traibertr/LTEWatch/1_Document/2_Report/9_annexes.tex

\documentclass[Report.tex]{subfiles}

\begin{document}

\chapter{Appendix}

%\includepdf[pages=-]{Include/Annexe/Technical data-T901A-T-2946a-26.10.2022.pdf}

\section{\textit{LTEWatch} Electrical Schematic}
\begin{landscape}
\includepdf[pages=-, angle=90]{Include/Annexe/LTEWatch.pdf}
\label{appendix:LTEWatch_elec_schem}
\end{landscape}

\section{Clock Single Hand Motor - T901}
\begin{landscape}
\includepdf[pages=-, angle=180]{Include/Annexe/Technical data-T901A-T-2946a-26.10.2022.pdf}
\label{appendix:motor_t901}
\end{landscape}

\section{Clock Double Hands Motor - T902}
\begin{landscape}
\includepdf[pages=-, angle=180]{Include/Annexe/Technical data-T902A-T-2947b-26.10.2022.pdf}
\label{appendix:motor_t902}
\end{landscape}

\section{\textsc{Ignion} - NN03-320 Chip GNSS Antenna Simulation} \label{appendix:LTEWatch_NNS1}
\includepdf[pages=-]{Include/Annexe/LTEWatch_NNS1.0.pdf}

\end{document}
