traibertr/LTEWatch/1_Document/2_Report/Abstract.tex

\documentclass[report.tex]{subfiles}

\begin{document}

\section{Project introduction}

\subsection{Context}

\subsection{Project goals}

\subsection{Current issues and problems to solve}

\end{document}
