traibertr/LTEWatch/2_Hardware/1_Altium/LTEWatch/LTEWatch.PcbDoc.htm

Reporting Options

# File in Previous Format

Date | : | 21.11.2022
Time | : | 10:33:42
Filename | : | I:\RaD\SI-ET\Projets\ECS\LTEWatch\Analog-LTE-M_NB-IoT-Watch\Hardware\Altium\LTEWatch\LTEWatch.PcbDoc

Version | Warning

This file was generated by an earlier version of the software
