traibertr/LTEWatch/1_Document/2_Report/Include/Figure/hardware/user_interface_blk.pdf

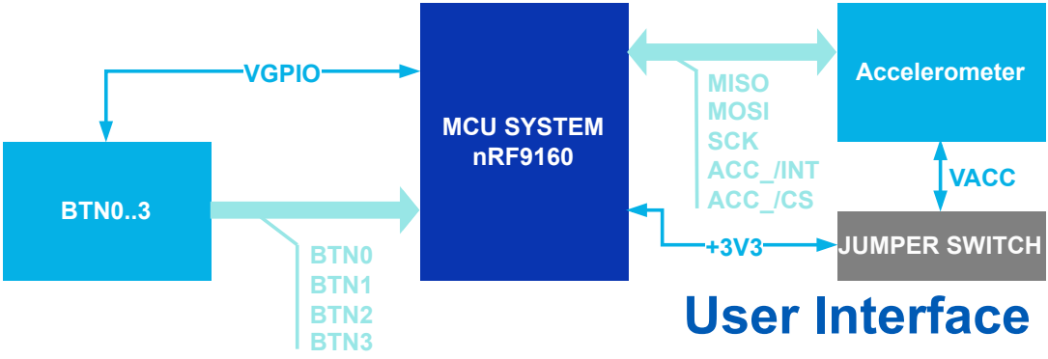
[picture p126: figure]
User Interface; VGPIO; BTN0..3; MCU SYSTEM nRF9160; BTN0 BTN1 BTN2 BTN3; Accelerometer MISO; MOSI SCK ACC_/INT ACC_/CS; VACC; JUMPER SWITCH
