traibertr/LTEWatch/1_Document/2_Report/Include/Figure/software/software_layers.pdf

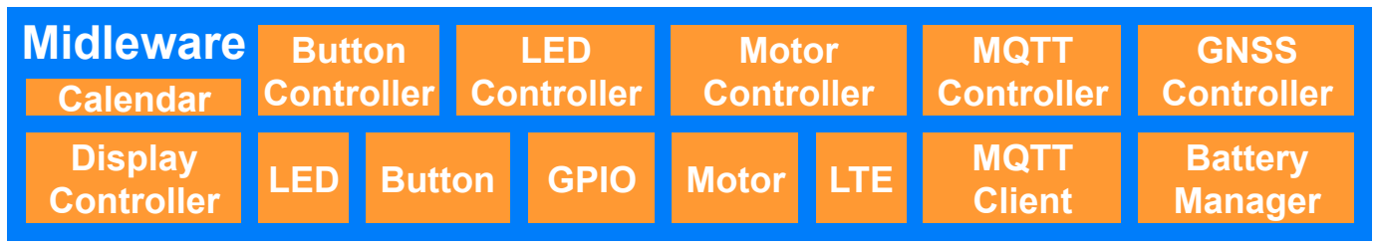
[picture p127: figure]
Midleware; Motor; Calendar; Controller; MQTT Client; Button Controller; Display Controller; GNSS Controller; LED Controller; MQTT Controller; LTE; Battery; Manager; LED; Button; GPIO
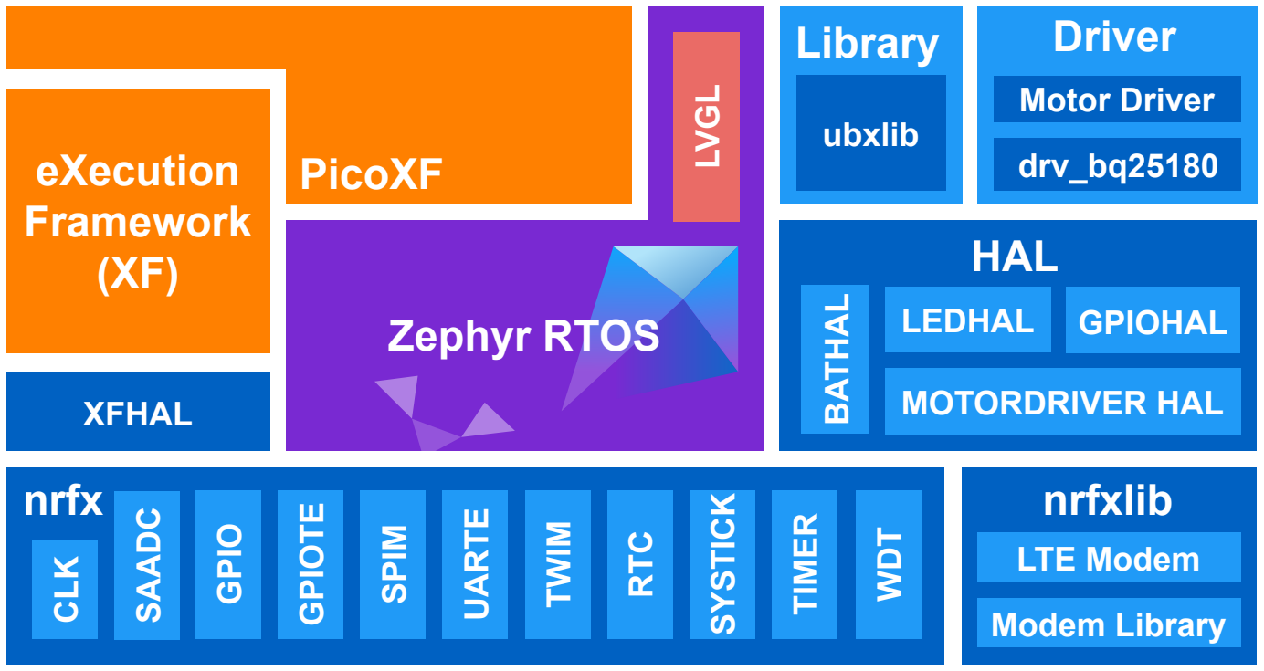
[picture p128: figure]
Zephyr RTOS; LVGL; nrfx; nrfxlib GPIO; GPIOTE; RTC; TIMER; WDT; SYSTICK; SPIM; UARTE; TWIM; Modem Library; LTE Modem; Library; Driver; drv_bq25180; ubxlib; HAL; BATHAL; LEDHAL; GPIOHAL; MOTORDRIVER HAL XFHAL; eXecution Framework (XF); Motor Driver; CLK; SAADC; PicoXF

## nRF9160

## Application

PicoWatch
Factrory

AppFactory
