traibertr/LTEWatch/1_Document/2_Report/Include/Figure/uml/caf_overview.pdf

Other NCS components

User modules and events

Events

CAF modules and events

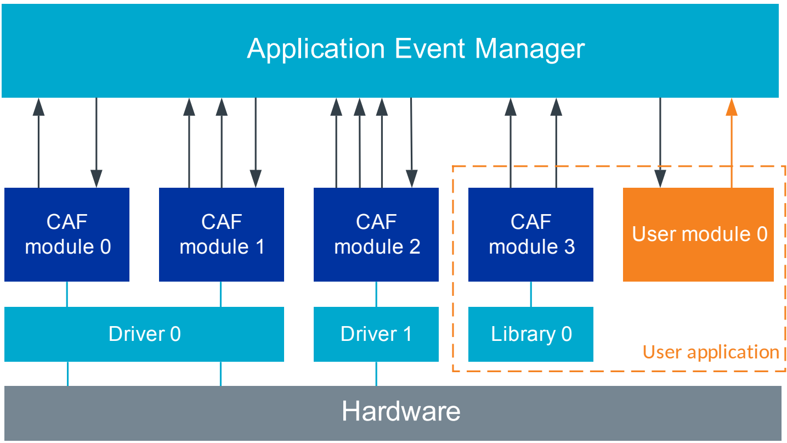
[picture p129: figure]
Application Event Manager; CAF module 0; CAF module 1; CAF; module 2; User module 0; Driver 0; Driver 1; Hardware; CAF module 3; User application Library 0
