traibertr/LTEWatch/1_Document/2_Report/Include/Figure/uml/class_Factory.pdf

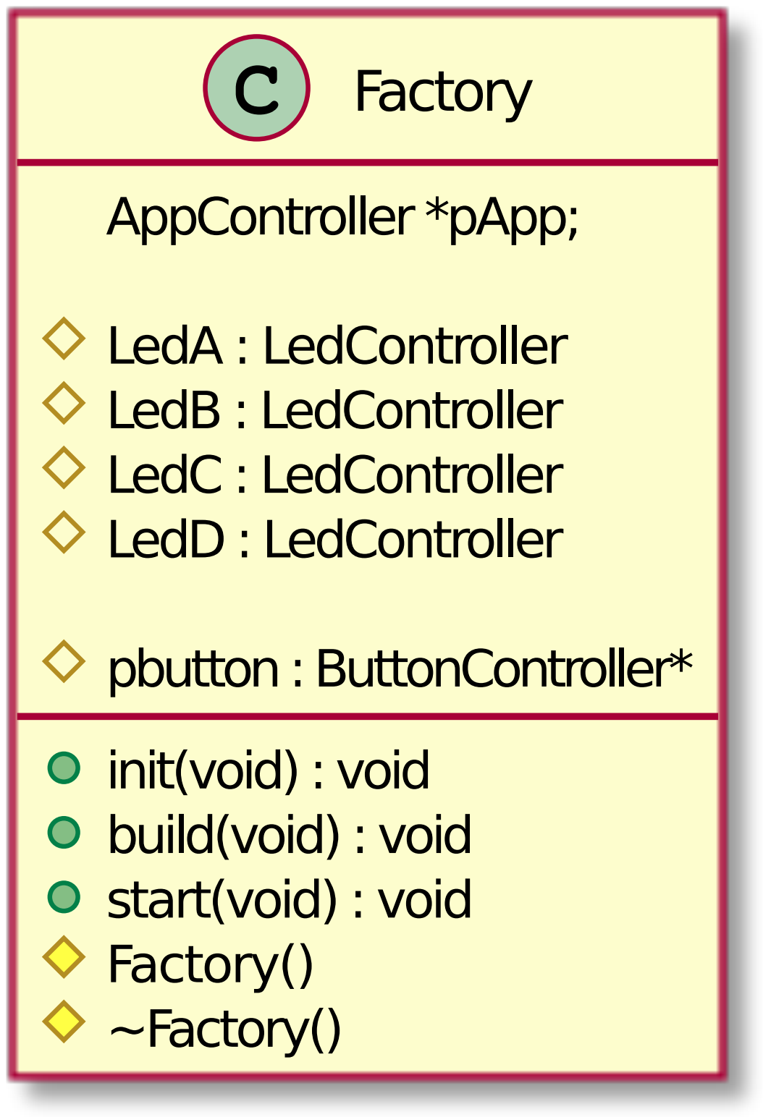
[picture p131: page 1]

Factory

AppController *pApp;

LedA : LedController
LedB : LedController
LedC : LedController
LedD : LedController

pbutton : ButtonController* init(void) : void
build(void) : void
start(void) : void
Factory()
~Factory()
