traibertr/LTEWatch/1_Document/2_Report/Include/Figure/uml/class_LedHal.pdf

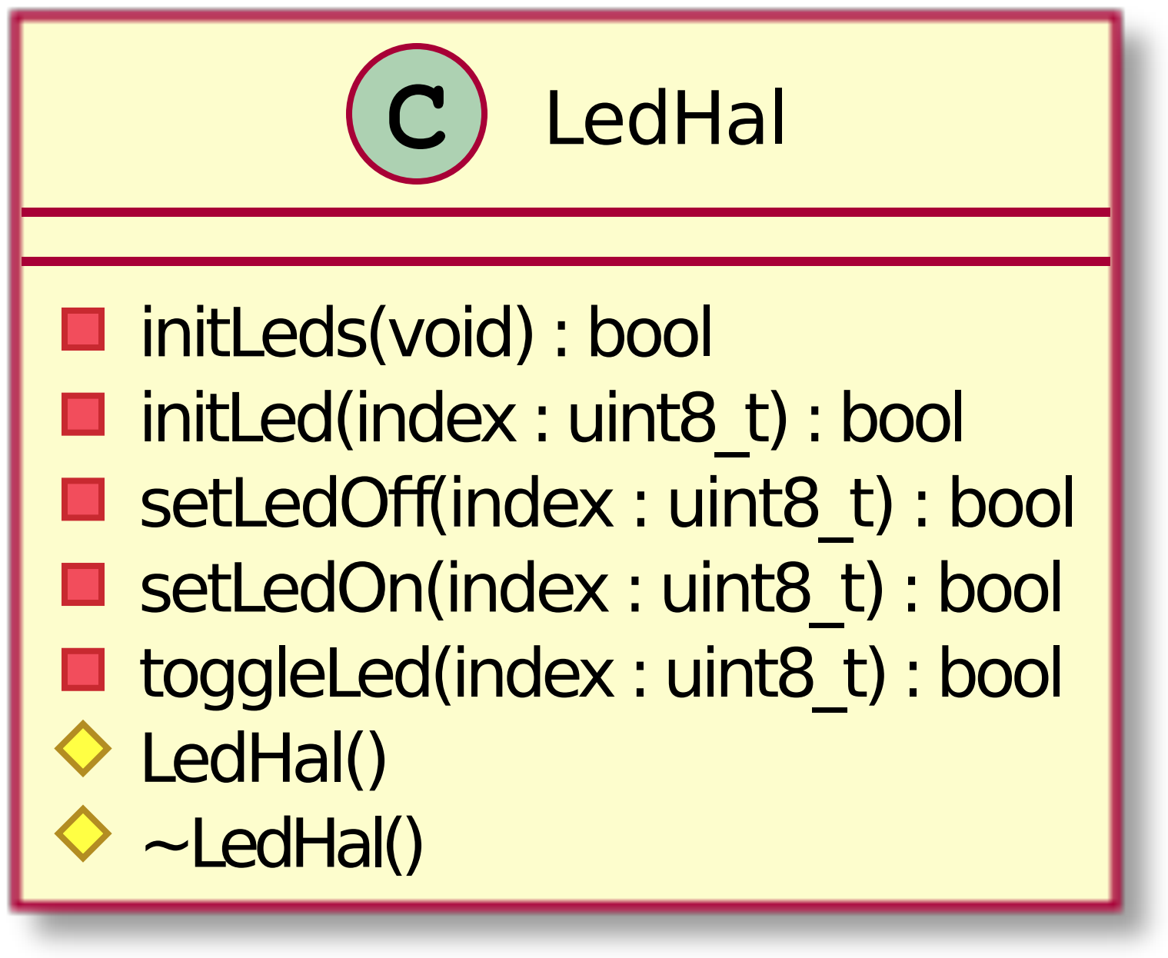
[picture p132: page 1]

LedHal

initLeds(void) : bool
initLed(index : uint8_t) : bool setLedOff(index : uint8_t) : bool setLedOn(index : uint8_t) : bool toggleLed(index : uint8_t) : bool LedHal()
~LedHal()
