traibertr/LTEWatch/1_Document/2_Report/Report.tex

%%%%%%%%%%%%%%%%%%%%%%%%%%%%%%%%%%%%%%%%%%%%%%%%%%%%%%%%%%
%% HEIG-VD
%%
%% Modèle Latex pour laboratoire
%% 
%% Fichiers à changer : 
%%            - constantes.tex
%%            - Tous les fichiers du corps du rapport 
%%
%% Auteur : TTR
%% Date   : 24.03.2020
%%%%%%%%%%%%%%%%%%%%%%%%%%%%%%%%%%%%%%%%%%%%%%%%%%%%%%%%%%

% Paramétrage du papier utilisé
\documentclass[a4paper,12pt,oneside]{report}

% Ne pas toucher, nécessaire à la mise en forme
\usepackage[utf8x]{inputenc} 
\usepackage[T1]{fontenc} 		% Nouvelle norme pour codage des caractères
\usepackage{titlesec, blindtext, color}
\newcommand{\hsp}{\hspace{20pt}}
\titleformat{\chapter}[hang]{\Huge\bfseries}{\thechapter \hsp}{0pt}{\Huge\bfseries}
\titlespacing*{\chapter}{0pt}{-10pt}{\baselineskip}% see titlesec manual
\usepackage{lmodern} 			% Nouvelle forme de la fonte ComputerModern
\usepackage[english,french]{babel} 		% Règles typographiques françaises, césures
\frenchbsetup{GlobalLayoutFrench=false}
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
	basicstyle=\footnotesize\ttfamily\color{black},
	commentstyle=\color{mygreen},
	keywordstyle=\color{blue},
    numberstyle=\tiny\color{gray},
    stringstyle=\color{purple},
    breakatwhitespace=false,         
    breaklines=true,                 
    captionpos=b,                    
    keepspaces=true,                 
    numbers=left,                    
    numbersep=5pt,                  
    showspaces=false,                
    showstringspaces=false,
    showtabs=false,                  
    tabsize=2,
    language=bash,
    xleftmargin=\parindent,
}
%\lstset{language=Bash,keywordstyle={\bfseries \color{black}}}
%\NewDocumentCommand{\codeword}{v}{\texttt{\colorbox{lightgray}{\textcolor{black}{#1}}}}

\NewDocumentCommand{\codeword}{v}{\textcolor{blue}{#1}}

%-------------------------------------------------------------------------------------

\newcommand{\codetxt}[1]{\textcolor{blue}{\texttt{\path{#1}}}}

%-------------------------------------------------------------------------------------

\newcommand{\eme}{\ieme{ }}
\newcommand{\er}{\ier{ }}
\newcommand{\ere}{\iere{ }}

\usepackage{float,graphicx}

\newcommand{\blue}[1]{\textcolor{blue}{#1}}

%Figure
\newcommand{\figc}[3]{%
  \begin{figure}[H]
    \centering
    
    \caption{#3}
    \label{fig:#2}
  \end{figure}}
  
  \newcommand{\figpdf}[3]{%
  \begin{figure}[H]
    \centering
    
    \caption{#3}
    \label{fig:#2}
  \end{figure}}

\newcommand{\figl}[4]{
\begin{table}[H]
\begin{tabularx}{\textwidth}{l X}
    \centered{} & \begin{tabular}{#3}#4\end{tabular}
\end{tabularx}
\end{table}}

\newcommand{\figr}[4]{
\begin{table}[H]
\begin{tabularx}{\textwidth}{X r}
	\begin{tabular}{#3} #4 \end{tabular} & \centered{}
\end{tabularx}
\end{table}}

\newcommand{\figcjpg}[3]{%
  \begin{figure}[H]
    \centering
    
    \caption{#3}
    \label{fig:#2}
  \end{figure}}
  
\newcommand{\figljpg}[4]{
\begin{table}[H]
\begin{tabularx}{\textwidth}{l X}
    \centered{} & \begin{tabular}{#3}#4\end{tabular}
\end{tabularx}
\end{table}}
  
\newcommand{\figrjpg}[4]{
\begin{table}[H]
\begin{tabularx}{\textwidth}{X r}
	\begin{tabular}{#3} #4 \end{tabular} & \centered{}
\end{tabularx}
\end{table}}

\newcommand{\centered}[1]{\begin{tabular}{l} #1 \end{tabular}}

\newcommand{\tbox}[1]{
\begin{tabular}{|c|}
\hline #1 \\[4pt]\hline
\end{tabular}}

\newcommand{\ii}[1]{%
\begin{itemize}[\;]%
\item #1%
\end{itemize}}

%TO DO
\newcommand{\todo}[1]{\begin{center}
\colorbox{orange!50}{\Large #1}
\end{center}}

\newcommand{\listequationsname}{\Large{Liste des équations}}
\newlistof{myequations}{equ}{\listequationsname}
\newcommand{\myequations}[1]{%
\addcontentsline{equ}{myequations}{\protect\numberline{\theequation}#1}\par}

\newcommand{\ddl}[1]{\underline{\underline{#1}}}

% fichier avec les constantes (à adapter pour les étudiants)
\input{0_constantes}

% Entête et pieds de page (A ADAPTER)
\pagestyle{empty}
\usepackage{fancyhdr}
\setlength{\headheight}{25pt}
\pagestyle{fancy}
\renewcommand{\chaptermark}[1]{\markboth{#1}{#1}}

% Entête :
\fancypagestyle{plain}{}
\renewcommand\headrulewidth{1pt}
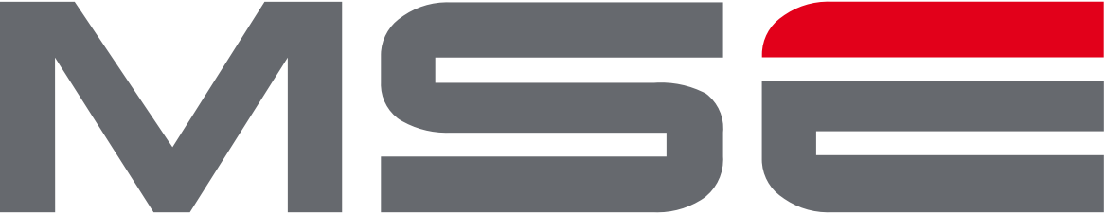
[picture p133: 1_Document/2_Report/Include/Figure/logo/mse-small-logo.png]
\fancyhead[L]{}
\fancyhead[R]{\textsc{\nomAuteur} \\ \begin{otherlanguage}{english} \today \end{otherlanguage}}
\fancyhead[C]{\nameLabo \\ \shortTitre}
% Pied de page
\fancyfoot{} % clear all footer fields
\renewcommand{\footrulewidth}{1pt}
\fancyfoot[R]{\thepage} 
\fancyfoot[L]{\textsc{\leftmark}}

\newcommand{\specialcell}[2][l]{%
  \begin{tabular}[#1]{@{}l@{}}#2\end{tabular}}

% Début du corps du rapport 
\begin{document}	

	\pagenumbering{Roman}
	
	% première page
	\input{1_premiere_page.tex}
	% enlève le numéro sur la première page
	\newpage
	
	\subfile{2_lexic.tex}

	\newpage

	\begin{otherlanguage}{english}
		\chapter*{Table of Contents}
		\addcontentsline{toc}{chapter}{Table of Contents}
		\renewcommand\contentsname{} % the empty name
		\begingroup
			\let\clearpage\relax
			\vspace{-3.5cm} % the removed space. Set as appropriate
			\tableofcontents
		\endgroup
	\end{otherlanguage}

	\newpage	

	\pagenumbering{arabic}
	\setcounter{page}{1}
	
	\subfile{3_introduction.tex}
		
	\newpage
	
	\subfile{4_research_part.tex}
	
	\newpage
	
	\subfile{4_b_solution_part.tex}
	
	\newpage	
	
	\subfile{4_1_hardware_part.tex}

	\newpage
	
	\subfile{4_2_antenna_part.tex}	
		
	\newpage
	
	\subfile{4_3_software_part.tex}	

	\newpage	
	
	\subfile{5_experimental_part.tex}
	
%	\newpage
	
%	\subfile{6_result.tex}
	
	\newpage
	
	\subfile{7_discussion.tex}
	
	\newpage
	
	\subfile{8_conclusion.tex}
	
	%\newpage 
	
	%\subfile{report_struct.tex}
	
	%Section pour la signature
	\section*{Signatures}
  	\;\\[-20pt]
    %\vspace{2cm}
    
    \tabto{8cm}Lausanne, \today\\
    \tabto{8cm}Tristan Traiber \\
    
    \begin{flushright}
    \begin{figure}[H]
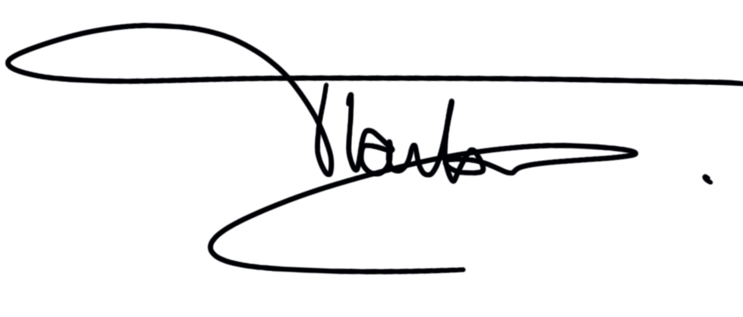
[picture p134: 1_Document/2_Report/Include/Figure/logo/SignatureTR.PNG]
       \tabto{8cm} 
    \end{figure}
    \end{flushright}

\begin{otherlanguage}{english}
	\bibliographystyle{unsrt}
	\bibliography{bibliographie.bib}
\end{otherlanguage}

\begin{otherlanguage}{english}
	\listoffigures
	\listoftables
\end{otherlanguage}    

	\newpage
	\subfile{9_annexes}
	
	\newpage
	%\input{__Exemple_include}
	
%Fin du document
\end{document}
