traibertr/LTEWatch/1_Document/2_Report/1_premiere_page.tex

%%%%%%%%%%%%%%%%%%%%%%%%%%%%%%%%%%%%%%%%%%%%%%%%%%%%%%%%
% Ce document ne doit pas être modifié
% Il faut modifier les informations depuis le fichier
% constantes.tex
%%%%%%%%%%%%%%%%%%%%%%%%%%%%%%%%%%%%%%%%%%%%%%%%%%%%%%%%

\begin{center}

\hfill

\end{center}

\vfill

\begin{flushleft}
	\small \addr
\end{flushleft}

\vfill

\begin{center}
	\huge \bigTitre \\
	\Large \subBigTitre \\
\end{center}

\vfill

\begin{center}
	\Large \nameLabo:\\
	\huge \titre \\
\end{center}

\vfill

\vfill

\begin{flushright}
	\Large Made by\\
	\huge \nomAuteur\\
	
	\vfill
	
	\Large Under the direction of \\
	\normalsize Prof. \professeur\\
	HES-SO Valais/Wallis \\
	Rue de l'Industrie 23 \\
	1950 Sion \\
\end{flushright}
\vfill

\begin{flushright}
	%External expert -\\
\end{flushright}

\vfill

\begin{otherlanguage}{english}
\begin{flushright}
	Lausanne, HES-SO, Master MSE, \today
\end{flushright}
\end{otherlanguage}

	\thispagestyle{empty}

%%%%%%%%%%%%%%%%%%%%%%%%%%%%%%%%%%%%%%%%%%%%%%%%%%%%%%%%%%%%%%%%%%%%%%%%%%%%%%%

	\afterpage{\null\newpage}

%%%%%%%%%%%%%%%%%%%%%%%%%%%%%%%%%%%%%%%%%%%%%%%%%%%%%%%%%%%%%%%%%%%%%%%%%%%%%%%

\newpage

\begin{flushleft}
	Accepted by the HES SO Master MSE (Suisse, Lausanne) on the proposal of \\[12pt]
	Prof. \professeur, TM Project Advisor\\
	Ing. \assistant, Senior academic associate\\[48pt]
\end{flushleft}

\begin{otherlanguage}{english}
\begin{flushleft}
	Lausanne, \today \\[48pt]
\end{flushleft}
\end{otherlanguage}

\begin{flushleft}
	Prof. \professeur \hfill Prof. Philippe Barrade \\
	Project Adviser  \hfill Filliar manager \\
\end{flushleft}

%%%%%%%%%%%%%%%%%%%%%%%%%%%%%%%%%%%%%%%%%%%%%%%%%%%%%%%%%%%%%%%%%%%%%%%%%%%%%%%
