traibertr/LTEWatch/1_Document/2_Report/Include/Figure/software/state/picoWatchInternal.pdf

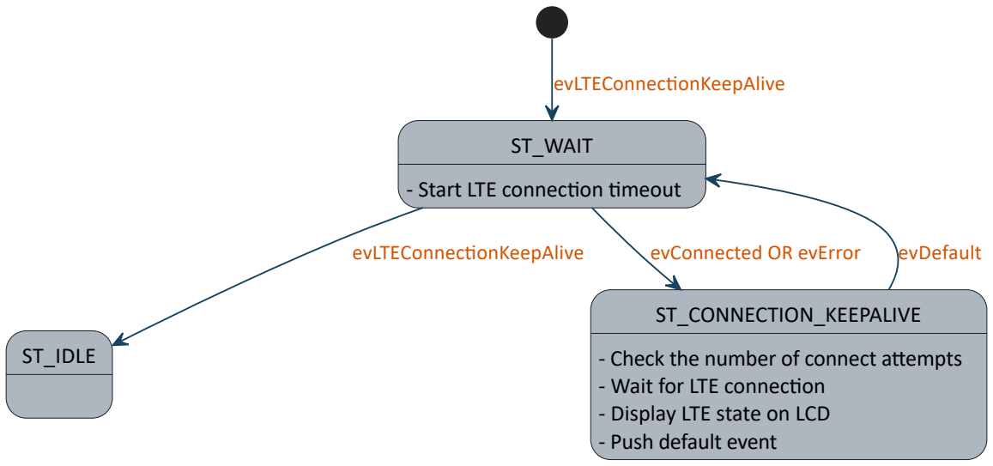
[picture p135: figure]
ST_IDLE; ST_WAIT; - Start LTE connecon meout; ST_CONNECTION_KEEPALIVE; - Check the number of connect aempts - Wait for LTE connecon - Display LTE state on LCD - Push default event; evLTEConneconKeepAlive; evConnected OR evError; evDefault
