traibertr/LTEWatch/1_Document/2_Report/Include/Figure/comp/bq25180_absolute_max_rating.png

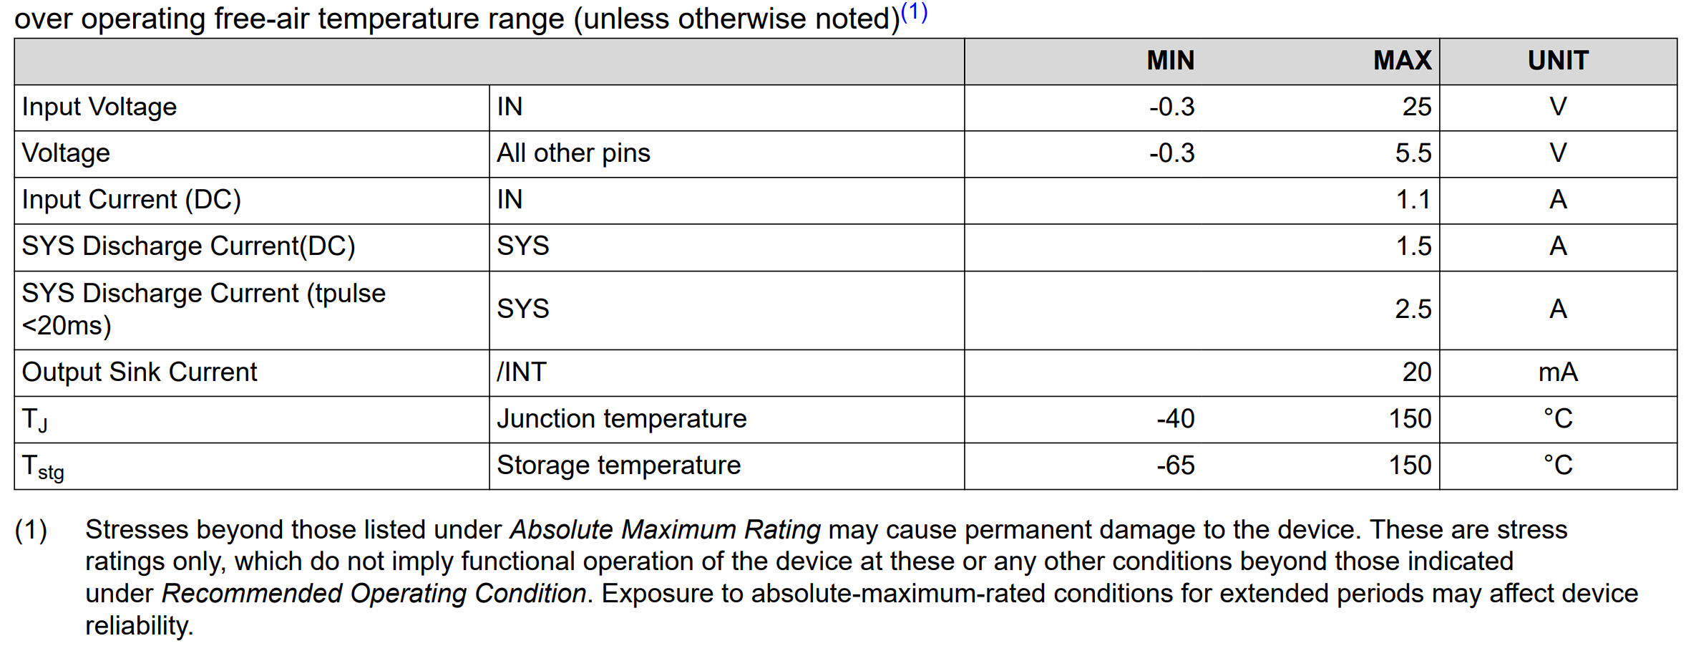
1_Document/2_Report/Include/Figure/comp/bq25180_absolute_max_rating.png
