traibertr/LTEWatch/1_Document/2_Report/Include/Figure/comp/bq25180_recom_oper_cond_1.png

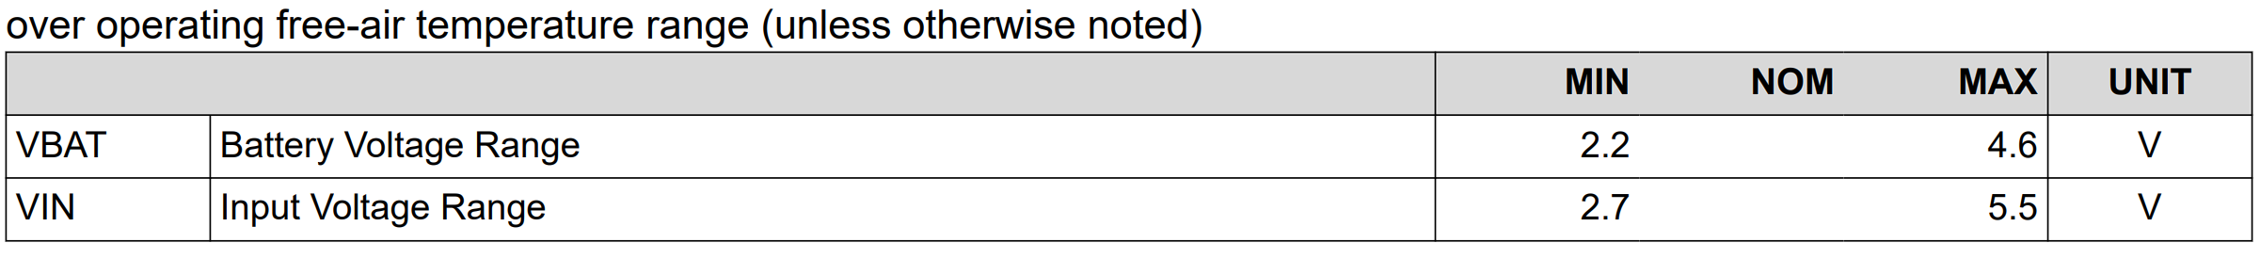
1_Document/2_Report/Include/Figure/comp/bq25180_recom_oper_cond_1.png
