traibertr/LTEWatch/1_Document/2_Report/Include/Figure/comp/LS011B7DH03_mech_schem.png

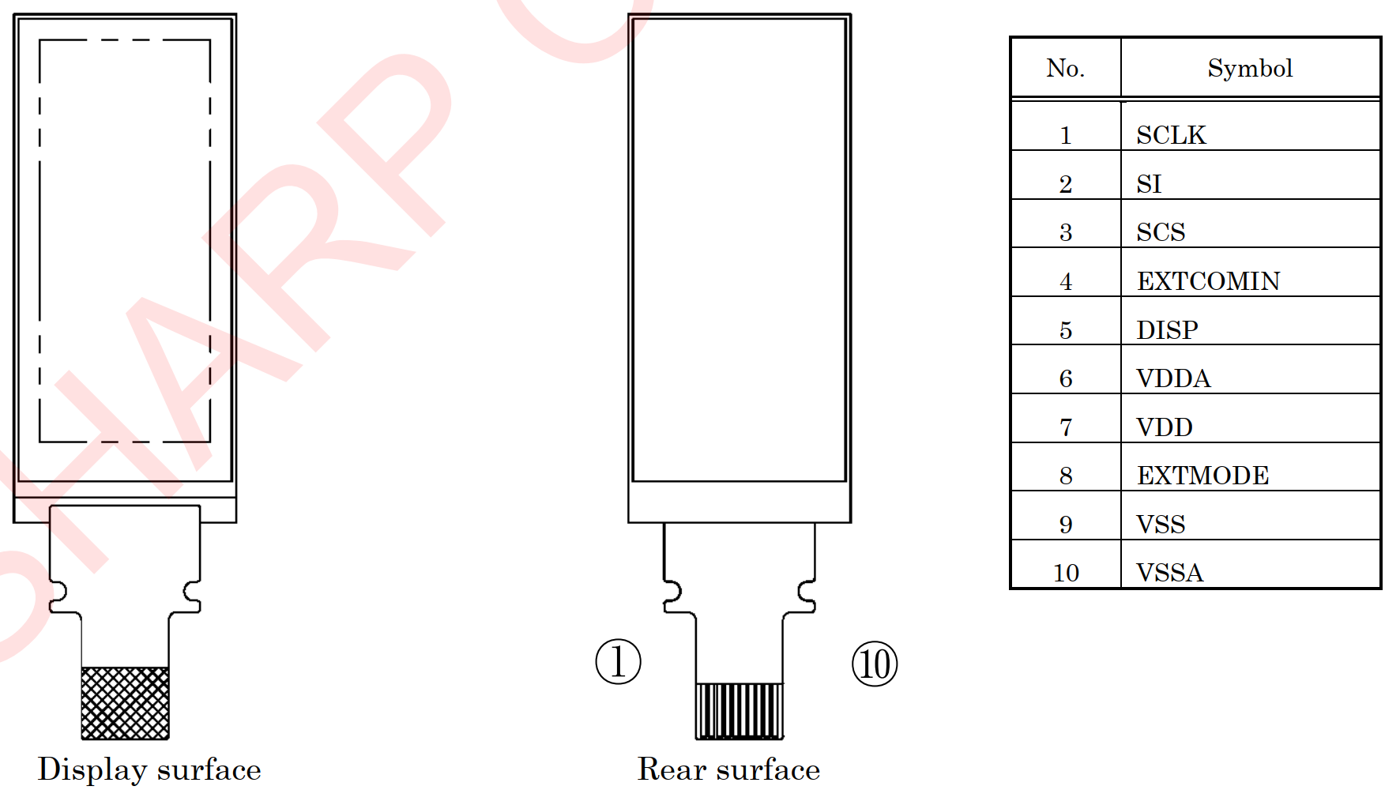
1_Document/2_Report/Include/Figure/comp/LS011B7DH03_mech_schem.png
