traibertr/LTEWatch/1_Document/2_Report/Include/Figure/comp/LS011B7DH03_mode_circ.png

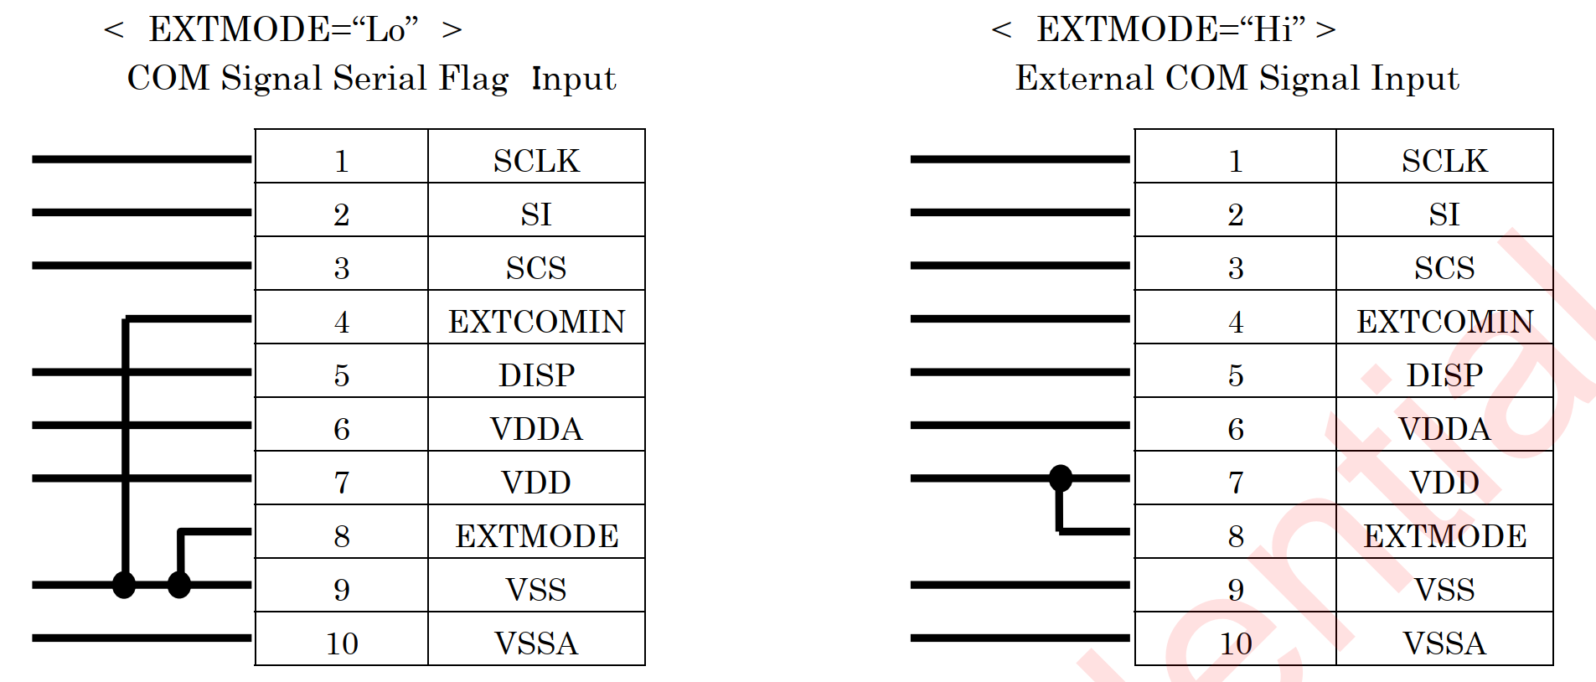
1_Document/2_Report/Include/Figure/comp/LS011B7DH03_mode_circ.png
