traibertr/LTEWatch/1_Document/2_Report/Include/Figure/comp/maxm10s_back_curr_uart_spec.png

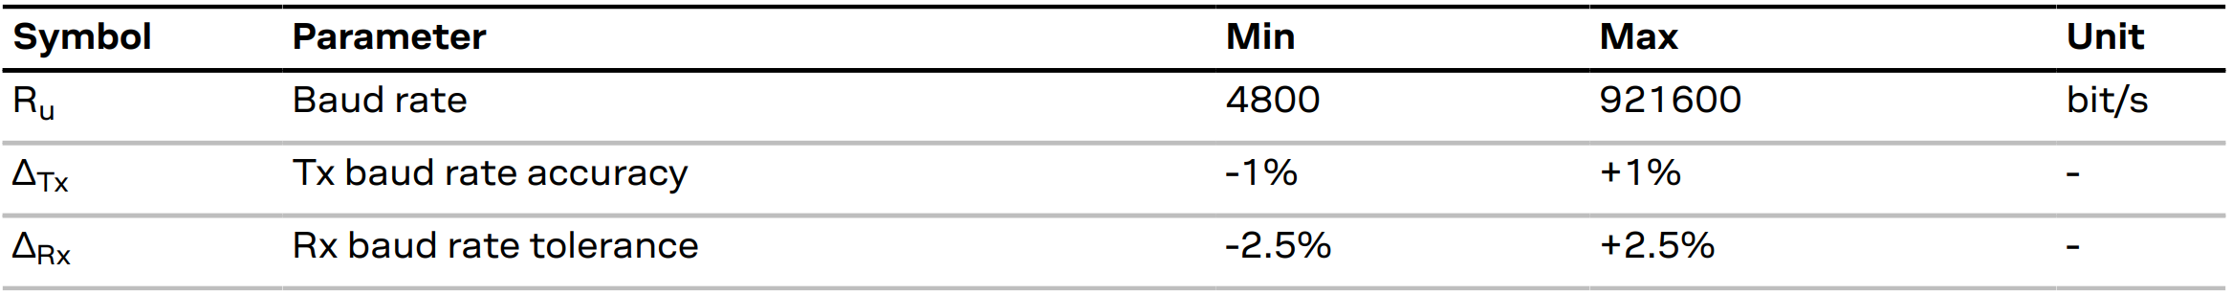
1_Document/2_Report/Include/Figure/comp/maxm10s_back_curr_uart_spec.png
