traibertr/LTEWatch/1_Document/2_Report/Include/Figure/comp/maxm10s_typ_perf_mulit_const.png

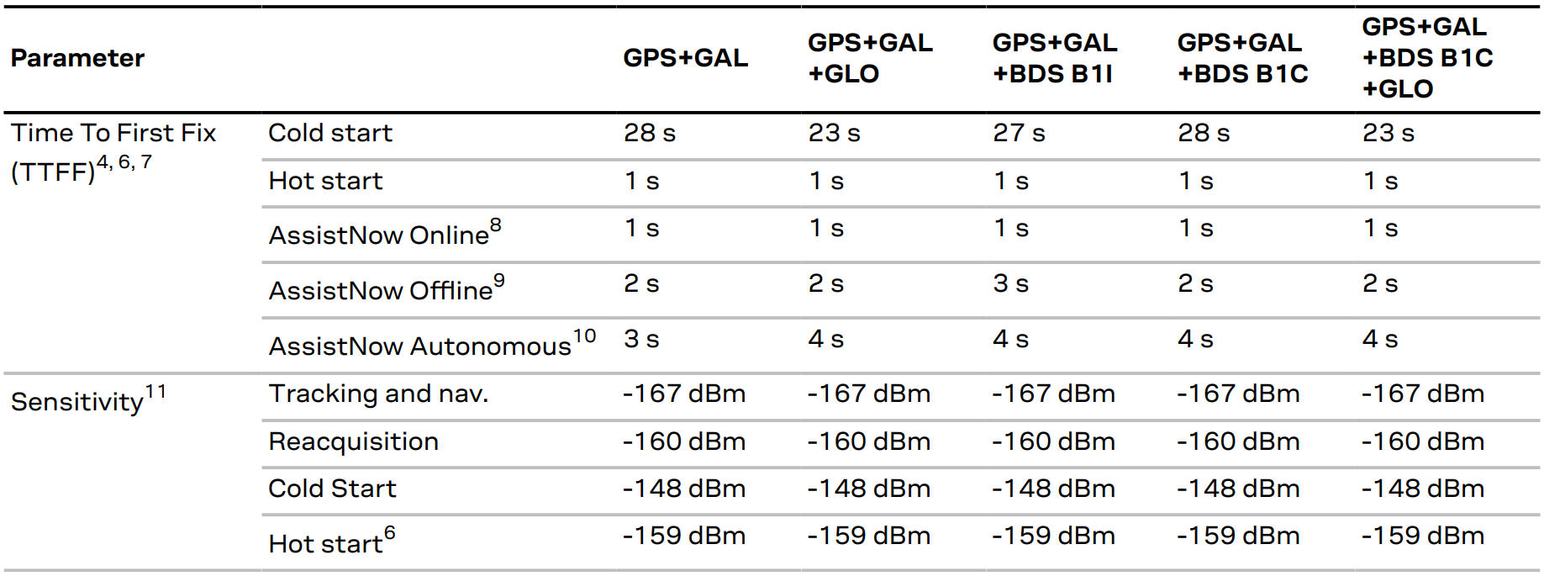
1_Document/2_Report/Include/Figure/comp/maxm10s_typ_perf_mulit_const.png
