traibertr/LTEWatch/1_Document/2_Report/Include/Figure/comp/motor_T901A_mech.png

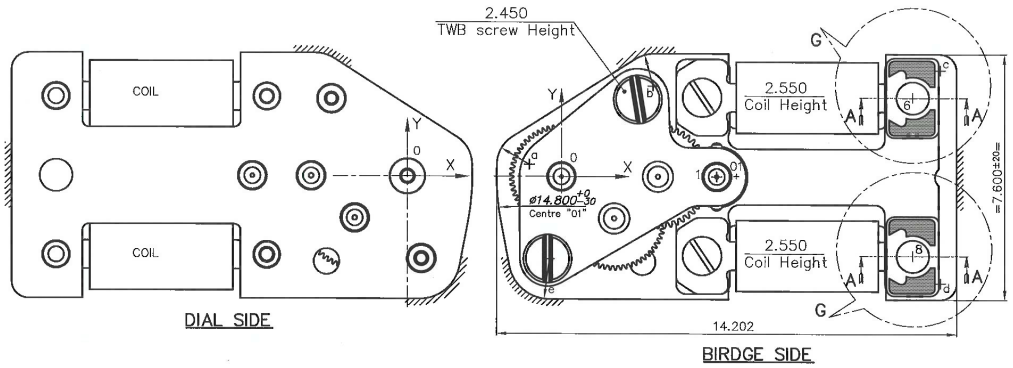
1_Document/2_Report/Include/Figure/comp/motor_T901A_mech.png
