traibertr/LTEWatch/1_Document/2_Report/Include/Figure/comp/niceview.jpg

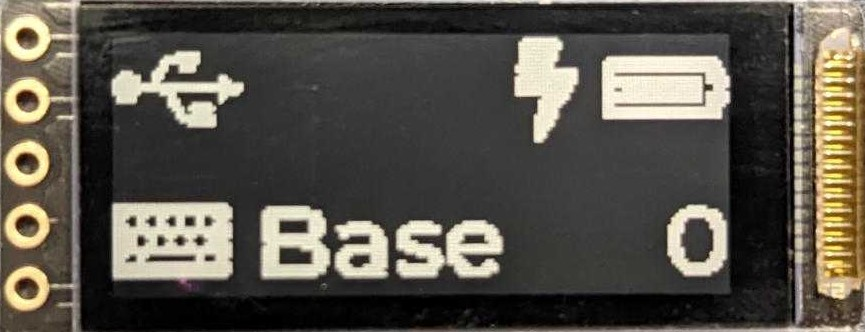
1_Document/2_Report/Include/Figure/comp/niceview.jpg
