traibertr/LTEWatch/1_Document/2_Report/Include/Figure/comp/niceview_schematic.png

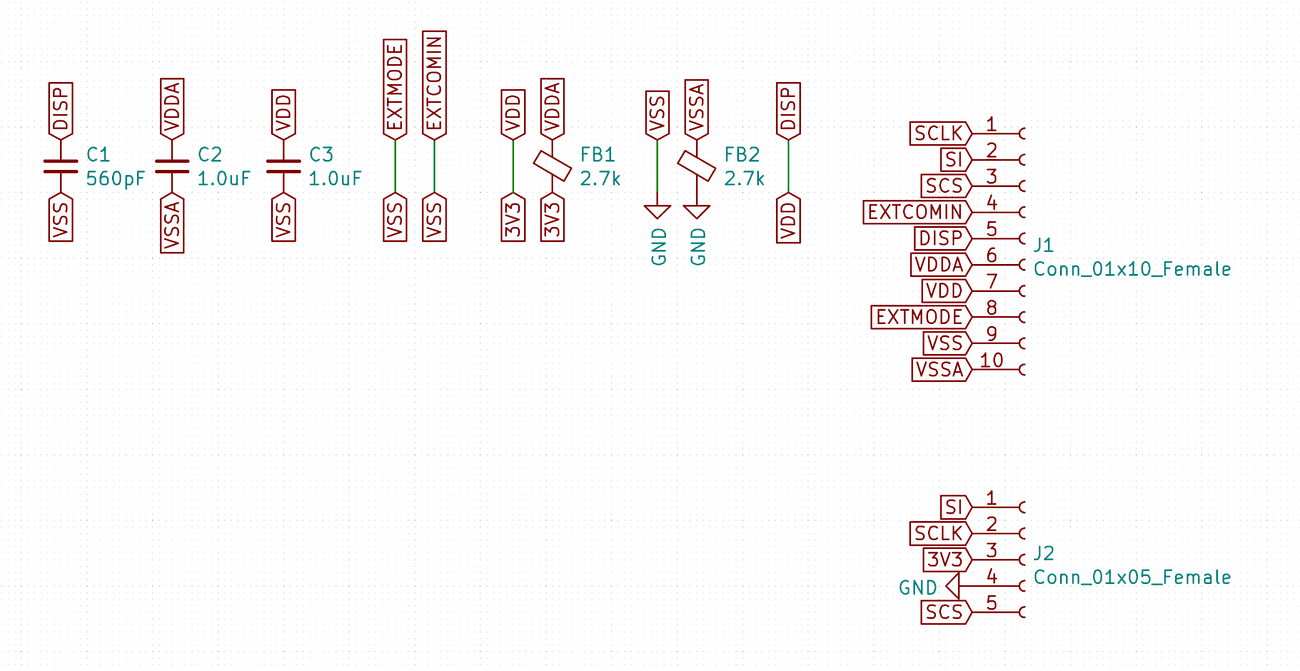
1_Document/2_Report/Include/Figure/comp/niceview_schematic.png
