traibertr/LTEWatch/1_Document/2_Report/Include/Figure/gnss/2023-02-07 19_53_50-ThingsBoard _ Dashboard.png

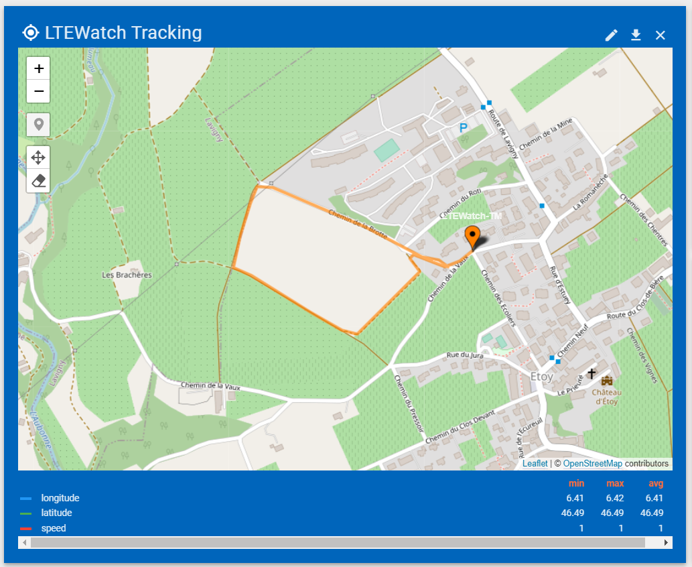
1_Document/2_Report/Include/Figure/gnss/2023-02-07 19_53_50-ThingsBoard _ Dashboard.png
