traibertr/LTEWatch/1_Document/2_Report/Include/Figure/gnss/2023-02-07 19_57_42-Document _ C__Users_Tristan_Traiber_Documents_GitHub_TM_1_Document_Report_9_anne.png

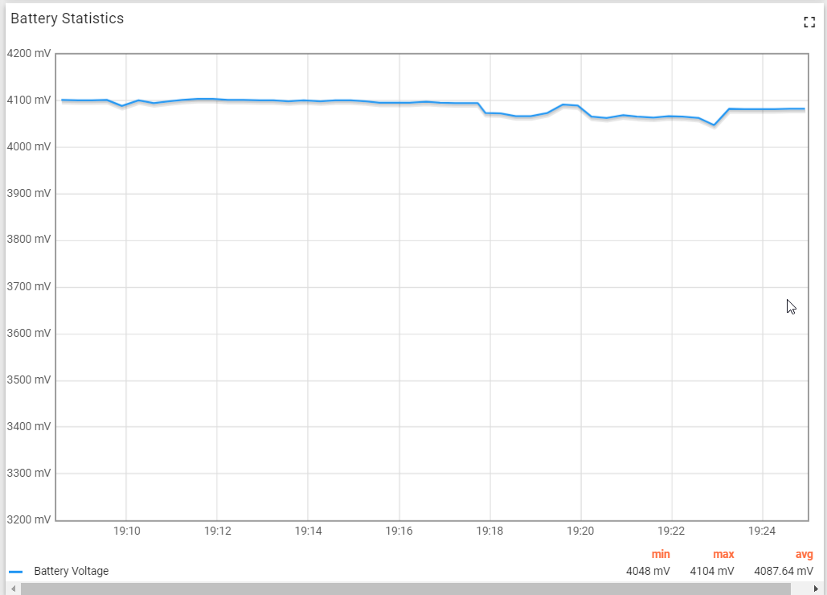
1_Document/2_Report/Include/Figure/gnss/2023-02-07 19_57_42-Document _ C__Users_Tristan_Traiber_Documents_GitHub_TM_1_Document_Report_9_anne.png
