traibertr/LTEWatch/1_Document/2_Report/Include/Figure/gnss/2023-02-07 19_58_43-ThingsBoard _ Dashboard.png

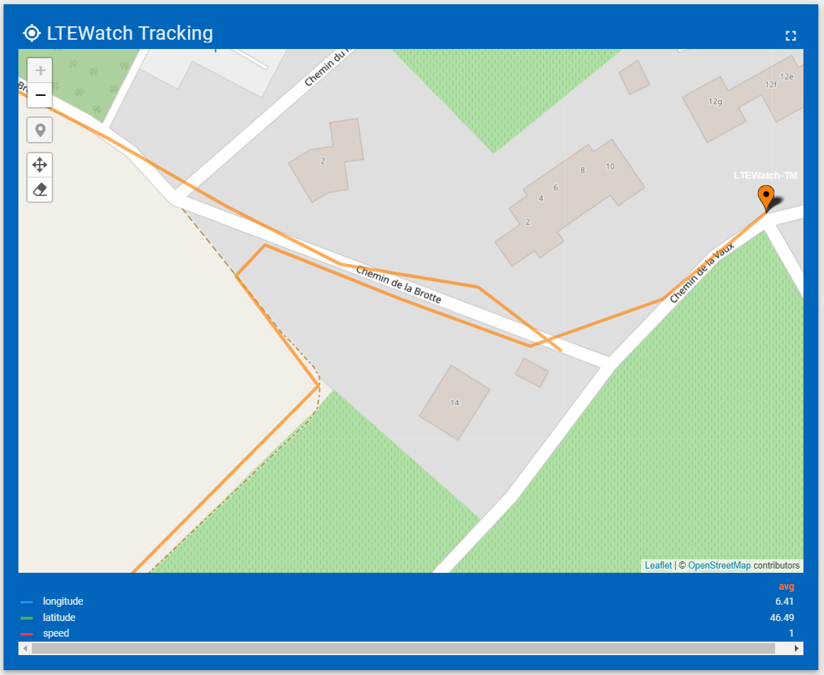
1_Document/2_Report/Include/Figure/gnss/2023-02-07 19_58_43-ThingsBoard _ Dashboard.png
