traibertr/LTEWatch/1_Document/2_Report/Include/Figure/gnss/tracking_exemple_2.png

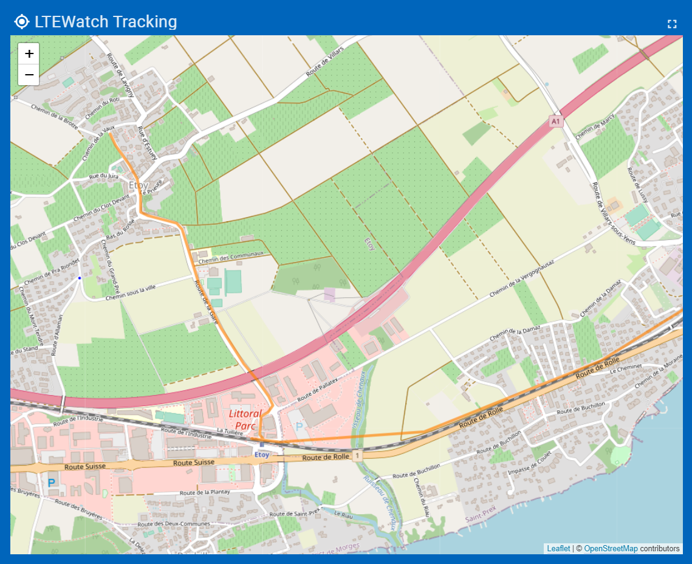
1_Document/2_Report/Include/Figure/gnss/tracking_exemple_2.png
