traibertr/LTEWatch/1_Document/2_Report/Include/Figure/gnss/tracking_exemple_3.png

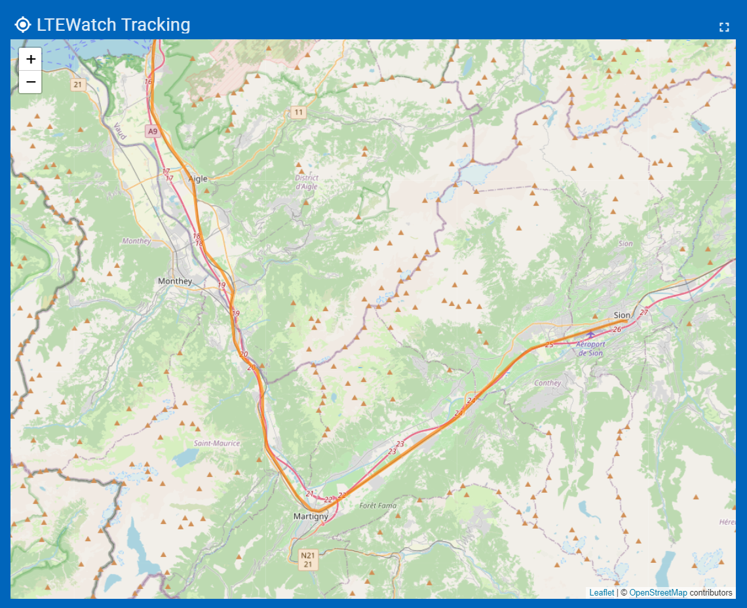
1_Document/2_Report/Include/Figure/gnss/tracking_exemple_3.png
