traibertr/LTEWatch/1_Document/2_Report/Include/Figure/gnss/tracking_exemple_4_panel.png

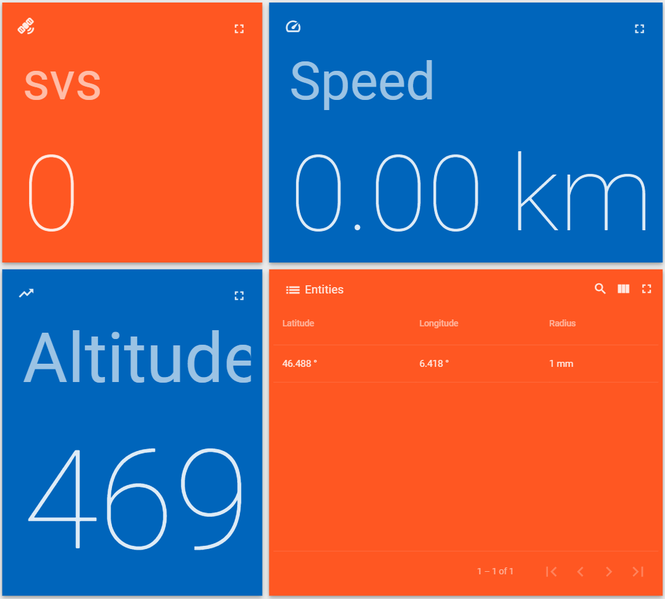
1_Document/2_Report/Include/Figure/gnss/tracking_exemple_4_panel.png
