traibertr/LTEWatch/1_Document/2_Report/Include/Figure/hardware/2023-02-09 02_05_41-LTEWatch.pdf - Foxit PDF Reader.png

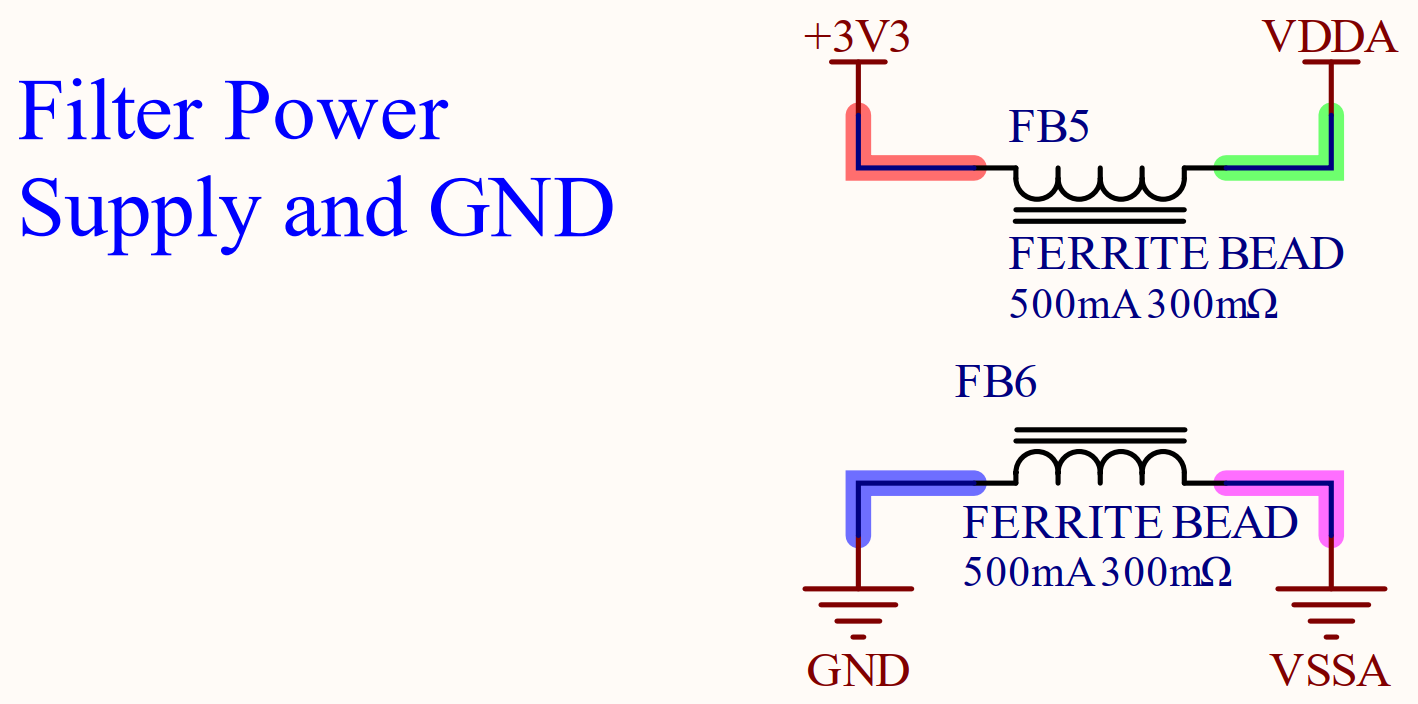
1_Document/2_Report/Include/Figure/hardware/2023-02-09 02_05_41-LTEWatch.pdf - Foxit PDF Reader.png
