traibertr/LTEWatch/1_Document/2_Report/Include/Figure/hardware/LTEWatch.png

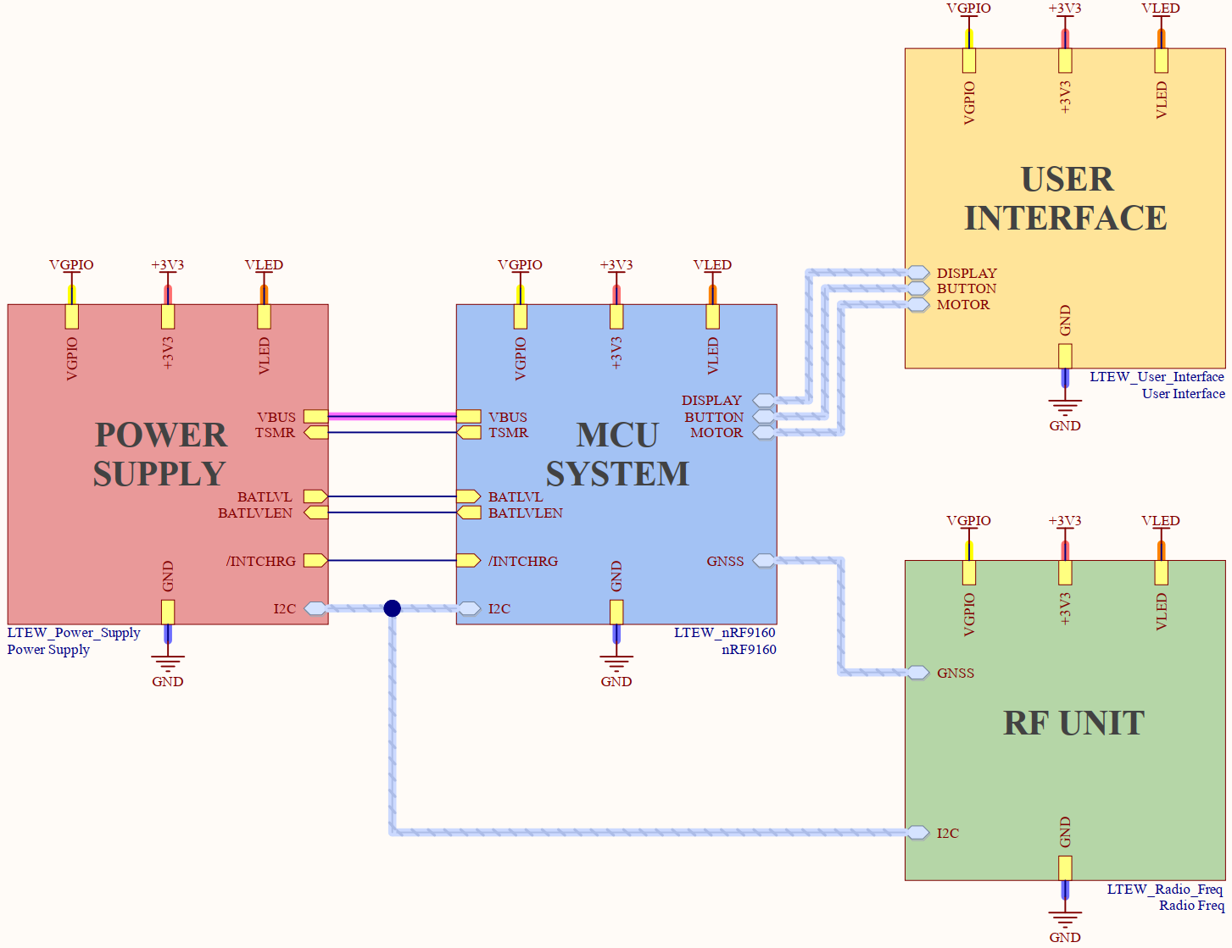
1_Document/2_Report/Include/Figure/hardware/LTEWatch.png
