traibertr/LTEWatch/1_Document/2_Report/Include/Figure/hardware/LTEWatch_LTEW_RF_Unit_ExtAntenna_LED.png

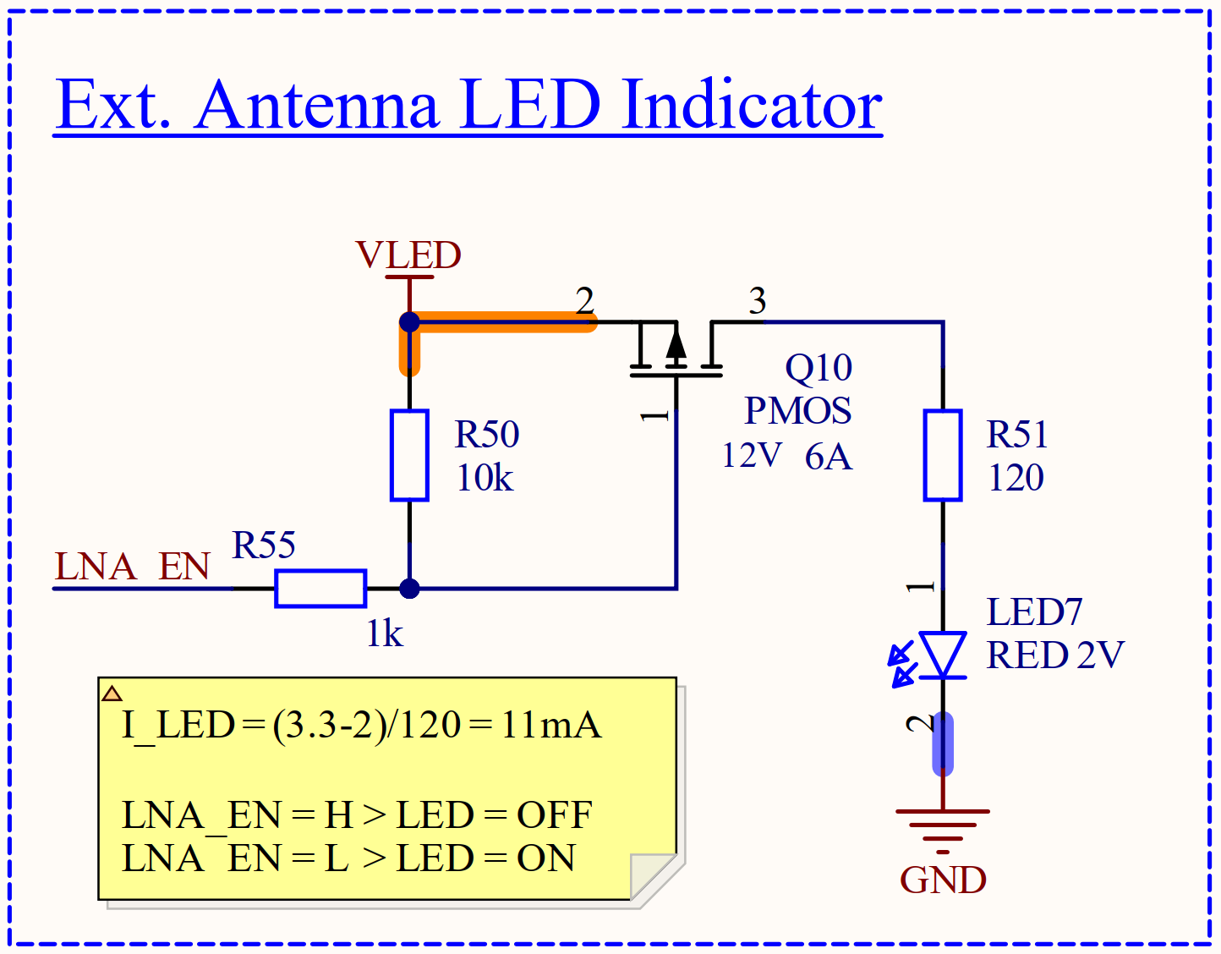
1_Document/2_Report/Include/Figure/hardware/LTEWatch_LTEW_RF_Unit_ExtAntenna_LED.png
