traibertr/LTEWatch/1_Document/2_Report/Include/Figure/hardware/LTEWatch_LTEW_RF_Unit_SAW_Filter.png

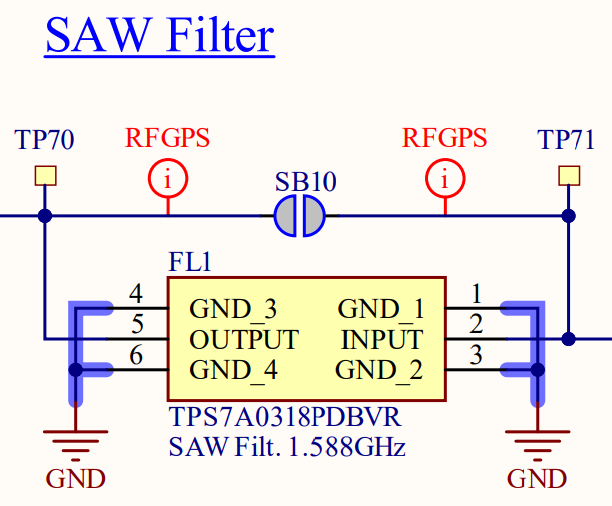
1_Document/2_Report/Include/Figure/hardware/LTEWatch_LTEW_RF_Unit_SAW_Filter.png
