traibertr/LTEWatch/1_Document/2_Report/Include/Figure/hardware/LTEWatch_LTEW_User_Interface_GPS_Enable.png

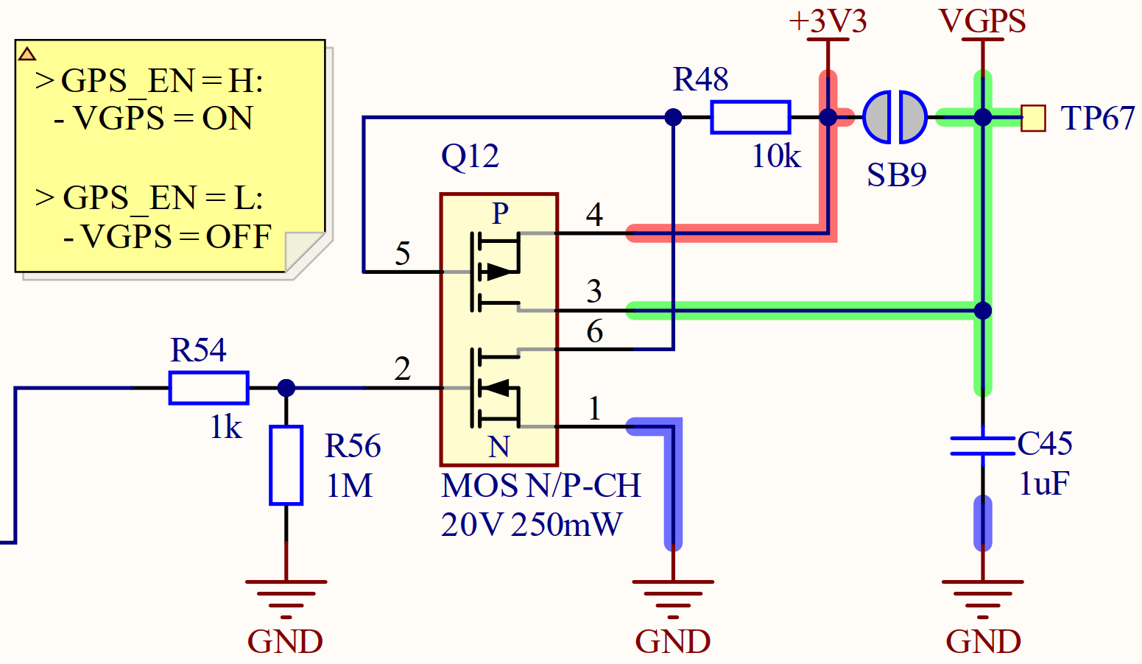
1_Document/2_Report/Include/Figure/hardware/LTEWatch_LTEW_User_Interface_GPS_Enable.png
