traibertr/LTEWatch/1_Document/2_Report/Include/Figure/hardware/power_management_block.png

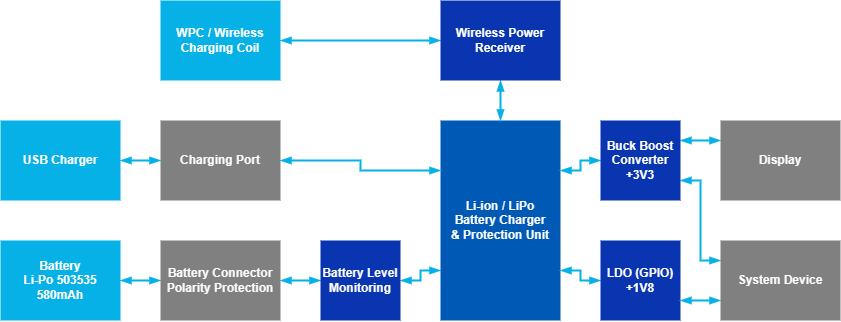
1_Document/2_Report/Include/Figure/hardware/power_management_block.png
