traibertr/LTEWatch/1_Document/2_Report/Include/Figure/modification/board_1.jpg

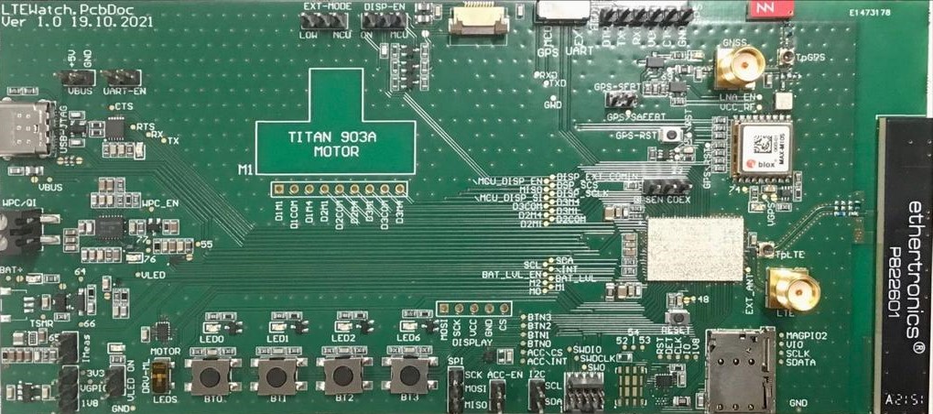
1_Document/2_Report/Include/Figure/modification/board_1.jpg
