traibertr/LTEWatch/1_Document/2_Report/Include/Figure/modification/board_mod_2.jpg

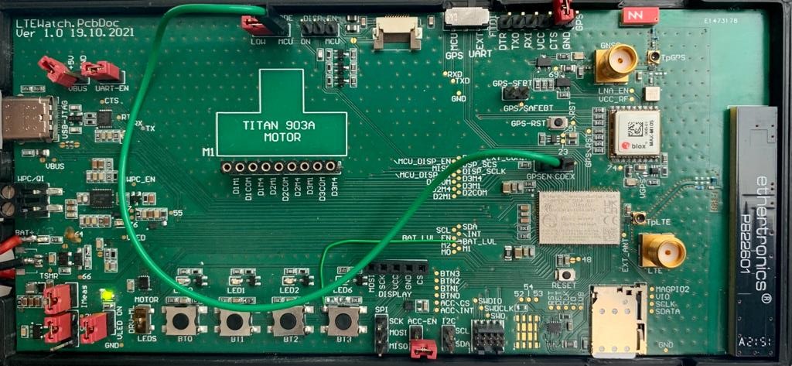
1_Document/2_Report/Include/Figure/modification/board_mod_2.jpg
