traibertr/LTEWatch/1_Document/2_Report/Include/Figure/modification/display_3.jpg

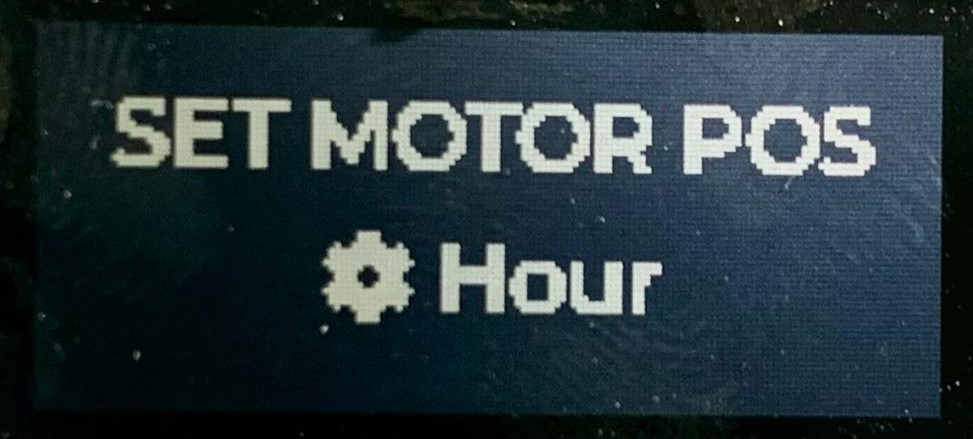
1_Document/2_Report/Include/Figure/modification/display_3.jpg
