traibertr/LTEWatch/1_Document/2_Report/Include/Figure/modification/mod_sim.jpg

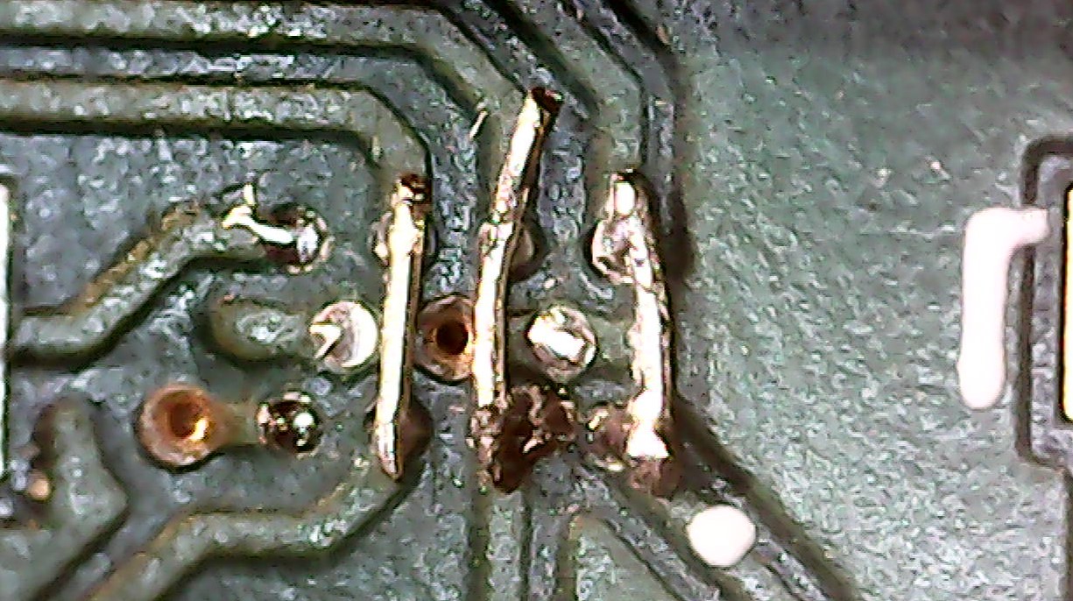
1_Document/2_Report/Include/Figure/modification/mod_sim.jpg
