traibertr/LTEWatch/1_Document/2_Report/Include/Figure/software/software_diag.png

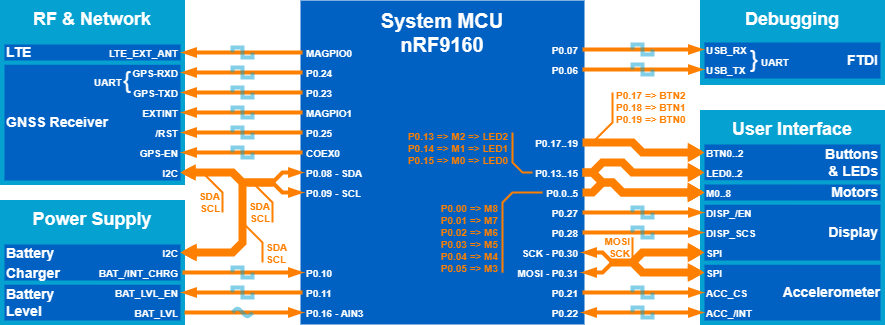
1_Document/2_Report/Include/Figure/software/software_diag.png
