traibertr/LTEWatch/1_Document/2_Report/Include/Figure/software/software_layers.png

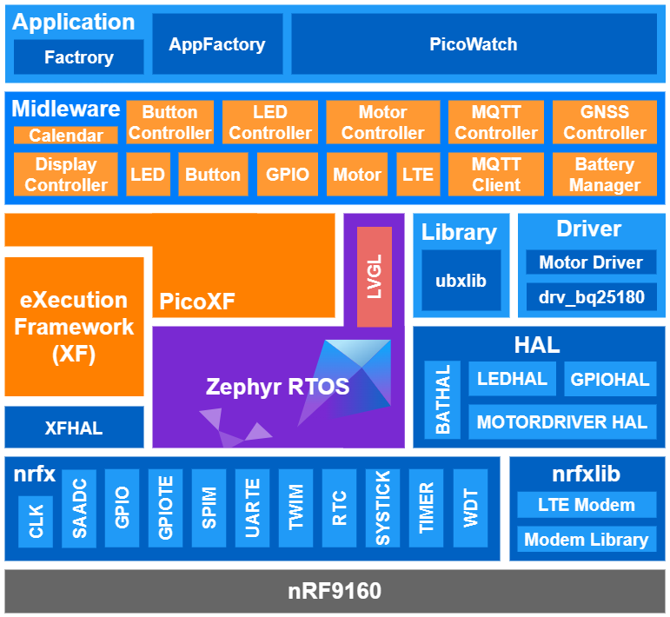
1_Document/2_Report/Include/Figure/software/software_layers.png
