traibertr/LTEWatch/1_Document/2_Report/Include/Figure/uml/0160.nRF5 SDK to nRF Connect SDK.jpg-800x400x2.jpg

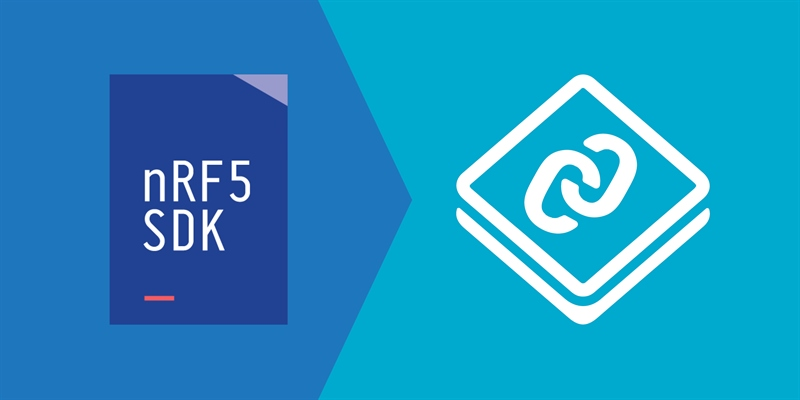
1_Document/2_Report/Include/Figure/uml/0160.nRF5 SDK to nRF Connect SDK.jpg-800x400x2.jpg
