traibertr/LTEWatch/1_Document/2_Report/Include/Figure/uml/class_new_xf_adapter.png

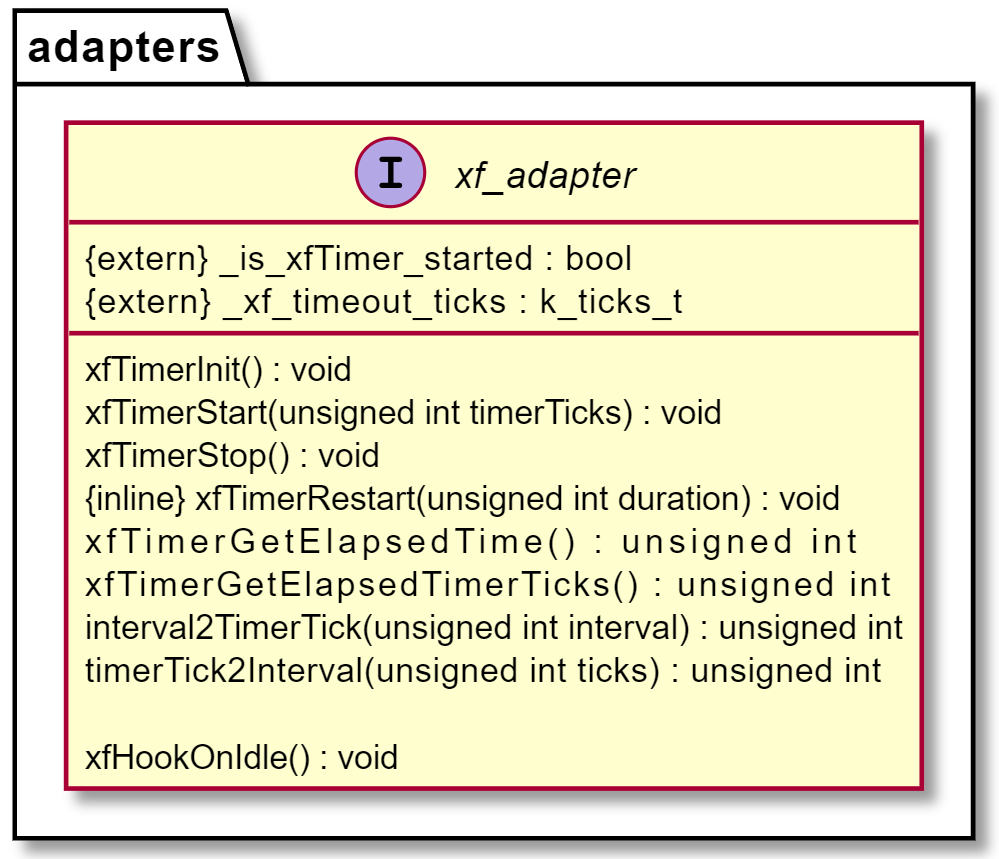
1_Document/2_Report/Include/Figure/uml/class_new_xf_adapter.png
