traibertr/LTEWatch/1_Document/2_Report/Include/Figure/uml/class_xf_adapter.png

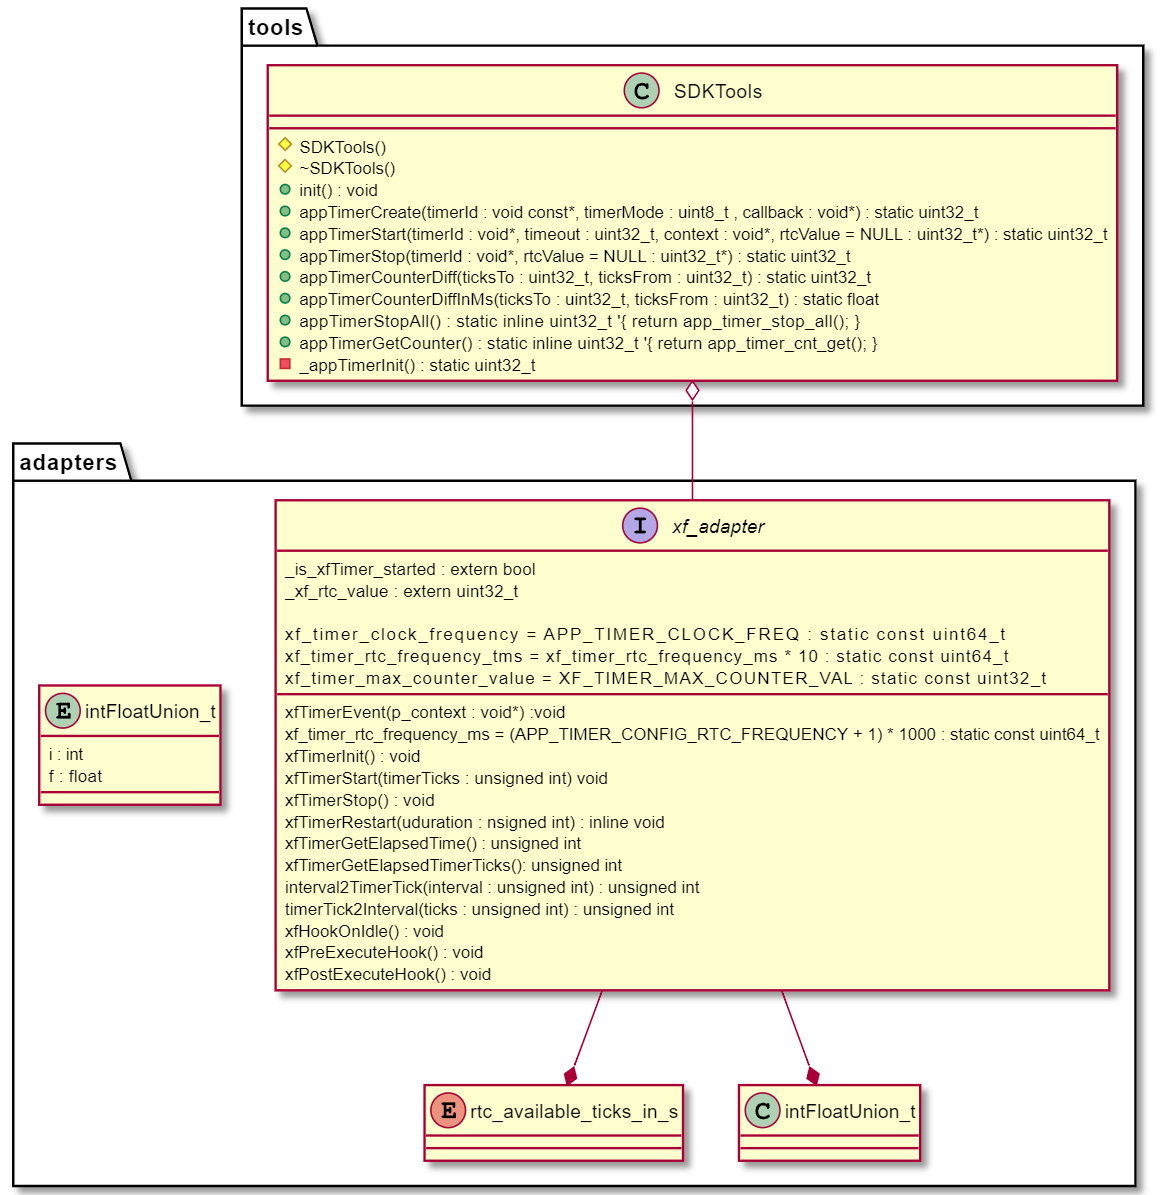
1_Document/2_Report/Include/Figure/uml/class_xf_adapter.png
