traibertr/LTEWatch/1_Document/2_Report/Include/Figure/uml/class_xf_timeout_manager.png

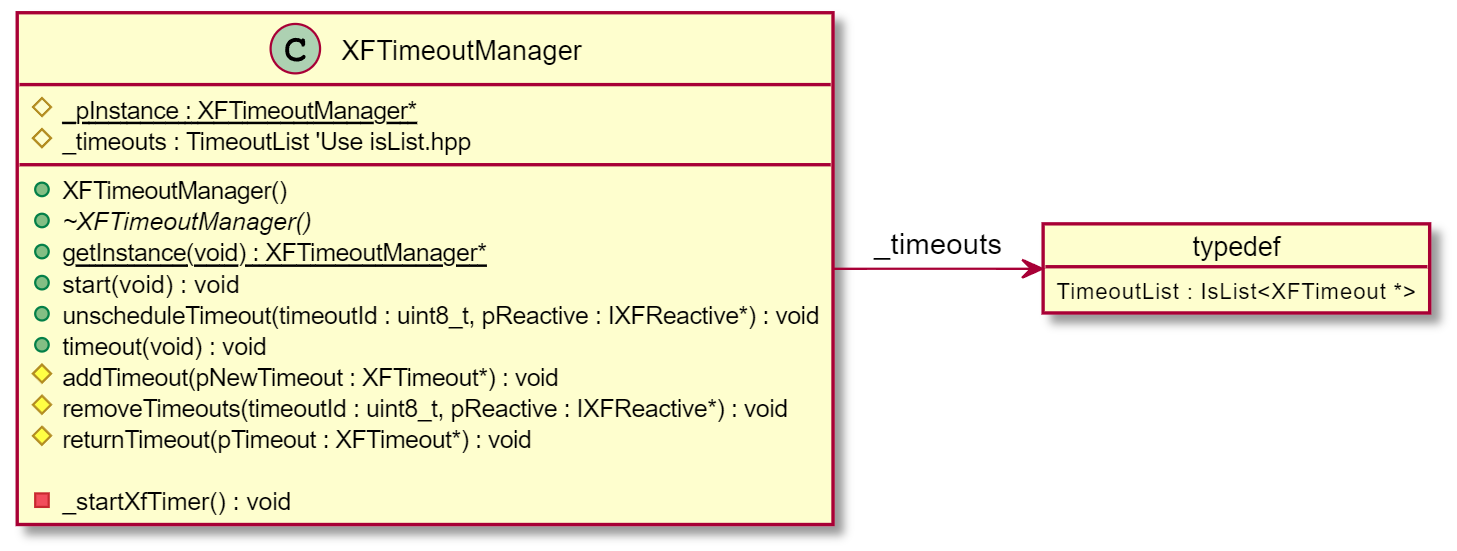
1_Document/2_Report/Include/Figure/uml/class_xf_timeout_manager.png
