traibertr/LTEWatch/1_Document/2_Report/Include/Figure/uml/xf_timeout_manager_seq.png

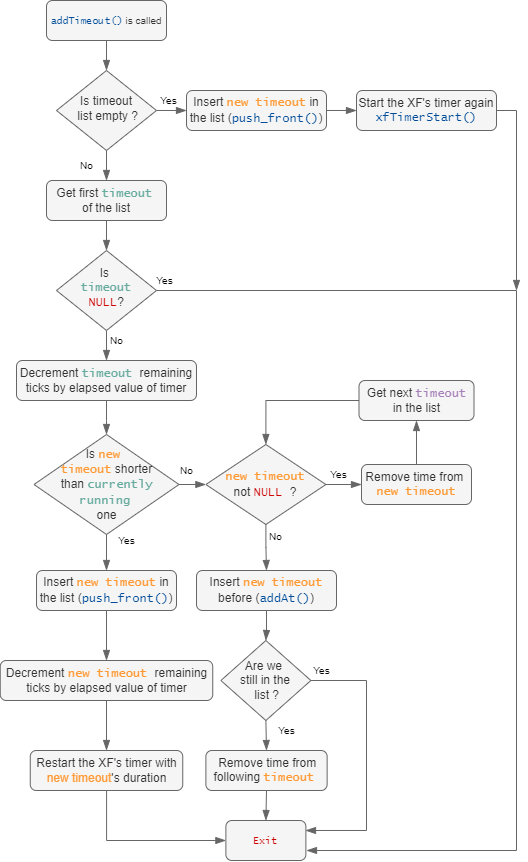
1_Document/2_Report/Include/Figure/uml/xf_timeout_manager_seq.png
