traibertr/LTEWatch/1_Document/2_Report/Include/Figure/uml/zephyr_project_struct.png

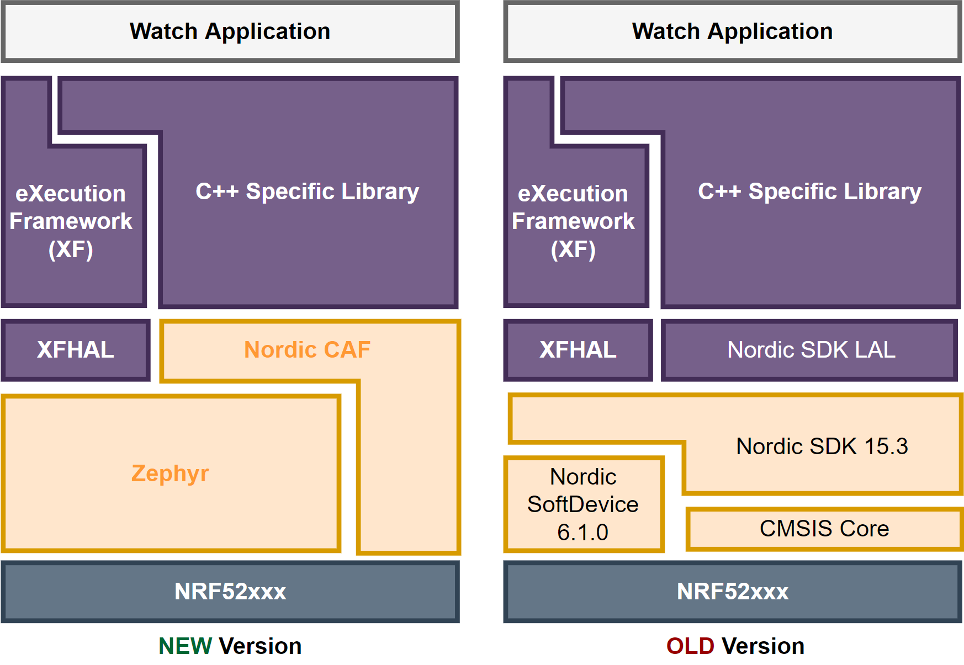
1_Document/2_Report/Include/Figure/uml/zephyr_project_struct.png
