traibertr/LTEWatch/1_Document/3_Presentation/figure/battery_discharge_curve.png

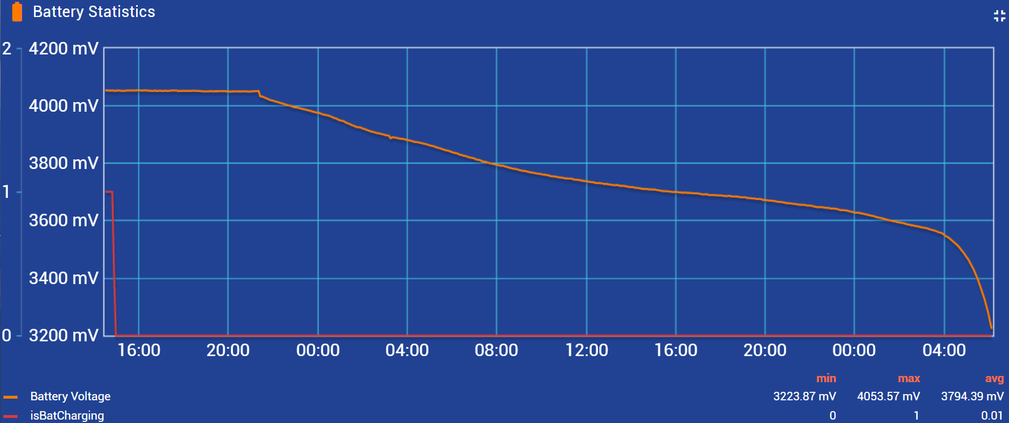
1_Document/3_Presentation/figure/battery_discharge_curve.png
