traibertr/LTEWatch/1_Document/3_Presentation/figure/bq25180_schem.png

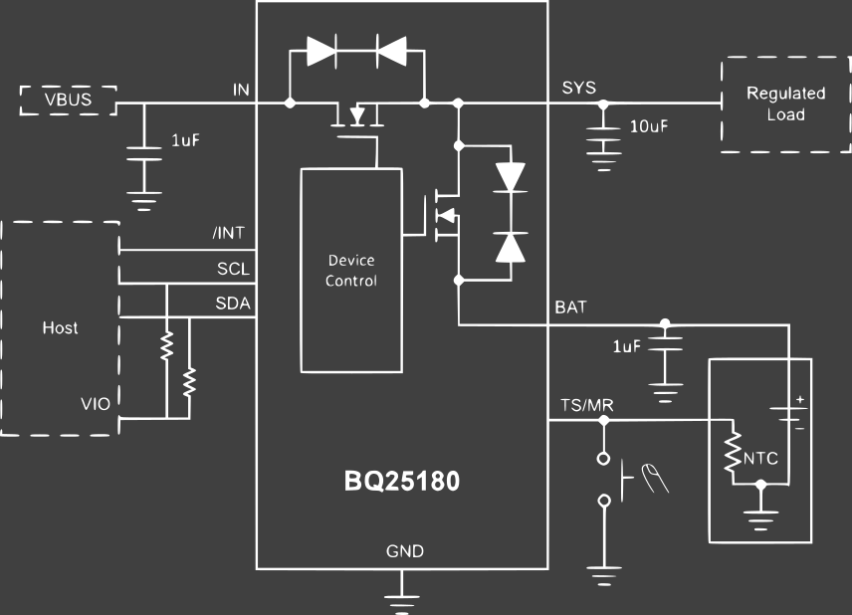
1_Document/3_Presentation/figure/bq25180_schem.png
