traibertr/LTEWatch/1_Document/3_Presentation/figure/LTEWatch_Strap_Antenna.jpeg

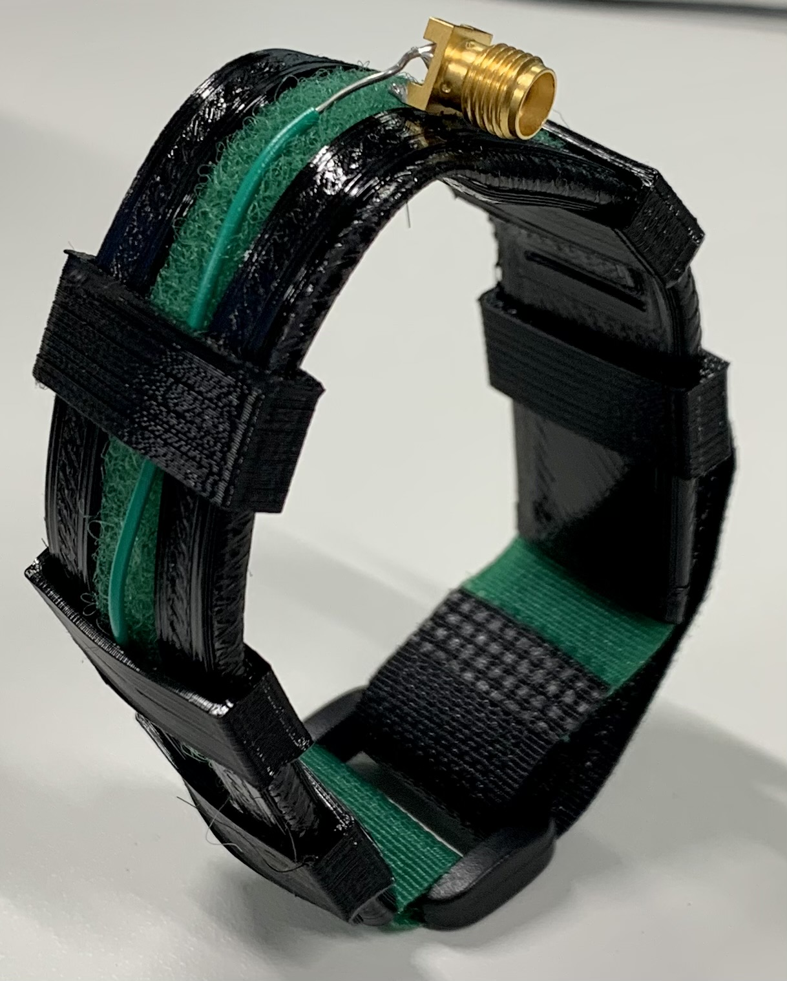
1_Document/3_Presentation/figure/LTEWatch_Strap_Antenna.jpeg
