traibertr/LTEWatch/2_Hardware/3_Prototye/Components/GNSS/2022-10-20 18_07_08-SAM-M8Q_WhitePaper_(UBX-16026689) (1).pdf - Foxit PDF Reader.png

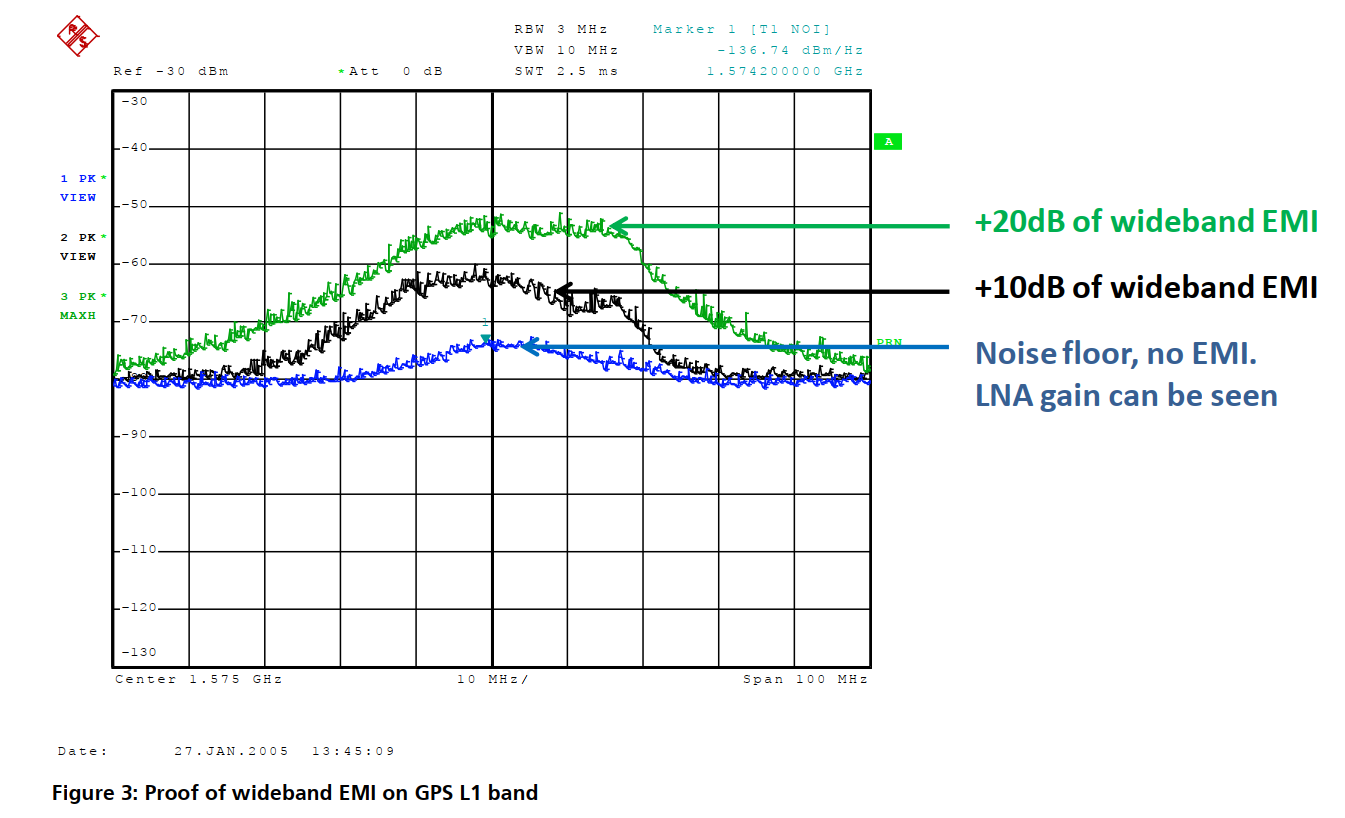
2_Hardware/3_Prototye/Components/GNSS/2022-10-20 18_07_08-SAM-M8Q_WhitePaper_(UBX-16026689) (1).pdf - Foxit PDF Reader.png
