traibertr/LTEWatch/2_Hardware/3_Prototye/Components/GNSS/bq51003_pinout1.png

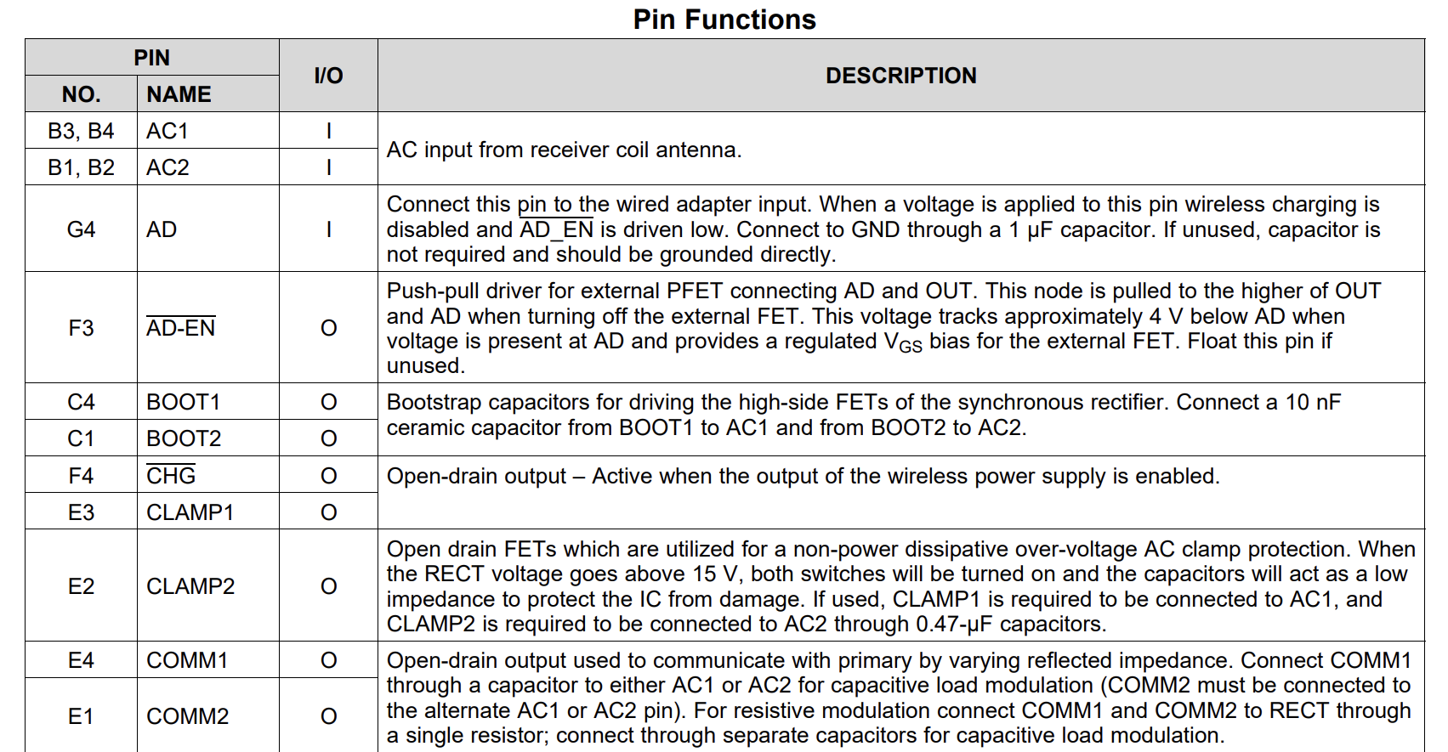
2_Hardware/3_Prototye/Components/GNSS/bq51003_pinout1.png
