traibertr/LTEWatch/2_Hardware/3_Prototye/Components/GNSS/bq51003_pinout2.png

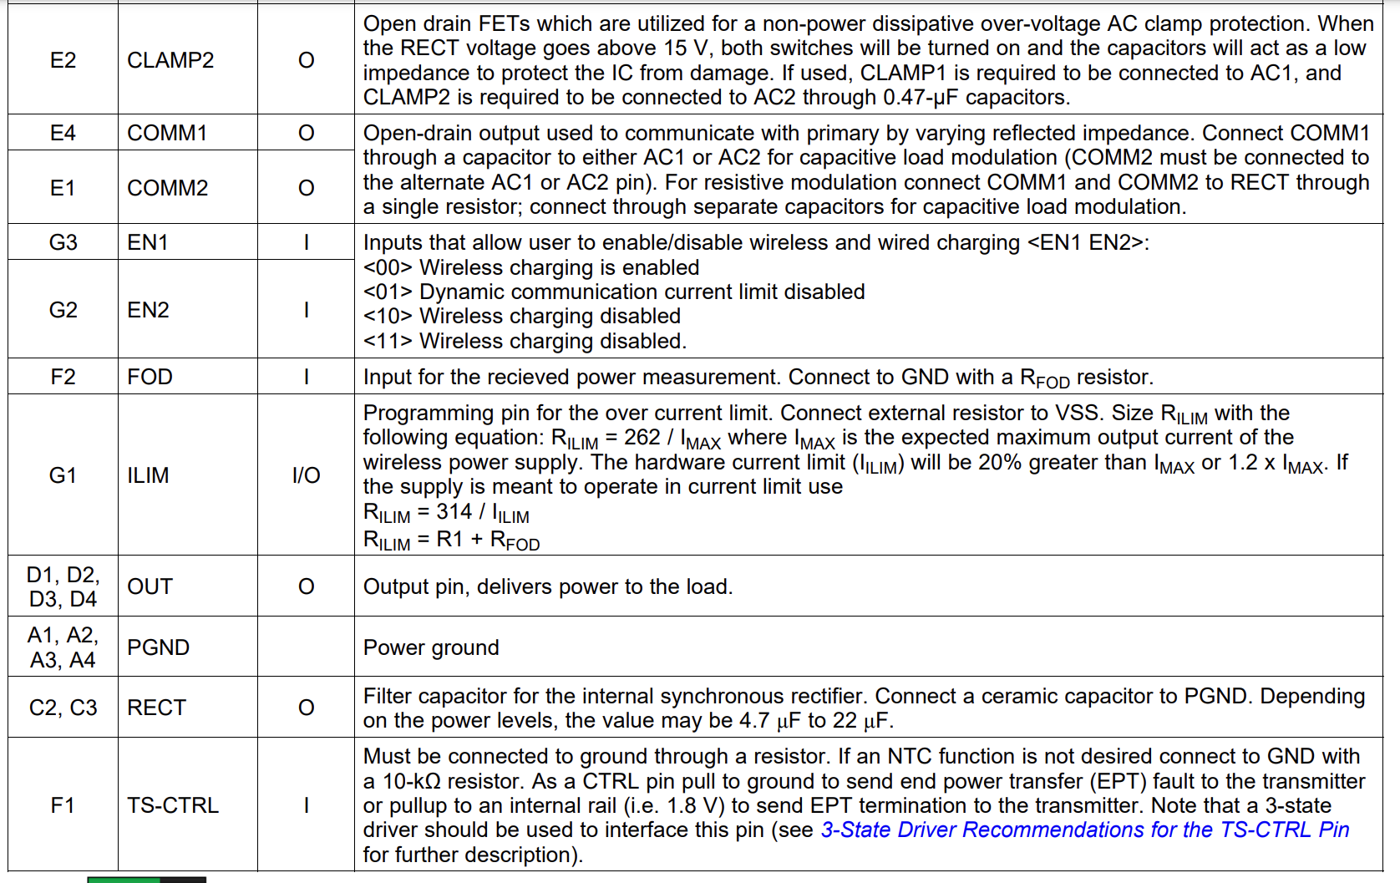
2_Hardware/3_Prototye/Components/GNSS/bq51003_pinout2.png
