traibertr/LTEWatch/2_Hardware/3_Prototye/Schematic/coex_interface.png

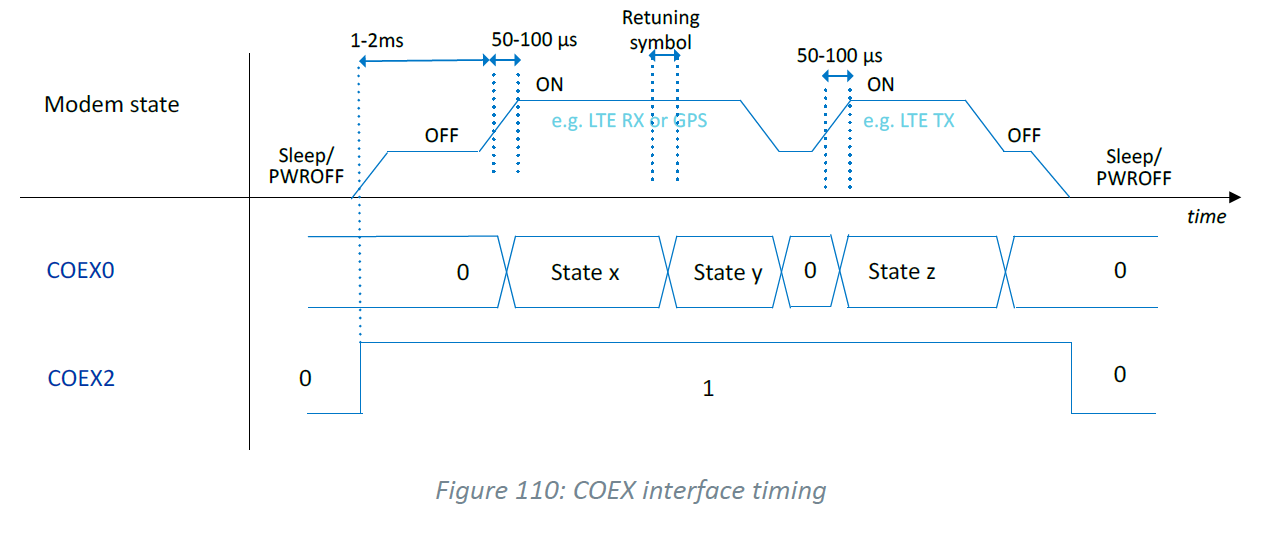
2_Hardware/3_Prototye/Schematic/coex_interface.png
