traibertr/LTEWatch/2_Hardware/3_Prototye/Schematic/Led_GPIO.png

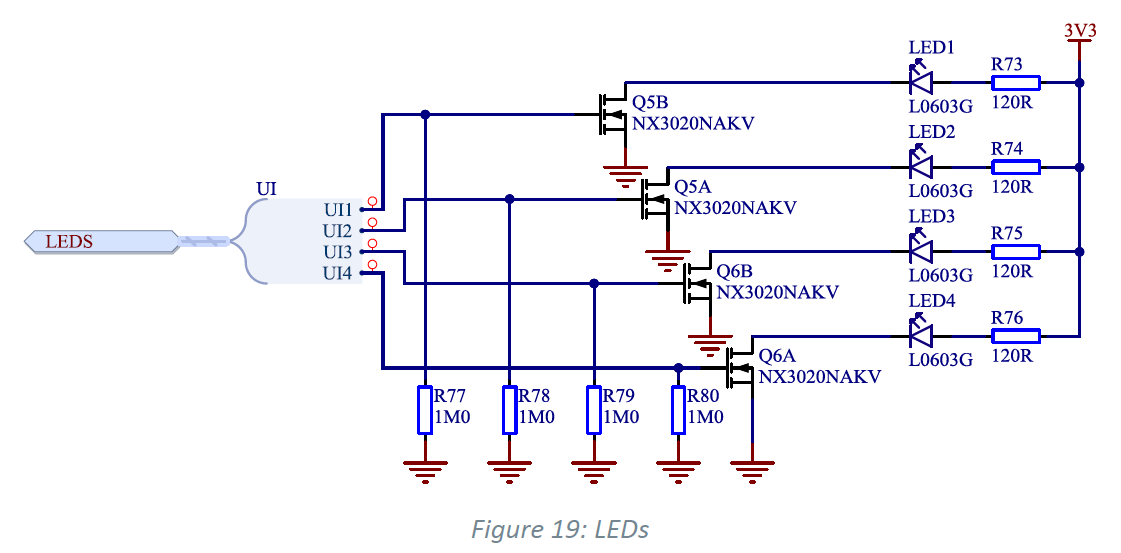
2_Hardware/3_Prototye/Schematic/Led_GPIO.png
