traibertr/LTEWatch/2_Hardware/3_Prototye/Schematic/prototype_schema.png

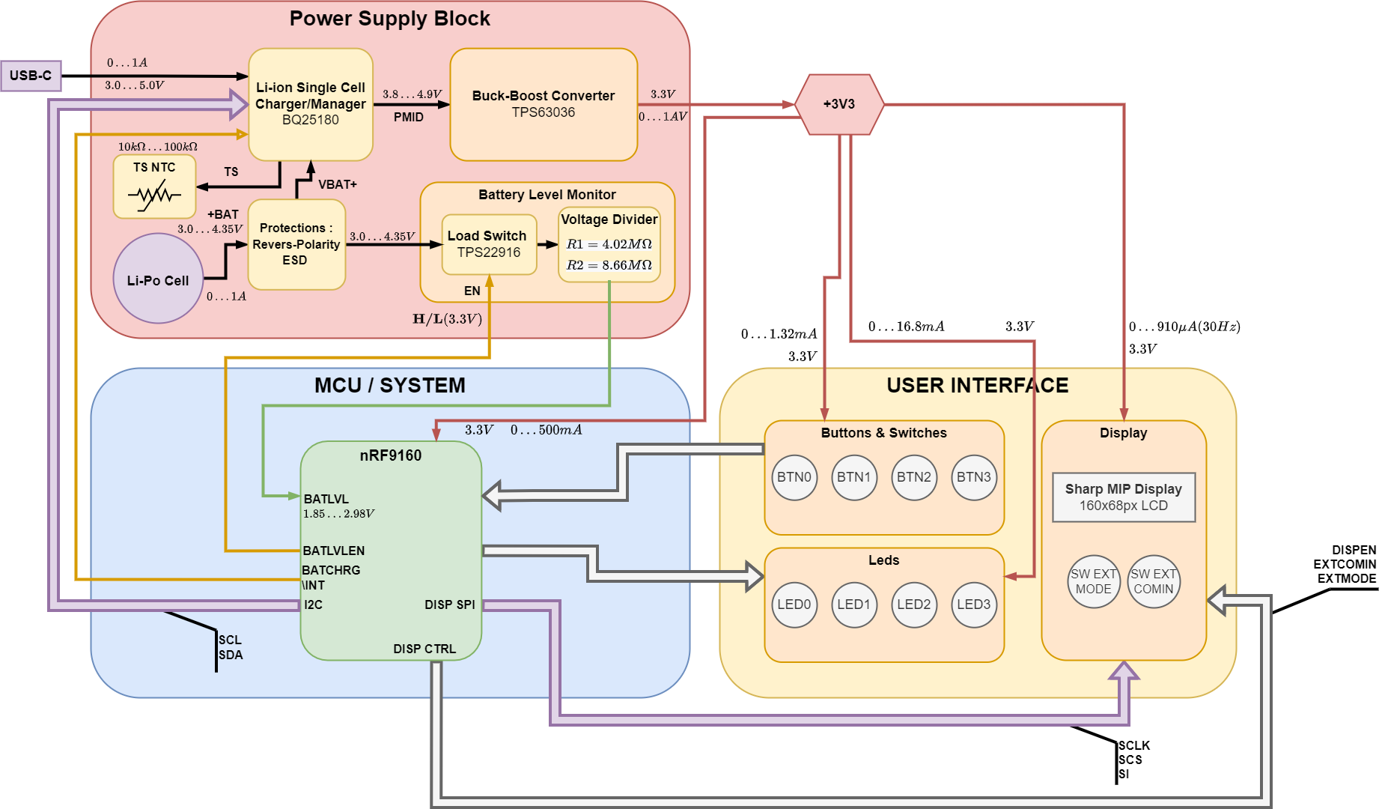
2_Hardware/3_Prototye/Schematic/prototype_schema.png
