traibertr/LTEWatch/2_Hardware/3_Prototye/Schematic/sharp_mem_lcd_breakout_board.png

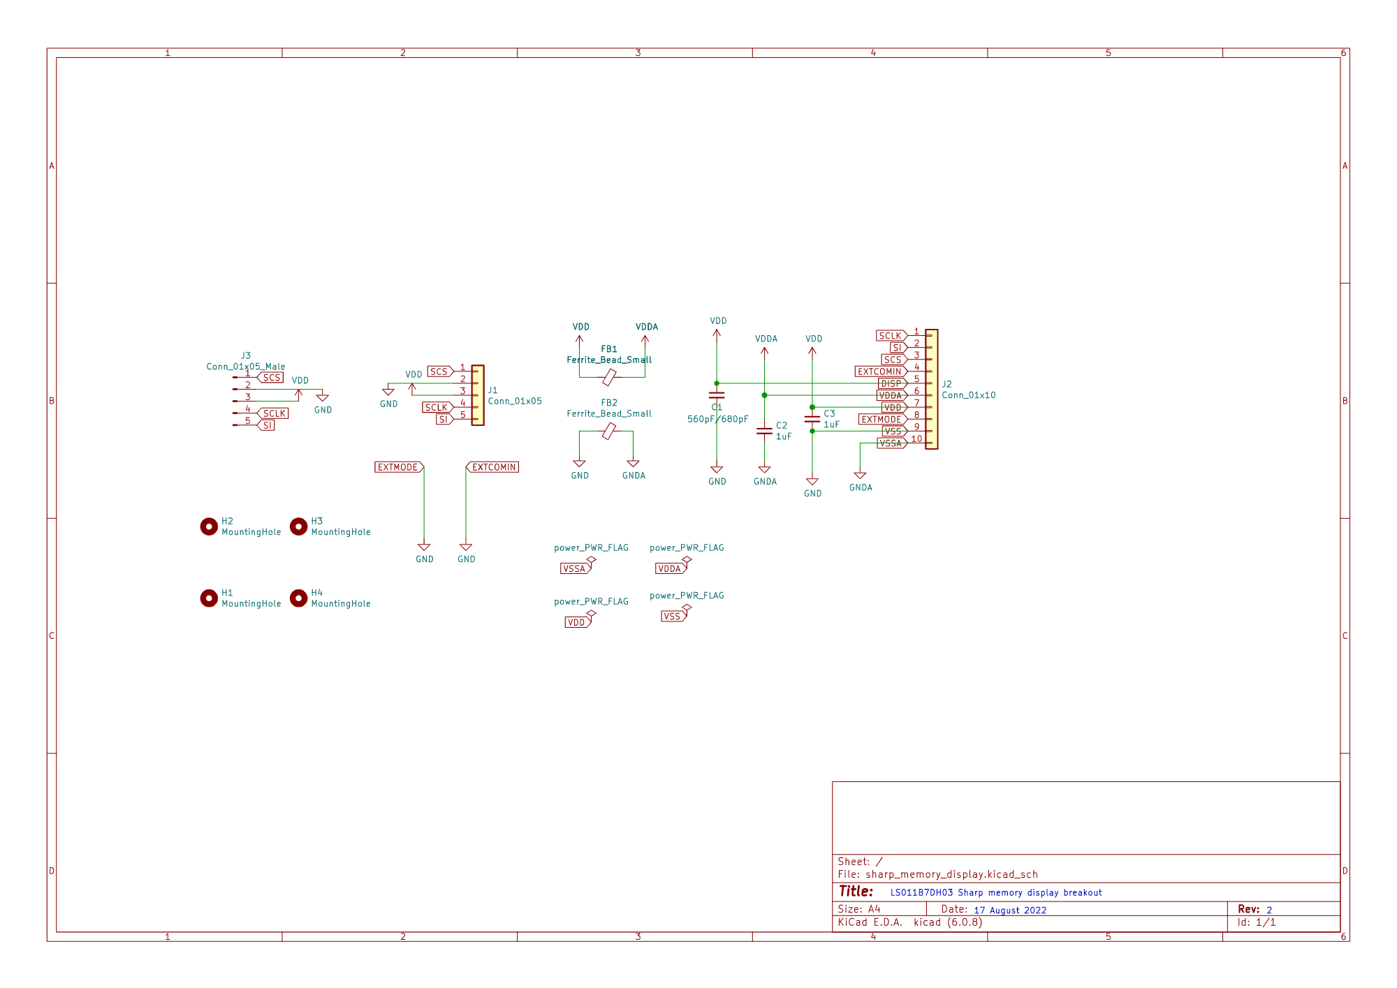
2_Hardware/3_Prototye/Schematic/sharp_mem_lcd_breakout_board.png
