traibertr/LTEWatch/2_Hardware/3_Prototye/Schematic/sim_interface.png

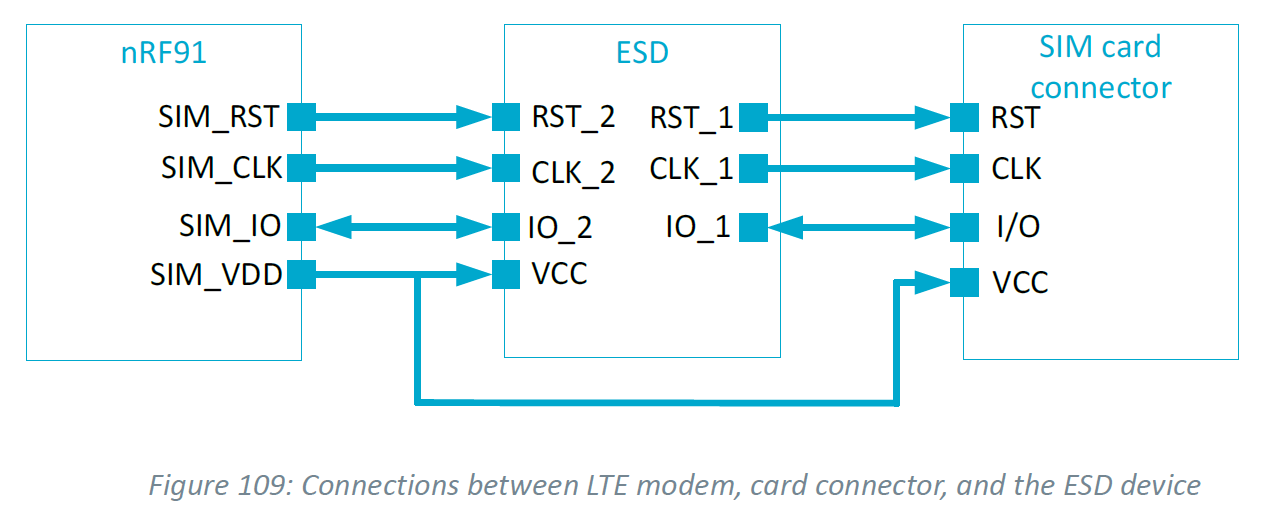
2_Hardware/3_Prototye/Schematic/sim_interface.png
