traibertr/LTEWatch/2_Hardware/3_Prototye/Schematic/SW_GPIO.png

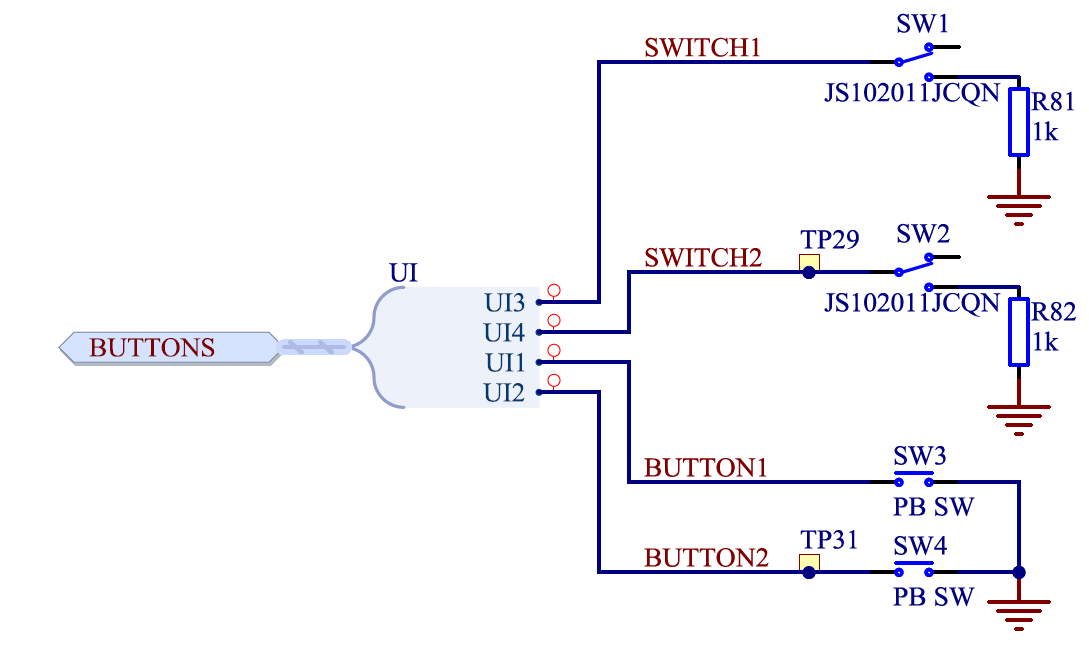
2_Hardware/3_Prototye/Schematic/SW_GPIO.png
