traibertr/LTEWatch/3_Software/LTEWatch_App/doc/doxygen/html/class_gpio_event.png

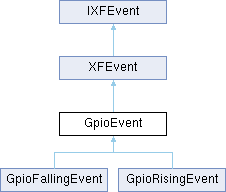
3_Software/LTEWatch_App/doc/doxygen/html/class_gpio_event.png
