traibertr/LTEWatch/3_Software/LTEWatch_App/doc/doxygen/html/class_i_x_f_event.png

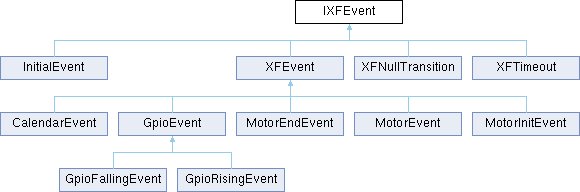
3_Software/LTEWatch_App/doc/doxygen/html/class_i_x_f_event.png
