traibertr/LTEWatch/2_Hardware/3_Prototye/Components/Power_Manager/part_selection.xlsx

Sheet: Sheet1
Power Supply Componant Choice
ID | Solution 1 |  |  |  |  | Solution 2 | Solution 3 | Solution 4
Part Number | BQ25120A (https://www.ti.com/product/BQ25120A) | BQ27421-G1 (https://www.ti.com/product/BQ27421-G1) | BQ2970 (https://www.ti.com/product/BQ2970) | TPS61046 (https://www.ti.com/product/TPS61046) | Part Number | MAX17330 (https://www.maximintegrated.com/en/products/power/battery-management/MAX17330.html) | BQ24232HA (https://www.ti.com/product/BQ24232HA) | BQ25155 (https://www.ti.com/product/BQ25155) | Add a 3V3 LDO | RT9525
Manufacturer | Texas Instrument | Texas Instrument | Texas Instrument | Texas Instrument | Manufacturer | Maxim Integrated | Texas Instrument | Texas Instrument |  | richtek | richtek | richtek | Maxim Integrated
Descritption | 300mA linear battery charger with Power Path, integrated LDO and buck converter 1.8V default output | System-side(tm) fuel gauge with integrated Sense Resistor (Bat Capacity min : 100mAh) | Li-Ion/Li Polymer Advanced Single-Cell Battery Protector IC Family | 28V Output Voltage Boost Converter in WCSP Package | Descritption | Gestion de batterie/pile 1 Cell Fuel Gauge with ModelGauge m5 EZ, Charger, Protector and SHA-256 Authentication |  | BQ25155 I2C Controlled 1-Cell 500-mA Linear Battery Charger With 10-nA Ship Mode, PowerPath With Regulated System (PMID) Voltage, ADC, and LDO
OVP | 3.4 V – 5.5 VIN (5.5-V OVP / 20-V Tolerant) |  | Config. 3.85V to 4.60V |  | OVP | (PCKP to GND +28V ) |  | 20-V Tolerant input with typical 3.4-V to 5.5-V input voltage operating range
ILIM | 400 |  |  |  | ILIM | 400mA to 2560mA, 10mA steps (with 10mΩ), config. Overdischarge Current |  | 1.25-mA to 500-mA fast charge current range
IDCHRG | Max 1.35A (Discharge Mode) |  |  |  | IDCHRG | Configurable overdischarge current |  | Over Current Threshold Programmable 1200-1600mA
THRM | External NTC Thermistor |  |  |  | THRM | Over/Under Temperature |  | Thermal profile. hot, warm, cool and cold thresholds
BATSWITCH | YES |  |  |  | BATSWITCH | YES
BATCHRG | Up to 300mA Charge Current |  |  |  | BATCHRG | 1mA to 500mA directly from universal 5V USB |  | 1.25-mA to 500-mA fast charge current range
SERIAL | I2C |  |  |  | SERIAL | I2C (Non-Volatile Programmable) |  | I2C
BUCK | Config. 300-mA Buck Regulator (1.1 - 3.3V) |  |  |  | BUCK
LDO | Config. Load Switch or 100mA (0.8 - 3.3V) |  |  |  | LDO |  |  | I2C Conf. load switch or 150-mA LDO output 0.6 V to 3.7 V in 100-mV steps + Always on 1.8-V VDD 10 mA
UVP |  |  | Config. 2.00V to 2.80 V |  | UVP | Configurable Undervoltage Shutdown Supply Current 0.1μA (max) Programmable undervoltage 20mV steps 2.2V to 3.4V. |  | Battery undervoltage Lockout Threshold, Prog. range, 150 mV Hysteresis 2.4-3V. Lockout with FET
BOOST |  |  |  | Optional | BOOST
BATGAUGE |  | Optional |  |  | BATGAUGE | Current Measurement Resolution (1.5625 μV) |  | Monitoring of charge current, battery thermistor and battery, input and system (PMID) voltages
IQ |  |  |  |  | IQ | 28μA |  | 27μA (worst case) / 3.5μA (LPM)
 |  |  |  |  |  | Pushbutton Wakeup/Factory Ship Mode (0.5μA) |  | Battery Discharge Current in Ship Mode (10-150nA)

Sheet: Sheet4
Column1 | Column2 | Column3 | Column4 | Column5 | Column6 | Column7 | Column8 | Column9 | Column10 | Column11 | Column12 | Column13 | Column14 | Column15 | Column16 | Column17 | Column18 | Column19
BQ21061 | 500-mA 1-cell linear charger with 10-nA ship mode, power-path, regulated system voltage and LDO</ | =HYPERLINK("https://www.ti.com/product/BQ21061/samplebuy","Ordering & quality") | 0 | 1 | 0.5 | 5.5 | --- | Li-Ion/Li-Polymer, Lithium Phosphate/LiFePO4 | 3.6 | 4.6 | 20 | Linear | I2C | BAT temp thermistor monitoring (hot/cold profile), IC thermal regulation, Input OVP, Integrated LDO, Power Path, VINDPM (Input voltage threshold to maximize adaptor power) | DSBGA|20 | $1.116 | 1ku | 3.15 | 4 mm2: 2.2 x 1.8 (DSBGA|20)
BQ21062 | 500-mA 1-cell linear charger with 10-nA ship mode, power-path, regulated system voltage and LDO | =HYPERLINK("https://www.ti.com/product/BQ21062/samplebuy","Ordering & quality") | 2,500 | 1 | 0.5 | 5.5 | --- | Li-Ion/Li-Polymer, Lithium Phosphate/LiFePO4 | 3.6 | 4.6 | 20 | Linear | I2C | BAT temp thermistor monitoring (JEITA profile), BAT temp thermistor monitoring (hot/cold profile), IC thermal regulation, IINDPM (Input current limit), Input OVP, Integrated LDO, Power Path, VINDPM (Input voltage threshold to maximize adaptor power) | DSBGA|20 | $1.110 | 1ku | 3.15 | 4 mm2: 2.2 x 1.8 (DSBGA|20)
BQ24030 | Dual input 1-cell 2-A Li-ion battery charger with Dynamic power-Path Management | =HYPERLINK("https://www.ti.com/product/BQ24030/samplebuy","Ordering & quality") | 426 | 1 | 1.5 | 16 | --- | Li-Ion/Li-Polymer | 4.2 | 4.2 | 18 | Linear | Standalone (RC-Settable) | BAT temp thermistor monitoring (hot/cold profile), Integrated LDO, Power Path | VQFN|20 | $1.663 | 1ku | 4.35 | 16 mm2: 3.5 x 4.5 (VQFN|20)
BQ24031 | Standalone 1-cell, 2-A battery charger with dynamic Power Path, output regulated to 6V battery | =HYPERLINK("https://www.ti.com/product/BQ24031/samplebuy","Ordering & quality") | 3,307 | 1 | 1.5 | 16 | --- | Li-Ion/Li-Polymer | 4.1 | 4.1 | 18 | Linear | Standalone (RC-Settable) | BAT temp thermistor monitoring (hot/cold profile), Integrated LDO, Power Path | VQFN|20 | $1.663 | 1ku | 4.35 | 16 mm2: 3.5 x 4.5 (VQFN|20)
BQ24031-Q1 | Automotive Standalone 1-cell 2-A linear battery charger with Dual input and 4.1-V charge Voltage | =HYPERLINK("https://www.ti.com/product/BQ24031-Q1/samplebuy","Ordering & quality") | 0 | 1 | 1.5 | 16 | --- | Li-Ion/Li-Polymer | 4.1 | 4.1 | 18 | Linear | Standalone (RC-Settable) | BAT temp thermistor monitoring (hot/cold profile), Integrated LDO, Power Path | VQFN|20 | $2.079 | 1ku | 4.35 | 16 mm2: 3.5 x 4.5 (VQFN|20)
BQ24032A | Standalone 1-cell, 2-A battery charger - dynamic Power Path, output regulated to 4.4V, Vbat 4.2V | =HYPERLINK("https://www.ti.com/product/BQ24032A/samplebuy","Ordering & quality") | 11,430 | 1 | 1.5 | 16 | --- | Li-Ion/Li-Polymer | 4.2 | 4.2 | 18 | Linear | Standalone (RC-Settable) | BAT temp thermistor monitoring (hot/cold profile), Integrated LDO, Power Path | VQFN|20 | $1.663 | 1ku | 4.35 | 16 mm2: 3.5 x 4.5 (VQFN|20)
BQ24035 | Standalone 1-cell, 2-A battery charger with dynamic Power Path, output cutoff at 6V, Vbat 4.2V | =HYPERLINK("https://www.ti.com/product/BQ24035/samplebuy","Ordering & quality") | 3,500 | 1 | 1.5 | 16 | --- | Li-Ion/Li-Polymer | 4.2 | 4.2 | 18 | Linear | Standalone (RC-Settable) | BAT temp thermistor monitoring (hot/cold profile), Integrated LDO, Power Path | VQFN|20 | $1.663 | 1ku | 4.35 | 16 mm2: 3.5 x 4.5 (VQFN|20)
BQ24038 | Standalone 1-cell, 2-A battery charger with dynamic Power Path, output reg. to 4.4V, Vbat 4.4V | =HYPERLINK("https://www.ti.com/product/BQ24038/samplebuy","Ordering & quality") | 24,906 | 1 | 1.5 | 6.4 | --- | Li-Ion/Li-Polymer | 4.2, 4.36 | 4.2, 4.36 | 18 | Linear | Standalone (RC-Settable) | BAT temp thermistor monitoring (hot/cold profile), Integrated LDO, Power Path | VQFN|20 | $1.663 | 1ku | 4.35 | 16 mm2: 3.5 x 4.5 (VQFN|20)
BQ24070 | 1-cell 2-A Li-ion linear battery charger, Power Path, Output regulated to 4.4V | =HYPERLINK("https://www.ti.com/product/BQ24070/samplebuy","Ordering & quality") | 1,473 | 1 | 1.5 | 16 | --- | Li-Ion/Li-Polymer | 4.2 | 4.2 | 18 | Linear | Standalone (RC-Settable) | BAT temp thermistor monitoring (hot/cold profile), IC thermal regulation, Power Path | VQFN|20 | $1.159 | 1ku | 4.35 | 16 mm2: 3.5 x 4.5 (VQFN|20)
BQ24071 | 1-cell 2-A Li-ion linear battery charger,Power Path, Output regulated to 6V | =HYPERLINK("https://www.ti.com/product/BQ24071/samplebuy","Ordering & quality") | 0 | 1 | 1.5 | 16 | --- | Li-Ion/Li-Polymer | 4.2 | 4.2 | 18 | Linear | Standalone (RC-Settable) | BAT temp thermistor monitoring (hot/cold profile), IC thermal regulation, Power Path | VQFN|20 | $1.159 | 1ku | 4.35 | 16 mm2: 3.5 x 4.5 (VQFN|20)
BQ24072 | Standalone 1-cell 1.5-A linear battery charger, Power Path, 4.2-V VBAT and VOUT=VBAT + 225mV | =HYPERLINK("https://www.ti.com/product/BQ24072/samplebuy","Ordering & quality") | 133,205 | 1 | 1.5 | 6.4 | --- | Li-Ion/Li-Polymer | 4.2 | 4.2 | 28 | Linear | Standalone (RC-Settable) | BAT temp thermistor monitoring (hot/cold profile), IC thermal regulation, Input OVP, Power Path, VINDPM (Input voltage threshold to maximize adaptor power) | VQFN|16 | $1.300 | 1ku | 4.35 | 9 mm2: 3 x 3 (VQFN|16)
BQ24072T | Standalone 1-cell 1.5-A linear battery charger, Power Path, 4.2-V VBAT, Voltage-based TS w/ TD | =HYPERLINK("https://www.ti.com/product/BQ24072T/samplebuy","Ordering & quality") | 0 | 1 | 1.5 | 6.4 | --- | Li-Ion/Li-Polymer | 4.2 | 4.2 | 28 | Linear | Standalone (RC-Settable) | BAT temp thermistor monitoring (hot/cold profile), IC thermal regulation, Input OVP, Power Path, VINDPM (Input voltage threshold to maximize adaptor power) | VQFN|16 | $1.300 | 1ku | 4.35 | 9 mm2: 3 x 3 (VQFN|16)
BQ24073 | Standalone 1-cell 1.5-A linear battery charger, Power Path, 4.2-V VBAT and 4.4-V VOUT | =HYPERLINK("https://www.ti.com/product/BQ24073/samplebuy","Ordering & quality") | 341,588 | 1 | 1.5 | 6.4 | --- | Li-Ion/Li-Polymer | 4.2 | 4.2 | 28 | Linear | Standalone (RC-Settable) | BAT temp thermistor monitoring (hot/cold profile), IC thermal regulation, Input OVP, Power Path, VINDPM (Input voltage threshold to maximize adaptor power) | VQFN|16 | $1.300 | 1ku | 4.35 | 9 mm2: 3 x 3 (VQFN|16)
BQ24074 | Standalone 1-cell 1.5-A linear battery charger, Power Path, 4.2-V VBAT, 10.5-V OVP and 4.4-V VOUT | =HYPERLINK("https://www.ti.com/product/BQ24074/samplebuy","Ordering & quality") | 55,955 | 1 | 1.5 | 10.2 | Functional Safety-Capable | Li-Ion/Li-Polymer | 4.2 | 4.2 | 28 | Linear | Standalone (RC-Settable) | BAT temp thermistor monitoring (hot/cold profile), IC thermal regulation, Input OVP, Power Path, VINDPM (Input voltage threshold to maximize adaptor power) | VQFN|16 | $1.300 | 1ku | 4.35 | 9 mm2: 3 x 3 (VQFN|16)
BQ24075 | Standalone 1-cell 1.5-A linear battery charger, Power Path, 4.2-V VBAT and 5.5-V VOUT | =HYPERLINK("https://www.ti.com/product/BQ24075/samplebuy","Ordering & quality") | 16,853 | 1 | 1.5 | 6.4 | --- | Li-Ion/Li-Polymer | 4.2 | 4.2 | 28 | Linear | Standalone (RC-Settable) | BAT temp thermistor monitoring (hot/cold profile), IC thermal regulation, Input OVP, Power Path, VINDPM (Input voltage threshold to maximize adaptor power) | VQFN|16 | $0.808 | 1ku | 4.35 | 9 mm2: 3 x 3 (VQFN|16)
BQ24075-Q1 | Automotive Qualified Standalone 1-cell 1.5-A linear battery charger, Power Path and 4.2-V VBAT | =HYPERLINK("https://www.ti.com/product/BQ24075-Q1/samplebuy","Ordering & quality") | 0 | 1 | 1.5 | 6.4 | --- | Li-Ion/Li-Polymer | 4.2 | 4.2 | 28 | Linear | Standalone (RC-Settable) | BAT temp thermistor monitoring (hot/cold profile), IC thermal regulation, Input OVP, Power Path, VINDPM (Input voltage threshold to maximize adaptor power) | VQFN|16 | $1.625 | 1ku | 4.35 | 9 mm2: 3 x 3 (VQFN|16)
BQ24075T | Standalone 1-cell 1.5-A linear battery charger, Power Path, 4.2-V VBAT, Voltage-based TS w/ SYSOFF | =HYPERLINK("https://www.ti.com/product/BQ24075T/samplebuy","Ordering & quality") | 211,630 | 1 | 1.5 | 6.4 | --- | Li-Ion/Li-Polymer | 4.2 | 4.2 | 28 | Linear | Standalone (RC-Settable) | BAT temp thermistor monitoring (hot/cold profile), IC thermal regulation, Input OVP, Power Path, VINDPM (Input voltage threshold to maximize adaptor power) | VQFN|16 | $0.808 | 1ku | 4.35 | 9 mm2: 3 x 3 (VQFN|16)
BQ24076 | Standalone 1-cell 1.5-A linear charger, Power Path and 4.4-V VBAT | =HYPERLINK("https://www.ti.com/product/BQ24076/samplebuy","Ordering & quality") | 201,928 | 1 | 1.5 | 6.4 | --- | Li-Ion/Li-Polymer | 4.4 | 4.4 | 28 | Linear | Standalone (RC-Settable) | BAT temp thermistor monitoring (hot/cold profile), IC thermal regulation, Input OVP, Power Path, VINDPM (Input voltage threshold to maximize adaptor power) | VQFN|16 | $1.300 | 1ku | 4.35 | 9 mm2: 3 x 3 (VQFN|16)
BQ24078 | Standalone 1-cell 1.5-A linear battery charger, Power Path and 4.35-V VBAT | =HYPERLINK("https://www.ti.com/product/BQ24078/samplebuy","Ordering & quality") | 53,330 | 1 | 1.5 | 6.4 | --- | Li-Ion/Li-Polymer | 4.35 | 4.35 | 28 | Linear | Standalone (RC-Settable) | BAT temp thermistor monitoring (hot/cold profile), IC thermal regulation, Input OVP, Power Path, VINDPM (Input voltage threshold to maximize adaptor power) | VQFN|16 | $1.300 | 1ku | 4.35 | 9 mm2: 3 x 3 (VQFN|16)
BQ24079 | Standalone 1-cell 1.5-A linear battery charger, Power Path and 4.1-V VBAT | =HYPERLINK("https://www.ti.com/product/BQ24079/samplebuy","Ordering & quality") | 114,530 | 1 | 1.5 | 6.4 | --- | Li-Ion/Li-Polymer | 4.1 | 4.1 | 28 | Linear | Standalone (RC-Settable) | BAT temp thermistor monitoring (hot/cold profile), IC thermal regulation, Input OVP, Power Path, VINDPM (Input voltage threshold to maximize adaptor power) | VQFN|16 | $1.300 | 1ku | 4.35 | 9 mm2: 3 x 3 (VQFN|16)
BQ24079QW-Q1 | Automotive Qualified Standalone 1-cell 1.5-A linear charger, Power Path and 4.1-V VBAT | =HYPERLINK("https://www.ti.com/product/BQ24079QW-Q1/samplebuy","Ordering & quality") | 0 | 1 | 1.5 | 6.4 | --- | Li-Ion/Li-Polymer | 4.1 | 4.1 | 28 | Linear | Standalone (RC-Settable) | BAT temp thermistor monitoring (hot/cold profile), IC thermal regulation, Input OVP, Power Path, VINDPM (Input voltage threshold to maximize adaptor power) | VQFN|16 | $1.625 | 1ku | 4.35 | 9 mm2: 3 x 3 (VQFN|16)
BQ24079T | Standalone 1-cell 1.5-A linear charger, Power Path, 4.1-V VBAT and Voltage-based TS | =HYPERLINK("https://www.ti.com/product/BQ24079T/samplebuy","Ordering & quality") | 69,165 | 1 | 1.5 | 6.4 | --- | Li-Ion/Li-Polymer | 4.1 | 4.1 | 28 | Linear | Standalone (RC-Settable) | BAT temp thermistor monitoring (hot/cold profile), IC thermal regulation, Input OVP, Power Path, VINDPM (Input voltage threshold to maximize adaptor power) | VQFN|16 | $1.300 | 1ku | 4.35 | 9 mm2: 3 x 3 (VQFN|16)
BQ24130 | Standalone 1-3 cell Buck battery charger for Li-ion and Super capacitor | =HYPERLINK("https://www.ti.com/product/BQ24130/samplebuy","Ordering & quality") | 65 | 1, 2, 3 | 2.5 | 17 | --- | Li-Ion/Li-Polymer, SuperCap | 4.2, 8.4, 12.6 | 4.2, 8.4, 12.6 | 20 | Switch-Mode Buck | Standalone (RC-Settable) | BAT temp thermistor monitoring (hot/cold profile), IC thermal regulation, Power Path | VQFN|20 | $1.980 | 1ku | 4.5 | 16 mm2: 3.5 x 4.5 (VQFN|20)
BQ24133 | Standalone 1-3 cell 2.5A synchronous Buck battery charger with external Power Path | =HYPERLINK("https://www.ti.com/product/BQ24133/samplebuy","Ordering & quality") | 0 | 1, 2, 3 | 2.5 | 17 | --- | Li-Ion/Li-Polymer | 4.2, 8.4, 12.6 | 4.2, 8.4, 12.6 | 20 | Switch-Mode Buck | Standalone (RC-Settable) | BAT temp thermistor monitoring (hot/cold profile), IC thermal regulation, IINDPM (Input current limit), Input OVP, Power Path | VQFN|24 | $1.390 | 1ku | 4.5 | 19 mm2: 3.5 x 5.5 (VQFN|24)
BQ24159 | Fully Integrated Switch Mode One Cell Li-Ion Charger with Full USB-Compliance. | =HYPERLINK("https://www.ti.com/product/BQ24159/samplebuy","Ordering & quality") | 2,500 | 1 | 1.55 | 9 | --- | Li-Ion/Li-Polymer | 3.5 | 4.44 | 20 | Switch-Mode Buck | I2C | BAT temp thermistor monitoring (JEITA profile), Power Path | DSBGA|20 | $2.128 | 1ku | 4 | See datasheet (DSBGA)
BQ24160 | I2C 1cell 2.5A Buck battery charger with dual-input, Power Path and USB detection | =HYPERLINK("https://www.ti.com/product/BQ24160/samplebuy","Ordering & quality") | 26,715 | 1 | 2.5 | 10 | --- | Li-Ion/Li-Polymer | 3.5 | 4.44 | 20 | Switch-Mode Buck | I2C | BAT temp thermistor monitoring (JEITA profile), BAT temp thermistor monitoring (hot/cold profile), IINDPM (Input current limit), Input OVP, Power Path, USB D+/D-/BC1.2 integrated | DSBGA|49, VQFN|24 | $1.980 | 1ku | 4.2 | See datasheet (DSBGA), 16 mm2: 4 x 4 (VQFN|24)
BQ24160A | I2C 1cell 2.5A Buck battery charger with dual-input, Power Path and no WD | =HYPERLINK("https://www.ti.com/product/BQ24160A/samplebuy","Ordering & quality") | 19 | 1 | 2.5 | 10 | --- | Li-Ion/Li-Polymer | 3.5 | 4.44 | 20 | Switch-Mode Buck | I2C | BAT temp thermistor monitoring (JEITA profile), BAT temp thermistor monitoring (hot/cold profile), IINDPM (Input current limit), Input OVP, Power Path, USB D+/D-/BC1.2 integrated | VQFN|24 | $1.980 | 1ku | 4.2 | 16 mm2: 4 x 4 (VQFN|24)
BQ24161 | I2C 1cell 2.5A Buck battery charger with dual-input, Power Path and PSEL | =HYPERLINK("https://www.ti.com/product/BQ24161/samplebuy","Ordering & quality") | 48,560 | 1 | 2.5 | 10 | --- | Li-Ion/Li-Polymer | 3.5 | 4.44 | 20 | Switch-Mode Buck | I2C | BAT temp thermistor monitoring (hot/cold profile), IINDPM (Input current limit), Input OVP, Power Path | DSBGA|49, VQFN|24 | $1.890 | 1ku | 4.2 | See datasheet (DSBGA), 16 mm2: 4 x 4 (VQFN|24)
BQ24161B | I2C 1cell 2.5A Buck battery charger with dual-input, Power Path, JEITA and PSEL | =HYPERLINK("https://www.ti.com/product/BQ24161B/samplebuy","Ordering & quality") | 0 | 1 | 2.5 | 10 | --- | Li-Ion/Li-Polymer | 3.5 | 4.44 | 20 | Switch-Mode Buck | I2C | BAT temp thermistor monitoring (JEITA profile), BAT temp thermistor monitoring (hot/cold profile), IINDPM (Input current limit), Input OVP, Power Path | VQFN|24 | $1.980 | 1ku | 4.2 | 16 mm2: 4 x 4 (VQFN|24)
BQ24163 | I2C 1cell 2.5A Buck battery charger with dual-input, Power Path and 3.2V Vsysmin | =HYPERLINK("https://www.ti.com/product/BQ24163/samplebuy","Ordering & quality") | 26,450 | 1 | 2.5 | 10 | --- | Li-Ion/Li-Polymer | 3.5 | 4.44 | 20 | Switch-Mode Buck | I2C | BAT temp thermistor monitoring (JEITA profile), BAT temp thermistor monitoring (hot/cold profile), IINDPM (Input current limit), Input OVP, Power Path, USB D+/D-/BC1.2 integrated | DSBGA|49, VQFN|24 | $1.980 | 1ku | 4.2 | See datasheet (DSBGA), 16 mm2: 4 x 4 (VQFN|24)
BQ24165 | I2C 1cell 2.5A Buck battery charger with dual-input, Power Path and no TS | =HYPERLINK("https://www.ti.com/product/BQ24165/samplebuy","Ordering & quality") | 61,686 | 1 | 2.5 | 10 | --- | Li-Ion/Li-Polymer | 4.2 | 4.2 | 20 | Switch-Mode Buck | I2C | BAT temp thermistor monitoring (JEITA profile), BAT temp thermistor monitoring (hot/cold profile), Input OVP, Power Path, VINDPM (Input voltage threshold to maximize adaptor power) | DSBGA|49, VQFN|24 | $1.980 | 1ku | 4.2 | See datasheet (DSBGA), 16 mm2: 4 x 4 (VQFN|24)
BQ24166 | I2C 1cell 2.5A Buck battery charger with dual-input, Power Path and no JEITA | =HYPERLINK("https://www.ti.com/product/BQ24166/samplebuy","Ordering & quality") | 5,650 | 1 | 2.5 | 10 | --- | Li-Ion/Li-Polymer | 4.2 | 4.2 | 20 | Switch-Mode Buck | Standalone (RC-Settable) | BAT temp thermistor monitoring (hot/cold profile), Input OVP, Power Path, VINDPM (Input voltage threshold to maximize adaptor power) | DSBGA|49, VQFN|24 | $1.980 | 1ku | 4.2 | See datasheet (DSBGA), 16 mm2: 4 x 4 (VQFN|24)
BQ24167 | I2C 1cell 2.5A Buck battery charger with dual-input, Power Path and JEITA | =HYPERLINK("https://www.ti.com/product/BQ24167/samplebuy","Ordering & quality") | 0 | 1 | 2.5 | 10 | --- | Li-Ion/Li-Polymer | 4.2 | 4.2 | 20 | Switch-Mode Buck | I2C | BAT temp thermistor monitoring (JEITA profile), Input OVP, Power Path | DSBGA|49, VQFN|24 | $4.752 | 1ku | 4.2 | See datasheet (DSBGA), 16 mm2: 4 x 4 (VQFN|24)
BQ24168 | I2C 1cell 2.5A Buck battery charger with dual-input, Power Path and 6.5V OVP | =HYPERLINK("https://www.ti.com/product/BQ24168/samplebuy","Ordering & quality") | 24,727 | 1 | 2.5 | 6 | --- | Li-Ion/Li-Polymer | 3.5 | 4.44 | 20 | Switch-Mode Buck | I2C | BAT temp thermistor monitoring (JEITA profile), BAT temp thermistor monitoring (hot/cold profile), IINDPM (Input current limit), Input OVP, Power Path | DSBGA|49, VQFN|24 | $1.980 | 1ku | 4.2 | See datasheet (DSBGA), 16 mm2: 4 x 4 (VQFN|24)
BQ24170 | Standalone 1-3 cell 4A synchronous Buck battery charger with Power Path selector | =HYPERLINK("https://www.ti.com/product/BQ24170/samplebuy","Ordering & quality") | 0 | 1, 2, 3 | 4 | 17 | --- | Li-Ion/Li-Polymer | 4.2, 8.4, 12.6 | 4.2, 8.4, 12.6 | 20 | Switch-Mode Buck | Standalone (RC-Settable) | BAT temp thermistor monitoring (hot/cold profile), IC thermal regulation, Input OVP, Power Path | VQFN|24 | $1.730 | 1ku | 4.5 | 19 mm2: 3.5 x 5.5 (VQFN|24)
BQ24171 | Standalone 1-3 cell 4A synchronous Buck battery charger with JEITA compliance and Power Path | =HYPERLINK("https://www.ti.com/product/BQ24171/samplebuy","Ordering & quality") | 0 | 1, 2, 3 | 4 | 17 | --- | Li-Ion/Li-Polymer | 2.1 | 15.5 | 20 | Switch-Mode Buck | Standalone (RC-Settable) | BAT temp thermistor monitoring (JEITA profile), BAT temp thermistor monitoring (hot/cold profile), IC thermal regulation, IINDPM (Input current limit), Input OVP, Power Path | VQFN|24 | $1.730 | 1ku | 4.5 | 19 mm2: 3.5 x 5.5 (VQFN|24)
BQ24172 | Standalone 1-3 cell 4A synchronous Buck battery charger | =HYPERLINK("https://www.ti.com/product/BQ24172/samplebuy","Ordering & quality") | 0 | 1, 2, 3 | 4 | 17 | --- | Li-Ion/Li-Polymer, Lithium Phosphate/LiFePO4, NiMH | 2.1 | 15.5 | 20 | Switch-Mode Buck | Standalone (RC-Settable) | BAT temp thermistor monitoring (hot/cold profile), IC thermal regulation, Input OVP, Power Path | VQFN|24 | $1.730 | 1ku | 4.5 | 19 mm2: 3.5 x 5.5 (VQFN|24)
BQ24179 | Integrated, NVDC, 5-A 1-cell to 4-cell switch-mode buck-boost battery charger | =HYPERLINK("https://www.ti.com/product/BQ24179/samplebuy","Ordering & quality") | 0 | 1, 2, 3, 4 | 5 | 24 | --- | Li-Ion/Li-Polymer, Lithium Phosphate/LiFePO4 | 3 | 18.8 | 30 | Switch-Mode Buck-boost | I2C | BAT temp thermistor monitoring (JEITA profile), IC thermal regulation, ICO (Input Current Optimization), IINDPM (Input current limit), Input OVP, Integrated ADC, Power Path, USB C/PD compatible, USB D+/D-/BC1.2 integrated, VINDPM (Input voltage threshold to maximize adaptor power) | DSBGA|56 | $2.770 | 1ku | 3.6 | 10 mm2: 2.89 x 3.31 (DSBGA|56)
BQ24190 | I2C controlled 4.5A single cell USB / Adaptor charger | =HYPERLINK("https://www.ti.com/product/BQ24190/samplebuy","Ordering & quality") | 36,000 | 1 | 4.5 | 17 | --- | Li-Ion/Li-Polymer | 3.5 | 4.4 | 22 | Switch-Mode Buck | I2C | BAT temp thermistor monitoring (hot/cold profile), IINDPM (Input current limit), Input OVP, Power Path, USB D+/D-/BC1.2 integrated, USB OTG integrated | VQFN|24 | $1.520 | 1ku | 3.9 | 16 mm2: 4 x 4 (VQFN|24)
BQ24192 | 1-cell, 4.5-A, I2C controlled buck battery charger with NVDC Power Path & default pre charge current | =HYPERLINK("https://www.ti.com/product/BQ24192/samplebuy","Ordering & quality") | 471,531 | 1 | 4.5 | 17 | --- | Li-Ion/Li-Polymer | 3.5 | 4.4 | 22 | Switch-Mode Buck | I2C | BAT temp thermistor monitoring (hot/cold profile), IINDPM (Input current limit), Input OVP, Power Path, USB OTG integrated | VQFN|24 | $1.420 | 1ku | 3.9 | 16 mm2: 4 x 4 (VQFN|24)
BQ24192I | 1-cell, 4.5-A, I2C controlled buck battery charger with NVDC Power Path | =HYPERLINK("https://www.ti.com/product/BQ24192I/samplebuy","Ordering & quality") | 0 | 1 | 4.5 | 17 | --- | Li-Ion/Li-Polymer | 3.5 | 4.4 | 22 | Switch-Mode Buck | I2C | BAT temp thermistor monitoring (hot/cold profile), IINDPM (Input current limit), Input OVP, Power Path, USB OTG integrated | VQFN|24 | $1.520 | 1ku | 3.9 | 16 mm2: 4 x 4 (VQFN|24)
BQ24193 | I2C controlled 4.5A single cell USB/Adaptor charger w/ Narrow VDC Power Path and JEITA | =HYPERLINK("https://www.ti.com/product/BQ24193/samplebuy","Ordering & quality") | 456 | 1 | 4.5 | 17 | --- | Li-Ion/Li-Polymer | 3.5 | 4.4 | 22 | Switch-Mode Buck | I2C | BAT temp thermistor monitoring (JEITA profile), BAT temp thermistor monitoring (hot/cold profile), IINDPM (Input current limit), Input OVP, Power Path, USB D+/D-/BC1.2 integrated, USB OTG integrated | VQFN|24 | $1.520 | 1ku | 3.9 | 16 mm2: 4 x 4 (VQFN|24)
BQ24195 | I2C controlled 4.5A single cell charger with 5.1V, 2.1-A Synchronous boost Operation | =HYPERLINK("https://www.ti.com/product/BQ24195/samplebuy","Ordering & quality") | 9,895 | 1 | 4.5 | 17 | --- | Li-Ion/Li-Polymer | 3.5 | 4.4 | 22 | Switch-Mode Buck | I2C | BAT temp thermistor monitoring (hot/cold profile), IC thermal regulation, IINDPM (Input current limit), Input OVP, Power Path, USB D+/D-/BC1.2 integrated, USB OTG integrated, VINDPM (Input voltage threshold to maximize adaptor power) | VQFN|24 | $1.269 | 1ku | 3.9 | 16 mm2: 4 x 4 (VQFN|24)
BQ24195L | I2C controlled 2.5A single cell charger with 5.1V, 1-A Synchronous boost Operation | =HYPERLINK("https://www.ti.com/product/BQ24195L/samplebuy","Ordering & quality") | 90,605 | 1 | 2.5 | 17 | --- | Li-Ion/Li-Polymer | 3.5 | 4.4 | 22 | Switch-Mode Buck | I2C | BAT temp thermistor monitoring (hot/cold profile), IC thermal regulation, IINDPM (Input current limit), Power Path, USB D+/D-/BC1.2 integrated, USB OTG integrated | VQFN|24 | $1.220 | 1ku | 3.9 | 16 mm2: 4 x 4 (VQFN|24)
BQ24196 | I2C controlled 2.5A single cell USB/Adaptor charger w/ Narrow VDC Power Path | =HYPERLINK("https://www.ti.com/product/BQ24196/samplebuy","Ordering & quality") | 165,780 | 1 | 2.5 | 17 | --- | Li-Ion/Li-Polymer | 3.5 | 4.4 | 22 | Switch-Mode Buck | I2C | BAT temp thermistor monitoring (hot/cold profile), IC thermal regulation, IINDPM (Input current limit), Input OVP, Power Path, USB OTG integrated | VQFN|24 | $1.440 | 1ku | 3.9 | 16 mm2: 4 x 4 (VQFN|24)
BQ24230 | USB Friendly 0.5A Li-ion charger w/ Dynamic power Management, 6.6V OVP | =HYPERLINK("https://www.ti.com/product/BQ24230/samplebuy","Ordering & quality") | 0 | 1 | 0.5 | 6.4 | --- | Li-Ion/Li-Polymer | 4.2 | 4.2 | 28 | Linear | Standalone (RC-Settable) | BAT temp thermistor monitoring (hot/cold profile), Input OVP, Power Path, VINDPM (Input voltage threshold to maximize adaptor power) | VQFN|16 | $0.735 | 1ku | 4.35 | 9 mm2: 3 x 3 (VQFN|16)
BQ24232 | USB Friendly 0.5A Li-ion charger w/ Dynamic power Management, 10.5V OVP | =HYPERLINK("https://www.ti.com/product/BQ24232/samplebuy","Ordering & quality") | 236,540 | 1 | 0.5 | 10.2 | --- | Li-Ion/Li-Polymer | 4.2 | 4.2 | 28 | Linear | Standalone (RC-Settable) | BAT temp thermistor monitoring (hot/cold profile), Input OVP, Power Path, VINDPM (Input voltage threshold to maximize adaptor power) | VQFN|16 | $0.735 | 1ku | 4.35 | 9 mm2: 3 x 3 (VQFN|16)
BQ24232H | USB-Friendly Lithium Based battery charger With power-Path For 4.35V Batteries | =HYPERLINK("https://www.ti.com/product/BQ24232H/samplebuy","Ordering & quality") | 118,808 | 1 | 0.5 | 10.2 | --- | Li-Ion/Li-Polymer | 4.35 | 4.35 | 28 | Linear | Standalone (RC-Settable) | BAT temp thermistor monitoring (hot/cold profile), Input OVP, Power Path | VQFN|16 | $0.735 | 1ku | 4.35 | 9 mm2: 3 x 3 (VQFN|16)
BQ24232HA | USB Friendly 0.5A Li-ion charger with power-Path, 10.5V OVP | =HYPERLINK("https://www.ti.com/product/BQ24232HA/samplebuy","Ordering & quality") | 752,736 | 1 | 0.5 | 10.2 | --- | Li-Ion/Li-Polymer | 4.35 | 4.35 | 28 | Linear | Standalone (RC-Settable) | BAT temp thermistor monitoring (hot/cold profile), Input OVP, Power Path | VQFN|16 | $0.882 | 1ku | 4.35 | 9 mm2: 3 x 3 (VQFN|16)
BQ24250 | 1-cell, 2-A, I2C controlled buck battery charger with 1uA in SYSOFF mode and TS disable function | =HYPERLINK("https://www.ti.com/product/BQ24250/samplebuy","Ordering & quality") | 61,201 | 1 | 2 | 10.5 | --- | Li-Ion/Li-Polymer | 3.5 | 4.44 | 22 | Switch-Mode Buck | I2C | BAT temp thermistor monitoring (JEITA profile), BAT temp thermistor monitoring (hot/cold profile), IC thermal regulation, Integrated LDO, Power Path | DSBGA|30, VQFN|24 | $1.270 | 1ku | 4.35 | 6 mm2: 2.59 x 2.2 (DSBGA|30), 16 mm2: 4 x 4 (VQFN|24)
BQ24250C | 1-cell, 2-A, I2C controlled buck battery charger with 1uA in SYSOFF mode | =HYPERLINK("https://www.ti.com/product/BQ24250C/samplebuy","Ordering & quality") | 0 | 1 | 2 | 10.5 | --- | Li-Ion/Li-Polymer | 3.5 | 4.44 | 20 | Switch-Mode Buck | I2C, Standalone (RC-Settable) | BAT temp thermistor monitoring (JEITA profile), BAT temp thermistor monitoring (hot/cold profile), IC thermal regulation, Input OVP, Integrated LDO, Power Path | DSBGA|30 | $1.880 | 1ku | 4.35 | 6 mm2: 2.59 x 2.2 (DSBGA|30)
BQ24253 | 1-cell, 2-A, standalone buck Li-ion battery charger | =HYPERLINK("https://www.ti.com/product/BQ24253/samplebuy","Ordering & quality") | 69,330 | 1 | 2 | 10.5 | --- | Li-Ion/Li-Polymer | 3.5 | 4.44 | 22 | Switch-Mode Buck | Standalone (RC-Settable) | BAT temp thermistor monitoring (JEITA profile), BAT temp thermistor monitoring (hot/cold profile), IC thermal regulation, Input OVP, Integrated LDO, Power Path, USB D+/D-/BC1.2 integrated | DSBGA|30, VQFN|24 | $1.267 | 1ku | 4.35 | 6 mm2: 2.59 x 2.2 (DSBGA|30), 16 mm2: 4 x 4 (VQFN|24)
BQ24259 | I2C controlled 2A single cell USB NVDC-1 charger with adjustable voltageUSB OTG | =HYPERLINK("https://www.ti.com/product/BQ24259/samplebuy","Ordering & quality") | 84,706 | 1 | 2 | 6.2 | --- | Li-Ion/Li-Polymer | 3.5 | 4.44 | 15 | Switch-Mode Buck | I2C | BAT temp thermistor monitoring (hot/cold profile), IC thermal regulation, IINDPM (Input current limit), Input OVP, Power Path, USB OTG integrated | VQFN|24 | $0.810 | 1ku | 3.9 | 16 mm2: 4 x 4 (VQFN|24)
BQ24270 | 1-cell, 1.5-A, I2C controlled buck battery charger with Power Path management and D+/D- detection | =HYPERLINK("https://www.ti.com/product/BQ24270/samplebuy","Ordering & quality") | 15,480 | 1 | 1.5 | 6 | --- | Li-Ion/Li-Polymer | 3.5 | 4.44 | 20 | Switch-Mode Buck | I2C | BAT temp thermistor monitoring (JEITA profile), BAT temp thermistor monitoring (hot/cold profile), Input OVP, Power Path, USB D+/D-/BC1.2 integrated | DSBGA|49, VQFN|24 | $2.983 | 1ku | 4.2 | See datasheet (DSBGA), 16 mm2: 4 x 4 (VQFN|24)
BQ24271 | 1-cell, 1.5-A, I2C controlled buck battery charger with Power Path management | =HYPERLINK("https://www.ti.com/product/BQ24271/samplebuy","Ordering & quality") | 5,230 | 1 | 1.5 | 6 | --- | Li-Ion/Li-Polymer | 3.5 | 4.44 | 20 | Switch-Mode Buck | I2C | BAT temp thermistor monitoring (JEITA profile), BAT temp thermistor monitoring (hot/cold profile), Input OVP, Power Path | DSBGA|49, VQFN|24 | $2.983 | 1ku | 4.2 | See datasheet (DSBGA), 16 mm2: 4 x 4 (VQFN|24)
BQ24272 | 2.5A, Singe Input, Single Cell Switchmode Li-Ion BATTERY CHARGER with Power Path Management | =HYPERLINK("https://www.ti.com/product/BQ24272/samplebuy","Ordering & quality") | 0 | 1 | 2.5 | 10 | --- | Li-Ion/Li-Polymer | 3.5 | 4.44 | 20 | Switch-Mode Buck | I2C | BAT temp thermistor monitoring (JEITA profile), Input OVP, Power Path | DSBGA|49, VQFN|24 | $4.200 | 1ku | 4.2 | See datasheet (DSBGA), 16 mm2: 4 x 4 (VQFN|24)
BQ24278 | 2.5A, Single-Input, Single Cell Switchmode Li-Ion BATTERY CHARGER with Power Path Management | =HYPERLINK("https://www.ti.com/product/BQ24278/samplebuy","Ordering & quality") | 0 | 1 | 2.5 | 10 | --- | Li-Ion/Li-Polymer | 4.2 | 4.2 | 20 | Switch-Mode Buck | I2C | BAT temp thermistor monitoring (hot/cold profile), Power Path, USB OTG integrated | DSBGA|49, VQFN|24 | $4.200 | 1ku | 4.2 | See datasheet (DSBGA), 16 mm2: 4 x 4 (VQFN|24)
BQ24292I | I2C controlled 4.5A single-cell USB/Adapter charger With Narrow VDC Power Path Management | =HYPERLINK("https://www.ti.com/product/BQ24292I/samplebuy","Ordering & quality") | 33,021 | 1 | 4.5 | 17 | --- | Li-Ion/Li-Polymer | 3.5 | 4.44 | 20 | Switch-Mode Buck | I2C | BAT temp thermistor monitoring (hot/cold profile), IC thermal regulation, IINDPM (Input current limit), Input OVP, Power Path, USB OTG integrated | VQFN|24 | $2.264 | 1ku | 3.9 | 16 mm2: 4 x 4 (VQFN|24)
BQ24295 | I2C controlled 1-cell, 3-A battery charger with USB, adjustable voltage, and 1.5A OTG | =HYPERLINK("https://www.ti.com/product/BQ24295/samplebuy","Ordering & quality") | 0 | 1 | 3 | 6.2 | --- | Li-Ion/Li-Polymer | 3.5 | 4.44 | 15 | Switch-Mode Buck | I2C | BAT temp thermistor monitoring (hot/cold profile), IC thermal regulation, IINDPM (Input current limit), Input OVP, Power Path, USB D+/D-/BC1.2 integrated, USB OTG integrated | VQFN|24 | $0.880 | 1ku | 3.9 | 16 mm2: 4 x 4 (VQFN|24)
BQ24296 | 1-cell, 3-A, I2C controlled buck charger with adjustable voltage & USB OTG and min system regulation | =HYPERLINK("https://www.ti.com/product/BQ24296/samplebuy","Ordering & quality") | 0 | 1 | 3 | 6.2 | --- | Li-Ion/Li-Polymer | 3.5 | 4.44 | 15 | Switch-Mode Buck | I2C | BAT temp thermistor monitoring (hot/cold profile), IC thermal regulation, IINDPM (Input current limit), Input OVP, Power Path, USB OTG integrated | VQFN|24 | $1.440 | 1ku | 3.9 | 16 mm2: 4 x 4 (VQFN|24)
BQ24296M | 1-cell, 3-A, I2C controlled buck charger with USB OTG and min system regulation | =HYPERLINK("https://www.ti.com/product/BQ24296M/samplebuy","Ordering & quality") | 6,000 | 1 | 3 | 6.2 | --- | Li-Ion/Li-Polymer | 3.5 | 4.44 | 15 | Switch-Mode Buck | I2C | BAT temp thermistor monitoring (hot/cold profile), IC thermal regulation, Input OVP, Power Path, USB OTG integrated | VQFN|24 | $1.440 | 1ku | 3.9 | 16 mm2: 4 x 4 (VQFN|24)
BQ24297 | I2C controlled 1-cell, 3-A battery charger with USB NVDC-1, adj. voltage, and USB OTG with D+/D- | =HYPERLINK("https://www.ti.com/product/BQ24297/samplebuy","Ordering & quality") | 99 | 1 | 3 | 6.2 | --- | Li-Ion/Li-Polymer | 3.5 | 4.44 | 15 | Switch-Mode Buck | I2C | BAT temp thermistor monitoring (hot/cold profile), IC thermal regulation, IINDPM (Input current limit), Input OVP, Power Path, USB D+/D-/BC1.2 integrated, USB OTG integrated | VQFN|24 | $1.440 | 1ku | 3.9 | 16 mm2: 4 x 4 (VQFN|24)
BQ24298 | I2C controlled single cell 3A USB charger with NVDC Power Path and adjustable voltageUSB OTG | =HYPERLINK("https://www.ti.com/product/BQ24298/samplebuy","Ordering & quality") | 0 | 1 | 3 | 6.2 | --- | Li-Ion/Li-Polymer | 3.5 | 4.44 | 15 | Switch-Mode Buck | I2C | BAT temp thermistor monitoring (hot/cold profile), IC thermal regulation, IINDPM (Input current limit), Input OVP, Power Path, USB OTG integrated | WQFN|24 | $1.440 | 1ku | 3.9 | 16 mm2: 4 x 4 (WQFN|24)
BQ24600 | Standalone 1-6 cell Buck battery charge controller | =HYPERLINK("https://www.ti.com/product/BQ24600/samplebuy","Ordering & quality") | 99,848 | 1, 2, 3, 4, 5, 6 | 10 | 28 | --- | Li-Ion/Li-Polymer | 2.1 | 26 | 33 | Switch-Mode Buck | Standalone (RC-Settable) | BAT temp thermistor monitoring (hot/cold profile), Power Path | VQFN|16 | $1.890 | 1ku | 5 | 12 mm2: 3.5 x 3.5 (VQFN|16)
BQ24610 | Standalone 1-6 cell Buck battery charge controller with 5V-28V input | =HYPERLINK("https://www.ti.com/product/BQ24610/samplebuy","Ordering & quality") | 530 | 1, 2, 3, 4, 5, 6 | 10 | 28 | Functional Safety-Capable | Li-Ion/Li-Polymer | 2.1 | 26 | 33 | Switch-Mode Buck | Standalone (RC-Settable) | BAT temp thermistor monitoring (hot/cold profile), IINDPM (Input current limit), Input OVP, Power Path | VQFN|24 | $1.890 | 1ku | 5 | 16 mm2: 4 x 4 (VQFN|24)
BQ24616 | Standalone 1-6 cell Buck battery charge controller with JEITA compliance | =HYPERLINK("https://www.ti.com/product/BQ24616/samplebuy","Ordering & quality") | 0 | 1, 2, 3, 4, 5, 6 | 10 | 28 | --- | Li-Ion/Li-Polymer | 2.1 | 26 | 33 | Switch-Mode Buck | Standalone (RC-Settable) | BAT temp thermistor monitoring (JEITA profile), IINDPM (Input current limit), Power Path | VQFN|24 | $1.890 | 1ku | 5 | 16 mm2: 4 x 4 (VQFN|24)
BQ24617 | Standalone 1-5 cell Buck battery charge controller with 5V-24V input | =HYPERLINK("https://www.ti.com/product/BQ24617/samplebuy","Ordering & quality") | 0 | 1, 2, 3, 4, 5 | 10 | 24 | --- | Li-Ion/Li-Polymer | 2.1 | 22 | 33 | Switch-Mode Buck | Standalone (RC-Settable) | BAT temp thermistor monitoring (hot/cold profile), IINDPM (Input current limit), Power Path | VQFN|24 | $2.218 | 1ku | 5 | 16 mm2: 4 x 4 (VQFN|24)
BQ24618 | Standalone 1-6 cell Buck battery charge controller USB friendly with 5V-28V input | =HYPERLINK("https://www.ti.com/product/BQ24618/samplebuy","Ordering & quality") | 14,748 | 1, 2, 3, 4, 5, 6 | 10 | 28 | --- | Li-Ion/Li-Polymer | 2.1 | 26 | 33 | Switch-Mode Buck | Standalone (RC-Settable) | BAT temp thermistor monitoring (hot/cold profile), IINDPM (Input current limit), Power Path | VQFN|24 | $2.218 | 1ku | 4.7 | 16 mm2: 4 x 4 (VQFN|24)
BQ24707 | SMBus 1-4 cell Buck battery charge controller with independent comparator and circuit protection | =HYPERLINK("https://www.ti.com/product/BQ24707/samplebuy","Ordering & quality") | 67,546 | 1, 2, 3, 4 | 8 | 24 | --- | Li-Ion/Li-Polymer | 1.024 | 19.2 | 30 | Switch-Mode Buck | SMBus | Input OVP, Power Path | VQFN|20 | $2.948 | 1ku | 4.5 | 12 mm2: 3.5 x 3.5 (VQFN|20)
BQ24707A | 1-4 cell Li-ion battery charge controller with independent comparator and advanced circuit prot. | =HYPERLINK("https://www.ti.com/product/BQ24707A/samplebuy","Ordering & quality") | 40,670 | 1, 2, 3, 4 | 10 | 24 | --- | Li-Ion/Li-Polymer | 1.024 | 19.2 | 30 | Switch-Mode Buck | SMBus | Input OVP, Power Path | VQFN|20 | $2.807 | 1ku | 4.5 | 12 mm2: 3.5 x 3.5 (VQFN|20)
BQ24725A | SMBus 1-4 cell Buck battery charge controller with N-Channel power MOSFET selector | =HYPERLINK("https://www.ti.com/product/BQ24725A/samplebuy","Ordering & quality") | 27,720 | 1, 2, 3, 4 | 8 | 24 | --- | Li-Ion/Li-Polymer | 1.024 | 19.2 | 30 | Switch-Mode Buck | SMBus | Input OVP, Power Path | VQFN|20 | $1.575 | 1ku | 4.5 | 12 mm2: 3.5 x 3.5 (VQFN|20)
BQ24770 | SMBus 1-4 cell NVDC Buck battery charge controller with system monitor & processor hot indicator | =HYPERLINK("https://www.ti.com/product/BQ24770/samplebuy","Ordering & quality") | 72,000 | 1, 2, 3, 4 | 8 | 24 | --- | Li-Ion/Li-Polymer, Lithium Phosphate/LiFePO4 | 1.024 | 19.2 | 30 | Switch-Mode Buck | SMBus | IINDPM (Input current limit), Input OVP, Power Path | WQFN|28 | $1.638 | 1ku | 4.5 | 16 mm2: 4 x 4 (WQFN|28)
BQ24773 | I2C 1-4 cell NVDC Buck battery charge controller with system monitor & processor hot indicator | =HYPERLINK("https://www.ti.com/product/BQ24773/samplebuy","Ordering & quality") | 159,868 | 1, 2, 3, 4 | 8 | 24 | --- | Li-Ion/Li-Polymer, Lithium Phosphate/LiFePO4 | 1.024 | 19.2 | 30 | Switch-Mode Buck | I2C | IINDPM (Input current limit), Input OVP, Power Path | WQFN|28 | $1.733 | 1ku | 4.5 | 16 mm2: 4 x 4 (WQFN|28)
BQ24780S | SMBus 1-4 cell Buck battery charge controller to support hybrid power boost mode | =HYPERLINK("https://www.ti.com/product/BQ24780S/samplebuy","Ordering & quality") | 36,934 | 1, 2, 3, 4 | 8.128 | 24 | --- | Lead Acid, Li-Ion/Li-Polymer, Lithium Phosphate/LiFePO4, NiCd, NiMH | 1.024 | 19.2 | 30 | Switch-Mode Buck | SMBus | IC thermal regulation, Input OVP, Power Path, VINDPM (Input voltage threshold to maximize adaptor power) | WQFN|28 | $1.155 | 1ku | 4.5 | 16 mm2: 4 x 4 (WQFN|28)
BQ24800 | SMBus 1-4 cell Buck battery charge controller to support hybrid power boost and battery boost mode | =HYPERLINK("https://www.ti.com/product/BQ24800/samplebuy","Ordering & quality") | 536,039 | 1, 2, 3, 4 | 8.128 | 24 | --- | Lead Acid, Li-Ion/Li-Polymer, Lithium Phosphate/LiFePO4, NiCd, NiMH | 1.024 | 19.2 | 30 | Switch-Mode Buck | SMBus | IC thermal regulation, Input OVP, Power Path, VINDPM (Input voltage threshold to maximize adaptor power) | WQFN|28 | $2.100 | 1ku | 4.5 | 16 mm2: 4 x 4 (WQFN|28)
BQ25050 | 1-cell, 1-A, single input, Li-ion battery charger with 50-mA LDO | =HYPERLINK("https://www.ti.com/product/BQ25050/samplebuy","Ordering & quality") | 407,497 | 1 | 1 | 10.2 | --- | Li-Ion/Li-Polymer | 4.2 | 4.2 | 30 | Linear | Standalone (RC-Settable) | IC thermal regulation, Input OVP, Integrated LDO, Power Path, VINDPM (Input voltage threshold to maximize adaptor power) | WSON|10 | $0.554 | 1ku | 4.4 | 6 mm2: 3 x 2 (WSON|10)
BQ25060 | 1-cell, 1-A, Li-ion battery charger with 50-mA LDO | =HYPERLINK("https://www.ti.com/product/BQ25060/samplebuy","Ordering & quality") | 92,118 | 1 | 1 | 10.2 | --- | Li-Ion/Li-Polymer | 4.2 | 4.2 | 30 | Linear | Standalone (RC-Settable) | IC thermal regulation, Input OVP, Integrated LDO, Power Path, VINDPM (Input voltage threshold to maximize adaptor power) | WSON|10 | $0.562 | 1ku | 4.4 | 6 mm2: 3 x 2 (WSON|10)
BQ25120A | 300-mA linear battery charger with Power Path, integrated LDO and buck converter 1.8V default output | =HYPERLINK("https://www.ti.com/product/BQ25120A/samplebuy","Ordering & quality") | 36,125 | 1 | 0.3 | 5.5 | --- | Li-Ion/Li-Polymer, Lithium Phosphate/LiFePO4 | 3.6 | 4.65 | 20 | Linear | I2C | BAT temp thermistor monitoring (JEITA profile), IC thermal regulation, Input OVP, Integrated LDO, Integrated buck converter, Power Path, VINDPM (Input voltage threshold to maximize adaptor power) | DSBGA|25 | $1.470 | 1ku | 3.4 | See datasheet (DSBGA)
BQ25120F3A | 700-nA low IQ highly integrated battery charge management solution | =HYPERLINK("https://www.ti.com/product/BQ25120F3A/samplebuy","Ordering & quality") | 41,010 | 1 | 0.3 | 5.5 | --- | Li-Ion/Li-Polymer, Lithium Phosphate/LiFePO4 | 3.6 | 4.65 | 20 | Linear | I2C | BAT temp thermistor monitoring (JEITA profile), IC thermal regulation, Input OVP, Integrated LDO, Integrated buck converter, Power Path, VINDPM (Input voltage threshold to maximize adaptor power) | DSBGA|25 | $1.470 | 1ku | 3.4 | See datasheet (DSBGA)
BQ25121A | 300-mA linear battery charger with Power Path, integrated LDO and buck converter 2.5V default output | =HYPERLINK("https://www.ti.com/product/BQ25121A/samplebuy","Ordering & quality") | 7,250 | 1 | 0.3 | 5.5 | --- | Li-Ion/Li-Polymer | 3.6 | 4.65 | 20 | Linear | I2C | BAT temp thermistor monitoring (JEITA profile), IC thermal regulation, Input OVP, Integrated LDO, Integrated buck converter, Power Path | DSBGA|25 | $1.470 | 1ku | 3.4 | See datasheet (DSBGA)
BQ25122 | 300-mA linear battery charger with Power Path, integrated LDO and buck converter 1.2V default output | =HYPERLINK("https://www.ti.com/product/BQ25122/samplebuy","Ordering & quality") | 26,332 | 1 | 0.3 | 5.5 | --- | Li-Ion/Li-Polymer | 3.6 | 4.65 | 20 | Linear | I2C | BAT temp thermistor monitoring (JEITA profile), IC thermal regulation, Input OVP, Integrated LDO, Integrated buck converter, Power Path | DSBGA|25 | $1.470 | 1ku | 3.4 | See datasheet (DSBGA)
BQ25123 | 700-nA, low-IQ, highly integrated battery charge management solution | =HYPERLINK("https://www.ti.com/product/BQ25123/samplebuy","Ordering & quality") | 2,485 | 1 | 0.3 | 5.5 | --- | Li-Ion/Li-Polymer, Lithium Phosphate/LiFePO4 | 3.6 | 4.65 | 20 | Linear | I2C | BAT temp thermistor monitoring (JEITA profile), IC thermal regulation, Input OVP, Integrated LDO, Integrated buck converter, Power Path | DSBGA|25 | $1.400 | 1ku | 3.4 | See datasheet (DSBGA)
BQ25125 | Low IQ highly integrated battery charge management solution for wearables and IoT | =HYPERLINK("https://www.ti.com/product/BQ25125/samplebuy","Ordering & quality") | 500 | 1 | 0.3 | 5.5 | --- | Li-Ion/Li-Polymer | 3.6 | 4.65 | 20 | Linear | I2C | BAT temp thermistor monitoring (JEITA profile), IC thermal regulation, Input OVP, Integrated LDO, Integrated buck converter, Power Path | DSBGA|25 | $1.470 | 1ku | 3.4 | See datasheet (DSBGA)
BQ25150 | I2C controlled 500-mA linear battery charger with Power Path, Low Iq, integrated LDO and 16-bit ADC | =HYPERLINK("https://www.ti.com/product/BQ25150/samplebuy","Ordering & quality") | 0 | 1 | 0.5 | 5.5 | --- | Li-Ion/Li-Polymer | 3.6 | 4.6 | 20 | Linear | I2C | BAT temp thermistor monitoring (JEITA profile), BAT temp thermistor monitoring (hot/cold profile), IC thermal regulation, Input OVP, Integrated ADC, Integrated LDO, Power Path, VINDPM (Input voltage threshold to maximize adaptor power) | DSBGA|20 | $1.331 | 1ku | 3.4 | 4 mm2: 2.2 x 1.8 (DSBGA|20)
BQ25155 | 500-mA 1-cell linear charger with 10-nA IQ, power path, regulated system voltage, 16-bit ADC and LDO | =HYPERLINK("https://www.ti.com/product/BQ25155/samplebuy","Ordering & quality") | 0 | 1 | 0.5 | 5.5 | --- | Li-Ion/Li-Polymer, Lithium Phosphate/LiFePO4 | 3.6 | 4.6 | 20 | Linear | I2C | BAT temp thermistor monitoring (JEITA profile), BAT temp thermistor monitoring (hot/cold profile), IC thermal regulation, Input OVP, Integrated ADC, Integrated LDO, Power Path | DSBGA|20 | $1.109 | 1ku | 3.4 | 4 mm2: 2.2 x 1.8 (DSBGA|20)
BQ25157 | 500-mA 1-cell linear charger with 10-nA IQ, power path, regulated system voltage, 16-bit ADC and LDO | =HYPERLINK("https://www.ti.com/product/BQ25157/samplebuy","Ordering & quality") | 0 | 1 | 0.5 | 6.1 | --- | Li-Ion/Li-Polymer, Lithium Phosphate/LiFePO4 | 3.6 | 4.6 | 20 | Linear | I2C | BAT temp thermistor monitoring (JEITA profile), BAT temp thermistor monitoring (hot/cold profile), IC thermal regulation, Input OVP, Integrated ADC, Integrated LDO, Power Path | DSBGA|20 | $1.110 | 1ku | 3.4 | 4 mm2: 2.2 x 1.8 (DSBGA|20)
BQ25180 | 1-A Li-ion I²C programmable charger with regulated power path in WCSP package | =HYPERLINK("https://www.ti.com/product/BQ25180/samplebuy","Ordering & quality") | 1,757,358 | 1 | 1 | 5.5 | --- | Li-Ion/Li-Polymer, Lithium Phosphate/LiFePO4 | 3.6 | 4.65 | 25 | Linear | I2C | BAT temp thermistor monitoring (JEITA profile), IC thermal regulation, IINDPM (Input current limit), Input OVP, Power Path, VINDPM (Input voltage threshold to maximize adaptor power) | DSBGA|8 | $0.890 | 1ku | 3 | 1 mm2: .8 x 1.2 (DSBGA|8)
BQ25181 | I²C programmable, 1-A, 1-cell, Li-ion linear battery charger with power path in a QFN package | =HYPERLINK("https://www.ti.com/product/BQ25181/samplebuy","Ordering & quality") | 0 | 1 | 1 | 5.5 | --- | Li-Ion/Li-Polymer, Lithium Phosphate/LiFePO4 | 3.6 | 4.65 | 25 | Linear | I2C | BAT temp thermistor monitoring (JEITA profile), IC thermal regulation, IINDPM (Input current limit), Input OVP, Power Path, VINDPM (Input voltage threshold to maximize adaptor power) | WSON|10 | $1.176 | 1ku | 3 | 4 mm2: 2 x 2.2 (WSON|10)
BQ25600 | I2C 1cell 3A Buck battery charger with power path and OTG in WCSP | =HYPERLINK("https://www.ti.com/product/BQ25600/samplebuy","Ordering & quality") | 31,219 | 1 | 3 | 13.5 | --- | Li-Ion/Li-Polymer | 3.85 | 4.62 | 22 | Switch-Mode Buck | I2C | BAT temp thermistor monitoring (JEITA profile), IINDPM (Input current limit), Input OVP, Power Path, USB OTG integrated, VINDPM (Input voltage threshold to maximize adaptor power) | DSBGA|30 | $1.256 | 1ku | 3.9 | 6 mm2: 2.59 x 2.2 (DSBGA|30)
BQ25600C | I2C 1cell 3A Buck battery charger for Parallel Charging Applications | =HYPERLINK("https://www.ti.com/product/BQ25600C/samplebuy","Ordering & quality") | 50,255 | 1 | 3 | 13.5 | --- | Li-Ion/Li-Polymer | 3.856 | 4.624 | 22 | Switch-Mode Buck | I2C | IC thermal regulation, IINDPM (Input current limit), Input OVP, Power Path, VINDPM (Input voltage threshold to maximize adaptor power) | DSBGA|30 | $1.256 | 1ku | 3.9 | 6 mm2: 2.59 x 2.2 (DSBGA|30)
BQ25600D | I2C 1cell 3A Buck battery charger with power path, USB detection and OTG in WCSP | =HYPERLINK("https://www.ti.com/product/BQ25600D/samplebuy","Ordering & quality") | 0 | 1 | 3 | 13.5 | --- | Li-Ion/Li-Polymer | 3.85 | 4.62 | 22 | Switch-Mode Buck | I2C | BAT temp thermistor monitoring (JEITA profile), IC thermal regulation, IINDPM (Input current limit), Input OVP, Power Path, USB D+/D-/BC1.2 integrated, USB OTG integrated, VINDPM (Input voltage threshold to maximize adaptor power) | DSBGA|30 | $1.256 | 1ku | 3.9 | 6 mm2: 2.59 x 2.2 (DSBGA|30)
BQ25601 | I2C 1cell 3A Buck battery charger with power path and OTG | =HYPERLINK("https://www.ti.com/product/BQ25601/samplebuy","Ordering & quality") | 9,649 | 1 | 3 | 13.5 | --- | Li-Ion/Li-Polymer | 3.85 | 4.62 | 20 | Switch-Mode Buck | I2C | BAT temp thermistor monitoring (JEITA profile), IC thermal regulation, IINDPM (Input current limit), Input OVP, Power Path, USB OTG integrated, VINDPM (Input voltage threshold to maximize adaptor power) | WQFN|24 | $1.256 | 1ku | 3.9 | 16 mm2: 4 x 4 (WQFN|24)
BQ25601D | I2C 1cell 3A Buck battery charger with power path, USB detection and OTG | =HYPERLINK("https://www.ti.com/product/BQ25601D/samplebuy","Ordering & quality") | 456,505 | 1 | 3 | 13.5 | --- | Li-Ion/Li-Polymer | 3.85 | 4.62 | 20 | Switch-Mode Buck | I2C | BAT temp thermistor monitoring (JEITA profile), IC thermal regulation, Input OVP, Power Path, USB D+/D-/BC1.2 integrated, USB OTG integrated, VINDPM (Input voltage threshold to maximize adaptor power) | WQFN|24 | $1.310 | 1ku | 3.9 | 16 mm2: 4 x 4 (WQFN|24)
BQ25606 | Stand Alone 1cell 3A Fast charger with High input voltage and Power Path | =HYPERLINK("https://www.ti.com/product/BQ25606/samplebuy","Ordering & quality") | 39,590 | 1 | 3 | 13.5 | --- | Li-Ion/Li-Polymer | 4.2 | 4.4 | 20 | Switch-Mode Buck | Standalone (RC-Settable) | BAT temp thermistor monitoring (JEITA profile), IC thermal regulation, IINDPM (Input current limit), Input OVP, Power Path, USB D+/D-/BC1.2 integrated, USB OTG integrated, VINDPM (Input voltage threshold to maximize adaptor power) | VQFN|24 | $1.210 | 1ku | 3.9 | 16 mm2: 4 x 4 (VQFN|24)
BQ25611D | I2C controlled 1-cell 3-A buck battery charger with USB detection and 1.2-A boost operation | =HYPERLINK("https://www.ti.com/product/BQ25611D/samplebuy","Ordering & quality") | 4,266 | 1 | 3 | 13.5 | --- | Li-Ion/Li-Polymer, Lithium Phosphate/LiFePO4 | 3.5 | 4.52 | 22 | Switch-Mode Buck | I2C | BAT temp thermistor monitoring (hot/cold profile), Input OVP, Power Path, USB OTG integrated, VINDPM (Input voltage threshold to maximize adaptor power) | WQFN|24 | $1.390 | 1ku | 3.9 | 16 mm2: 4 x 4 (WQFN|24)
BQ25616 | Standalone 1-cell 3.0-A buck battery charger with power path and 1.2-A boost operation | =HYPERLINK("https://www.ti.com/product/BQ25616/samplebuy","Ordering & quality") | 24,535 | 1 | 3 | 13.5 | --- | Li-Ion/Li-Polymer | 4.1 | 4.35 | 22 | Switch-Mode Buck | Standalone (RC-Settable) | BAT temp thermistor monitoring (hot/cold profile), IC thermal regulation, IINDPM (Input current limit), Input OVP, Power Path, USB OTG integrated, VINDPM (Input voltage threshold to maximize adaptor power) | WQFN|24 | $1.090 | 1ku | 3.9 | 16 mm2: 4 x 4 (WQFN|24)
BQ25618 | I2C controlled 1.5-A single cell buck battery charger with 20-mA termination and 1-A boost in WCSP | =HYPERLINK("https://www.ti.com/product/BQ25618/samplebuy","Ordering & quality") | 29,360 | 1 | 1.5 | 13.5 | --- | Li-Ion/Li-Polymer, Lithium Phosphate/LiFePO4 | 3.5 | 4.52 | 22 | Switch-Mode Buck | I2C | BAT temp thermistor monitoring (JEITA profile), IC thermal regulation, IINDPM (Input current limit), Input OVP, Power Path, USB OTG integrated, VINDPM (Input voltage threshold to maximize adaptor power) | DSBGA|30 | $1.470 | 1ku | 3.9 | 6 mm2: 2.59 x 2.2 (DSBGA|30)
BQ25618E | I2C controlled 1.5-A single cell buck battery charger with 20-mA termination | =HYPERLINK("https://www.ti.com/product/BQ25618E/samplebuy","Ordering & quality") | 110,460 | 1 | 1.5 | 13.5 | --- | Li-Ion/Li-Polymer, Lithium Phosphate/LiFePO4 | 3.5 | 4.52 | 22 | Switch-Mode Buck | I2C | BAT temp thermistor monitoring (JEITA profile), IC thermal regulation, IINDPM (Input current limit), Input OVP, Power Path, VINDPM (Input voltage threshold to maximize adaptor power) | DSBGA|30 | $1.090 | 1ku | 3.9 | 6 mm2: 2.59 x 2.2 (DSBGA|30)
BQ25619 | I2C controlled 1.5-A single cell buck battery charger with 20-mA termination and 1-A boost | =HYPERLINK("https://www.ti.com/product/BQ25619/samplebuy","Ordering & quality") | 579,831 | 1 | 1.5 | 13.5 | --- | Li-Ion/Li-Polymer, Lithium Phosphate/LiFePO4 | 3.5 | 4.52 | 22 | Switch-Mode Buck | I2C | BAT temp thermistor monitoring (JEITA profile), IC thermal regulation, IINDPM (Input current limit), Input OVP, Power Path, USB OTG integrated, VINDPM (Input voltage threshold to maximize adaptor power) | WQFN|24 | $1.470 | 1ku | 3.9 | 16 mm2: 4 x 4 (WQFN|24)
BQ25619E | I2C controlled 1-cell, 1.5-A, battery charger with 20-mA termination | =HYPERLINK("https://www.ti.com/product/BQ25619E/samplebuy","Ordering & quality") | 400 | 1 | 1.5 | 13.5 | --- | Li-Ion/Li-Polymer, Lithium Phosphate/LiFePO4 | 3.5 | 4.52 | 22 | Switch-Mode Buck | I2C | BAT temp thermistor monitoring (JEITA profile), IC thermal regulation, IINDPM (Input current limit), Input OVP, Power Path, VINDPM (Input voltage threshold to maximize adaptor power) | WQFN|24 | $1.090 | 1ku | 3.9 | 16 mm2: 4 x 4 (WQFN|24)
BQ25620 | I²C controlled 1-cell 3.5-A buck battery charger with 18-V max input, integrated ADC and OTG output | =HYPERLINK("https://www.ti.com/product/BQ25620/samplebuy","Ordering & quality") | 0 | 1 | 3.5 | 18 | --- | Li-Ion/Li-Polymer, Lithium Phosphate/LiFePO4 | 3.5 | 4.8 | 26 | Switch-Mode Buck | I2C | BAT temp thermistor monitoring (JEITA profile), IINDPM (Input current limit), Input OVP, Integrated ADC, Integrated LDO, Power Path, USB C/PD compatible, USB OTG integrated, VINDPM (Input voltage threshold to maximize adaptor power) | WQFN-HR|18 | $1.460 | 1ku | 3.9 | 8 mm2: 3 x 2.5 (WQFN-HR|18)
BQ25672 | I²C controlled, 1- to 4-cell, 3-A buck battery charger with dual-input selector and integrated ADC | =HYPERLINK("https://www.ti.com/product/BQ25672/samplebuy","Ordering & quality") | 0 | 1, 2, 3, 4 | 3 | 24 | --- | Li-Ion/Li-Polymer, Lithium Phosphate/LiFePO4 | 3 | 18.8 | 30 | Switch-Mode Buck | I2C | BAT temp thermistor monitoring (JEITA profile), BAT temp thermistor monitoring (hot/cold profile), IC thermal regulation, ICO (Input Current Optimization), IINDPM (Input current limit), Input OVP, Integrated ADC, Power Path, USB OTG integrated, VINDPM (Input voltage threshold to maximize adaptor power) | VQFN-HR|29 | $1.600 | 1ku | 6 | 16 mm2: 4 x 4 (VQFN-HR|29)
BQ25700A | SMBus 1-4 cell NVDC Buck-Boost battery charge controller with system power monitor & processor | =HYPERLINK("https://www.ti.com/product/BQ25700A/samplebuy","Ordering & quality") | 0 | 1, 2, 3, 4 | 8.128 | 24 | --- | Lead Acid, Li-Ion/Li-Polymer, Lithium Phosphate/LiFePO4, NiCd, NiMH, SuperCap | 1.024 | 19.2 | 30 | Switch-Mode Buck-boost | SMBus | IC thermal regulation, ICO (Input Current Optimization), IINDPM (Input current limit), Input OVP, Integrated ADC, Power Path, Solar input/MPPT, USB C/PD compatible, USB OTG integrated, VINDPM (Input voltage threshold to maximize adaptor power) | QFN|32 | $2.033 | 1ku | 3.5 | 16 mm2: 4 x 4 (QFN|32)
BQ25703A | I2C 1-4 cell NVDC Buck-Boost battery charge controller with system power monitor & processor | =HYPERLINK("https://www.ti.com/product/BQ25703A/samplebuy","Ordering & quality") | 0 | 1, 2, 3, 4 | 8.128 | 24 | --- | Lead Acid, Li-Ion/Li-Polymer, Lithium Phosphate/LiFePO4, NiCd, NiMH, SuperCap | 1.024 | 19.2 | 30 | Switch-Mode Buck-boost | I2C | IC thermal regulation, ICO (Input Current Optimization), IINDPM (Input current limit), Input OVP, Integrated ADC, Power Path, Solar input/MPPT, USB C/PD compatible, USB OTG integrated, VINDPM (Input voltage threshold to maximize adaptor power) | QFN|32 | $1.730 | 1ku | 3.5 | 16 mm2: 4 x 4 (QFN|32)
BQ25708 | SMBus Multi-Chemistry battery Buck-Boost charge controller | =HYPERLINK("https://www.ti.com/product/BQ25708/samplebuy","Ordering & quality") | 0 | 1, 2, 3, 4 | 8.128 | 24 | --- | Lead Acid, Li-Ion/Li-Polymer, Lithium Phosphate/LiFePO4, NiCd, NiMH | 1.024 | 19.2 | 30 | Switch-Mode Buck-boost | SMBus | BAT temp thermistor monitoring (hot/cold profile), IC thermal regulation, ICO (Input Current Optimization), IINDPM (Input current limit), Input OVP, Integrated ADC, Power Path, VINDPM (Input voltage threshold to maximize adaptor power) | QFN|32 | $1.940 | 1ku | 3.5 | 16 mm2: 4 x 4 (QFN|32)
BQ25710 | SMBus 1-4 cell Buck-Boost battery charge controller w/ system power monitor & processor hot monitor | =HYPERLINK("https://www.ti.com/product/BQ25710/samplebuy","Ordering & quality") | 3,945 | 1, 2, 3, 4 | 8.128 | 24 | --- | Lead Acid, Li-Ion/Li-Polymer, Lithium Phosphate/LiFePO4, NiCd, NiMH, SuperCap | 1.024 | 19.2 | 30 | Switch-Mode Buck-boost | SMBus | IC thermal regulation, ICO (Input Current Optimization), IINDPM (Input current limit), Input OVP, Integrated ADC, Power Path, Solar input/MPPT, USB C/PD compatible, USB OTG integrated, VINDPM (Input voltage threshold to maximize adaptor power) | QFN|32 | $2.171 | 1ku | 3.5 | 16 mm2: 4 x 4 (QFN|32)
BQ25713 | I2C 1-4 cell NVDC Buck-Boost battery charge controller with USB type C PD support | =HYPERLINK("https://www.ti.com/product/BQ25713/samplebuy","Ordering & quality") | 85,977 | 1, 2, 3, 4 | 8.128 | 24 | --- | Lead Acid, Li-Ion/Li-Polymer, Lithium Phosphate/LiFePO4, NiCd, NiMH, SuperCap | 1.024 | 19.2 | 30 | Switch-Mode Buck-boost | I2C | IC thermal regulation, ICO (Input Current Optimization), IINDPM (Input current limit), Input OVP, Integrated ADC, Power Path, Solar input/MPPT, USB C/PD compatible, USB OTG integrated, VINDPM (Input voltage threshold to maximize adaptor power) | QFN|32 | $1.700 | 1ku | 3.5 | 16 mm2: 4 x 4 (QFN|32)
BQ25713B | Address 2 I2C 1-4 cell NVDC Buck-Boost battery charge controller with USB type C PD support | =HYPERLINK("https://www.ti.com/product/BQ25713B/samplebuy","Ordering & quality") | 0 | 1, 2, 3, 4 | 8.128 | 24 | --- | Lead Acid, Li-Ion/Li-Polymer, Lithium Phosphate/LiFePO4, NiCd, NiMH, SuperCap | 1.024 | 19.2 | 30 | Switch-Mode Buck-boost | I2C | IC thermal regulation, ICO (Input Current Optimization), IINDPM (Input current limit), Input OVP, Integrated ADC, Power Path, Solar input/MPPT, USB C/PD compatible, USB OTG integrated, VINDPM (Input voltage threshold to maximize adaptor power) | QFN|32 | $1.700 | 1ku | 3.5 | 16 mm2: 4 x 4 (QFN|32)
BQ25720 | SMBus 1- to 4-cell NVDC buck-boost battery charge controller with power path and USB-C® PD OTG | =HYPERLINK("https://www.ti.com/product/BQ25720/samplebuy","Ordering & quality") | 0 | 1, 2, 3, 4 | 16.2 | 26 | --- | Lead Acid, Li-Ion/Li-Polymer, Lithium Phosphate/LiFePO4, NiCd, NiMH, SuperCap | 1.024 | 19.2 | 32 | Switch-Mode Buck-boost | SMBus | BAT temp thermistor monitoring (JEITA profile), BAT temp thermistor monitoring (hot/cold profile), IC thermal regulation, ICO (Input Current Optimization), IINDPM (Input current limit), Input OVP, Integrated ADC, Power Path, USB C/PD compatible, USB OTG integrated | QFN|32 | $1.510 | 1ku | 3.5 | 16 mm2: 4 x 4 (QFN|32)
BQ25723 | I²C 1-4 cell NVDC buck-boost battery charge controller with power path and USB-C® PD OTG | =HYPERLINK("https://www.ti.com/product/BQ25723/samplebuy","Ordering & quality") | 0 | 1, 2, 3, 4 | 16.2 | 26 | --- | Lead Acid, Li-Ion/Li-Polymer, Lithium Phosphate/LiFePO4, NiCd, NiMH, SuperCap | 1.024 | 19.2 | 32 | Switch-Mode Buck-boost | I2C | BAT temp thermistor monitoring (JEITA profile), BAT temp thermistor monitoring (hot/cold profile), IC thermal regulation, ICO (Input Current Optimization), IINDPM (Input current limit), Input OVP, Integrated ADC, Power Path, USB C/PD compatible, USB OTG integrated, VINDPM (Input voltage threshold to maximize adaptor power) | QFN|32 | $1.510 | 1ku | 3.5 | 16 mm2: 4 x 4 (QFN|32)
BQ25730 | I²C 1-5 cell NVDC buck-boost battery charge controller with power path and USB-C® PD OTG | =HYPERLINK("https://www.ti.com/product/BQ25730/samplebuy","Ordering & quality") | 0 | 1, 2, 3, 4, 5 | 16.2 | 26 | --- | Lead Acid, Li-Ion/Li-Polymer, Lithium Phosphate/LiFePO4, NiCd, NiMH, SuperCap | 1.024 | 23 | 32 | Switch-Mode Buck-boost | I2C | IC thermal regulation, ICO (Input Current Optimization), IINDPM (Input current limit), Input OVP, Integrated ADC, Power Path, USB C/PD compatible, USB OTG integrated, VINDPM (Input voltage threshold to maximize adaptor power) | QFN|32 | $1.470 | 1ku | 3.5 | 16 mm2: 4 x 4 (QFN|32)
BQ25790 | Integrated, NVDC, 5-A 1-cell to 4-cell switch-mode buck-boost battery charger | =HYPERLINK("https://www.ti.com/product/BQ25790/samplebuy","Ordering & quality") | 0 | 1, 2, 3, 4 | 5 | 24 | --- | Li-Ion/Li-Polymer, Lithium Phosphate/LiFePO4 | 3 | 18.8 | 30 | Switch-Mode Buck-boost | I2C | BAT temp thermistor monitoring (JEITA profile), IC thermal regulation, ICO (Input Current Optimization), IINDPM (Input current limit), Input OVP, Integrated ADC, Power Path, USB C/PD compatible, USB D+/D-/BC1.2 integrated, USB OTG integrated, VINDPM (Input voltage threshold to maximize adaptor power) | DSBGA|56 | $2.290 | 1ku | 3.6 | 10 mm2: 2.89 x 3.31 (DSBGA|56)
BQ25792 | I2C controlled, 5-A, 1-4 cell buck-boost charger with dual-input selector and USB PD 3.0 OTG output | =HYPERLINK("https://www.ti.com/product/BQ25792/samplebuy","Ordering & quality") | 0 | 1, 2, 3, 4 | 5 | 24 | --- | Li-Ion/Li-Polymer, Lithium Phosphate/LiFePO4 | 3 | 18.8 | 30 | Switch-Mode Buck-boost | I2C | BAT temp thermistor monitoring (JEITA profile), IC thermal regulation, ICO (Input Current Optimization), IINDPM (Input current limit), Input OVP, Integrated ADC, Power Path, USB C/PD compatible, USB D+/D-/BC1.2 integrated, USB OTG integrated, VINDPM (Input voltage threshold to maximize adaptor power) | VQFN-HR|29 | $2.520 | 1ku | 3.6 | 16 mm2: 4 x 4 (VQFN-HR|29)
BQ25798 | I²C controlled, 1-4-cell, 5-A buck-boost solar battery charger with dual-input selector and MPPT | =HYPERLINK("https://www.ti.com/product/BQ25798/samplebuy","Ordering & quality") | 0 | 1, 2, 3, 4 | 5 | 24 | --- | Li-Ion/Li-Polymer, Lithium Phosphate/LiFePO4 | 3 | 18.8 | 30 | Switch-Mode Buck-boost | I2C | BAT temp thermistor monitoring (JEITA profile), BAT temp thermistor monitoring (hot/cold profile), IC thermal regulation, ICO (Input Current Optimization), IINDPM (Input current limit), Input OVP, Integrated ADC, Integrated LDO, Power Path, Solar input/MPPT, USB C/PD compatible, USB D+/D-/BC1.2 integrated, USB OTG integrated, VINDPM (Input voltage threshold to maximize adaptor power) | VQFN-HR|29 | $2.290 | 1ku | 3.6 | 16 mm2: 4 x 4 (VQFN-HR|29)
BQ25890 | I2C 1cell 5A buck battery charger Maxcharge™ tech for high input with D+/D- | =HYPERLINK("https://www.ti.com/product/BQ25890/samplebuy","Ordering & quality") | 10,880 | 1 | 5 | 14 | --- | Li-Ion/Li-Polymer | 3.84 | 4.6 | 22 | Switch-Mode Buck | I2C | BAT temp thermistor monitoring (JEITA profile), BAT temp thermistor monitoring (hot/cold profile), IC thermal regulation, ICO (Input Current Optimization), IINDPM (Input current limit), Input OVP, Integrated ADC, Power Path, USB C/PD compatible, USB D+/D-/BC1.2 integrated, USB OTG integrated | WQFN|24 | $1.450 | 1ku | 3.9 | 16 mm2: 4 x 4 (WQFN|24)
BQ25890H | I2C 1cell 5A buck battery charger with NVDC Power Path and HVDCP | =HYPERLINK("https://www.ti.com/product/BQ25890H/samplebuy","Ordering & quality") | 15,429 | 1 | 5 | 14 | --- | Li-Ion/Li-Polymer | 3.84 | 4.6 | 22 | Switch-Mode Buck | I2C | BAT temp thermistor monitoring (JEITA profile), BAT temp thermistor monitoring (hot/cold profile), IC thermal regulation, ICO (Input Current Optimization), IINDPM (Input current limit), Input OVP, Power Path, USB D+/D-/BC1.2 integrated, USB OTG integrated | WQFN|24 | $1.450 | 1ku | 3.9 | 16 mm2: 4 x 4 (WQFN|24)
BQ25892 | I2C 1cell 5A buck battery charger with NVDC Power Path and PSEL | =HYPERLINK("https://www.ti.com/product/BQ25892/samplebuy","Ordering & quality") | 52,507 | 1 | 5 | 14 | --- | Li-Ion/Li-Polymer | 3.84 | 4.6 | 22 | Switch-Mode Buck | I2C | BAT temp thermistor monitoring (JEITA profile), BAT temp thermistor monitoring (hot/cold profile), IC thermal regulation, ICO (Input Current Optimization), IINDPM (Input current limit), Input OVP, Integrated ADC, Power Path, USB OTG integrated | WQFN|24 | $1.450 | 1ku | 3.9 | 16 mm2: 4 x 4 (WQFN|24)
BQ25895 | I2C 1cell 5A buck battery charger with high input voltage and 3.1-A boost with HVDCP enabled | =HYPERLINK("https://www.ti.com/product/BQ25895/samplebuy","Ordering & quality") | 15,225 | 1 | 5 | 14 | --- | Li-Ion/Li-Polymer | 3.84 | 4.6 | 22 | Switch-Mode Buck | I2C | BAT temp thermistor monitoring (hot/cold profile), IC thermal regulation, ICO (Input Current Optimization), IINDPM (Input current limit), Input OVP, Integrated ADC, Power Path, Solar input/MPPT, USB D+/D-/BC1.2 integrated, USB OTG integrated | WQFN|24 | $1.420 | 1ku | 3.9 | 16 mm2: 4 x 4 (WQFN|24)
BQ25895M | I2C 1cell 5A buck battery charger with 3.1-A boost and HVDCP | =HYPERLINK("https://www.ti.com/product/BQ25895M/samplebuy","Ordering & quality") | 13,331 | 1 | 5 | 14 | --- | Li-Ion/Li-Polymer | 3.84 | 4.6 | 22 | Switch-Mode Buck | I2C | BAT temp thermistor monitoring (hot/cold profile), IC thermal regulation, ICO (Input Current Optimization), IINDPM (Input current limit), Input OVP, Integrated ADC, Power Path, USB D+/D-/BC1.2 integrated, USB OTG integrated | WQFN|24 | $1.420 | 1ku | 3.9 | 16 mm2: 4 x 4 (WQFN|24)
BQ25896 | I2C 1cell 3A buck battery charger with power path and PSEL | =HYPERLINK("https://www.ti.com/product/BQ25896/samplebuy","Ordering & quality") | 8,070 | 1 | 3 | 14 | --- | Li-Ion/Li-Polymer | 3.84 | 4.6 | 22 | Switch-Mode Buck | I2C | BAT temp thermistor monitoring (JEITA profile), BAT temp thermistor monitoring (hot/cold profile), IC thermal regulation, ICO (Input Current Optimization), IINDPM (Input current limit), Input OVP, Integrated ADC, Power Path, USB OTG integrated | WQFN|24 | $1.620 | 1ku | 3.9 | 16 mm2: 4 x 4 (WQFN|24)
BQ25898 | I2C 1cell 4A buck battery charger with power path and MaxchargeTM for High input | =HYPERLINK("https://www.ti.com/product/BQ25898/samplebuy","Ordering & quality") | 0 | 1 | 4 | 14 | --- | Li-Ion/Li-Polymer | 3.84 | 4.6 | 22 | Switch-Mode Buck | I2C | BAT temp thermistor monitoring (JEITA profile), BAT temp thermistor monitoring (hot/cold profile), IC thermal regulation, ICO (Input Current Optimization), IINDPM (Input current limit), Input OVP, Integrated ADC, Power Path, USB D+/D-/BC1.2 integrated, USB OTG integrated | DSBGA|42 | $1.360 | 1ku | 3.9 | 7 mm2: 2.4 x 2.8 (DSBGA|42)
BQ25898C | I2C 1cell 3A buck battery charger for Parallel Charging Applications | =HYPERLINK("https://www.ti.com/product/BQ25898C/samplebuy","Ordering & quality") | 0 | 1 | 3 | 14 | --- | Li-Ion/Li-Polymer | 3.84 | 4.6 | 22 | Switch-Mode Buck | I2C | BAT temp thermistor monitoring (hot/cold profile), IC thermal regulation, IINDPM (Input current limit), Input OVP, Integrated ADC, Power Path | DSBGA|42 | $1.420 | 1ku | 3.9 | 7 mm2: 2.4 x 2.8 (DSBGA|42)
BQ25898D | I2C 1cell 4A buck battery charger with power path and HVDCP | =HYPERLINK("https://www.ti.com/product/BQ25898D/samplebuy","Ordering & quality") | 19,350 | 1 | 4 | 14 | --- | Li-Ion/Li-Polymer | 3.84 | 4.6 | 22 | Switch-Mode Buck | I2C | BAT temp thermistor monitoring (JEITA profile), BAT temp thermistor monitoring (hot/cold profile), IC thermal regulation, ICO (Input Current Optimization), IINDPM (Input current limit), Input OVP, Integrated ADC, Integrated buck converter, Power Path, USB D+/D-/BC1.2 integrated, USB OTG integrated | DSBGA|42 | $1.420 | 1ku | 3.9 | 7 mm2: 2.4 x 2.8 (DSBGA|42)
Part number | Description | Ordering & quality | TI.com inventory | Number of series cells | Charge current (Max) (A) | Operating Vin (Max) (V) | TI functional safety category | Cell chemistry | Battery charge voltage (Min) (V) | Battery charge voltage (Max) (V) | Absolute Vin (safety rating) (Max) ((V)) | Control topology | Control interface | Features | Package Group | Approx. price (USD) | Operating Vin (Min) (V) | Package size: mm2:W x L (PKG)

Sheet: Sheet3
Sharp Memory-in-Pixel LCDs |  |  |  |  |  | https://sharpdevices.com/memory-lcd/
ID | Size (mm) | Size (inch) | Res. H (px) | Res. V (px) | Reflectance (%) | Panel Type | Tmax (°C) | Tmin (°C) | CR (typ)
LS014B7DD01 (https://www.sharpsde.com/products/displays/model/ls012b7dd06a-1-1/) | 35.31 | 1.39 | 280 | 280 | 8.7 | VA | -20 | 70 | 25
LS013B7DD02 (https://www.sharpsde.com/products/displays/model/ls012b7dd06a-1/) | 32.77 | 1.29 | 260 | 260 | 8.7 | VA | -20 | 70 | 25
LS012B7DD06 (https://www.sharpsde.com/products/displays/model/ls012b7dd06/) | 30.23 | 1.19 | 240 | 240 | 7 | VA | -20 | 70 | 25
LS012B7DD06A (https://www.sharpsde.com/products/displays/model/ls012b7dd06a/) | 30.23 | 1.19 | 240 | 240 | 7 | VA | -20 | 70 | 25
LS010B7DH04 (https://www.sharpsde.com/products/displays/model/ls010b7dh04/) | 26.16 | 1.03 | 128 | 128 | 16 | TN | -20 | 70 | 20
LS013B7DH03 (https://www.sharpsde.com/products/displays/model/ls013b7dh03/) | 32.51 | 1.28 | 128 | 128 | 18 | TN | -20 | 70 | 18

Sheet: Sheet5
Texas Instrument
ID | BQ24232 (https://www.ti.com/product/BQ24232) | BQ24232HA (https://www.ti.com/product/BQ24232HA) | BQ25180 (https://www.ti.com/product/BQ25180) | BQ25618E (https://www.ti.com/product/BQ25618E) | BQ25619 (https://www.ti.com/product/BQ25619) | BQ25618 (https://www.ti.com/product/BQ25618)
TI.com inventory | 236540 | 752736 | 1757358 | 110460 | 579831 | 29360
Number of series cells | 1 | 1 | 1 | 1 | 1 | 1
Charge current (Max) (A) | 0.5 | 0.5 | 1 | 1.5 | 1.5 | 1.5
Operating Vin (Max) (V) | 10.2 | 10.2 | 5.5 | 13.5 | 13.5 | 13.5
Cell chemistry | Li-Ion/Li-Polymer | Li-Ion/Li-Polymer | Li-Ion/Li-Polymer | Li-Ion/Li-Polymer | Li-Ion/Li-Polymer | Li-Ion/Li-Polymer
 |  |  | Lithium Phosphate/LiFePO4 | Lithium Phosphate/LiFePO4 | Lithium Phosphate/LiFePO4 | Lithium Phosphate/LiFePO4
Battery charge voltage (Min) (V) | 4.2 | 4.35 | 3.6 | 3.5 | 3.5 | 3.5
Battery charge voltage (Max) (V) | 4.2 | 4.35 | 4.65 | 4.52 | 4.52 | 4.52
Absolute Vin (safety rating) (Max) ((V)) | 28 | 28 | 25 | 22 | 22 | 22
Control topology | Linear | Linear | Linear | Switch-Mode Buck | Switch-Mode Buck | Switch-Mode Buck
Control interface | Standalone (RC-Settable) | Standalone (RC-Settable) | I2C | I2C | I2C | I2C
Features | BAT temp thermistor monitoring (hot/cold profile) | BAT temp thermistor monitoring (hot/cold profile) | BAT temp thermistor monitoring (JEITA profile) | BAT temp thermistor monitoring (JEITA profile) | BAT temp thermistor monitoring (JEITA profile) | BAT temp thermistor monitoring (JEITA profile)
 | Input OVP | Input OVP | IC thermal regulation | IC thermal regulation | IC thermal regulation | IC thermal regulation
 | Power Path | Power Path | IINDPM (Input current limit) | IINDPM (Input current limit) | IINDPM (Input current limit) | IINDPM (Input current limit)
 | VINDPM (Input voltage threshold to maximize adaptor power) |  | Input OVP | Input OVP | Input OVP | Input OVP
 |  |  | Power Path | Power Path | Power Path | Power Path
 |  |  | VINDPM (Input voltage threshold to maximize adaptor power) | VINDPM (Input voltage threshold to maximize adaptor power) | USB OTG integrated | USB OTG integrated
 |  |  |  |  | VINDPM (Input voltage threshold to maximize adaptor power) | VINDPM (Input voltage threshold to maximize adaptor power)
Package Group | VQFN | 16 | VQFN | 16 | DSBGA | 8 | DSBGA | 30 | WQFN | 24 | DSBGA | 30
Approx. price (USD) | $0.735 | 1ku | $0.882 | 1ku | $0.890 | 1ku | $1.090 | 1ku | $1.470 | 1ku | $1.470 | 1ku
Operating Vin (Min) (V) | 4.35 | 4.35 | 3 | 3.9 | 3.9 | 3.9
Package size: mm2:W x L (PKG) | 16VQFN: 9 mm2: 3 x 3 (VQFN | 16) | 16VQFN: 9 mm2: 3 x 3 (VQFN | 16) | 8DSBGA: 1 mm2: .8 x 1.2 (DSBGA | 8) | 30DSBGA: 6 mm2: 2.59 x 2.2 (DSBGA | 30) | 24WQFN: 16 mm2: 4 x 4 (WQFN | 24) | 30DSBGA: 6 mm2: 2.59 x 2.2 (DSBGA | 30)
