traibertr/LTEWatch/2_Hardware/1_Altium/LTEWatch/Project Outputs for Free Documents/BOM/Bill of Materials-LTEWatch.xlsx

Comment | Description | Designator | Footprint | LibRef | Quantity
P822601 | ANTENNA PRESTTA OCTABAND LTE | A1 | P822601 | Ant_nRF_9160DK | 1
MC3635 | Accéléromètres X, Y, Z Axis ±2g, 4g, 8g, 12g, 16g 10-LGA (1,6x1,6) | AC1 | MC3635 | IC_ACCEL | 1
SKHUALE010 | Tactile Switch, SPNO, SMD, 160gf, 6.2x6.3x2.5mm | BT0, BT1, BT2, BT3, SW1 | Switch-PB-SMD-MCU-RST | SW_SMD_PB | 5
100nF | 0.1 µF ±10% 25V Condensateurs céramique X7R 0603 (1608 métrique) | C1, C5, C7, C8, C12, C14, C16, C19, C25, C28, C37, C38, C39, C40, C44, C47, C51, C57 | C0603 | C_100n | 18
47pF | 47 pF ±5% 25V Ceramic Capacitor C0G, NP0 0603 (1608 Metric) | C2, C3, C48 | C0603 | C_47p | 3
15pF | 15 pF ±5% 25V Ceramic Capacitor C0G, NP0 0603 (1608 Metric) | C4, C13 | C0603 | C_15p | 2
47uF | 47 µF ±20% 10V Ceramic Capacitor X5R 0805 (2012 Metric) | C6, C15 | CAPC2012X11L | C_47u | 2
10nF | 10000 pF ±5% 25V Condensateurs céramique C0G, NP0 0603 (1608 métrique) | C9, C17, C29, C36, C46, C59, C60, C67 | C0603 | C_10n | 8
4.7uF | 4.7 µF ±10% 25V Condensateurs céramique X6S 0603 (1608 métrique) | C10, C11, C24, C66 | C0603 | C_4.7u | 4
1uF | 1 µF ±10% 25V Ceramic Capacitor X7R 0603 (1608 Metric) | C18, C21, C22, C26, C27, C35, C41, C42, C45 | C0603 | C_1u | 9
N.C. | NC | C20, C49 | C0603 | C_NC, Cap_NC | 2
10uF | 10 µF ±10% 25V Ceramic Capacitor X5R 0805 (2012 Metric) | C23, C31, C32, C33, C34, C56, C65 | C0603 | C_10u | 7
10pF | 10 pF ±5% 50V Ceramic Capacitor C0G, NP0 0603 (1608 Metric) | C30 | C0603 | C_10p | 1
560pF | 560 pF ±5% 25V Ceramic Capacitor C0G, NP0 0603 (1608 Metric) | C43 | C0603 | C_560p | 1
3.5pF | 3.5 pF ±0,1pF 50V Condensateurs céramique C0G, NP0 0402 (1005 métrique) | C50 | CAPC1005X55N | C_0402_3.5p | 1
N.C. | NC | C52, C53, C54 | CAPC1005X55N | C_NC_0402 | 3
470nF | 0.47 µF ±10% 25V Ceramic Capacitor X7R 0603 (1608 Metric) | C55, C69 | C0603 | C_470n | 2
22nF | 0.022 µF ±10% 25V Ceramic Capacitor X7R 0603 (1608 Metric) | C58, C68 | C0603 | C_22n | 2
12nF | 0.012 µF ±10% 25V Ceramic Capacitor X7R 0603 (1608 Metric) | C61 | C0603 | C_12n | 1
680pF | 680 pF ±10% 25V Ceramic Capacitor X7R 0603 (1608 Metric) | C62 | C0603 | C_680p | 1
270pF | 270 pF ±1% 25V Ceramic Capacitor C0G, NP0 0603 (1608 Metric) | C63 | C0603 | C_270p | 1
56nF | 0.056 µF ±10% 25V Ceramic Capacitor X7R 0603 (1608 Metric) | C64 | C0603 | C_56n | 1
TVS 5.5VWM | Clamp Ipp Tvs Diode Surface Mount SOT-143B | D1 | PRTR5V0U2X | D_TVS_USB | 1
CM1402 | EMI Network Filter Arrays SIM CARD EMI FILTER WITH ESD PROTECTION | D2 | CM1402 | CM1402 | 1
TVS DIODE | 9.2V Clamp 5A (8/20µs) Ipp Tvs Diode Surface Mount SOD-882 | D3 | SP100701ETG | D_TVS | 1
NN03-320 | Dual port antenna booster for GNSS, Bluetooth, 5G and UWB (1561 - 1606MHz, 2400 - 2500MHz, 3400 - 3800MHz, 3100 - 4800MHz and 6000 - 10600 MHz). | E1 | XCVR_NN03-320 | ANT_GNSS | 1
120R/0.7A | Ferrite Bead, 120 Ohm @ 100MHz, 700mA, 130 mOhm Max | FB1, FB3, FB4 | INDC1005X04L | L_FerritBead_MCU | 3
FERRITE BEAD | 600 Ohms @ 100 MHz 1 Power, Signal Line Ferrite Bead 0805 (2012 Metric) 500mA 300mOhm | FB2, FB5, FB6 | BEADC2012X110N | L_FerritBead | 3
TPS7A0318PDBVR | 1.588GHz Frequency GPS RF SAW Filter (Surface Acoustic Wave) 2dB 56MHz Bandwidth 6-SMD, No Lead | FL1 | B39162B3913U410 | IC_SAW_FILTER | 1
LiPo 503535 580mAh | 503535 3.8v 580mAh round lipo battery cells (Order : shorturl.at/tEFMZ) | G1 | Battery_Lipo_503535 | Battery | 1
Sharp MIP LCD | 503535 3.8v 580mAh round lipo battery cells (Order : shorturl.at/tEFMZ) | G2 | SHARP_MIP_LCD | Display | 1
CONN_USB-C_24p | USB-C (USB TYPE-C) USB 3.2 Gen 2 (USB 3.1 Gen 2, Superspeed + (USB 3.1)) Receptacle Connector 24 Position Surface Mount, Right Angle; Through Hole | J1 | 12401598E42A - JTAG | CONN_USB-C_24p | 1
FTSH-105-01-F-DV-K | Connector Header Surface Mount 10 position 0.050" (1.27mm) | J2 | HDR_2x5-SMD-1.27mm-K | JTAG | 1
SF72S006VBAR2500 | n 8 (6 + 2) Position Card Connector NANO SIM Surface Mount, Right Angle Gold | J3 | SF72S006VBAR2500 | SF72S006VBAR2500 | 1
M40-4010346R | Connector Header Surface Mount, Right Angle 3 position 0.039" (1.00mm) | J4 | M404010346R | CON_BAT_3POS | 1
CONN LCD SMD | 10 Position FFC, FPC Connector Contacts, Top 0.020" (0.50mm) Surface Mount, Right Angle | J5 | FH12A10S05SH55 | CONN_LCD_FFC12 | 1
SMA | SMA Connector Jack, Female Socket 50Ohm Surface Mount Solder | J6, J9 | 73251-1350 | CONN_SMA | 2
MM8130-2600 | Coaxial Connector with Switch | J7, J8 | COAXIAL-SWF | MM8130-2600 | 2
WPC/QI COIL | 2 Position Wire to Board Terminal Block Horizontal with Board 0.138" (3.50mm) Surface Mount | J10 | 23839422 | CONN_WPC_IND | 1
2.9A 48mΩ | 1 µH Shielded Drum Core, Wirewound Inductor 2.9 A 48mOhm Max 0806 (2016 Metric) | L1 | 1286ASH1R0MP2 | L_1u | 1
350mA 460mΩ | 27 nH Unshielded Multilayer Inductor 350 mA 460mOhm Max 0402 (1005 Metric) | L2 | LQG15WH0N7B02D | L_27n | 1
N.C. | N.C. | L3, R4 | RES0603 | L_NC, R_NC | 2
9.7nH | 9.7 nH Non blindé Bobiné Inducteur 1.4 A 81mOhms maxi 0402 (1005 métrique) | L4 | LQW15AN10NG80D | L_9.7n | 1
11nH | 11 nH Non blindé Bobiné Inducteur 1.6 A 52mOhms maxi 0603 (1608 métrique) | L5 | LQW18AN10NG80D | L_11n | 1
13nH | 13 nH Non blindé Noyau de bobine, bobiné Inducteur 1.5 A 64mOhms maxi 0603 (1608 métrique) | L6 | LQW18AN10NG80D | L_13n | 1
1.5nH | 1.5 nH Non blindé Couche mince Inducteur 700 mA 250mOhms maxi 0402 (1005 métrique) | L7 | INDC1005X37N | L_0402_1.5n | 1
22nH | 22 nH Non blindé Bobiné Inducteur 780 mA 202mOhms maxi 0402 (1005 métrique) | L8 | LQW15AN10NG80D | L_0402_22n | 1
BLUE 3.2V | Blue 470nm LED Indication - Discrete 3.2V 0603 (1608 Metric) | LED0, LED1, LED2 | LEDC1608X80N | LED_B | 3
GREEN 2V | Green 570nm LED Indication - Discrete 2V 0603 (1608 Metric) | LED3, LED5, LED6, LED8, LED9 | LEDC1608X80N | LED_G | 5
RED 2V | Red 625nm LED Indication - Discrete 2V 0603 (1608 Metric) | LED4, LED7 | LEDC1608X80N | LED_R | 2
Motor 903A | Titan 903A : 3 Hands Bidirectional, independent motor | M1 | MOTOR | MOTOR_903A | 1
VUART | Header, 2-Pin | P1 | HDR1X2 - ACCEL | H_2POS | 1
VACC | Header, 2-Pin | P2 | HDR1X2 - ACCEL | H_2POS | 1
COEX | Header, 3-Pin | P3 | HDR1X3 - COEX | H_1x3 | 1
Header 3 | Header, 3-Pin | P4 | HDR1X3 - COEX | H_1x3 | 1
IMEAS | Header, 2-Pin | P5 | HDR1X2 - IMEAS | H_2POS | 1
VLED | Header, 2-Pin | P6 | HDR1X2 - VLED | H_2POS | 1
VGPIO | Header, 3-Pin | P7 | HDR1X3 - VGPIO | H_3POS | 1
DISPEN | Header, 3-Pin | P8 | HDR1X3 - DISP_EN | H_3POS | 1
EXTMODE | Header, 3-Pin | P9 | HDR1X3 - EXT_MODE | H_3POS | 1
GPSUSB | Header, 8-Pin | P10 | HDR1X6 - GPS | H_1x6 | 1
GPS-SFBT | Header, 2-Pin | P11 | HDR1X2 - GPSSAFEBOOT | H_2POS | 1
VBUS | Header, 2-Pin | P? | HDR1X2 - VIN | H_2POS | 1
MOS N/P-CH | Mosfet Array N and P-Channel 20V 485mA, 370mA 250mW Surface Mount SC-89 (SOT-563F) | Q1, Q12 | SOT50P160X60-6N | MOS_NP_3 | 2
PMOS | P-Channel 12 V 6A (Ta) 1W (Ta) Surface Mount SOT-23F | Q2, Q10, Q11 | SSM3J332RLFT | MOS-P | 3
NMOS | N-Channel 30 V 180mA (Ta) 260mW (Ta), 1.1W (Tc) Surface Mount SOT-323 | Q3, Q4, Q5, Q6, Q7, Q8, Q9, Q14 | SOT65P210X110-3N | MOS-N | 8
20V 1.6A 0.7W | Mosfet Array 2 P-Channel (Dual) Common Source 20V 1.6A 750mW Surface Mount 6-DSBGA (1x1.5) | Q13 | BGA6C50P2X3_95X145X62 | MOS_2PCH | 1
10k | 10 kOhms ±1% 0.1W, 1/10W Chip Resistor 0603 (1608 Metric) Moisture Resistant Thick Film | R1, R2, R7, R9, R24, R26, R27, R28, R29, R30, R31, R32, R33, R48, R49, R50, R66 | RES0603 | R_10k | 17
330 | 330 Ohms ±1% 0.1W, 1/10W Chip Resistor 0603 (1608 Metric) Automotive AEC-Q200 Thick Film | R3 | RES0603 | R_330 | 1
27R | 27 Ohms ±1% 0.1W, 1/10W Chip Resistor 0603 (1608 Metric) Automotive AEC-Q200 Thick Film | R5, R6 | RES0603 | R_27 | 2
100k | RES SMD 100K OHM 1% 1/8W 0603 | R8, R15, R22, R35, R44, R45, R68 | RES0603 | R_100k | 7
0R | 0 Ohms Jumper 0.1W, 1/10W Chip Resistor 0603 (1608 Metric) Moisture Resistant Thick Film | R10, R14 | RESC2012X60N | R_0 | 2
5k1 | 5.1 kOhms ±1% 0.1W, 1/10W Chip Resistor 0603 (1608 Metric) Moisture Resistant Thick Film | R11, R12 | RES0603 | R_5k1 | 2
1k | 1 kOhms ±1% 0.1W, 1/10W Chip Resistor 0603 (1608 Metric) Moisture Resistant Thick Film | R13, R53, R54, R55, R65 | RES0603 | R_1k | 5
1M | 1 MOhms ±1% 0.1W, 1/10W Chip Resistor 0603 (1608 Metric) Automotive AEC-Q200 Thick Film | R16, R17, R37, R39, R40, R42, R43, R46, R47, R56, R69 | RES0603 | R_1M | 11
4.02M | 4.02 MOhms ±1% 0,1W, 1/10W Pavé résistif 0603 (1608 métrique) Résistant à l’humidité Couche épaisse | R18 | RES0603 | R_4M | 1
8.66M | 8.66 MOhms ±1% 0,1W, 1/10W Pavé résistif 0603 (1608 métrique) AutomobileAEC-Q200 Couche épaisse | R19 | RES0603 | R_8.66M | 1
NTC10k | NTC Thermistor 10k 0603 (1608 Metric) | R20 | C0603 | R_NTC_10k | 1
560k | 560 kOhms ±1% 0.1W, 1/10W Chip Resistor 0603 (1608 Metric) Automotive AEC-Q200, Moisture Resistant Thick Film | R21 | RES0603 | R_560k | 1
120 | 1 MOhms ±1% 0.1W, 1/10W Chip Resistor 0603 (1608 Metric) Automotive AEC-Q200 Thick Film | R23, R25, R41, R51, R64, R72 | RES0603 | R_120 | 6
10R | 10 Ohms ±5% 0.25W, 1/4W Chip Resistor 0805 (2012 Metric) Automotive AEC-Q200 Thick Film | R34, R36, R38, R52 | RESC2012X60N | R_10 | 4
33R | 33 Ohms ±1% 0.1W, 1/10W Chip Resistor 0603 (1608 Metric) Thin Film | R57, R58, R59, R60, R61, R62, R63 | RES0603 | R_33 | 7
20k | 20 kOhms ±1% 0.1W, 1/10W Chip Resistor 0603 (1608 Metric) Moisture Resistant Thick Film | R67 | RES0603 | R_20k | 1
845 | 845 Ohms ±1% 0.1W, 1/10W Chip Resistor 0603 (1608 Metric) Moisture Resistant Thick Film | R70 | RES0603 | R_845 | 1
196 | 196 Ohms ±1% 0.1W, 1/10W Chip Resistor 0603 (1608 Metric) Moisture Resistant Thick Film | R71 | RES0603 | R_196 | 1
BGS12PL6E6327XTSA1 | RF Switch IC WLAN SPDT 50Ohm PG-TSNP-6-10 | S1, S2 | BGS12WN6E6327XTSA1 | SW_RF_SWITCH | 2
SMD slide (ON-ON) | SMD slide Switch (ON-ON) | SW2 | CJS-120xA | SW_2POS | 1
UART/FTDI | SMD slide Switch (ON-ON) | SW3 | JS102011JAQN - GPS | Switch-Slide-RA-J-Lead-DPDT-8.5x3.5mm_C&K | 1
SKHUALE010 | Tactile Switch, SPNO, SMD, 160gf, 6.2x6.3x2.5mm | SW4 | Switch-PB-SMD-GPS-RST | SW_SMD_PB | 1
IC_USB_UART | USB Bridge, USB to UART USB 2.0 UART Interface 12-DFN (3x3) | U1 | SON45P300X300X75-13N-D | IC_USB_UART | 1
nRF9160-SICAB1A | Low power System-in-Package with integrated LTE-M/NB-IoT modem and GPS | U2 | LGA50P1600X1050X104-161N | MCU_nRF9160-SICAB1A | 1
NX3DV2567 | Low-ohmic four-pole double-throw analog switch | U3, U9 | XQFN40P180X260X50-16N | NX3DV2567GU | 2
MFFx_M2M_UICC | M2M UICC SIM Card | U4 | SON127P600X90_HS-8N | M2M_UICC | 1
TPS7A0318PDBVR | Linear Voltage Regulator IC Positive Fixed 1 Output 200mA SOT-23-5 | U5 | SOT95P280X145-5N | IC_TPS7A0318PDBVR | 1
BQ25180 | Charger IC Lithium Ion/Polymer, Lithium Iron Phosphate 8-DSBGA | U6 | BGA8C40P2X4_100X155X50 | IC_BQ25180YBGT | 1
TPS22916CNYFPT | Power Switch/Driver 1:1 P-Channel 2A 4-DSBGA | U7 | BGA4C40P2X2_78X78X50 | SW_LOAD_SW | 1
TPS63036YFGT | Buck-Boost Switching Regulator IC Positive Adjustable 1.2V 1 Output 1A (Switch) 8-UFBGA, DSBGA | U8 | BGA8C40P2X4_108X181X62 | IC_TPS63036YFGT | 1
MAX-M10S-00B | MAX-M10 RF Receiver BeiDou, Galileo, GLONASS, GPS, GNSS 1.561GHz, 1.575GHz, 1.602GHz -167dBm 921.6kbps | U10 | MAXM10S00B | IC_MAX-M10S | 1
WIRELESS PWR RCVR | Wireless Power Receiver PMIC 28-DSBGA | U11 | BGA28C40P4X7_188X301X50 | IC_WPC_RCVR | 1
Shunt 2.54mm | Shunt Jumper 2.54mm Black | Y1, Y2, Y3, Y4, Y5, Y6, Y7, Y8, Y9, Y10, Y11, Y12 | Shunt_2.54mm_Horizontal | SHUNT JUMPER 2.54mm BLACK GOLD Horizontal | 12
ZENER | Zener Diode 9.1 V 500 mW ±6% Surface Mount SOD-123 | Z1 | SOD3716X145N | D_ZENER_9V1 | 1
