traibertr/LTEWatch/2_Hardware/3_Prototye/Components/GNSS/2022-10-19 15_17_31-GNSS-Antennas_AppNote_(UBX-15030289).pdf - Foxit PDF Reader.png

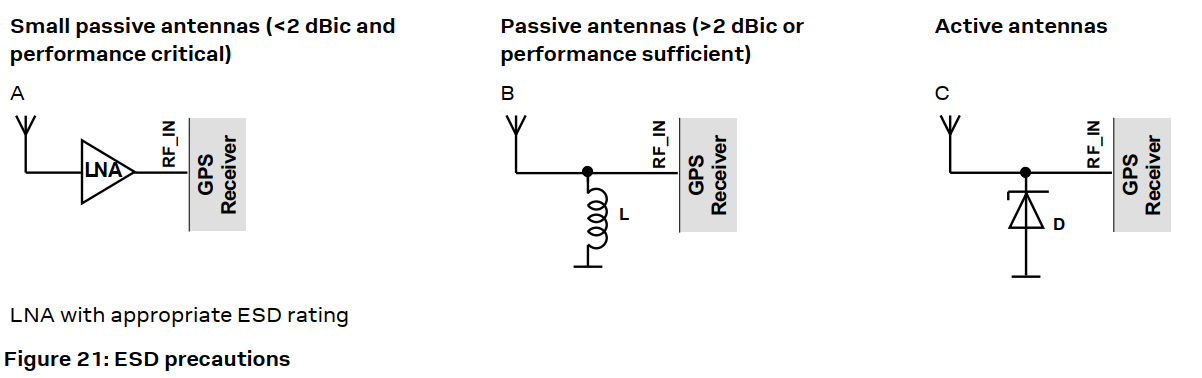
2_Hardware/3_Prototye/Components/GNSS/2022-10-19 15_17_31-GNSS-Antennas_AppNote_(UBX-15030289).pdf - Foxit PDF Reader.png
