traibertr/LTEWatch/2_Hardware/3_Prototye/Components/GNSS/2022-10-21 11_02_41-Window.png

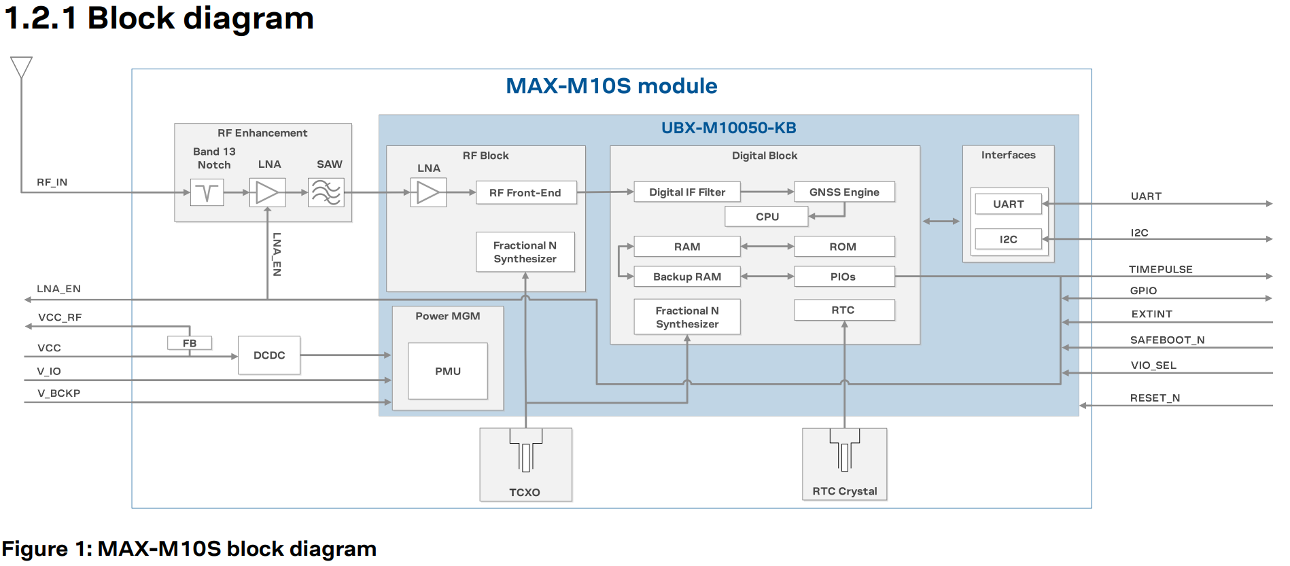
2_Hardware/3_Prototye/Components/GNSS/2022-10-21 11_02_41-Window.png
