traibertr/LTEWatch/2_Hardware/3_Prototye/Components/GNSS/2022-10-21 11_12_23-Window.png

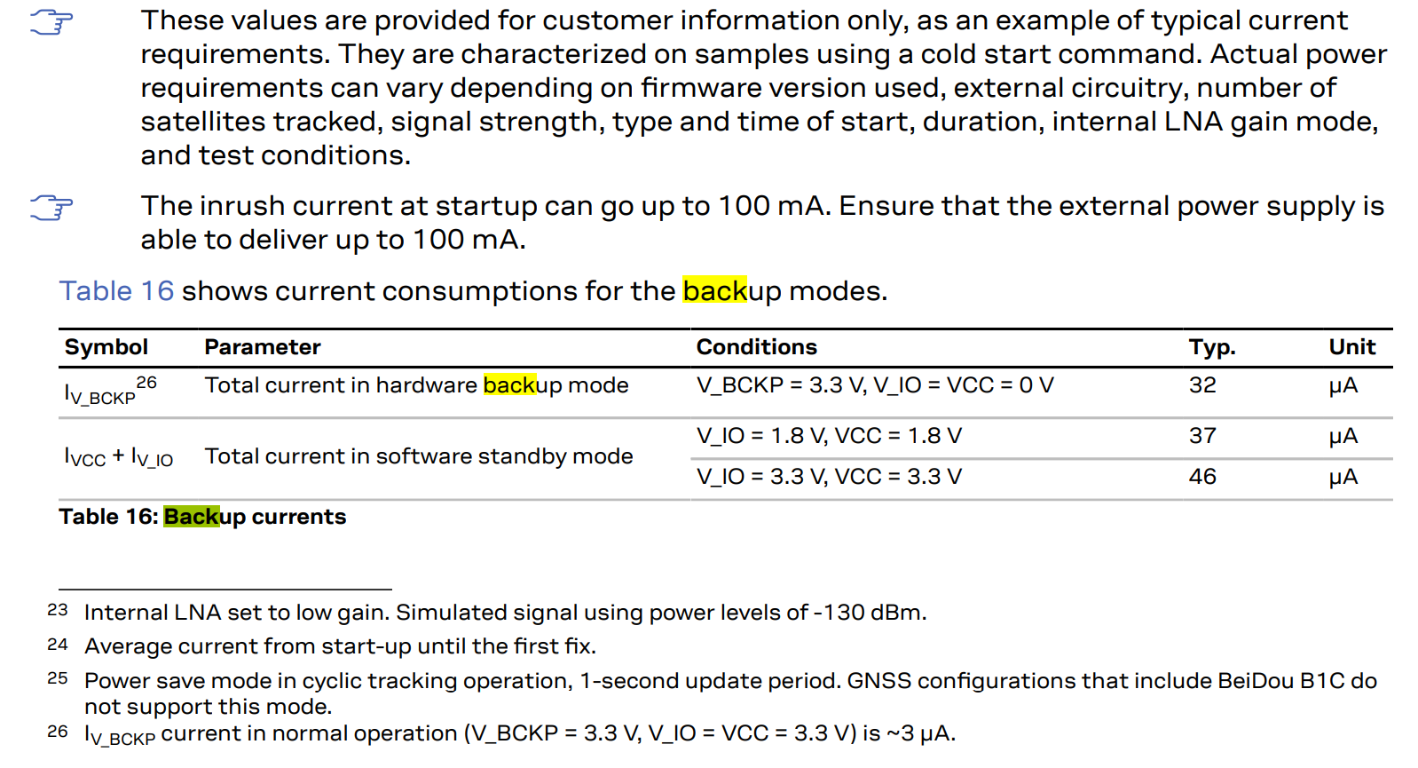
2_Hardware/3_Prototye/Components/GNSS/2022-10-21 11_12_23-Window.png
