traibertr/LTEWatch/2_Hardware/3_Prototye/Components/GNSS/2022-10-21 12_03_25-Window.png

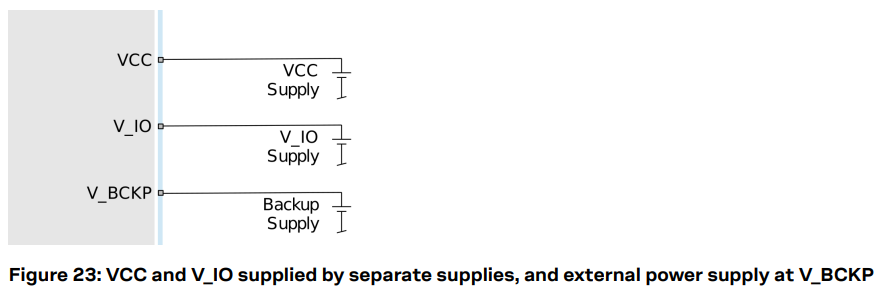
2_Hardware/3_Prototye/Components/GNSS/2022-10-21 12_03_25-Window.png
