traibertr/LTEWatch/2_Hardware/3_Prototye/Components/GNSS/2022-10-21 14_18_40-Window.png

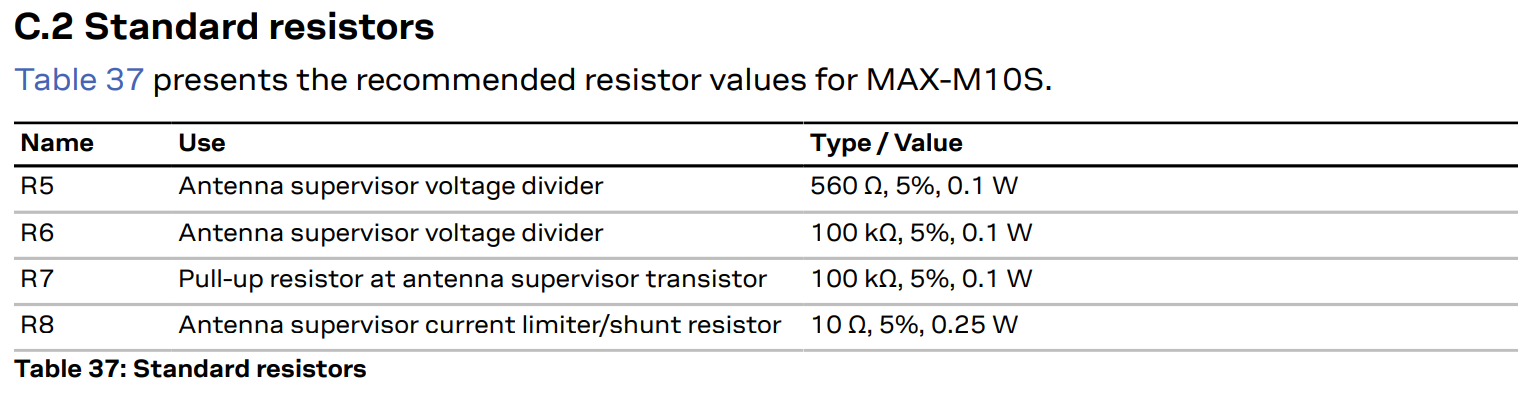
2_Hardware/3_Prototye/Components/GNSS/2022-10-21 14_18_40-Window.png
