traibertr/LTEWatch/2_Hardware/3_Prototye/Components/GNSS/2022-10-21 14_39_07-Window.png

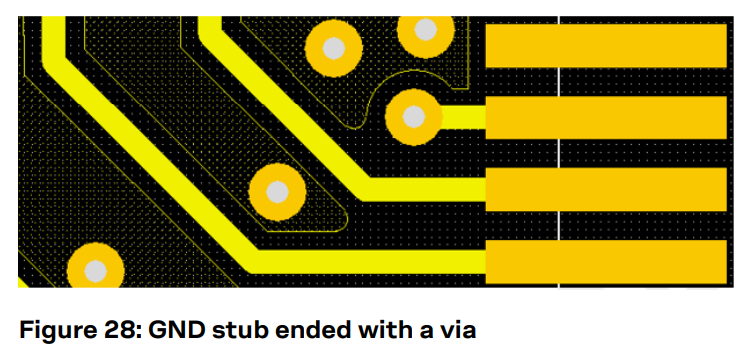
2_Hardware/3_Prototye/Components/GNSS/2022-10-21 14_39_07-Window.png
