traibertr/LTEWatch/2_Hardware/3_Prototye/Components/GNSS/2022-10-21 15_18_17-Window.png

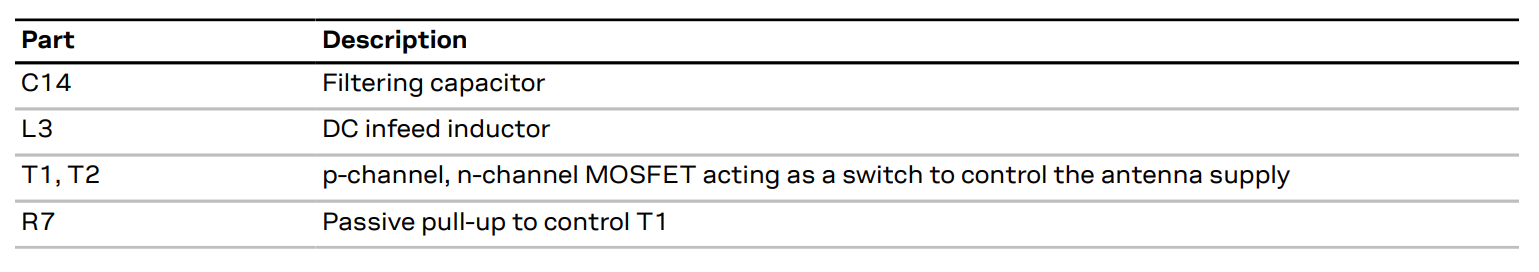
2_Hardware/3_Prototye/Components/GNSS/2022-10-21 15_18_17-Window.png
