traibertr/LTEWatch/2_Hardware/3_Prototye/Components/GNSS/2022-10-21 16_05_03-Window.png

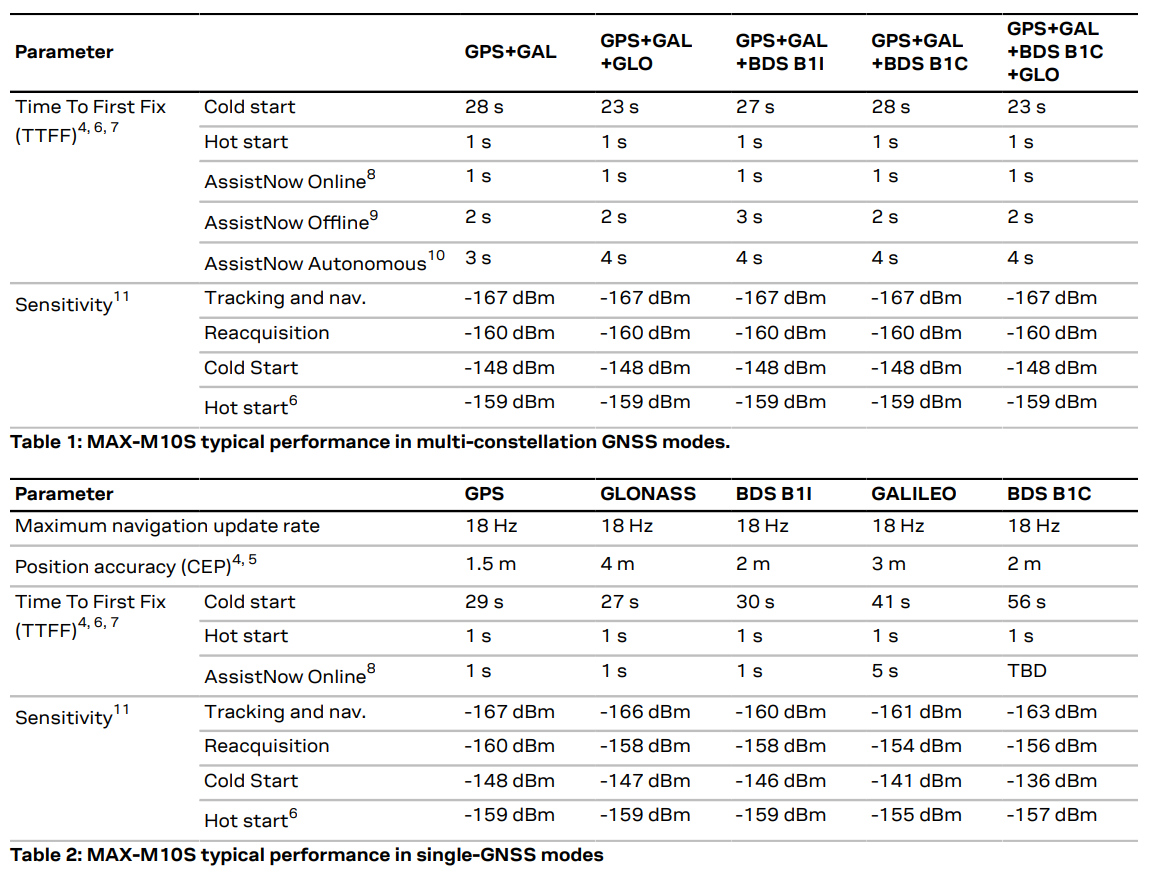
2_Hardware/3_Prototye/Components/GNSS/2022-10-21 16_05_03-Window.png
