traibertr/LTEWatch/2_Hardware/3_Prototye/Components/GNSS/2022-10-21 16_07_46-Window.png

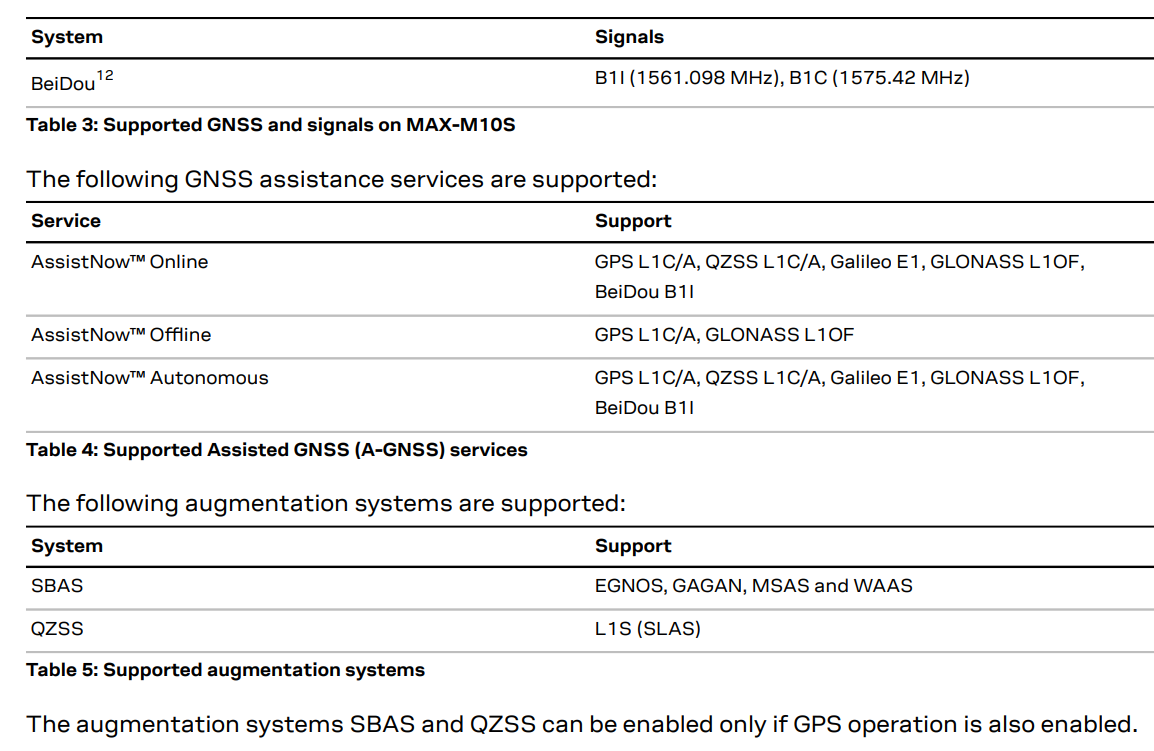
2_Hardware/3_Prototye/Components/GNSS/2022-10-21 16_07_46-Window.png
