traibertr/LTEWatch/2_Hardware/3_Prototye/Components/GNSS/2022-10-21 17_30_07-weeks_meetings - TM (Workspace) - Visual Studio Code.png

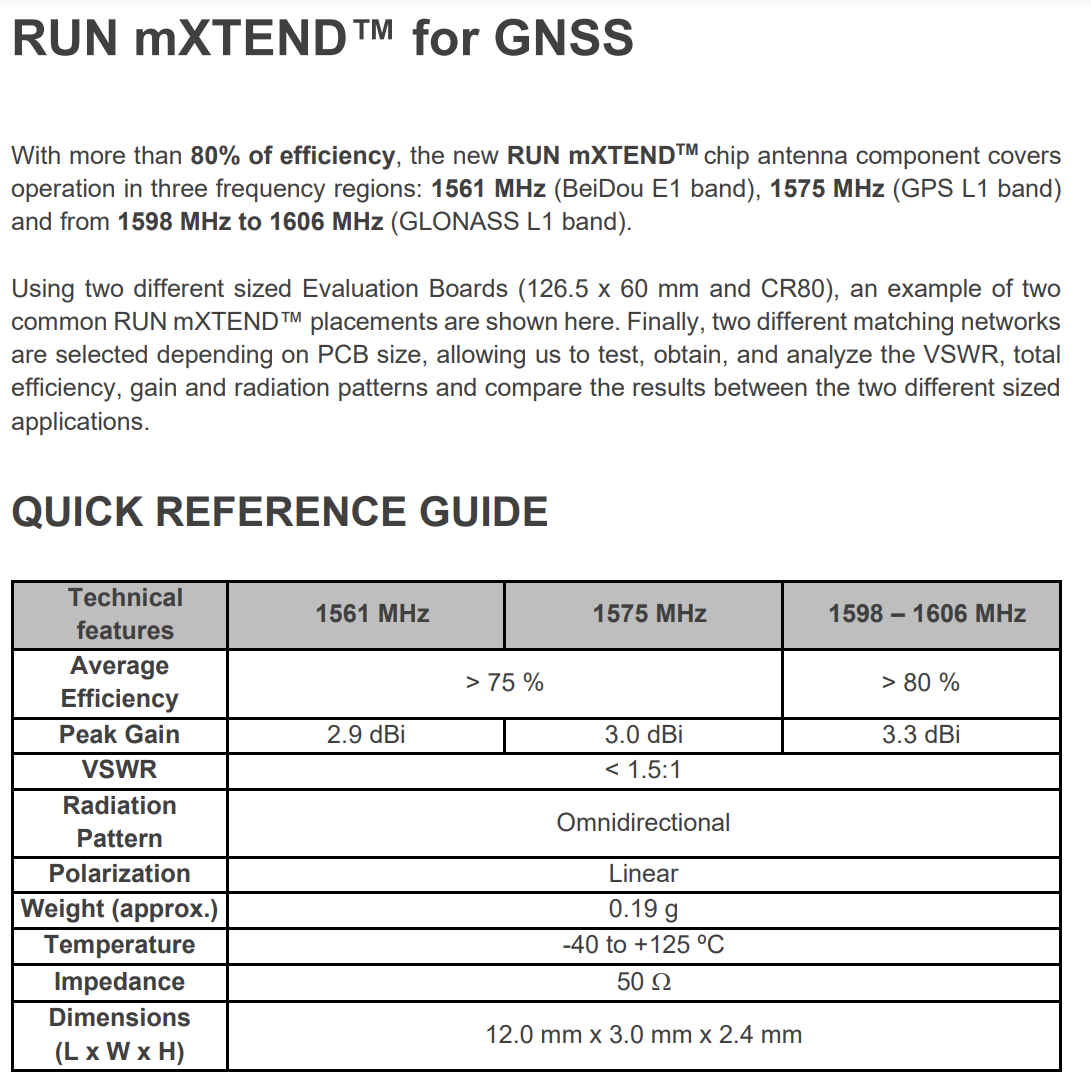
2_Hardware/3_Prototye/Components/GNSS/2022-10-21 17_30_07-weeks_meetings - TM (Workspace) - Visual Studio Code.png
