traibertr/LTEWatch/2_Hardware/3_Prototye/Components/GNSS/bq51003_elect_charact.png

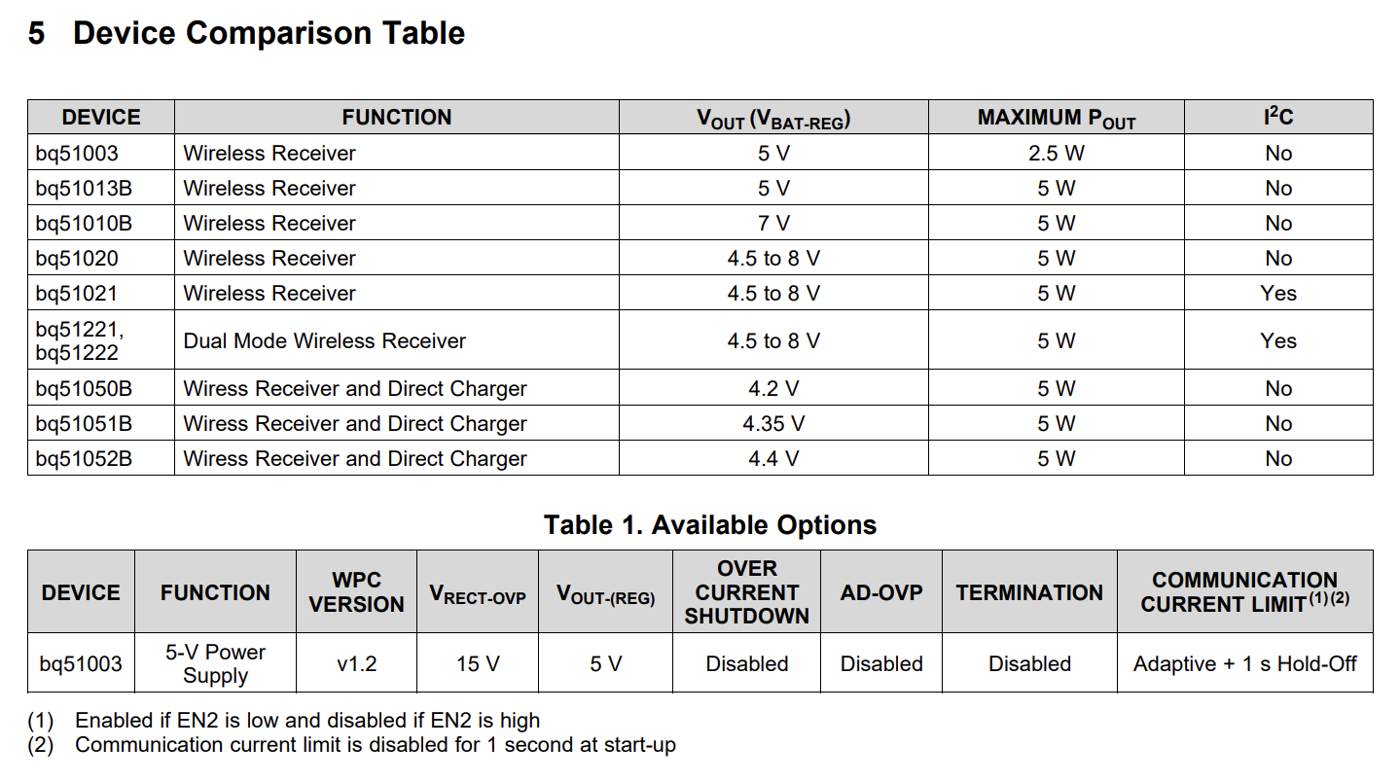
2_Hardware/3_Prototye/Components/GNSS/bq51003_elect_charact.png
