traibertr/LTEWatch/2_Hardware/3_Prototye/Components/GNSS/lte-nrf9169.png

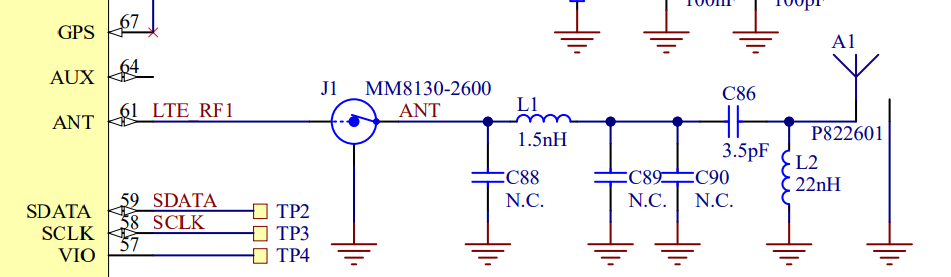
2_Hardware/3_Prototye/Components/GNSS/lte-nrf9169.png
