traibertr/LTEWatch/2_Hardware/3_Prototye/Components/Power_Manager/nordic_semi_nPm6001.png

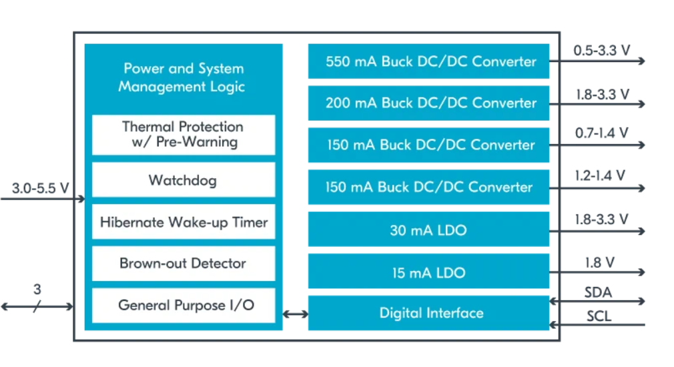
2_Hardware/3_Prototye/Components/Power_Manager/nordic_semi_nPm6001.png
