traibertr/LTEWatch/2_Hardware/3_Prototye/Components/Power_Manager/nPM6001_bloc_diagrm.png

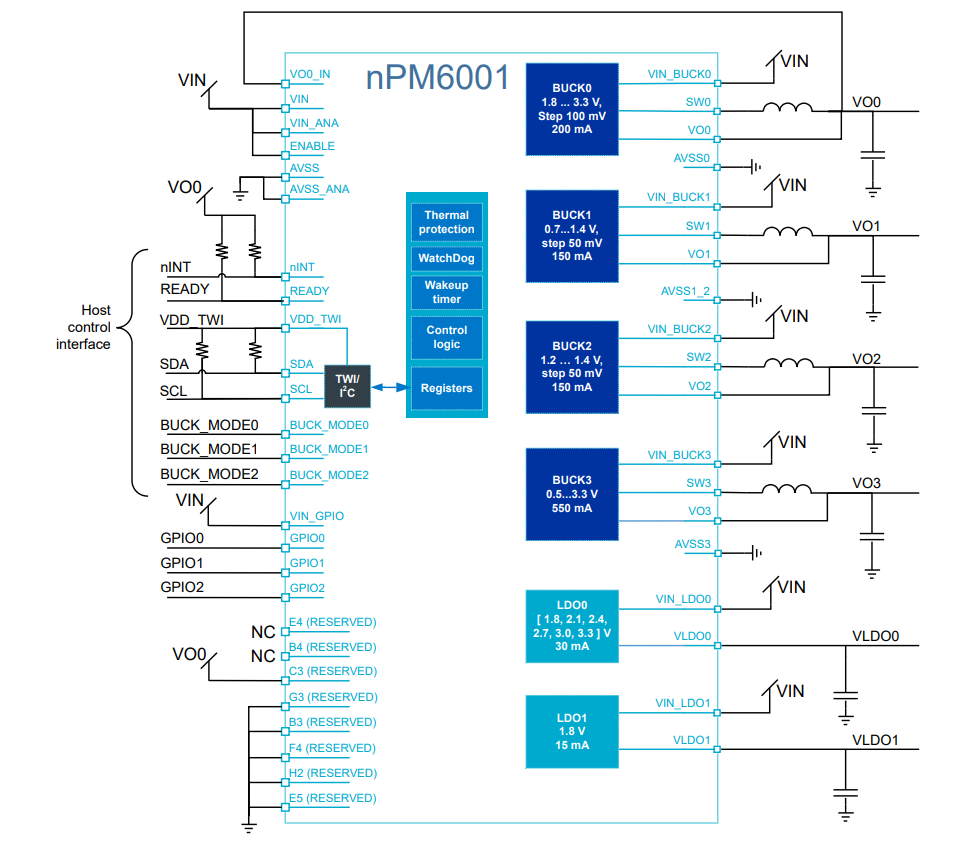
2_Hardware/3_Prototye/Components/Power_Manager/nPM6001_bloc_diagrm.png
