traibertr/LTEWatch/2_Hardware/3_Prototye/Components/Power_Manager/ti_BQ25120A.png

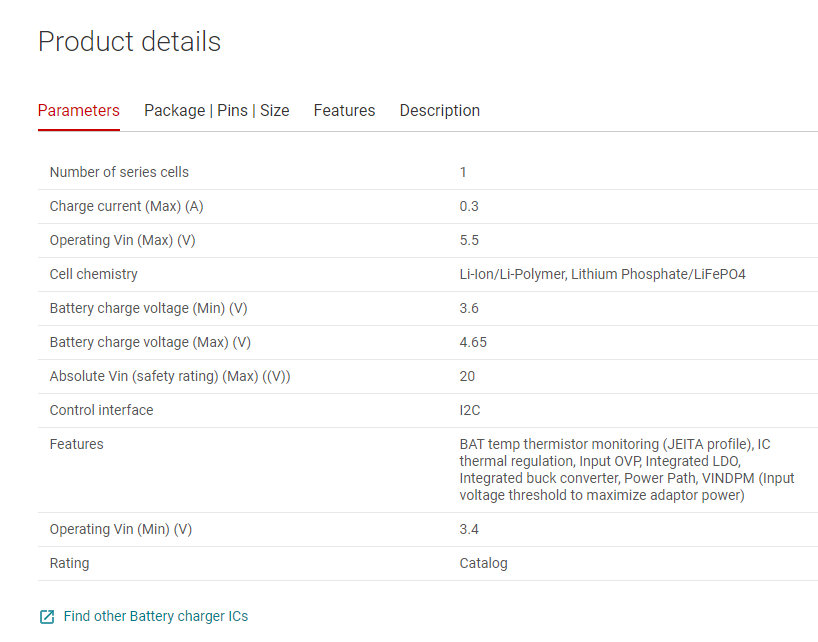
2_Hardware/3_Prototye/Components/Power_Manager/ti_BQ25120A.png
