traibertr/LTEWatch/2_Hardware/3_Prototye/Components/Power_Manager/ti_SwitchLoad/adcin_nrf.png

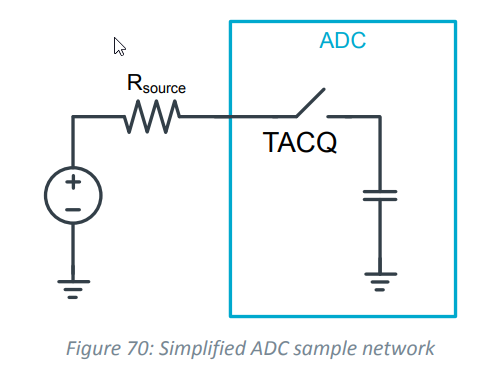
2_Hardware/3_Prototye/Components/Power_Manager/ti_SwitchLoad/adcin_nrf.png
