traibertr/LTEWatch/3_Software/ubxlib/port/platform/common/automation/3d_print/ubxlib_wiring_box_base.stl

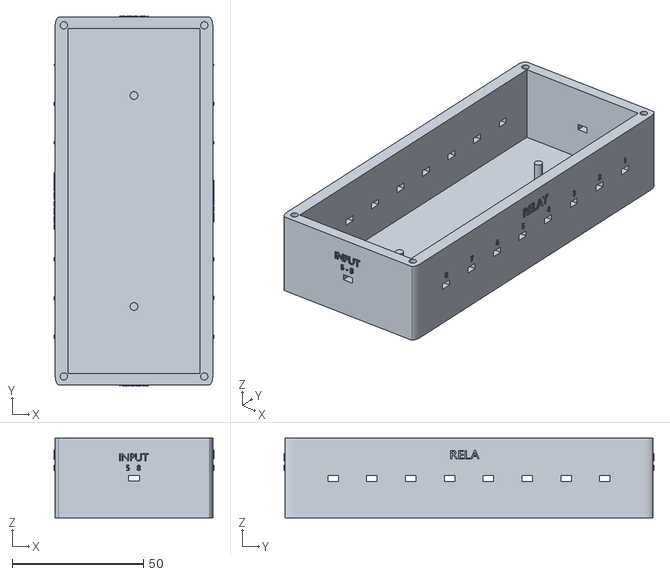
[picture p255: CAD file, 2023-02-21]
3_Software/ubxlib/port/platform/common/automation/3d_print/ubxlib_wiring_box_base.stl
60.8 x 140.8 x 30.3
