traibertr/LTEWatch/4_Mechanical/LTEWatch_Prototype_Case_Bottom.stl

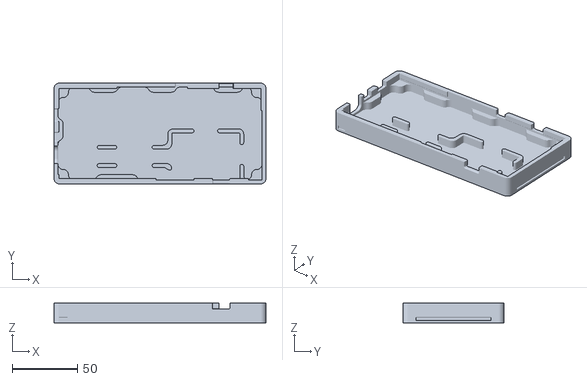
[picture p256: CAD file, 2023-02-22]
4_Mechanical/LTEWatch_Prototype_Case_Bottom.stl
162.0 x 77.0 x 15.2
