traibertr/LTEWatch/3_Software/ubxlib/port/platform/common/automation/3d_print/ubxlib_stand_wide_extpart.stl

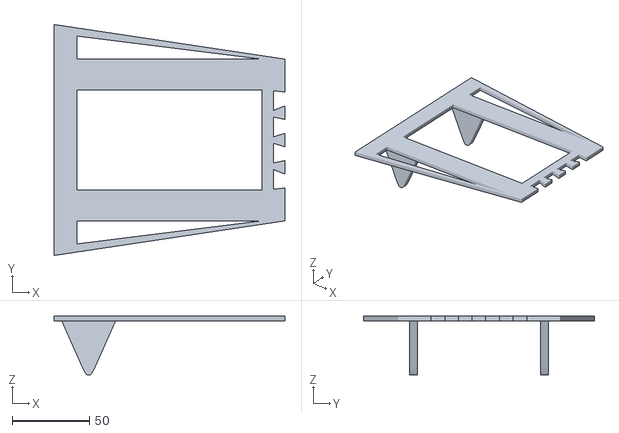
[picture p257: CAD file, 2023-02-21]
3_Software/ubxlib/port/platform/common/automation/3d_print/ubxlib_stand_wide_extpart.stl
150.0 x 150.0 x 38.0
