traibertr/LTEWatch/4_Mechanical/LTEWatch_Prototype_Straps.stl

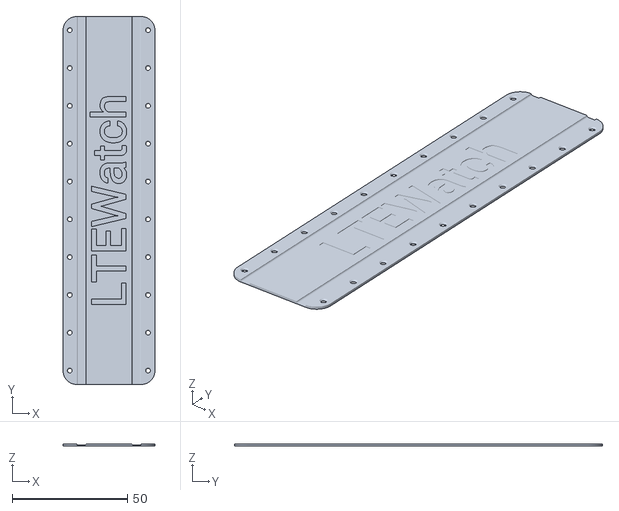
[picture p258: CAD file, 2023-02-22]
4_Mechanical/LTEWatch_Prototype_Straps.stl
40.0 x 160.0 x 1.00
