traibertr/LTEWatch/3_Software/ubxlib/port/platform/common/automation/3d_print/ubxlib_stand_narrow_extpart.stl

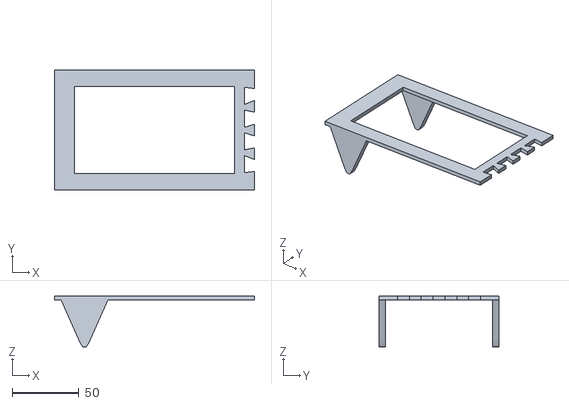
[picture p259: CAD file, 2023-02-21]
3_Software/ubxlib/port/platform/common/automation/3d_print/ubxlib_stand_narrow_extpart.stl
150.0 x 90.0 x 38.0
