traibertr/LTEWatch/4_Mechanical/LTEWatch_Prototype_Case_Top.stl

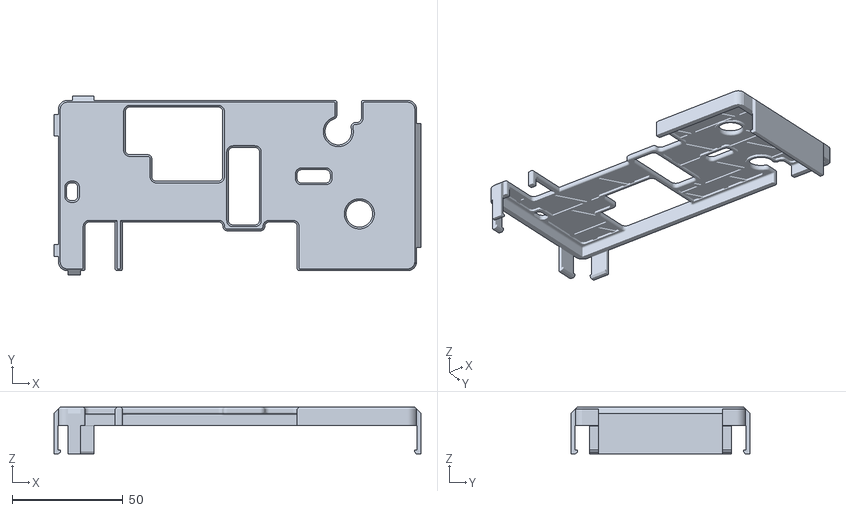
[picture p260: CAD file, 2023-02-22]
4_Mechanical/LTEWatch_Prototype_Case_Top.stl
166.0 x 80.9 x 21.1
