traibertr/LTEWatch/3_Software/ubxlib/port/platform/common/automation/3d_print/ubxlib_stand_wide_pipart.stl

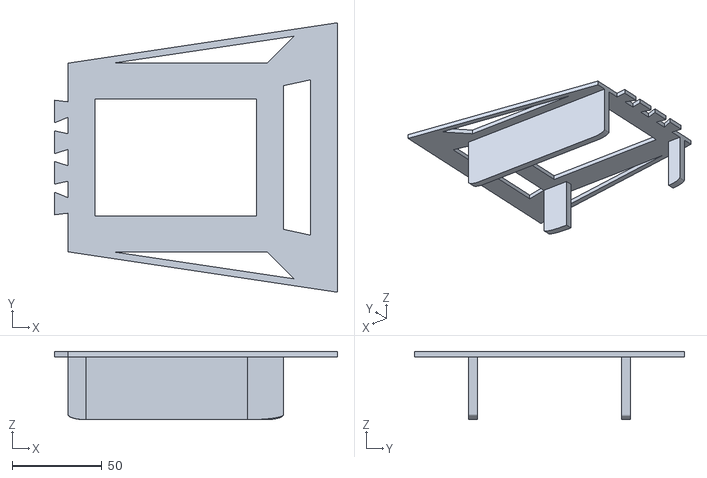
[picture p261: CAD file, 2023-02-21]
3_Software/ubxlib/port/platform/common/automation/3d_print/ubxlib_stand_wide_pipart.stl
157.5 x 150.0 x 38.0
