traibertr/LTEWatch/3_Software/ubxlib/port/platform/common/automation/3d_print/ubxlib_wiring_box_top.stl

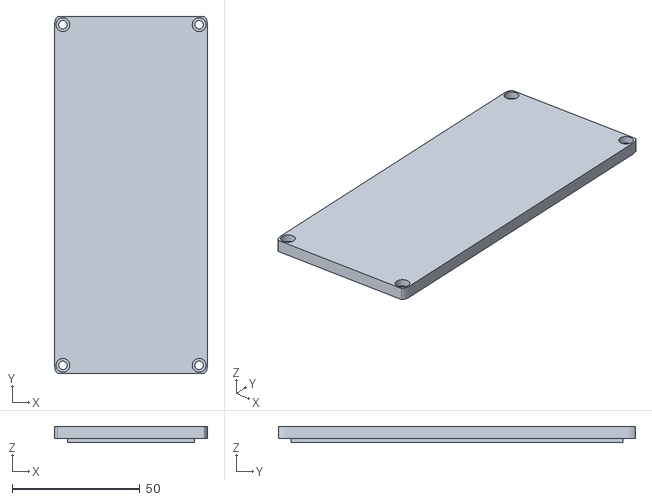
[picture p262: CAD file, 2023-02-21]
3_Software/ubxlib/port/platform/common/automation/3d_print/ubxlib_wiring_box_top.stl
60.0 x 140.0 x 6.36
