traibertr/LTEWatch/(list of files, cad)

Other CAD files:
3_Software/ubxlib/port/platform/common/automation/3d_print/ubxlib_stand_narrow.blend
3_Software/ubxlib/port/platform/common/automation/3d_print/ubxlib_stand_wide.blend
3_Software/ubxlib/port/platform/common/automation/3d_print/ubxlib_wiring_box.blend
