traibertr/LTEWatch/1_Document/2_Report/6_result.tex

\documentclass[Report.tex]{subfiles}

\begin{document}

\chapter{Results and Solutions Proposal}

\end{document}
