traibertr/LTEWatch/1_Document/2_Report/Include/Figure/result/IMG_1239[5434].jpg

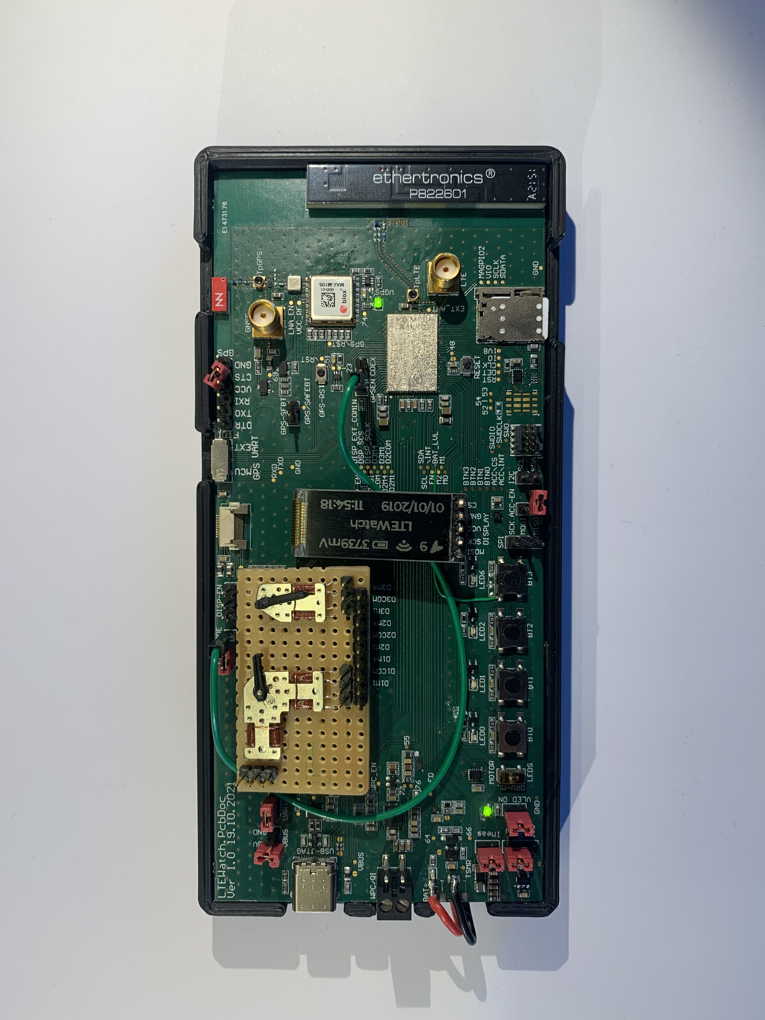
1_Document/2_Report/Include/Figure/result/IMG_1239[5434].jpg
