traibertr/LTEWatch/1_Document/2_Report/Include/Figure/result/IMG_1240[5436].jpg

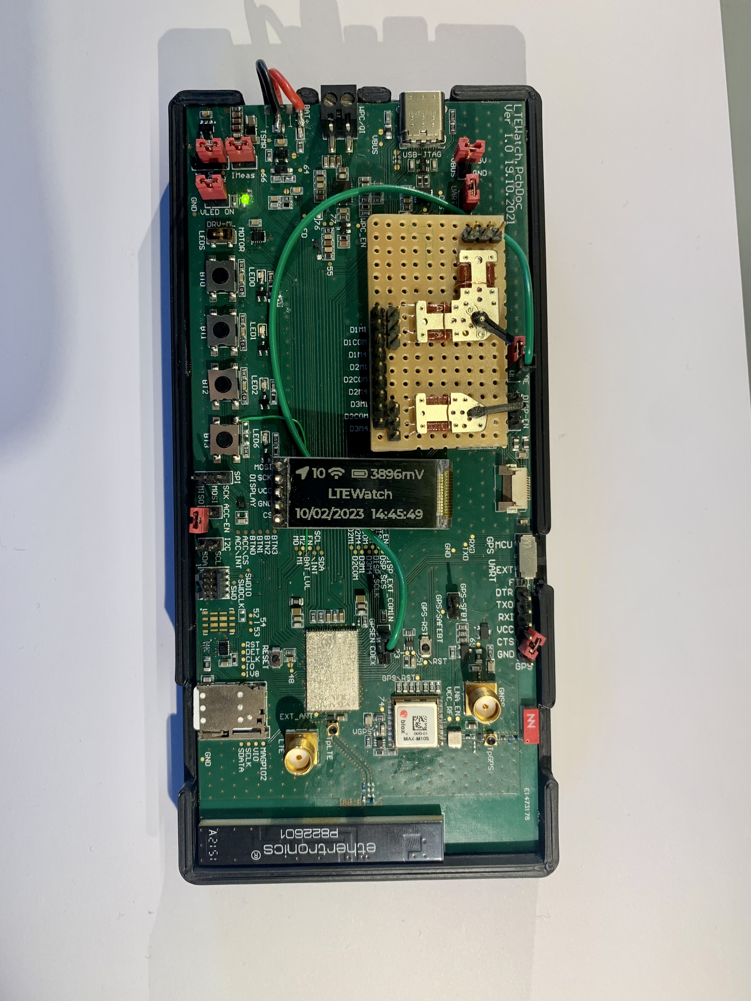
1_Document/2_Report/Include/Figure/result/IMG_1240[5436].jpg
