traibertr/LTEWatch/1_Document/2_Report/Include/Figure/result/IMG_9936.jpg

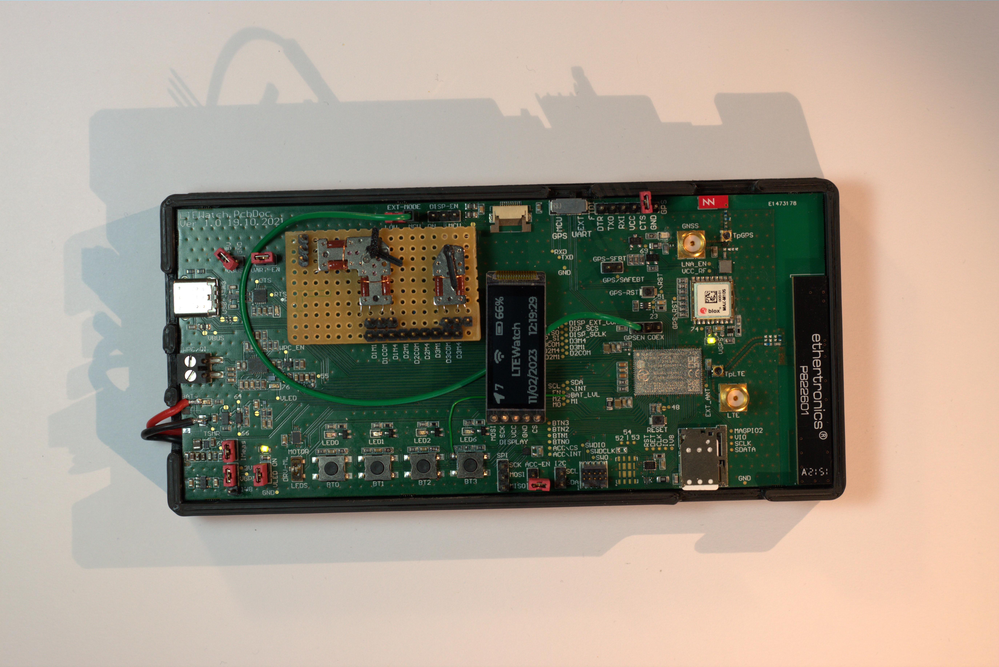
1_Document/2_Report/Include/Figure/result/IMG_9936.jpg
