traibertr/LTEWatch/1_Document/2_Report/Include/Figure/result/ltewatche1.jpg

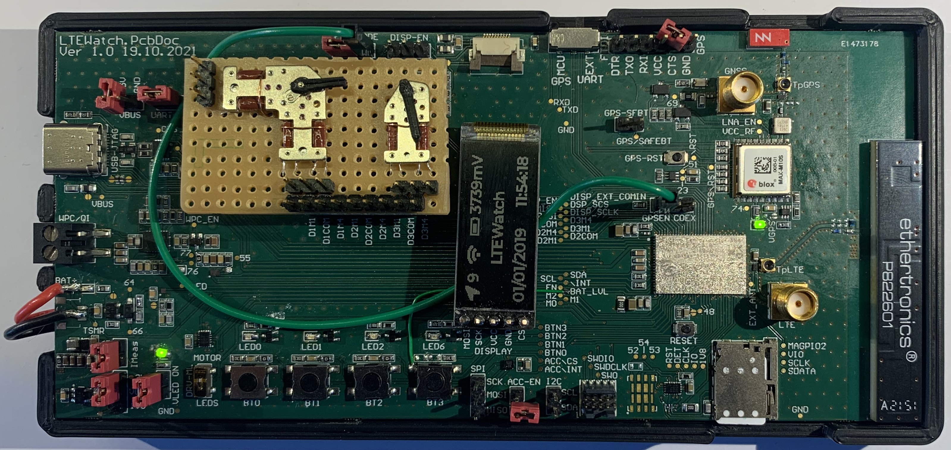
1_Document/2_Report/Include/Figure/result/ltewatche1.jpg
