traibertr/LTEWatch/1_Document/2_Report/Include/Figure/result/ltewatche2.jpg

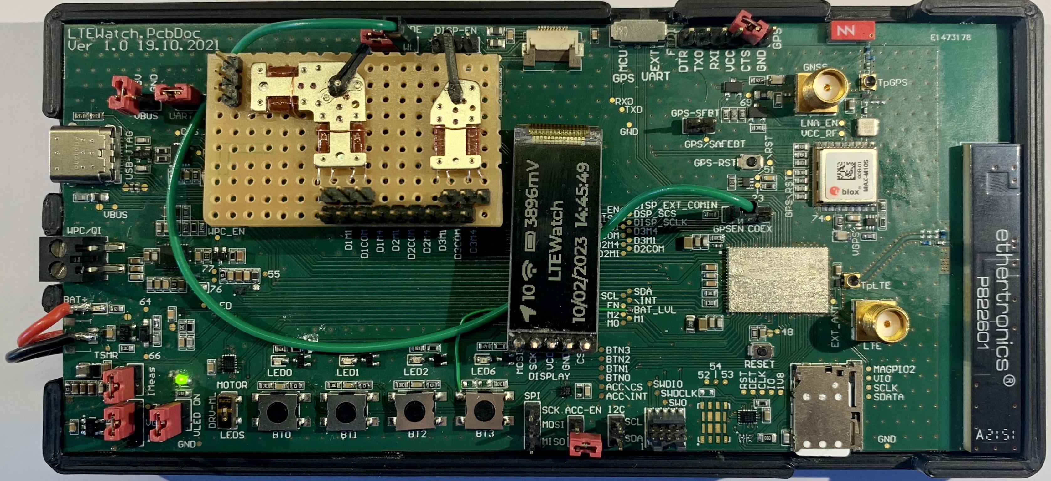
1_Document/2_Report/Include/Figure/result/ltewatche2.jpg
