traibertr/LTEWatch/1_Document/2_Report/Include/Annexe/LTEWatch.pdf

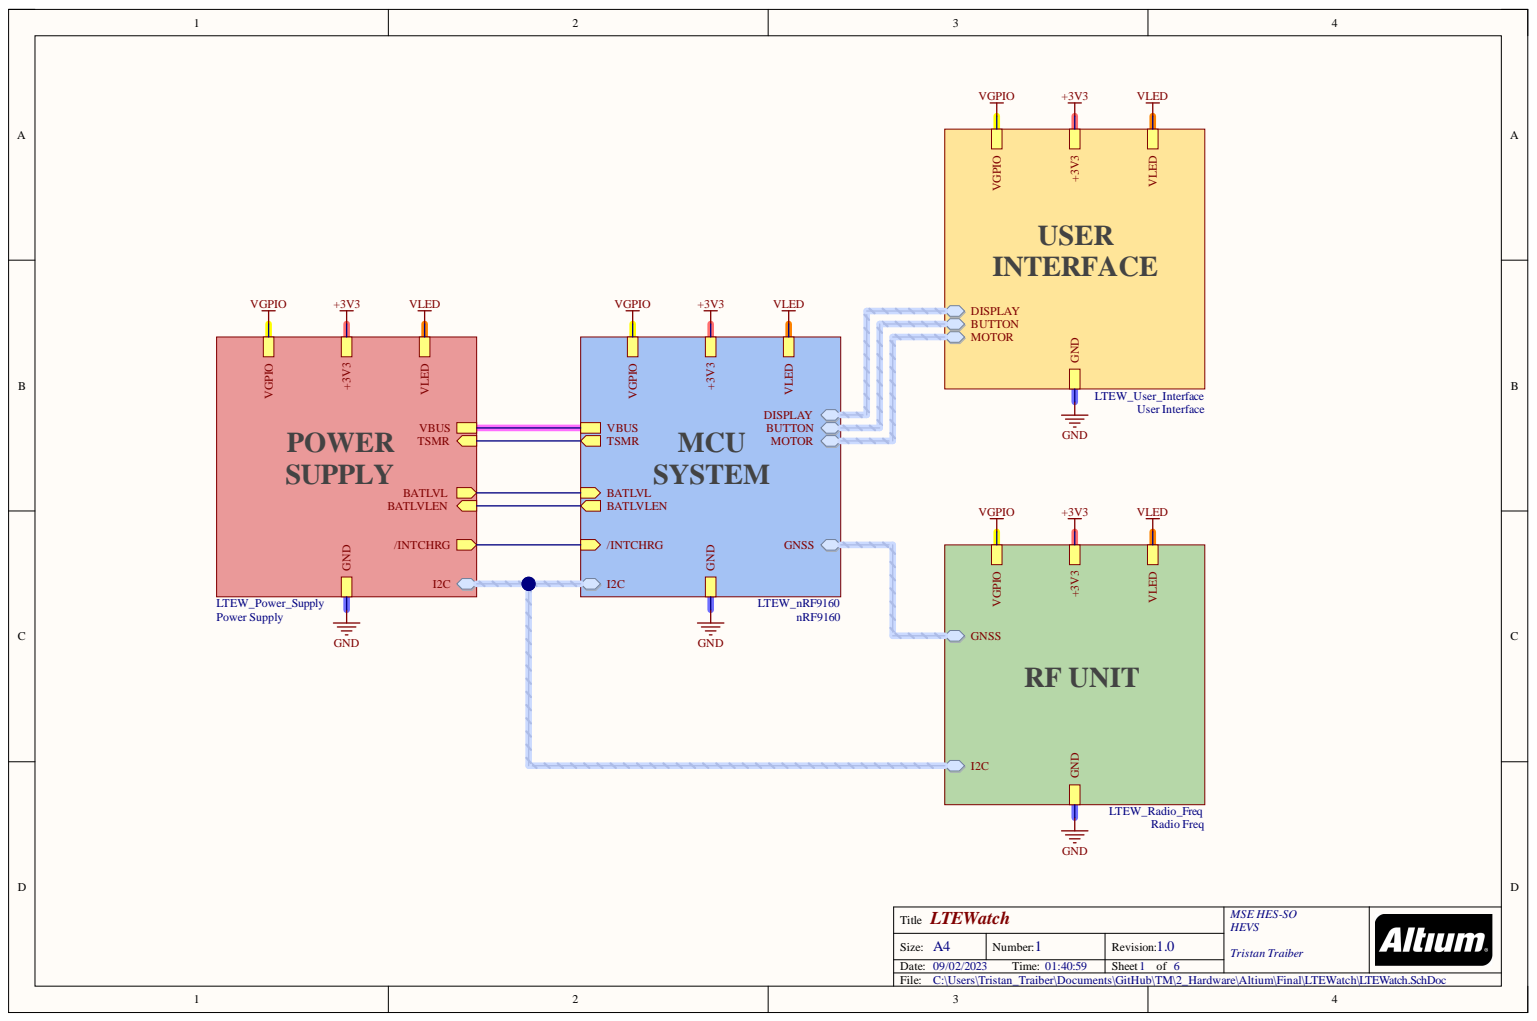
[picture p290: page 1]

C:\Users\Tristan_Traiber\Documents\GitHub\TM\2_Hardware\Altium\Final\LTEWatch\LTEWatch.SchDoc

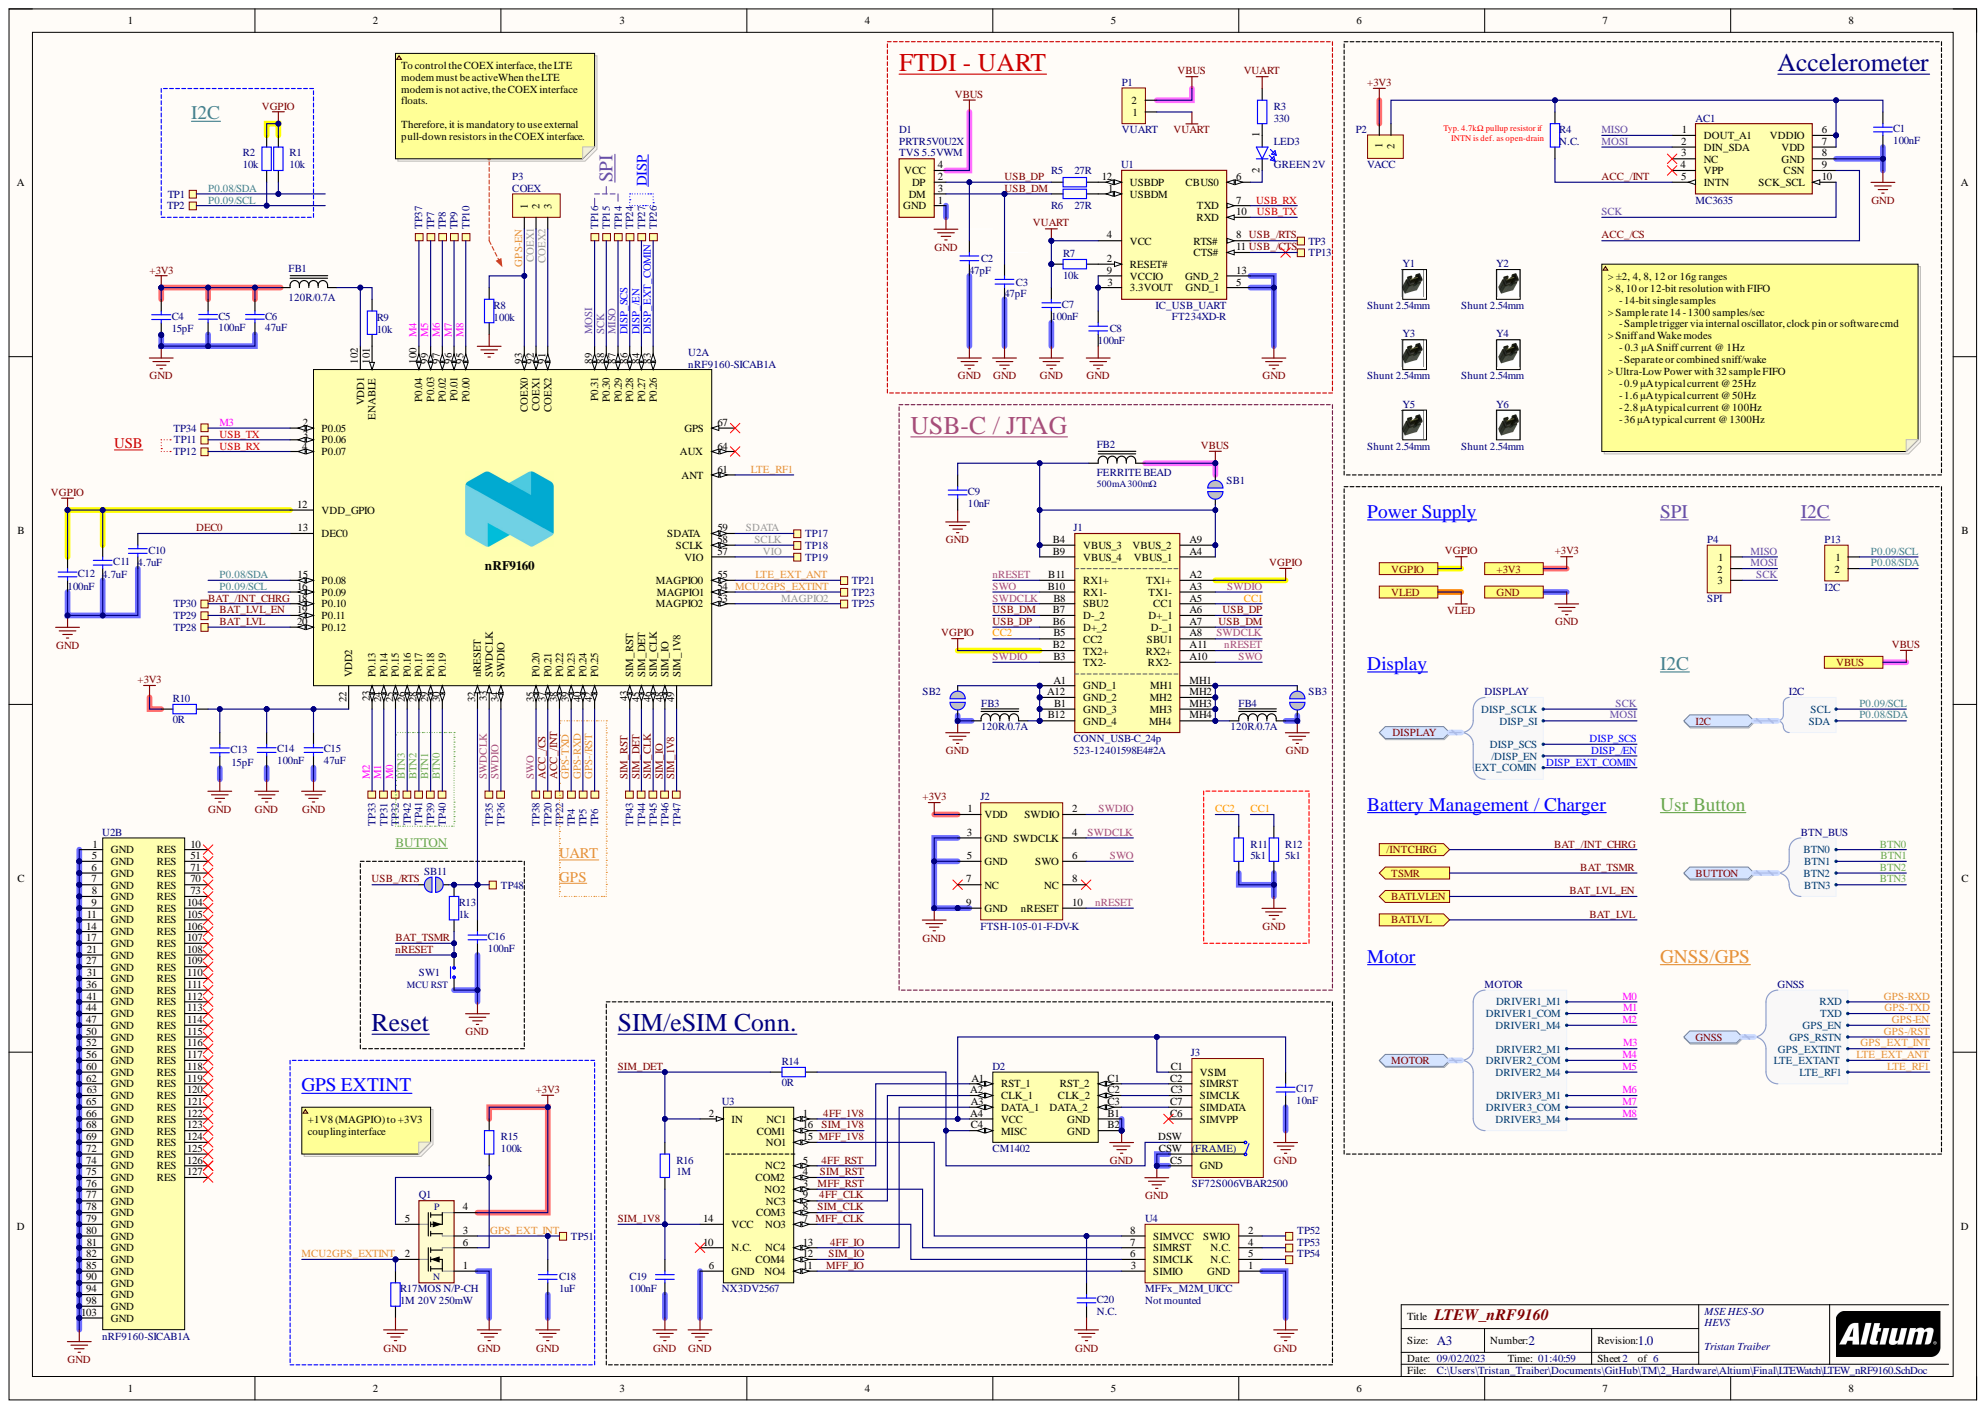
[picture p291: page 2]

To control theCOEX interface, theLTE
modem must be activeWhen theLTE
modem is not active, theCOEX interface
floats.

Therefore, it is mandatory to use external
pull-down resistorsin theCOEX interface.

Typ. 4.7kΩ pullup resistor if
INTN is def. as open-drain

R7 | RESET# 2

10k C3 | VCCIO 9

> ±2, 4, 8, 12 or 16g ranges
> 8, 10 or 12-bit resolution with FIFO
- 14-bit single samples
> Sample rate 14 - 1300 samples/sec
- Sample trigger via internal oscillator, clock pin orsoftware cmd
> Sniff and Wakemodes
- 0.3 μA Sniff current @ 1Hz
- Separate or combined sniff/wake
> Ultra-Low Power with 32 sampleFIFO

C:\Users\Tristan_Traiber\Documents\GitHub\TM\2_Hardware\Altium\Final\LTEWatch\LTEW_nRF9160.SchDoc

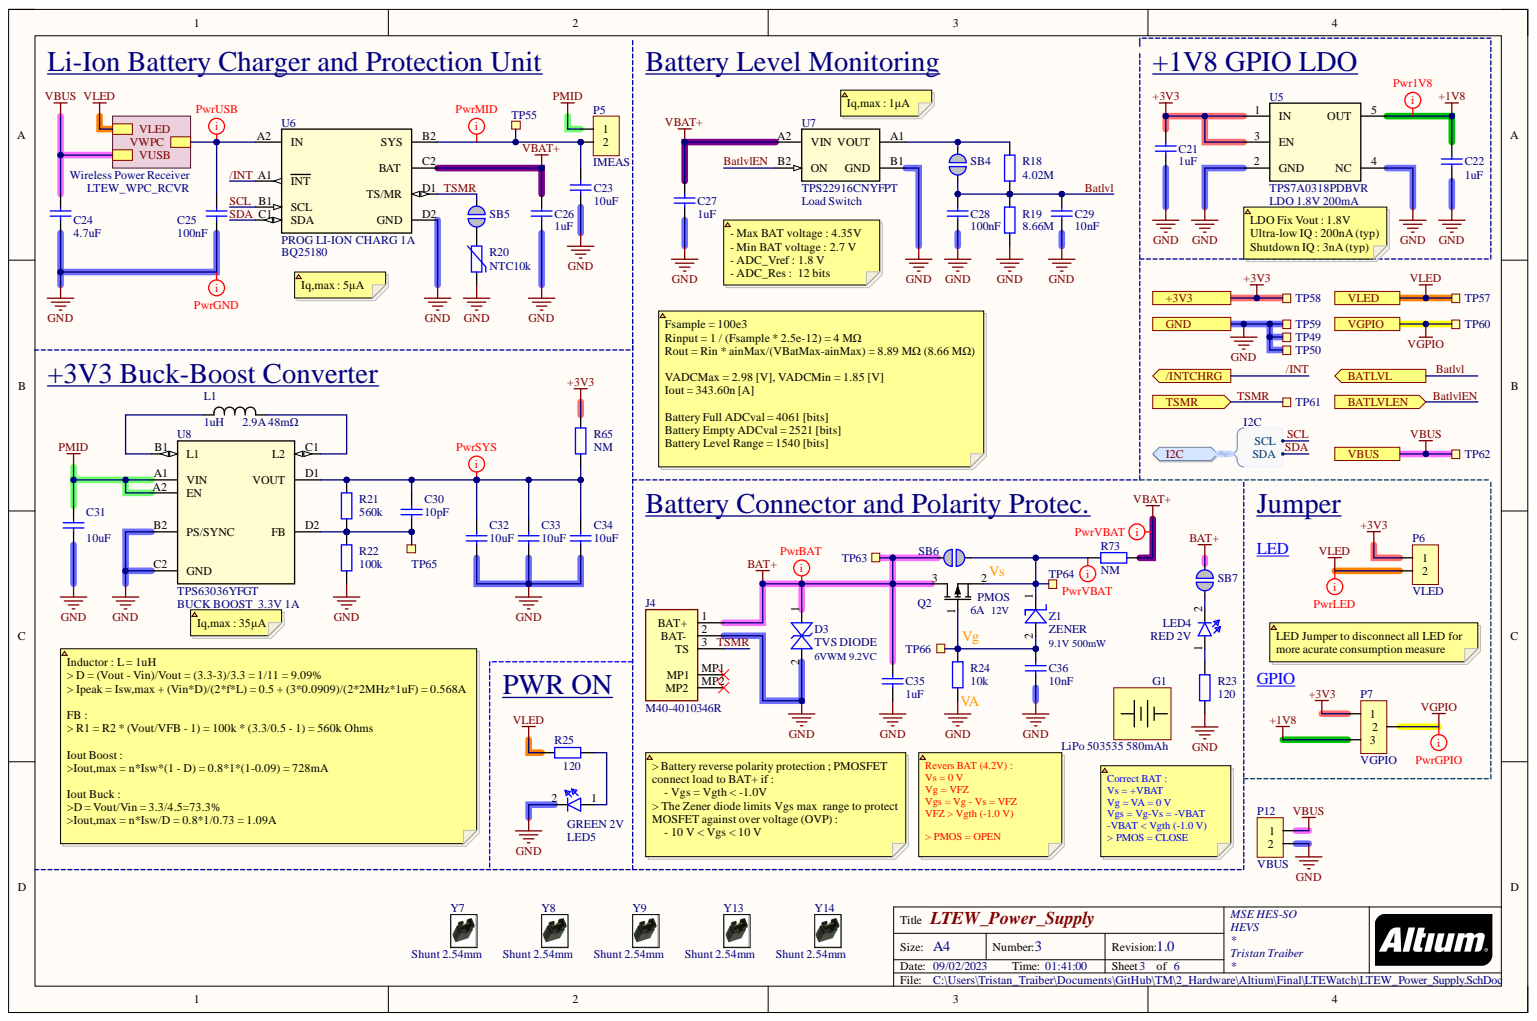
[picture p292: page 3]

TPS7A0318PDBVR
LDO 1.8V 200mA
LDO Fix Vout : 1.8V
Ultra-low IQ : 200nA (typ)
Shutdown IQ : 3nA (typ)

PROG LI-ION CHARG 1A

Fsample = 100e3
Rinput = 1 / (Fsample * 2.5e-12) = 4 MΩ
Rout = Rin * ainMax/(VBatMax-ainMax) = 8.89 MΩ (8.66 MΩ)

Battery Full ADCval = 4061 [bits]
Battery Empty ADCval = 2521 [bits]
Battery Level Range = 1540 [bits]

Battery Connector and Polarity Protec.

GND C2

LED Jumper to disconnect all LED for
more acurate consumption measure
GPIO

Inductor : L = 1uH
> D = (Vout - Vin)/Vout = (3.3-3)/3.3 = 1/11 = 9.09%
> Ipeak = Isw,max + (Vin*D)/(2*f*L) = 0.5 + (3*0.0909)/(2*2MHz*1uF) = 0.568A

> Battery reverse polarity protection ; PMOSFET
connect load to BAT+ if :
- Vgs = Vgth < -1.0V
> The Zener diode limits Vgs max range to protect
MOSFET against over voltage (OVP) :
- 10 V < Vgs < 10 V

Revers BAT (4.2V) :
Vg = VFZ
Vgs = Vg - Vs = VFZ
VFZ > Vgth (-1.0 V)

Correct BAT :
Vs = +VBAT
Vgs = Vg-Vs = -VBAT
-VBAT < Vgth (-1.0 V)
> PMOS = CLOSE

C:\Users\Tristan_Traiber\Documents\GitHub\TM\2_Hardware\Altium\Final\LTEWatch\LTEW_Power_Supply.SchDoc

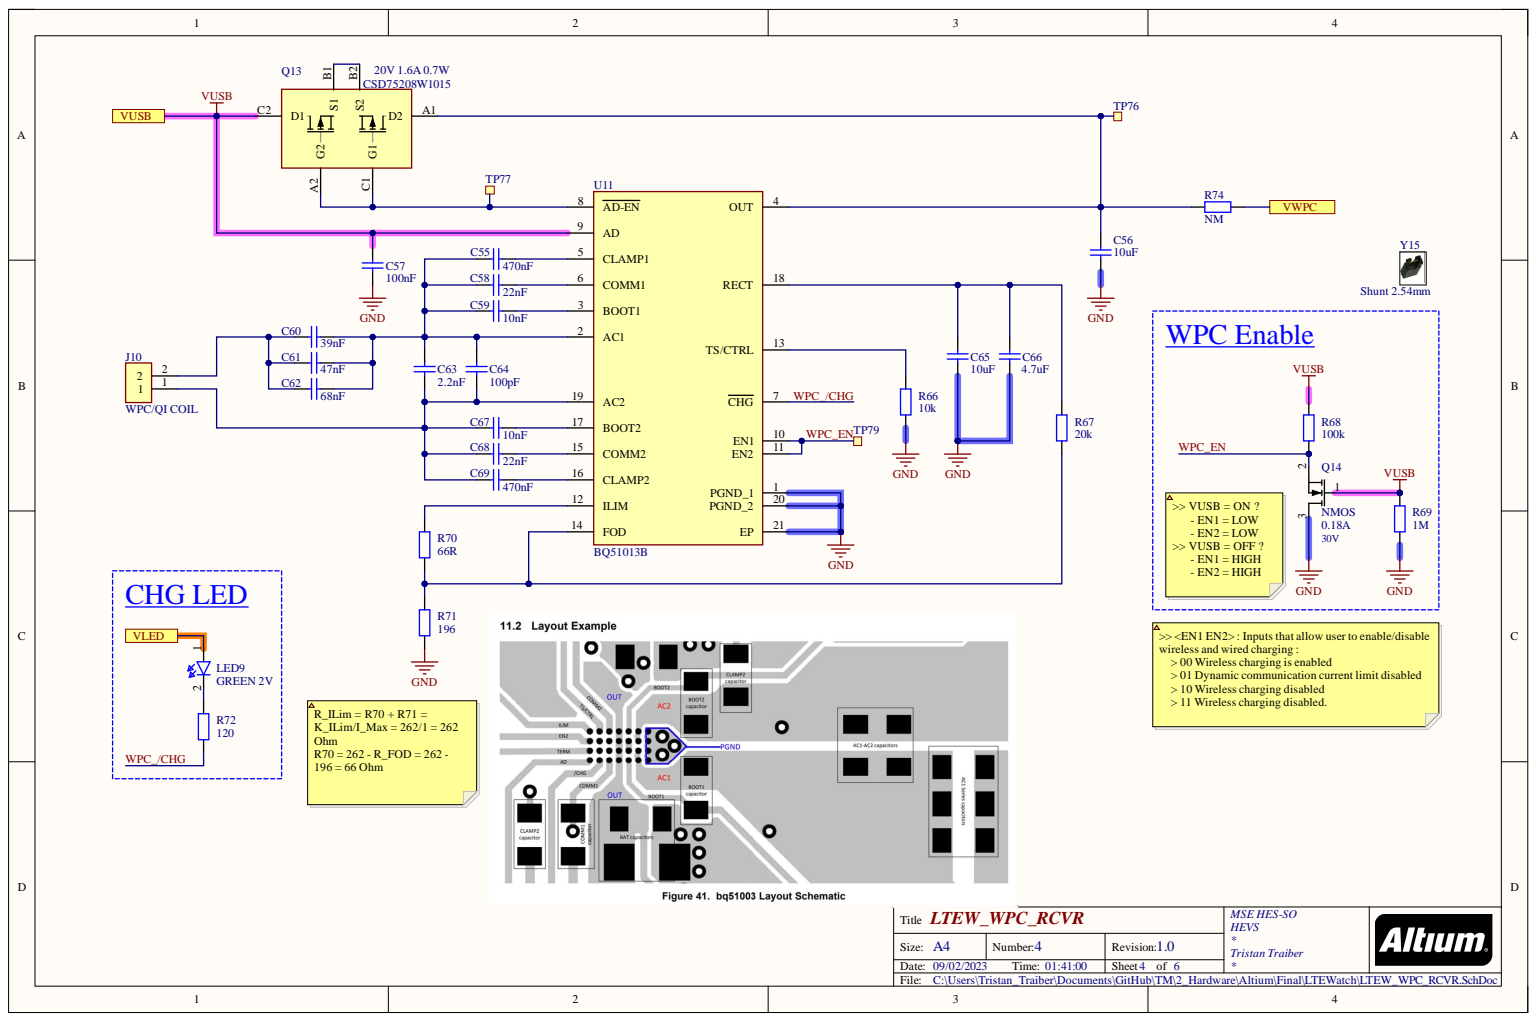
[picture p293: page 4]

1 6 | CL AMP2 PG N D _ 1 ILIM PG N D _ 2 FO D E P | 1

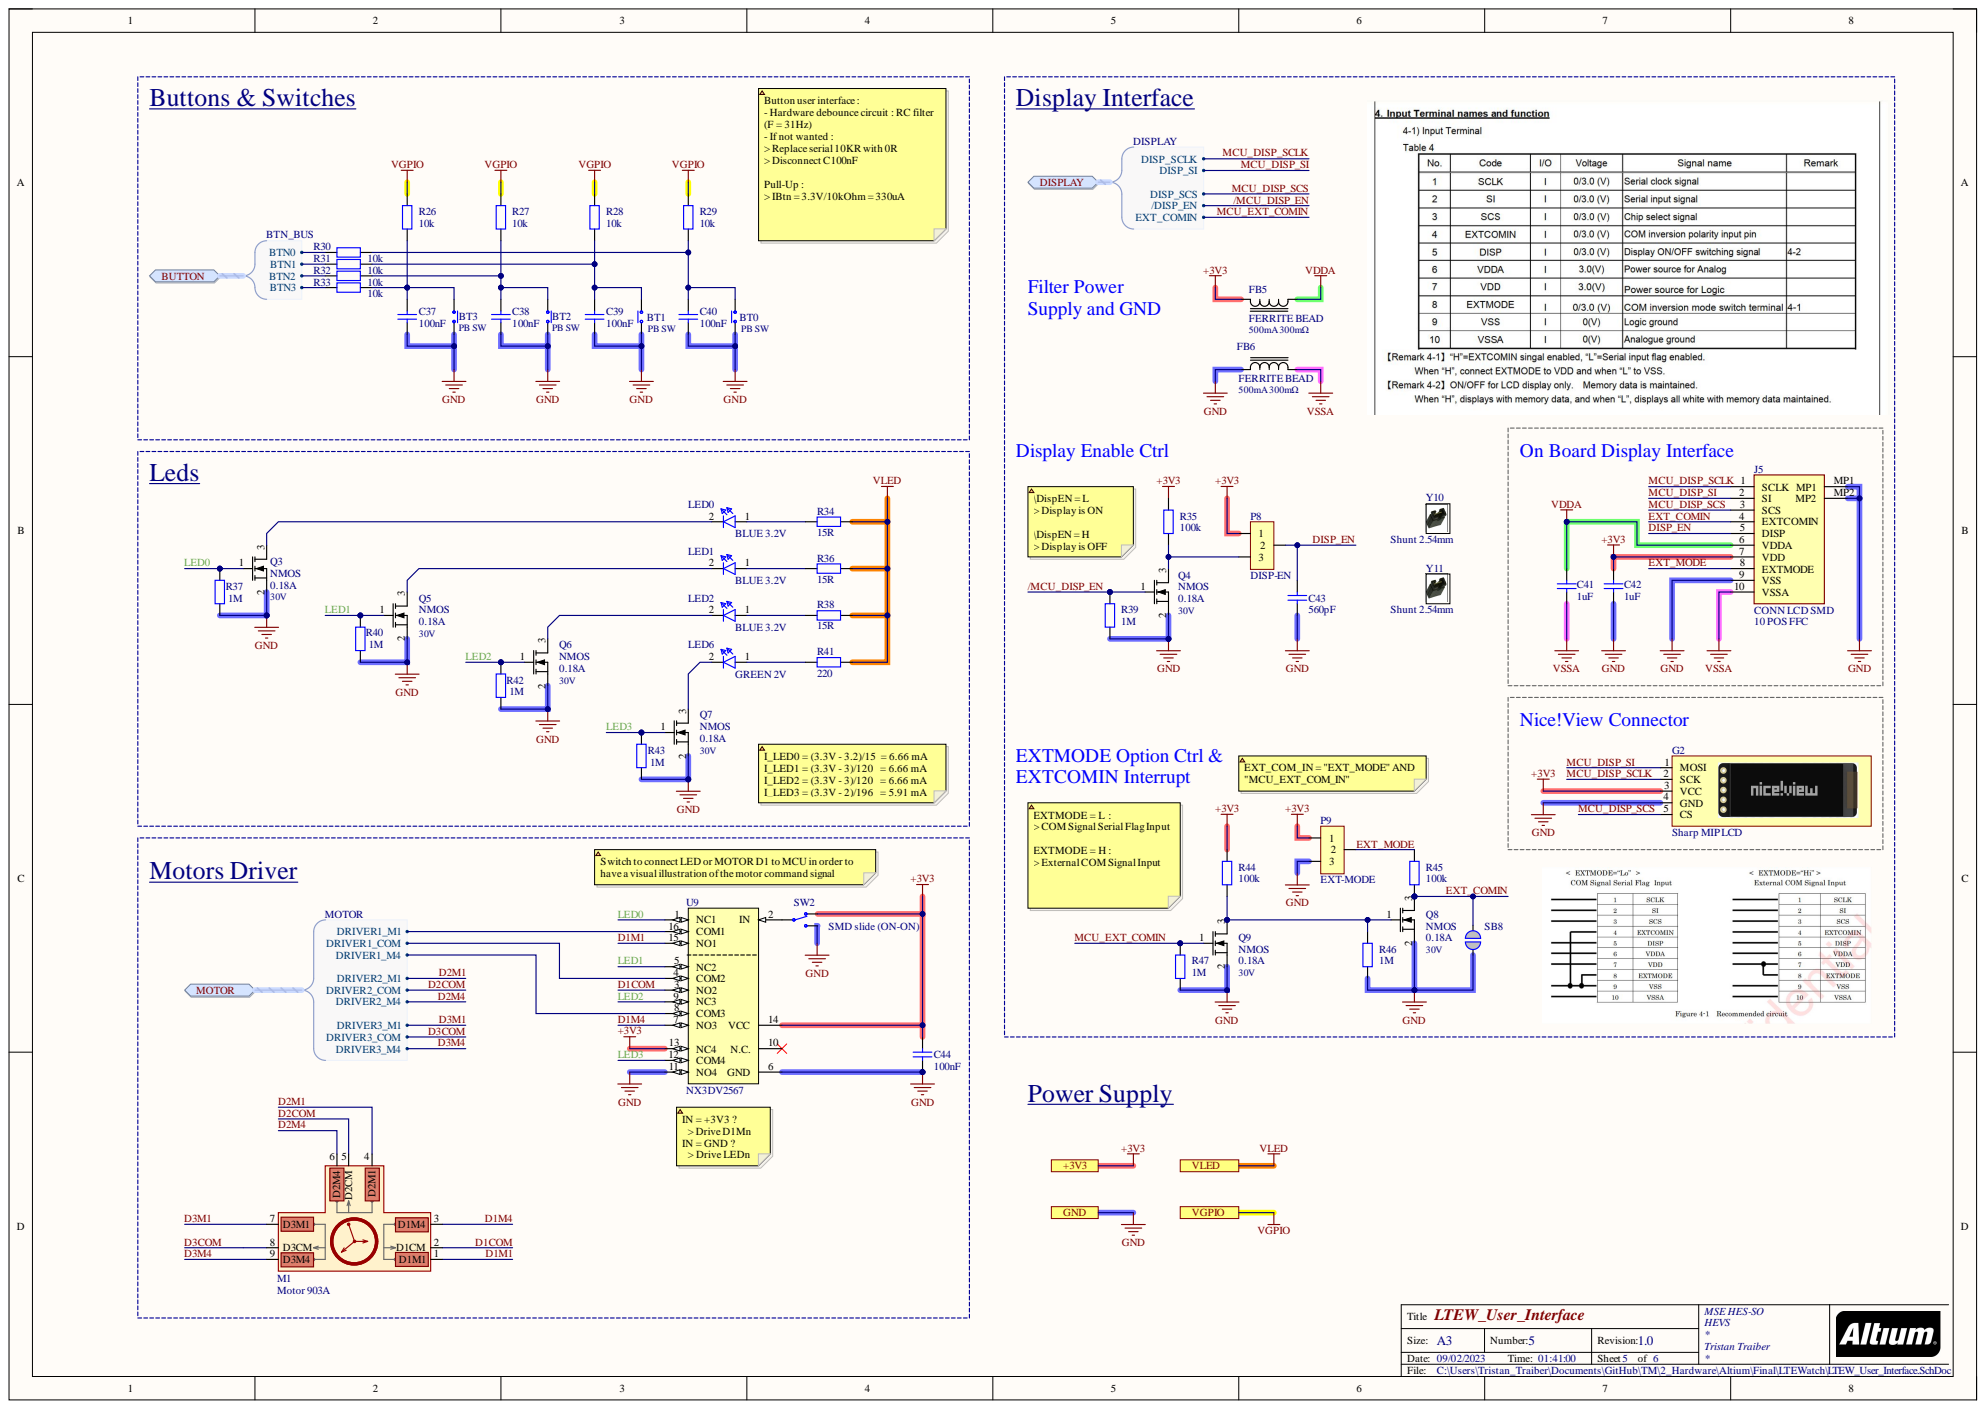
[picture p294: page 5]

Button user interface :
- Hardware debounce circuit : RC filter
- If not wanted :
> Replace serial 10KR with 0R
> Disconnect C100nF

10k

On Board Display Interface

EXT_MODE | EXTMODE 8

VDD 7

EXTMODE = L :
> COM Signal Serial Flag Input

Switch to connect LED or MOTOR D1 to MCU in order to
have a visual illustration ofthemotor command signal

SMD slide (ON-ON)

+3V3 | VLED

C:\Users\Tristan_Traiber\Documents\GitHub\TM\2_Hardware\Altium\Final\LTEWatch\LTEW_User_Interface.SchDoc

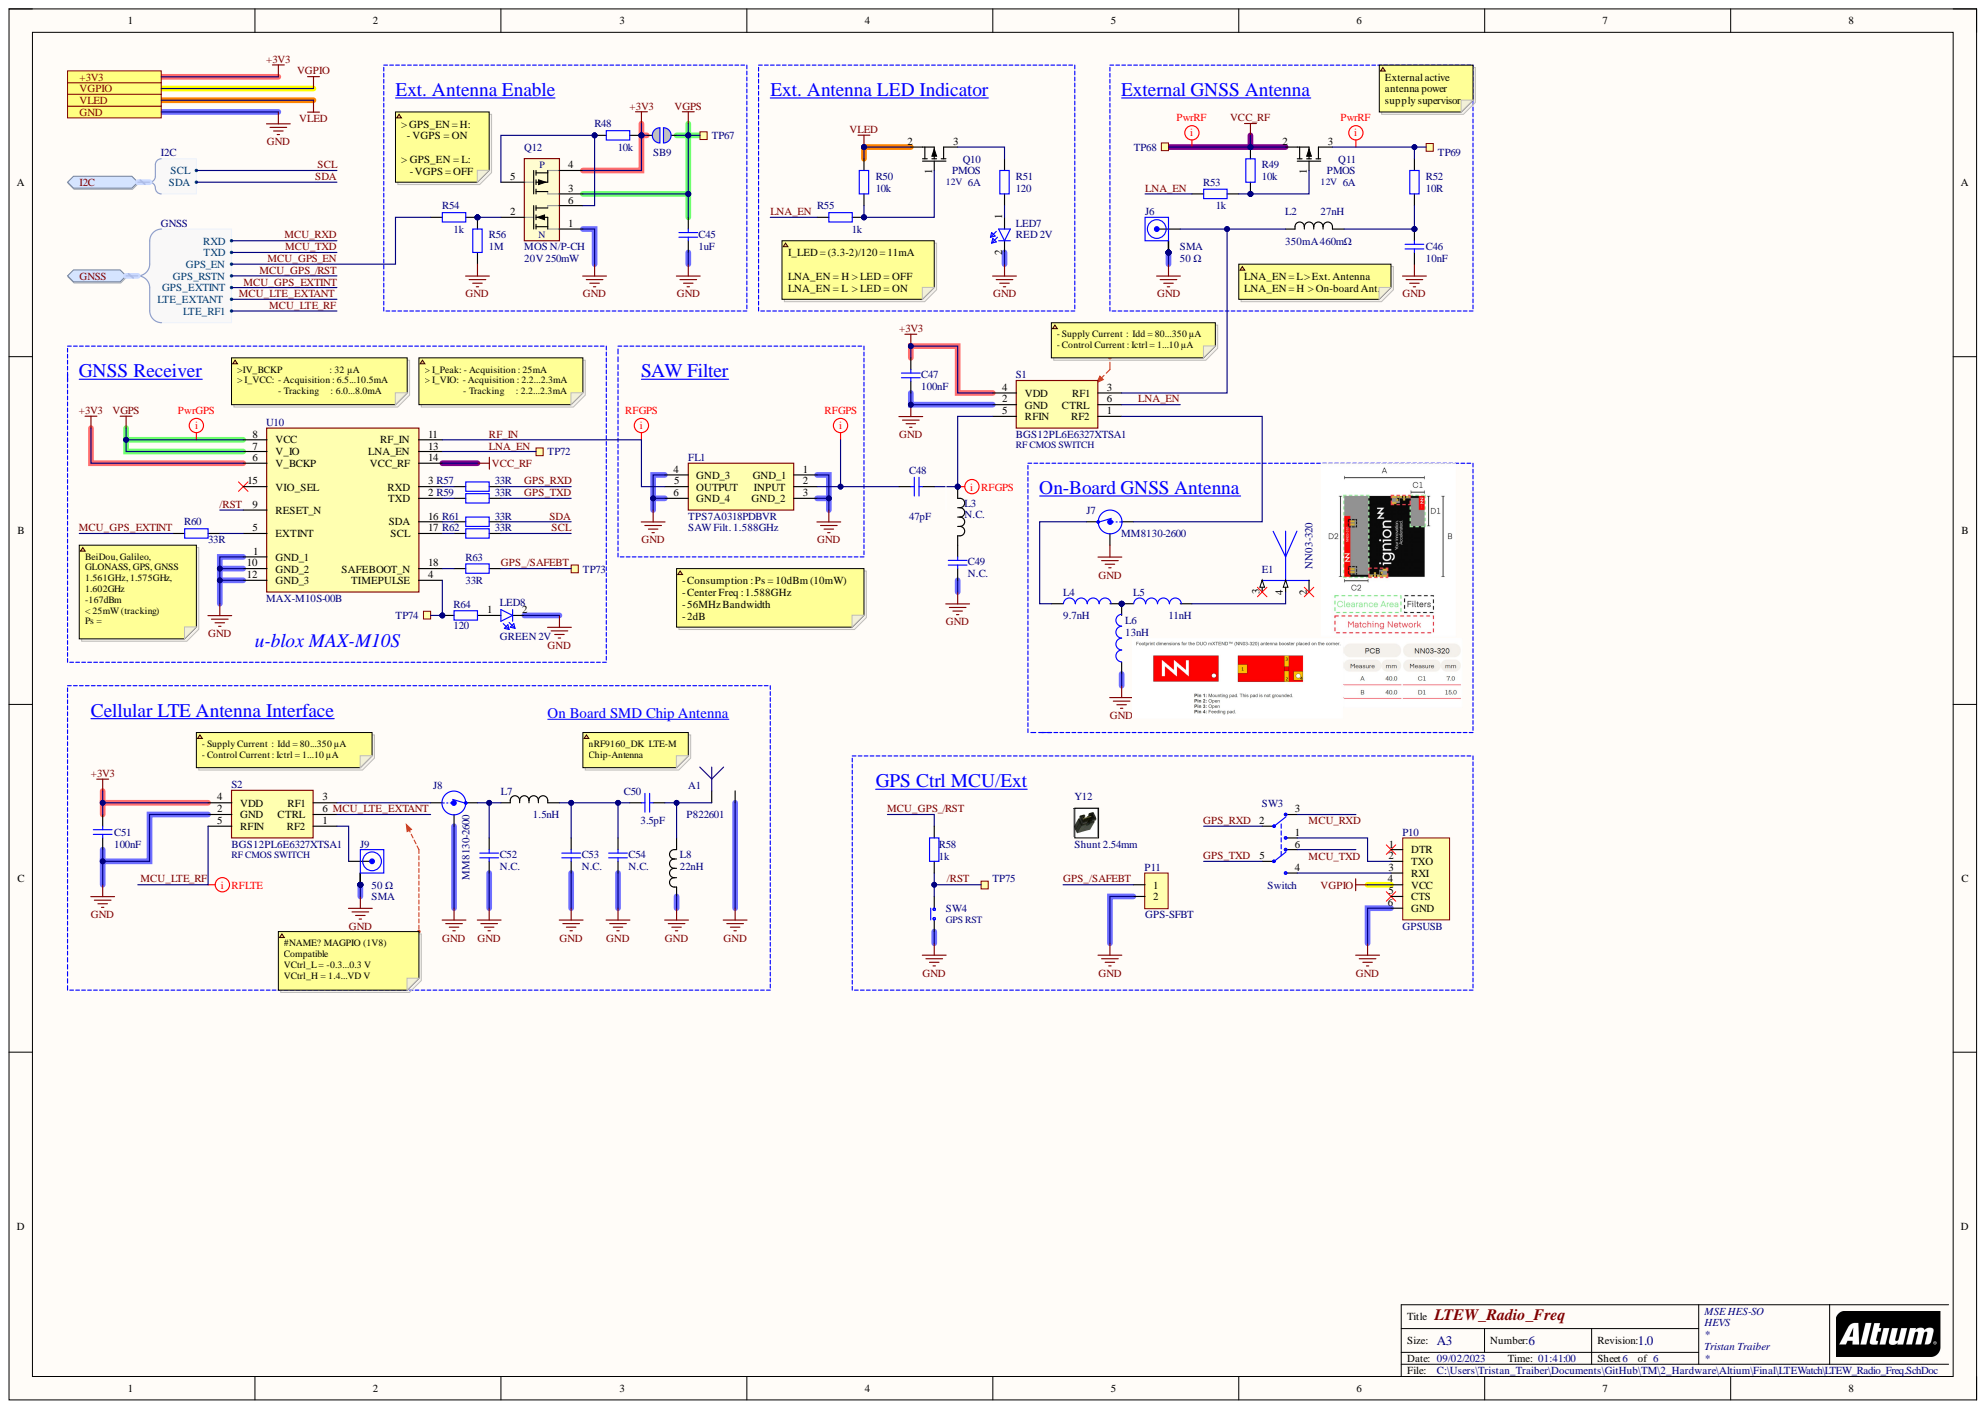
[picture p295: page 6]

Ext. Antenna LED Indicator

- Control Current : Ictrl = 1...10 µA

On-Board GNSS Antenna

- Supply Current : Idd = 80...350 µA

GPS Ctrl MCU/Ext

C:\Users\Tristan_Traiber\Documents\GitHub\TM\2_Hardware\Altium\Final\LTEWatch\LTEW_Radio_Freq.SchDoc

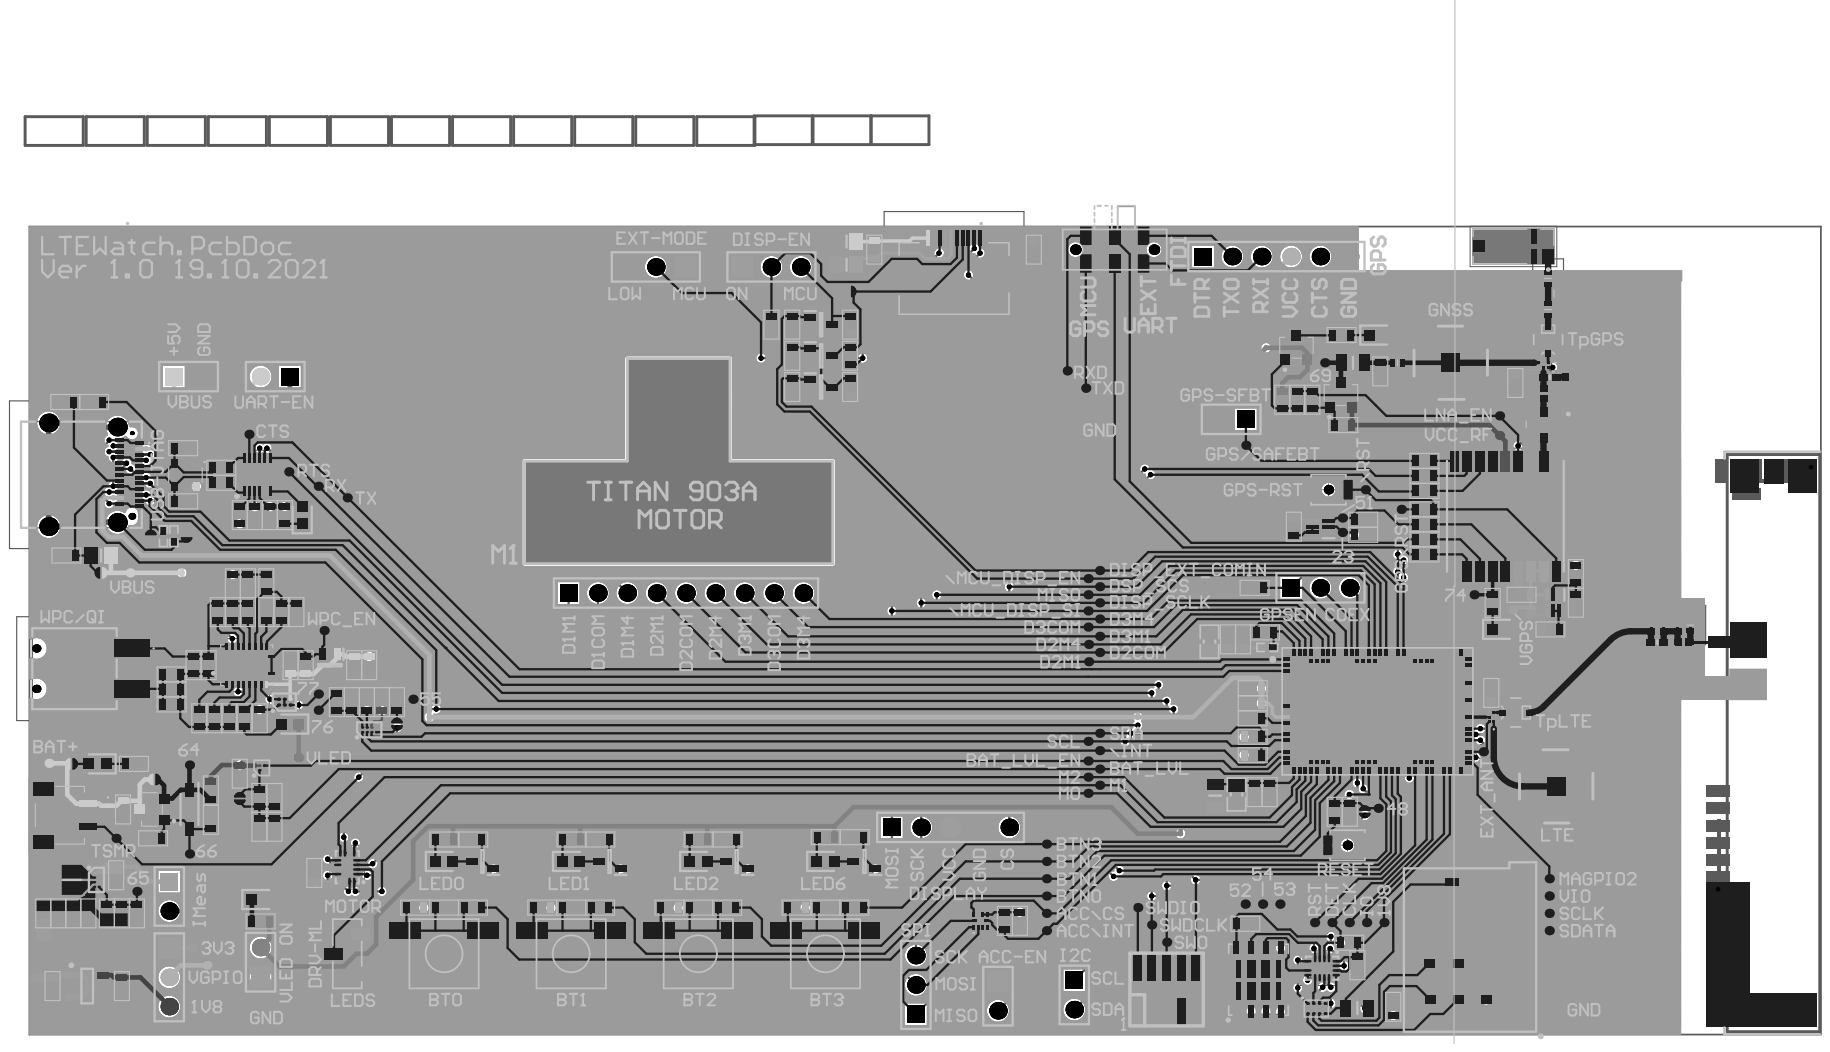
[picture p296: page 7]

Line # | ECassembly | Name | Tolerance | Voltage | TempCoef | Description | Designator | Footprint | Quantity | Manufacturer 1 | Manufacturer Part Number 1 | Manufacturer Lifecycle 1 | Supplier 1 | Supplier Part Number 1 | Supplier Unit Price 1 | Supplier Subtotal 1
P822601 | ANTENNA PRESTTA OCTABAND LTE | A1 | P822601 | 1 | Digi-Key | 939-1057-1-ND
MC3635 | Accéléromètres X, Y, Z Axis ±2g, 4g, 8g, 12g, 16g 10-LGA (1,6x1,6) | AC1 | MC3635 | 1 | Mouser | 498-MC3635
SKHUALE010 | Tactile Switch, SPNO, SMD, 160gf, 6.2x6.3x2.5mm | BT0, BT1, BT2, BT3 | Switch-PB-SMD-BT0, Switch-PB-SMD-BT1, Switch-PB-SMD-BT2, Switch-PB-SMD-BT3 | 4 | Mouser | 688-SKHUALE010
100nF | 0.1 µF ±10% 25V Condensateurs céramique X7R 0603 (1608métrique) | C1, C5, C7, C8, C12, C14, C16, C19, C25, C28, C37, C38, C39, C40, C44, C51, C57 | C0603 | 17 | Digi-Key | 1276-1006-1-ND
47pF | 47 pF ±5% 25V Ceramic Capacitor C0G, NP0 0603 (1608 Metric) | C2, C3 | C0603 | 2 | Digi-Key | 399-C0603C470J3GAC7867CT-ND
15pF | 15 pF ±5% 25V Ceramic Capacitor C0G, NP0 0603 (1608 Metric) | C4, C13 | C0603 | 2 | Digi-Key | 478-10804-1-ND
47uF | 47 µF ±20% 10V Ceramic Capacitor X5R 0805 (2012 Metric) | C6, C15 | CAPC2012X11L | 2 | Digi-Key | 490-9961-1-ND
10nF | 10000 pF ±5% 25V Condensateurs céramique C0G, NP0 0603 (1608métrique) | C9, C17, C29, C36, C46, C59, C67 | C0603 | 7 | Digi-Key | 445-2664-1-ND
4.7uF | 4.7 µF ±10% 25V Condensateurs céramique X6S 0603 (1608métrique) | C10, C11, C24, C66 | C0603 | 4 | Digi-Key | 490-7199-1-ND
1uF | 1 µF ±10% 25V Ceramic Capacitor X7R 0603 (1608 Metric) | C18, C21, C22, C26, C27, C35, C41, C42, C45 | C0603 | 9 | Mouser | 187-CL10B105KA8NNNC
10uF N.C. | 10 µF ±10% 25V Ceramic Capacitor X5R 0805 NC (2012 Metric) | C23, C31, C32, C33, C20 C34, C56, C65 | C0603 C0603 | 1 7 | Mouser | 81-GRM188R61E106KA3J
10pF | 10 pF ±5% 50V Ceramic Capacitor C0G, NP0 0603 (1608 Metric) | C30 | C0603 | 1 | Digi-Key | 478-1163-1-ND
560pF | 560 pF ±5% 25V Ceramic Capacitor C0G, NP0 0603 (1608 Metric) | C43 | C0603 | 1 | Digi-Key | 311-3957-1-ND
100nF | 0.1 µF ±10% 25V Ceramic Capacitor X7R 0402 (1005 Metric) | C47 | C0603 | 1 | Digi-Key | 1276-6720-1-ND
47pF | 47 pF ±5% 25V Ceramic Capacitor C0G, NP0 0402 (1005 Metric) | C48 | CAPC1005X55N | 1 | Digi-Key | 1292-1324-1-ND
N.C. | NC | C49, C52, C53, C54 | CAPC1005X55N | 4
3.5pF | 3.5 pF ±0,1pF 50V Condensateurs céramique C0G, NP0 0402 (1005métrique) | C50 | CAPC1005X55N | 1 | Mouser | 81-GJM1555C1H3R5BB1D
470nF | 0.47 µF ±10% 25V Ceramic Capacitor X7R 0603 (1608 Metric) | C55, C69 | C0603 | 2 | Digi-Key | 490-3291-1-ND
22nF | 0.022 µF ±10% 25V Ceramic Capacitor X7R 0603 (1608 Metric) | C58, C68 | C0603 | 2 | Digi-Key | 399-C0603C223K3RAC7867CT-ND
39nF | 0.039 µF ±10% 50V Ceramic Capacitor X7R 0603 (1608 Metric) | C60 | C0603 | 1 | Digi-Key | 1292-1436-1-ND
47nF | 0.047 µF ±10% 25V Ceramic Capacitor X7R 0603 (1608 Metric) | C61 | C0603 | 1 | Digi-Key | 478-1235-6-ND
68nF | 0.068 µF ±10% 25V Ceramic Capacitor X7R 0603 (1608 Metric) | C62 | C0603 | 1 | Digi-Key | 1292-1462-1-ND
2.2nF | 2200 pF ±5% 25V Ceramic Capacitor X7R 0603 (1608 Metric) | C63 | C0603 | 1 | Digi-Key | 478-12683-1-ND
100pF | 100 pF ±5% 25V Ceramic Capacitor C0G, NP0 0603 (1608 Metric) | C64 | C0603 | 1 | Digi-Key | 478-06033A101JAT2ACT-ND
TVS 5.5VWM | Clamp Ipp Tvs Diode Surface Mount SOT-143B | D1 | PRTR5V0U2X | 1 | Digi-Key | 1727-3884-1-ND
CM1402 | EMI Network Filter Arrays SIM CARD EMI FILTER WITH ESD PROTECTION | D2 | CM1402 | 1 | Digi-Key | CM1402-03CPOSTR-ND
TVS DIODE | 9.2V Clamp 5A (8/20µs) Ipp Tvs Diode Surface Mount SOD-882 | D3 | SP100701ETG | 1 | Digi-Key | F6187CT-ND
NN03-320 | Dual port antenna booster for GNSS, Bluetooth, 5G and UWB (1561 - 1606MHz, 2400 - 2500MHz, 3400 - 3800MHz, 3100 -4800MHz and 6000 - 10600 MHz). | E1 | XCVR_NN03-320 | 1 | Digi-Key | 2115-NN03-320CT-ND
120R/0.7A | Ferrite Bead, 120Ohm @ 100MHz, 700mA, 130mOhm Max | FB1, FB3, FB4 | INDC1005X04L | 3 | Digi-Key | 490-5439-1-ND
FERRITE BEAD | 600Ohms @ 100 MHz 1 Power, Signal Line Ferrite Bead 0805 (2012 Metric) 500mA 300mOhm | FB2, FB5, FB6 | BEADC2012X110N | 3 | Digi-Key | 240-2399-1-ND
TPS7A0318PDBVR | 1.588GHz Frequency GPS RF SAW Filter (Surface Acoustic Wave) 2dB 56MHz Bandwidth 6-SMD, No Lead | FL1 | B39162B3913U410 | 1 | Digi-Key | B39162B3913U410CT-ND
LiPo 503535 580mAh | 503535 3.8v 580mAh round lipo battery cells (Order : shorturl.at/tEFMZ) | G1 | Battery_Lipo_503535 | 1 | | https://batteryzone.de/products/503535-580mah-hochspannung-3-8v-runde-polymer-smart-watch-moxibustion-instrument-auto-smart-box-batterie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
Sharp MIP LCD | 503535 3.8v 580mAh round lipo battery cells (Order : shorturl.at/tEFMZ) | G2 | SHARP_MIP_LCD | 1 | | https://keycapsss.com/keyboard-parts/parts/219/nice-view-1.08-e-paper-display
CONN_USB-C_24p | USB-C (USB TYPE-C) USB 3.2 Gen 2 (USB 3.1 Gen 2, Superspeed + (USB 3.1)) Receptacle Connector 24 Position Surface Mount, Right Angle; Through Hole | J1 | 12401598E42A - JTAG | 1 | Mouser | 523-12401598E4#2A
FTSH-105-01-F-DV-K | Connector Header Surface Mount 10 position 0.050" (1.27mm) | J2 | HDR_2x5-SMD-1.27mm-K | 1 | Digi-Key | SAM8796-ND
SF72S006VBAR2500 | n 8 (6 + 2) Position Card Connector NANO SIM Surface Mount, Right Angle Gold | J3 | SF72S006VBAR2500 | 1 | Digi-Key | 670-2967-6-ND
M40-4010346R | Connector Header Surface Mount, Right Angle 3 position 0.039" (1.00mm) | J4 | M404010346R | 1 | Digi-Key | M40-4010346R-ND
CONN LCD SMD | 10 Position FFC, FPC Connector Contacts, Top 0.020" (0.50mm) Surface Mount, Right Angle | J5 | FH12A10S05SH55 | 1 | Digi-Key | HFK110CT-ND
SMA | SMA Connector Jack, Female Socket 50Ohm Surface Mount Solder | J6, J9 | 73251-1350 - GNSS, 73251-1350 - LTE | 2 | Digi-Key | WM9357-ND
MM8130-2600 | Coaxial Connector with Switch | J7, J8 | COAXIAL-SWF - GNSS, COAXIAL-SWF - LTE | 2 | Digi-Key | 490-4981-1-ND
WPC/QI COIL | 2 Position Wire to Board Terminal Block Horizontal with Board 0.138" (3.50mm) Surface Mount | J10 | 23839422 | 1 | Digi-Key | 17-2383942-2CT-ND
2.9A 48mΩ | 1 µH Shielded Drum Core, Wirewound Inductor 2.9 A 48mOhm Max 0806 (2016 Metric) | L1 | 1286ASH1R0MP2 | 1 | Digi-Key | 490-16593-1-ND
350mA 460mΩ | 27 nH Unshielded Multilayer Inductor 350mA 460mOhm Max 0402 (1005 Metric) | L2 | LQG15WH0N7B02D | 1 | Digi-Key | 490-2628-1-ND
N.C. 9.7nH | N.C. 9.7 nH Non blindé Bobiné Inducteur 1.4 A 81mOhms maxi 0402 (1005métrique) | L3 L4 | INDC1005X37N LQW15AN10NG80D | 1 1 | Mouser | 81-LQW15AN9N7G80D
11nH | 11 nH Unshielded Drum Core, Wirewound Inductor 1.4 A 65mOhm 0402 (1005 Metric) | L5 | LQW15AN10NG80D | 1 | Digi-Key | 2035-1078-1-ND
13nH | 13 nH Unshielded Drum Core, Wirewound Inductor 870mA 140mOhm 0402 (1005 Metric) | L6 | LQW15AN10NG80D | 1 | Digi-Key | 2035-1525-1-ND
1.5nH | 1.5 nH Non blindé Couche mince Inducteur 700mA 250mOhms maxi 0402 (1005 métrique) | L7 | INDC1005X37N | 1 | Digi-Key | 535-10356-1-ND
22nH | 22 nH Non blindé Bobiné Inducteur 780mA 202mOhms maxi 0402 (1005métrique) | L8 | LQW15AN10NG80D | 1 | Digi-Key | 490-7628-1-ND
BLUE 3.2V | Blue 470nm LED Indication - Discrete 3.2V 0603 (1608 Metric) | LED0, LED1, LED2 | LEDC1608X80N | 3 | Digi-Key | 732-4966-1-ND
GREEN 2V | Green 570nm LED Indication - Discrete 2V 0603 (1608 Metric) | LED3, LED5, LED6, LED8, LED9 | LEDC1608X80N | 5 | Digi-Key | 732-4980-1-ND
RED 2V | Red 625nm LED Indication - Discrete 2V 0603 (1608 Metric) | LED4, LED7 | LEDC1608X80N | 2 | Digi-Key | 732-4978-1-ND
Motor 903A | Titan 903A : 3 Hands Bidirectional, independent motor | M1 | MOTOR | 1
VUART VACC | Header, 2-Pin Header, 2-Pin | P1 P2 | HDR1X2 - UART HDR1X2 - ACCEL | 1 1 | Mouser Mouser | 649-1012937890201BLF 649-1012937890201BLF
COEX | Header, 3-Pin | P3 | HDR1X3 - COEX | 1 | Digi-key | 952-2263-ND
SPI | Header, 3-Pin | P4 | HDR1X3 - SPI | 1 | Digi-key | 952-2263-ND
IMEAS | Header, 2-Pin | P5 | HDR1X2 - IMEAS | 1 | Mouser | 649-1012937890201BLF
VLED | Header, 2-Pin | P6 | HDR1X2 - VLED | 1 | Mouser | 649-1012937890201BLF
DISP-EN VGPIO EXT-MODE | Header, 3-Pin Header, 3-Pin Header, 3-Pin | P8 P7 P9 | HDR1X3 - DISP_EN HDR1X3 - VGPIO HDR1X3 - EXT_MODE | 1 1 1 | Digi-key Digi-key Digi-key | 952-2263-ND 952-2263-ND 952-2263-ND
GPSUSB VBUS GPS-SFBT I2C | Header, 6-Pin Header, 2-Pin Header, 2-Pin Header, 2-Pin | P10 P12 P11 P13 | HDR1X6 - GPS HDR1X2 - VIN HDR1X2 - GPSSAFEBOOT HDR1X2 - I2C | 1 1 1 1 | Digi-Key Mouser Mouser Mouser | 732-5319-ND 649-1012937890201BLF 649-1012937890201BLF 649-1012937890201BLF
MOS N/P-CH | Mosfet Array N and P-Channel 20V 485mA, 370mA 250mW Surface Mount SC-89 (SOT-563F) | Q1, Q12 | SOT50P160X60-6N | 2 | Digi-Key | SI1016X-T1-GE3CT-ND
PMOS | P-Channel 12 V 6A (Ta) 1W (Ta) Surface Mount SOT-23F | Q2, Q10, Q11 | SSM3J332RLFT | 3 | Digi-Key | SSM3J338RLFCT-ND
NMOS | N-Channel 30 V 180mA (Ta) 260mW (Ta), 1.1W (Tc) Surface Mount SOT-323 | Q3, Q4, Q5, Q6, Q7, Q8, Q9, Q14 | SOT65P210X110-3N | 8 | Digi-Key | 1727-1288-1-ND
20V 1.6A 0.7W | Mosfet Array 2 P-Channel (Dual) Common Source 20V 1.6A 750mW Surface Mount 6-DSBGA (1x1.5) | Q13 | BGA6C50P2X3_95X145X62 | 1 | Digi-Key | 296-38339-1-ND
10k | 10 kOhms ±1% 0.1W, 1/10W Chip Resistor 0603 (1608 Metric) Moisture Resistant Thick Film | R1, R2, R7, R9, R24, R26, R27, R28, R29, R30, R31, R32, R33, R48, R49, R50, R66 | RES0603 | 17 | Digi-Key | 311-10.0KHRCT-ND
330 | 330Ohms ±1% 0.1W, 1/10W Chip Resistor 0603 (1608 Metric) Automotive AEC-Q200 Thick Film | R3 | RES0603 | 1 | Digi-Key | CR0603-FX-3300ELFCT-ND
N.C. 27R | N.C. 27Ohms ±1% 0.1W, 1/10W Chip Resistor 0603 (1608 Metric) Automotive AEC-Q200 Thick Film | R4 R5, R6 | RES0603 RES0603 | 1 2 | Digi-Key | P27.0HCT-ND
100k | RES SMD 100K OHM 1% 1/8W 0603 | R8, R15, R22, R35, R44, R45, R68 | RES0603 | 7 | Digi-Key | 311-100KCRCT-ND
0R | 0Ohms Jumper 0.1W, 1/10W Chip Resistor 0603 (1608 Metric) Moisture Resistant Thick Film | R10, R14 | RESC2012X60N | 2 | Digi-Key | 311-0.0GRCT-ND
5k1 | 5.1 kOhms ±1% 0.1W, 1/10W Chip Resistor 0603 (1608 Metric) Moisture Resistant Thick Film | R11, R12 | RES0603 | 2 | Digi-Key | 311-5.10KHRDKR-ND
1k | 1 kOhms ±1% 0.1W, 1/10W Chip Resistor 0603 (1608 Metric) Moisture Resistant Thick Film | R13, R53, R54, R55, R58 | RES0603 | 5 | Digi-Key | 311-1.00KHRCT-ND
1M | 1 MOhms ±1% 0.1W, 1/10W Chip Resistor 0603 (1608 Metric) Automotive AEC-Q200 Thick Film | R16, R17, R37, R39, R40, R42, R43, R46, R47, R56, R69 | RES0603 | 11 | Digi-Key | P1.00MHCT-ND
4.02M | 4.02 MOhms ±1% 0,1W, 1/10W Pavé résistif 0603 (1608métrique) Résistant à l’humidité Couche épaisse | R18 | RES0603 | 1 | Digi-Key | YAG5698CT-ND
8.66M | 8.66 MOhms ±1% 0,1W, 1/10W Pavé résistif 0603 (1608métrique) AutomobileAEC-Q200 Couche épaisse | R19 | RES0603 | 1 | Digi-Key | 541-8.66MHCT-ND
NTC10k 560k | NTC Thermistor 10k 0603 (1608 Metric) 560 kOhms ±1% 0.1W, 1/10W Chip Resistor 0603 (1608 Metric) Automotive AEC-Q200, Moisture Resistant Thick Film | R20 R21 | C0603 RES0603 | 1 1 | Digi-Key Digi-Key | P10547CT-ND 311-560KLDCT-ND
120 | 1 MOhms ±1% 0.1W, 1/10W Chip Resistor 0603 (1608 Metric) Automotive AEC-Q200 Thick Film | R23, R25, R51, R64, R72 | RES0603 | 5 | Digi-Key | A129677CT-ND
15R | 15Ohms ±1% 0.1W, 1/10W Chip Resistor 0603 (1608 Metric) Moisture Resistant Thick Film | R34, R36, R38 | RES0603 | 3 | Digi-Key | 311-15.0HRTR-ND
220 | 220Ohms ±1% 0.1W, 1/10W Chip Resistor 0603 (1608 Metric) Moisture Resistant Thick Film | R41 | RES0603 | 1 | Digi-Key | 311-220HRTR-ND
10R | 10Ohms ±5% 0.25W, 1/4W Chip Resistor 0805 (2012 Metric) Automotive AEC-Q200 Thick Film | R52 | RESC2012X60N | 1 | Digi-Key | 2019-RK73B2ATTD100JCT-ND
33R | 33Ohms ±1% 0.1W, 1/10W Chip Resistor 0603 (1608 Metric) Thin Film | R57, R59, R60, R61, R62, R63 | RES0603 | 6 | Digi-Key | 13-RT0603FRE0733RLCT-ND
NM | 8.66 MOhms ±1% 0,1W, 1/10W Pavé résistif 0603 (1608métrique) AutomobileAEC-Q200 Couche épaisse | R65, R73, R74 | RES0603 | 3 | Digi-Key | 541-8.66MHCT-ND
20k | 20 kOhms ±1% 0.1W, 1/10W Chip Resistor 0603 (1608 Metric) Moisture Resistant Thick Film | R67 | RES0603 | 1 | Digi-Key | 311-20.0KHRCT-ND
66R | 66.5Ohms ±1% 0.1W, 1/10W Chip Resistor 0603 (1608 Metric) Moisture Resistant Thick Film | R70 | RES0603 | 1 | Digi-Key | 311-66.5HRCT-ND
196 | 196Ohms ±1% 0.1W, 1/10W Chip Resistor 0603 (1608 Metric) Moisture Resistant Thick Film | R71 | RES0603 | 1 | Digi-Key | 311-196HRDKR-ND
BGS12PL6E6327XTSA1 | RF Switch IC WLAN SPDT 50Ohm PG-TSNP-6-10 | S1, S2 | BGS12WN6E6327XTSA1 | 2 | Digi-Key | BGS12PL6E6327XTSA1CT-ND
SKHUALE010 | Tactile Switch, SPNO, SMD, 160gf, 6.2x6.3x2.5mm | SW1 | Push Button C2.5X3.0OMRON B3U-1000P(M)-B - MCU RST | 1 | Mouser | 688-SKHUALE010
SMD slide (ON-ON) Switch SKHUALE010 | SMD slide Switch (ON-ON) SMD slide Switch (ON-ON) Tactile Switch, SPNO, SMD, 160gf, 6.2x6.3x2.5mm | SW2 SW3 SW4 | CJS-120xA - M/L JS102011JAQN - GPS Push Button C2.5X3.0OMRON B3U-1000P(M)-B - GPS RST | 1 1 1 | Mouser Digi-Key Mouser | 229-CJS-1200TA CKN10722CT-ND 688-SKHUALE010
IC_USB_UART | USB Bridge, USB to UART USB 2.0UART Interface 12-DFN (3x3) | U1 | SON45P300X300X75-13N-D | 1 | Digi-Key | 768-1178-1-ND
nRF9160-SICAB1A | Low power System-in-Package with integrated LTE-M/NB-IoT modem and GPS | U2 | LGA50P1600X1050X104-161N | 1 | Digi-Key | 1490-NRF9160-SICA-B1A-R7CT-ND
NX3DV2567 | Low-ohmic four-pole double-throw analog switch | U3, U9 | XQFN40P180X260X50-16N | 2 | Mouser | 771-NX3DV2567GU115
MFFx_M2M_UICC TPS7A0318PDBVR | M2M UICC SIM Card Linear Voltage Regulator IC Positive Fixed 1 Output 200mA SOT-23-5 | U4 U5 | SON127P600X90_HS-8N SOT95P280X145-5N | 1 1 | N.A. Digi-Key | N.A. 296-TPS7A0318PDBVRCT-ND
BQ25180 | Charger IC Lithium Ion/Polymer, Lithium Iron Phosphate 8-DSBGA | U6 | BGA8C40P2X4_100X155X50 | 1 | Mouser | 595-BQ25180YBGR
TPS22916CNYFPT | Power Switch/Driver 1:1 P-Channel 2A 4-DSBGA | U7 | BGA4C40P2X2_78X78X50 | 1 | Mouser | 595-TPS22916CNYFPT
TPS63036YFGT | Buck-Boost Switching Regulator IC Positive Adjustable 1.2V 1Output 1A (Switch) 8-UFBGA, DSBGA | U8 | BGA8C40P2X4_108X181X62 | 1 | Mouser | 595-TPS63036YFGT
MAX-M10S-00B | MAX-M10 RF Receiver BeiDou, Galileo, GLONASS, GPS, GNSS 1.561GHz, 1.575GHz, 1.602GHz -167dBm 921.6kbps | U10 | MAXM10S00B | 1 | Mouser | 377-MAX-M10S-00B
BQ51013B | Wireless Power Receiver PMIC 20-VQFN (3.5x4.5) | U11 | BQ51050BRHLR | 1 | Mouser | 595-BQ51013BRHLR
Shunt 2.54mm | Shunt Jumper 2.54mm Black | Y1, Y2, Y3, Y4, Y5, Y6, Y7, Y8, Y9, Y10, Y11, Y12, Y13, Y14, Y15 | Shunt_2.54mm_Horizontal | 15 | Digi-Key | S9001-ND
ZENER | Zener Diode 9.1 V 500mW ±6% Surface Mount SOD-123 | Z1 | SOD3716X145N | 1 | Digi-Key | BZT52C9V1-FDICT-ND
