traibertr/LTEWatch/1_Document/2_Report/Include/Figure/hardware/board_struct.pdf

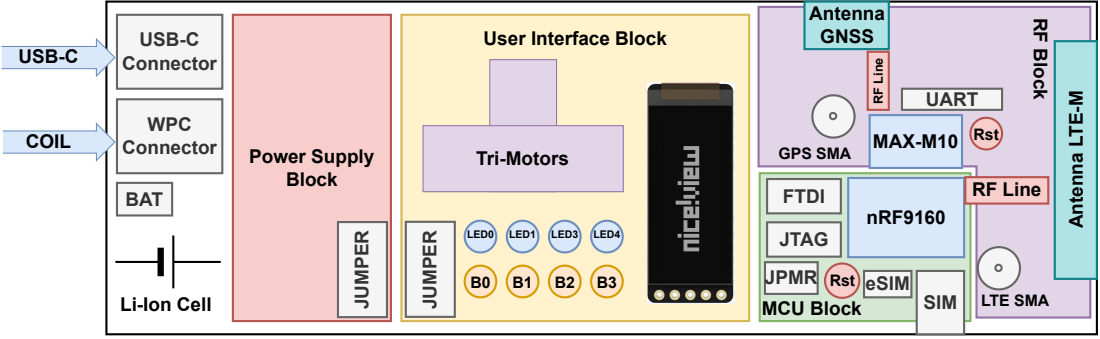
[picture p297: page 1]
RF Block; MCU Block; Power Supply Block; USB-C Connector; nRF9160; Tri-Motors; Antenna LTE-M; USB-C; WPC; COIL; Connector; LED0; LED1; LED3; LED4; Antenna GNSS; RF Line; JTAG; FTDI; Li-Ion Cell; SIM; Rst eSIM; MAX-M10 Rst; GPS SMA; UART; JUMPER; JPMR; BAT

User Interface Block

RF Line LTE SMA
