traibertr/LTEWatch/1_Document/2_Report/Include/Figure/hardware/data_display_blk.pdf

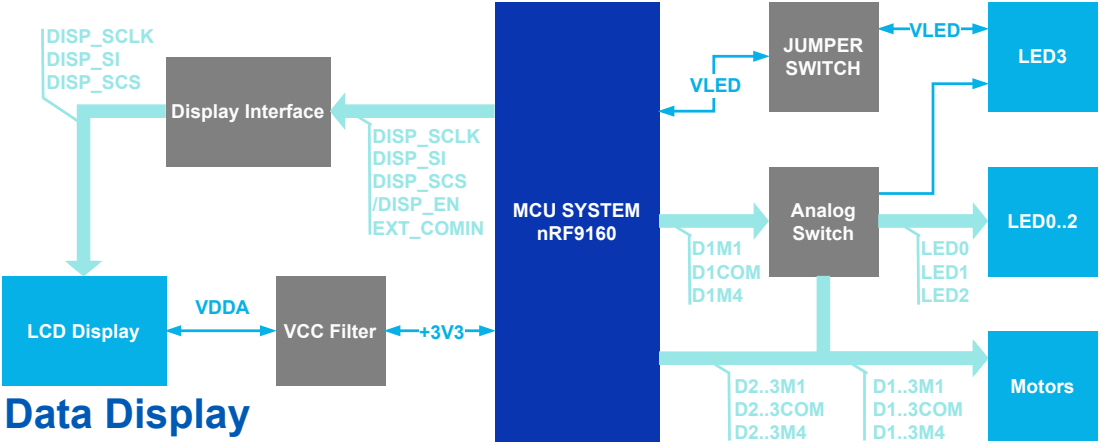
[picture p298: page 1]
Data Display; MCU SYSTEM nRF9160; VLED; JUMPER SWITCH; LED0..2; Motors; Analog Switch; LED3; D2..3M1 D2..3COM D2..3M4; D1M1 D1COM D1M4; LED0 LED1 LED2; D1..3M1 D1..3COM D1..3M4; LCD Display; Display Interface; DISP_SCLK DISP_SI DISP_SCS /DISP_EN EXT_COMIN; VCC Filter; VDDA; DISP_SCLK DISP_SI DISP_SCS
