traibertr/LTEWatch/1_Document/2_Report/Include/Figure/hardware/fnct_blck_dgrm.pdf

## Power Supply Block

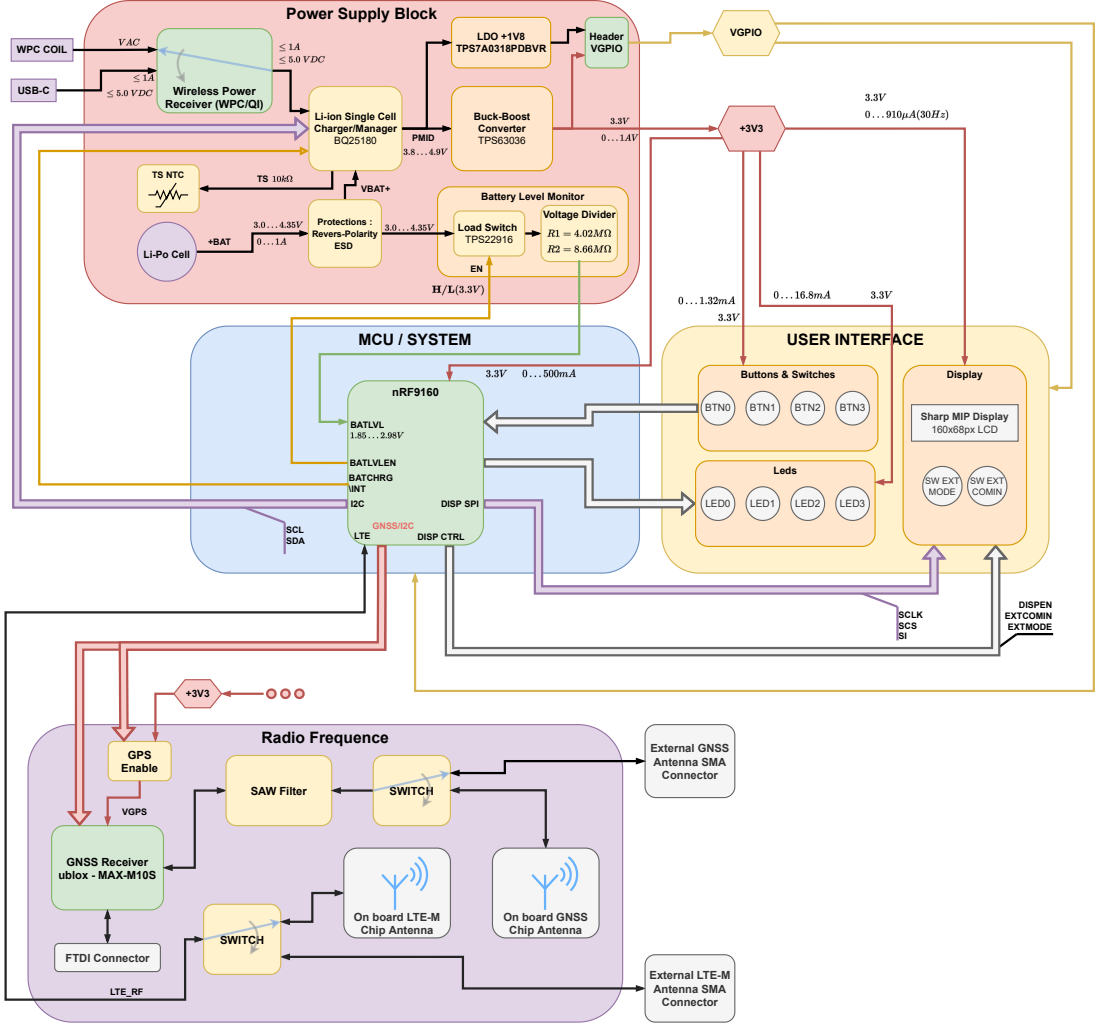
[picture p299: page 1]
Load Switch TPS22916; Voltage Divider; USB-C; Protections : Revers-Polarity ESD; TS NTC; Buck-Boost Converter TPS63036; MCU / SYSTEM; USER INTERFACE; nRF9160; Buttons & Switches; Display; Leds; BTN0; BTN1; BTN2; BTN3; LED0; LED1; LED2; LED3; SW EXT MODE; SW EXT COMIN; BATLVL; BATLVLEN; DISPEN EXTCOMIN EXTMODE; SCLK SCS SI; DISP CTRL; DISP SPI; SCL SDA; BATCHRG \INT; PMID; VBAT+; +BAT; WPC COIL; LDO +1V8 TPS7A0318PDBVR; Header; VGPIO; Radio Frequence; GNSS Receiver ublox - MAX-M10S; GNSS/I2C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

Wireless Power
Receiver (WPC/QI)

Li-ion Single Cell
Charger/Manager

Battery Level Monitor

Li-Po Cell

Sharp MIP Display
160x68px LCD

On board LTE-M
Chip Antenna

On board GNSS
