traibertr/LTEWatch/1_Document/2_Report/Include/Figure/hardware/mcu_programming_blk.pdf

# MCU Programming

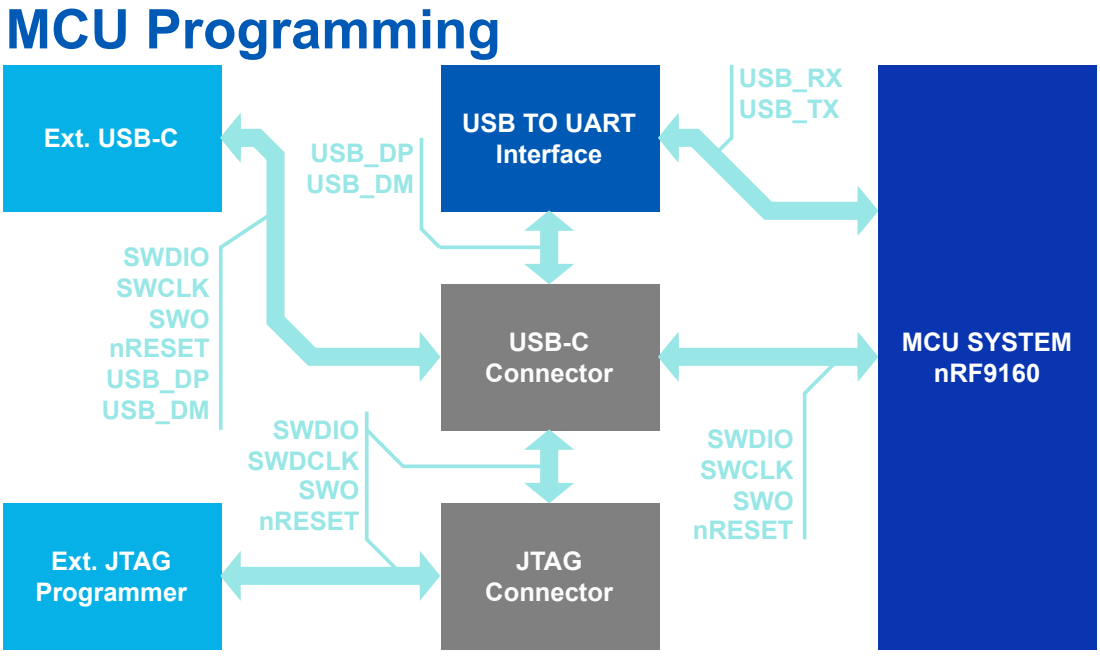
[picture p300: page 1]
MCU SYSTEM nRF9160; Ext. USB-C; USB-C Connector; JTAG Connector; Ext. JTAG Programmer; SWDIO SWDCLK SWO nRESET; SWDIO SWCLK SWO nRESET USB_DP USB_DM; USB_DP USB_DM; SWDIO SWCLK SWO nRESET; USB_RX USB_TX

USB TO UART
Interface
