traibertr/LTEWatch/1_Document/2_Report/Include/Figure/hardware/power_management_block.pdf

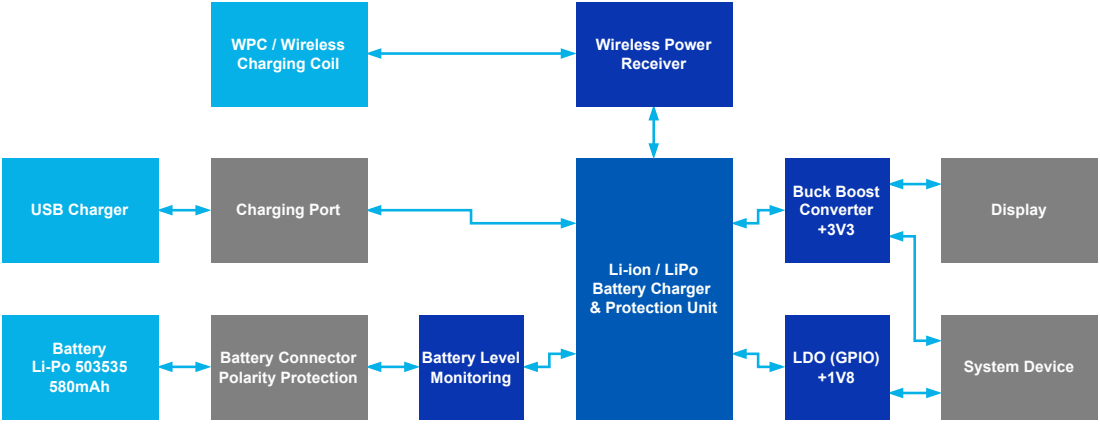
[picture p301: page 1]
USB Charger; Battery Li-Po 503535 580mAh; Battery Level Monitoring; Charging Port; Buck Boost Converter +3V3; LDO (GPIO) +1V8; Display; WPC / Wireless Charging Coil; Wireless Power Receiver

Li-ion / LiPo
Battery Charger
& Protection Unit

System Device Battery Connector
Polarity Protection
