traibertr/LTEWatch/1_Document/2_Report/Include/Figure/hardware/power_supply_blk.pdf

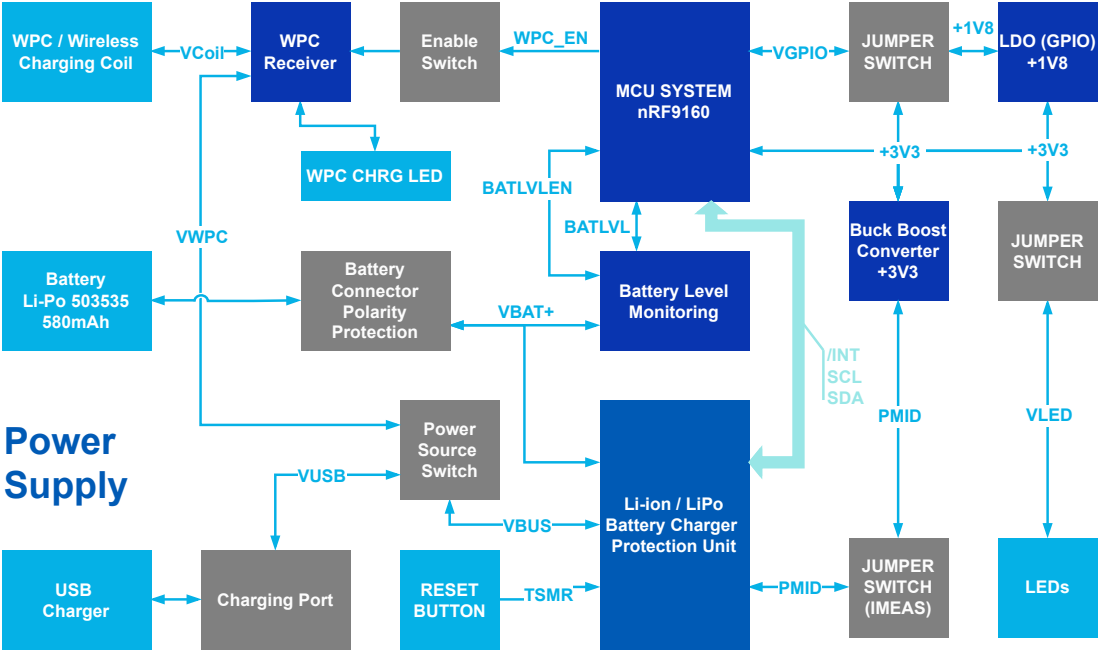
[picture p302: page 1]
Power Supply; USB Charger; Battery Li-Po 503535; 580mAh; VBAT+; BATLVL; Battery Level Monitoring; PMID; Charging Port; Buck Boost Converter +3V3; LDO (GPIO) +1V8; Battery Connector Polarity Protection; WPC Receiver; VBUS; Power Source Switch; VWPC; VUSB; Enable Switch; MCU SYSTEM nRF9160; WPC_EN; JUMPER SWITCH (IMEAS); LEDs; VLED; JUMPER SWITCH; VGPIO; JUMPER; SWITCH; RESET; TSMR; BUTTON; /INT SCL SDA

VCoil WPC / Wireless
Charging Coil

WPC CHRG LED

BATLVLEN

Li-ion / LiPo
Battery Charger
Protection Unit
