traibertr/LTEWatch/1_Document/2_Report/Include/Figure/hardware/rf_communication_blk.pdf

# RF Communication

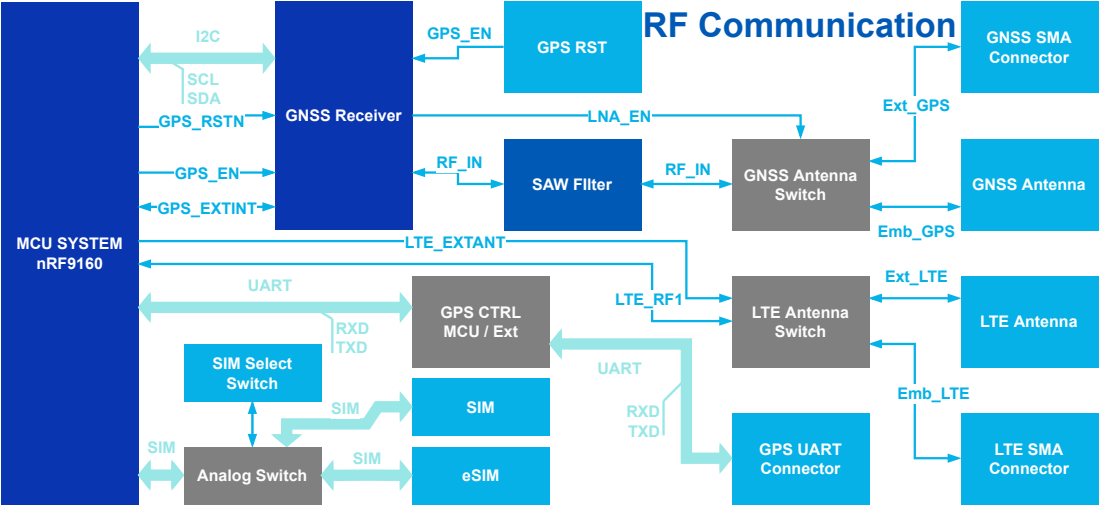
[picture p303: page 1]
SAW FIlter; GNSS Antenna; Switch; GNSS Receiver; LTE Antenna Switch; GPS RST; SCL SDA; LTE Antenna; GNSS SMA Connector; LTE SMA Connector; MCU SYSTEM nRF9160; GPS UART Connector; RXD TXD; UART; GPS_EN; GPS_RSTN; LTE_RF1; LTE_EXTANT; LNA_EN; Ext_GPS; Emb_GPS; Ext_LTE; Emb_LTE; GPS_EXTINT; SIM; Analog Switch; eSIM; SIM Select Switch

GPS CTRL
MCU / Ext
