traibertr/LTEWatch/1_Document/2_Report/Include/Figure/hardware/system_block.pdf

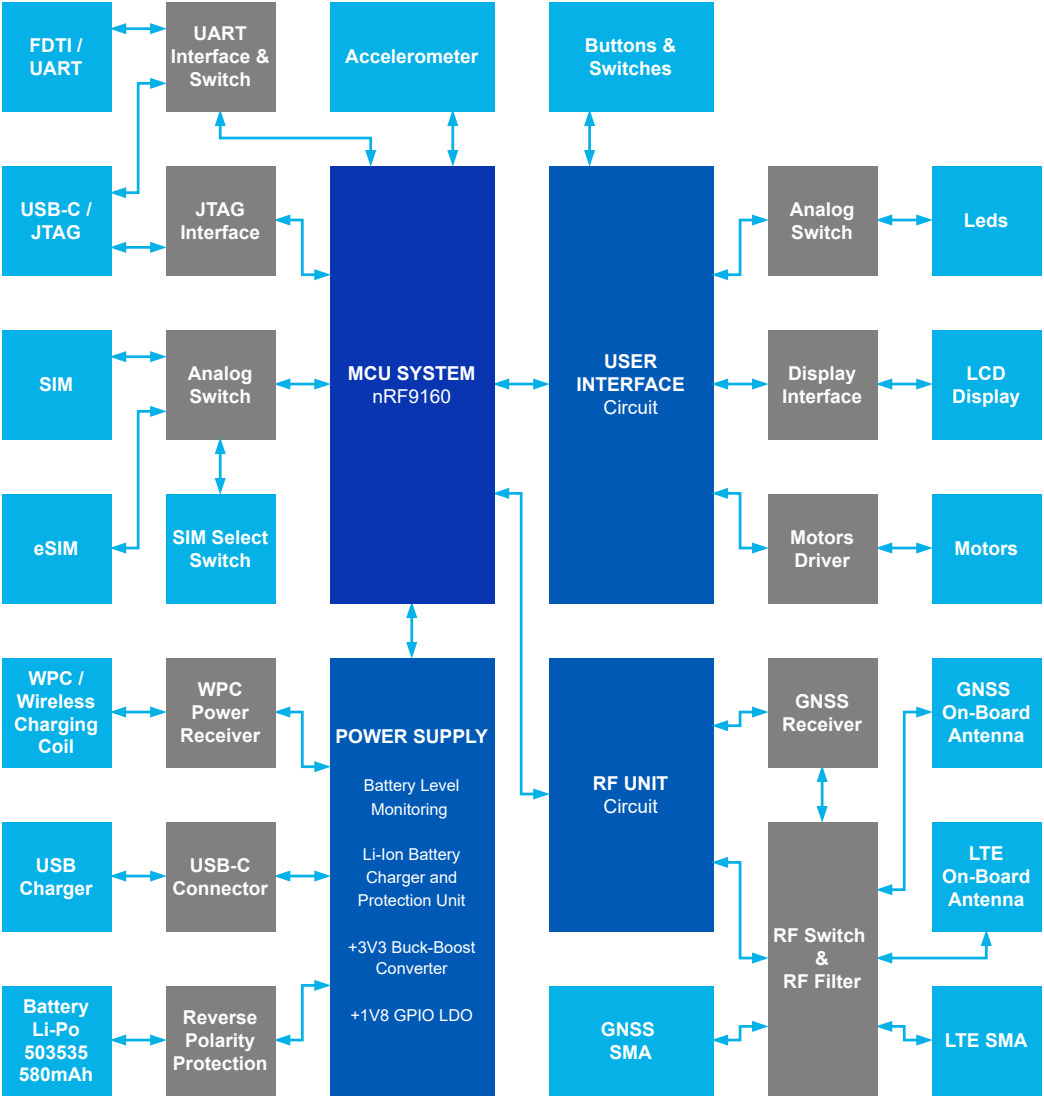
[picture p304: page 1]
USB Charger; Battery Li-Po 503535 580mAh; WPC / Wireless Charging; Coil; POWER SUPPLY; Battery Level Monitoring; +3V3 Buck-Boost Converter; +1V8 GPIO LDO; MCU SYSTEM nRF9160; USER INTERFACE Circuit; RF UNIT Circuit; Buttons & Switches; Leds; Motors Motors Driver; Display Interface; LCD Display; GNSS On-Board Antenna; LTE On-Board Antenna; GNSS Receiver; RF Switch & RF Filter; Accelerometer; USB-C / JTAG; SIM; Analog; Switch; FDTI / UART; UART Interface & Switch; JTAG Interface; GNSS; SMA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

Li-Ion Battery
Charger and
Protection Unit
