traibertr/LTEWatch/1_Document/2_Report/Include/Figure/software/software_diag.pdf

# System MCU nRF9160

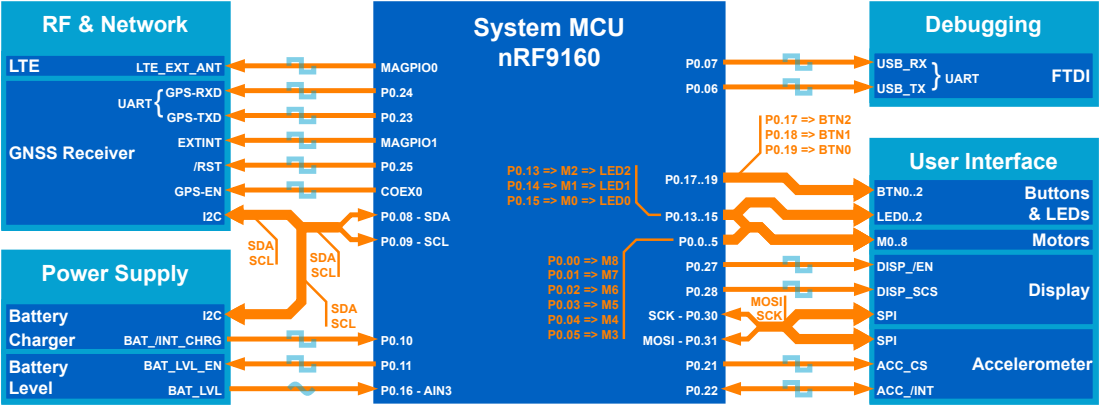
[picture p305: page 1]
User Interface; Accelerometer; Display; Buttons & LEDs; BTN0..2; LED0..2; Motors; DISP_/EN; DISP_SCS; SPI; ACC_CS; ACC_/INT; Debugging; FTDI; USB_TX; USB_RX; Power Supply; Battery Level; Battery; Charger; BAT_/INT_CHRG; BAT_LVL_EN; BAT_LVL; RF & Network; GNSS Receiver; LTE; LTE_EXT_ANT; GPS-RXD; GPS-TXD; /RST; UART{; GPS-EN; EXTINT; } UART; MAGPIO0; COEX0; MAGPIO1; P0.08 - SDA; P0.09 - SCL; P0.16 - AIN3; SCK - P0.30; MOSI - P0.31; P0.17 => BTN2 P0.18 => BTN1 P0.19 => BTN0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
