traibertr/LTEWatch/1_Document/2_Report/Include/Figure/uml/class_buttonControlelr.pdf

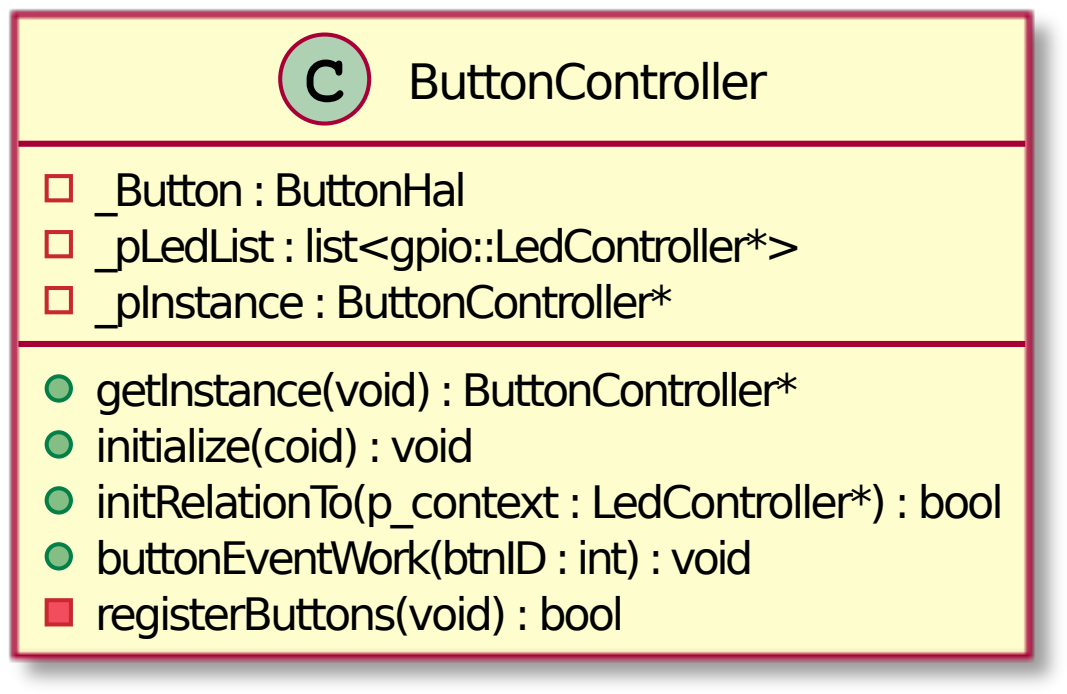
[picture p306: page 1]
ButtonController

_Button : ButtonHal
_pLedList : list<gpio::LedController*>
_pInstance : ButtonController*
getInstance(void) : ButtonController*
initialize(coid) : void
initRelationTo(p_context : LedController*) : bool
buttonEventWork(btnID : int) : void
registerButtons(void) : bool
