traibertr/LTEWatch/1_Document/2_Report/Include/Figure/uml/class_ButtonHal.pdf

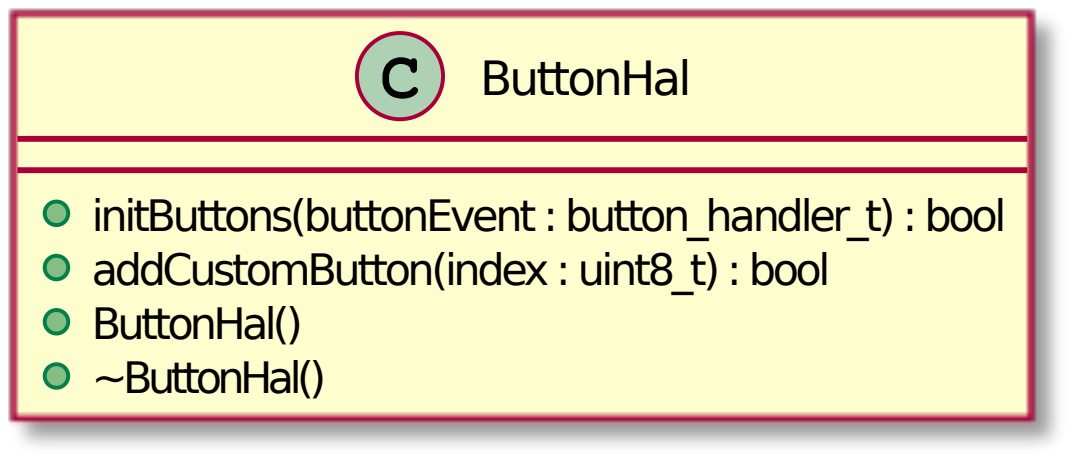
[picture p307: page 1]
ButtonHal

initButtons(buttonEvent : button_handler_t) : bool
addCustomButton(index : uint8_t) : bool
ButtonHal()
~ButtonHal()
