traibertr/LTEWatch/1_Document/2_Report/Include/Figure/uml/general_class_diagram.pdf

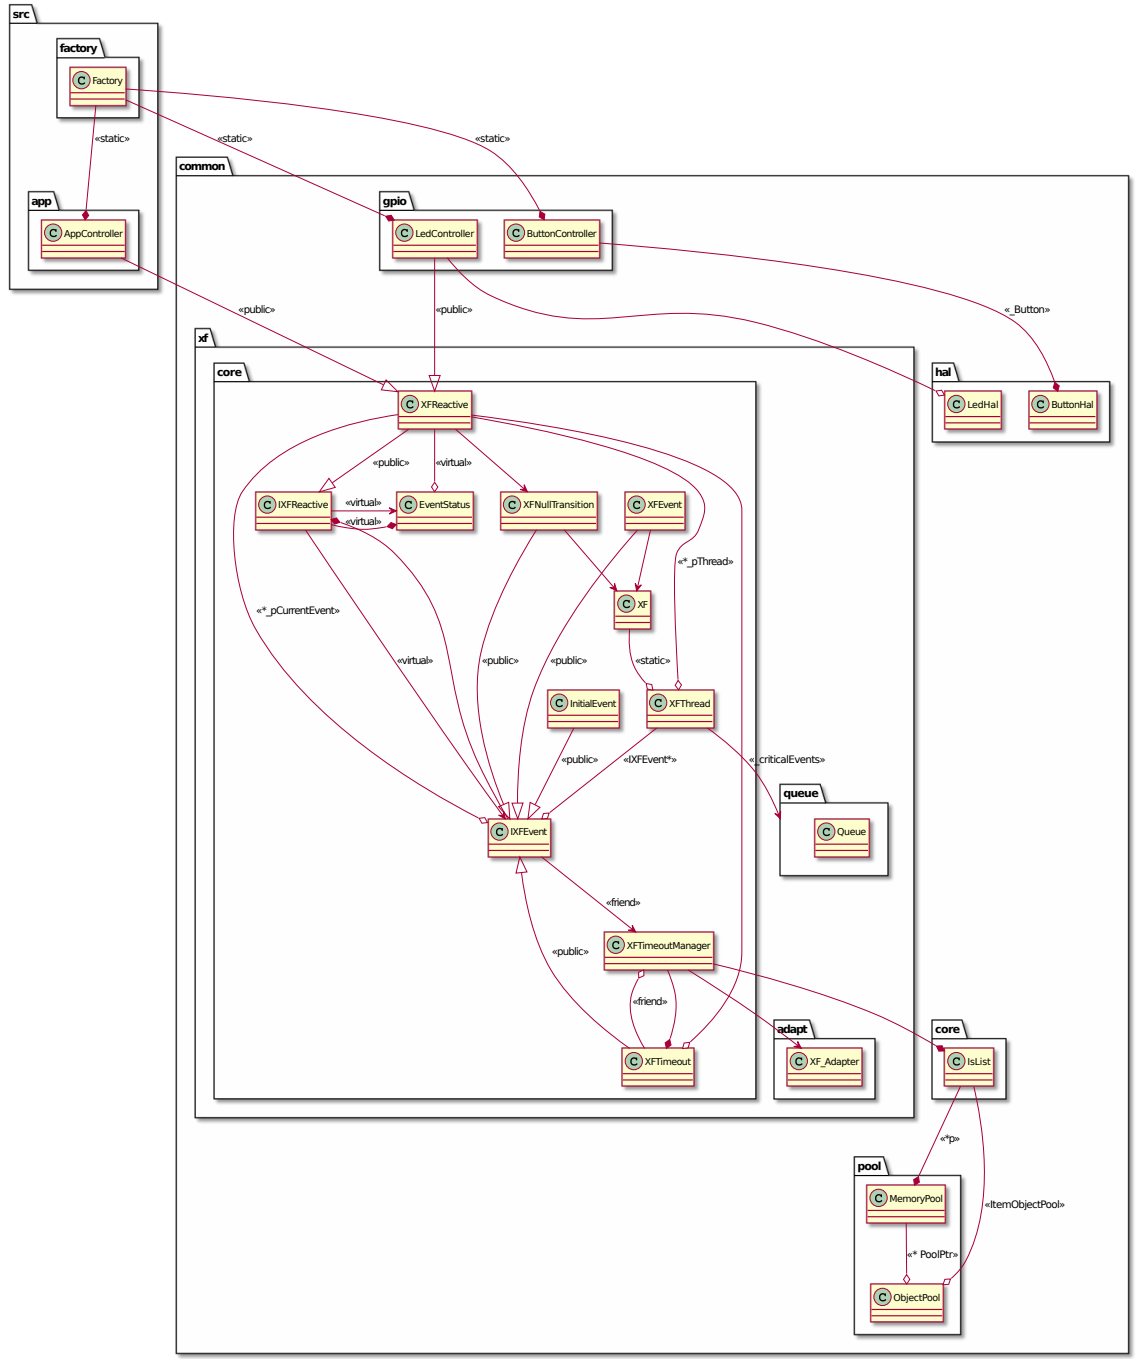
[picture p309: page 1]
src; factory; app; common; hal; gpio; adapt; core; queue; pool; Factory; AppController; LedHal; ButtonHal; LedController; ButtonController; XF_Adapter; XFTimeoutManager; XFReactive; XFTimeout; IXFEvent; IXFReactive; EventStatus; XFThread; XFNullTransition; InitialEvent; XFEvent; Queue; IsList; MemoryPool; ObjectPool; «static»; «public»; «_Button»; «ItemObjectPool»; «* PoolPtr»; «friend»; «virtual»; «*_pThread»; «*_pCurrentEvent»; «IXFEvent*»; «_criticalEvents»
