traibertr/LTEWatch/1_Document/2_Report/Include/Figure/uml/xf_timeout_manager_seq.pdf

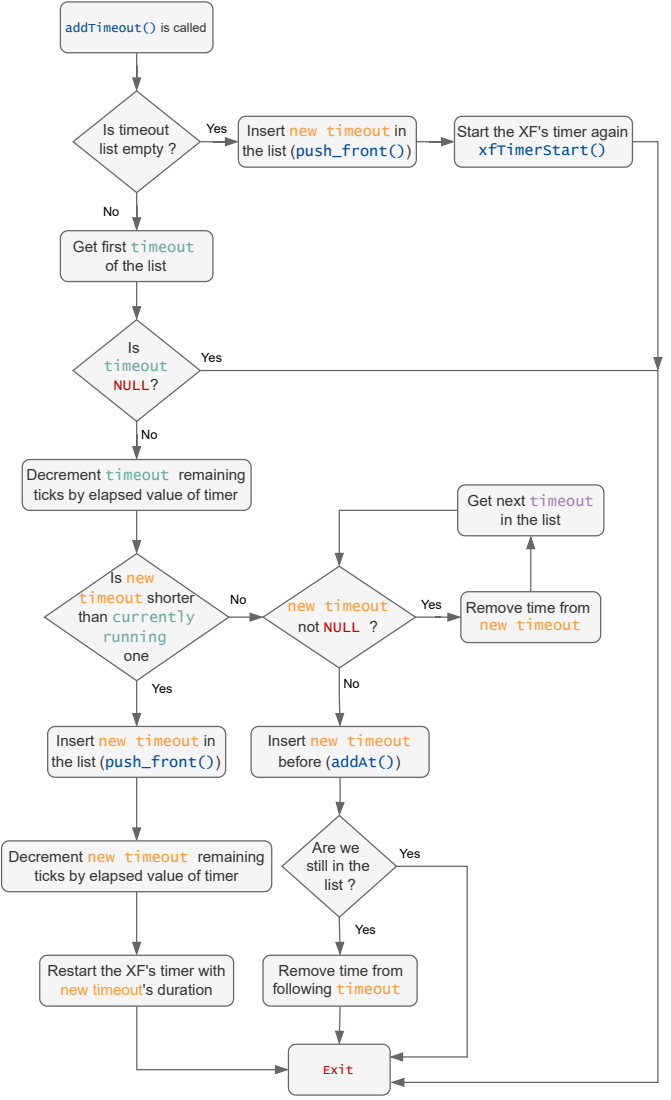
[picture p310: page 1]
Is timeout; Yes; list empty ?; Is timeout NULL?; Exit; Is new timeout shorter than currently running one; Remove time from; new timeout; new timeout not NULL ?

addTimeout() is called

Insert new timeout in
the list (push_front())

Start the XF's timer again
xfTimerStart()

Get first timeout
of the list

Decrement timeout remaining
ticks by elapsed value of timer

Get next timeout
in the list

Insert new timeout
before (addAt())

Are we
still in the
list ?

Decrement new timeout remaining

Restart the XF's timer with
new timeout's duration

Remove time from
following timeout
