traibertr/LTEWatch/1_Document/2_Report/Include/Figure/software/class/factory.pdf

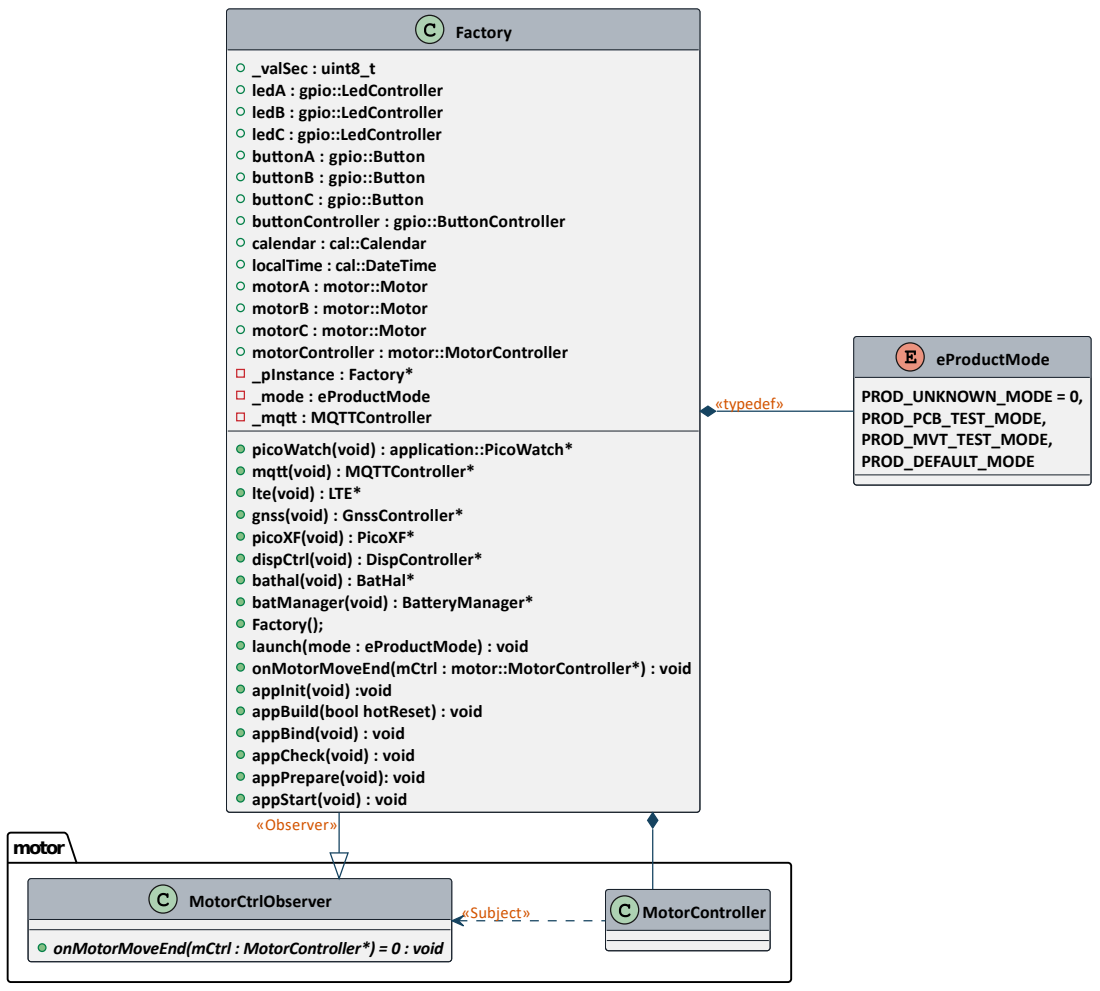
[picture p312: page 1]
motor; MotorCtrlObserver; MotorController; Factory; eProductMode; PROD_UNKNOWN_MODE = 0, PROD_PCB_TEST_MODE, PROD_MVT_TEST_MODE, PROD_DEFAULT_MODE; «Subject»; «typedef»

_valSec : uint8_t
ledA : gpio::LedController
ledB : gpio::LedController
ledC : gpio::LedController
buonA : gpio::Buon
buonB : gpio::Buon
buonC : gpio::Buon
buonController : gpio::BuonController
calendar : cal::Calendar
localTime : cal::DateTime
motorA : motor::Motor
motorB : motor::Motor
motorC : motor::Motor
motorController : motor::MotorController
_pInstance : Factory*
_mode : eProductMode
_mq : MQTTController
picoWatch(void) : applicaon::PicoWatch*
mq(void) : MQTTController*
lte(void) : LTE*
gnss(void) : GnssController*
picoXF(void) : PicoXF*
dispCtrl(void) : DispController*
bathal(void) : BatHal*
batManager(void) : BaeryManager*
Factory();
launch(mode : eProductMode) : void
onMotorMoveEnd(mCtrl : motor::MotorController*) : void
appInit(void) :void
appBuild(bool hotReset) : void
appBind(void) : void
appCheck(void) : void
appPrepare(void): void
appStart(void) : void
«Observer»

onMotorMoveEnd(mCtrl : MotorController*) = 0 : void
