traibertr/LTEWatch/1_Document/2_Report/Include/Figure/software/class/gnsscontroller.pdf

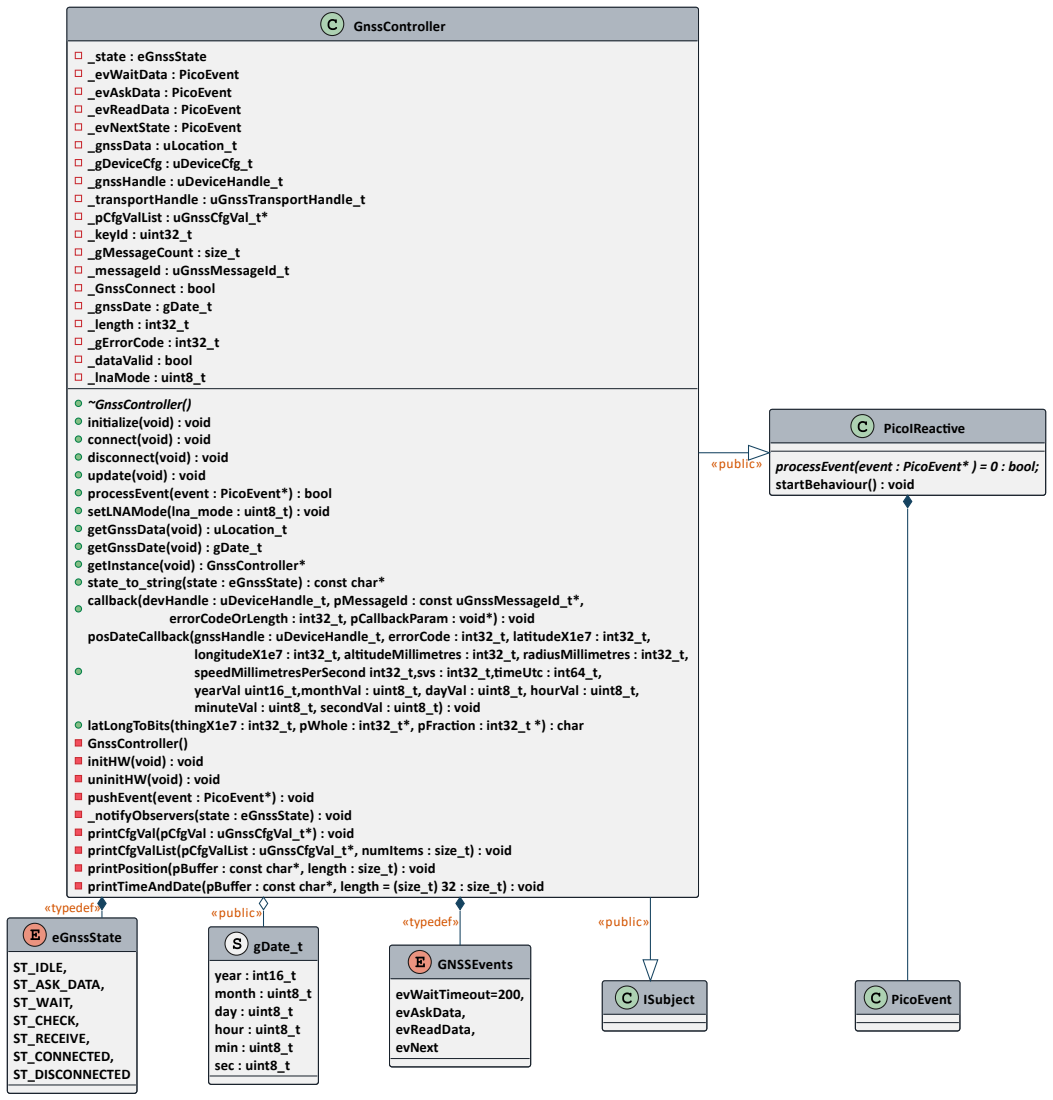
[picture p313: page 1]
GnssController; _state : eGnssState _evWaitData : PicoEvent _evAskData : PicoEvent _evReadData : PicoEvent _evNextState : PicoEvent _gnssData : uLocaon_t _gDeviceCfg : uDeviceCfg_t _gnssHandle : uDeviceHandle_t _transportHandle : uGnssTransportHandle_t _pCfgValList : uGnssCfgVal_t* _keyId : uint32_t _gMessageCount : size_t _messageId : uGnssMessageId_t _GnssConnect : bool _gnssDate : gDate_t _length : int32_t _gErrorCode : int32_t _dataValid : bool _lnaMode : uint8_t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

processEvent(event : PicoEvent* ) = 0 : bool;
startBehaviour() : void

errorCodeOrLength : int32_t, pCallbackParam : void*) : void

posDateCallback(gnssHandle : uDeviceHandle_t, errorCode : int32_t, latudeX1e7 : int32_t,

longitudeX1e7 : int32_t, altudeMillimetres : int32_t, radiusMillimetres : int32_t,
speedMillimetresPerSecond int32_t,svs : int32_t,meUtc : int64_t,
yearVal uint16_t,monthVal : uint8_t, dayVal : uint8_t, hourVal : uint8_t,
minuteVal : uint8_t, secondVal : uint8_t) : void

latLongToBits(thingX1e7 : int32_t, pWhole : int32_t*, pFracon : int32_t *) : char
GnssController()
initHW(void) : void
uninitHW(void) : void
pushEvent(event : PicoEvent*) : void
_nofyObservers(state : eGnssState) : void
printCfgVal(pCfgVal : uGnssCfgVal_t*) : void
printCfgValList(pCfgValList : uGnssCfgVal_t*, numItems : size_t) : void
printPosion(pBuffer : const char*, length : size_t) : void
printTimeAndDate(pBuffer : const char*, length = (size_t) 32 : size_t) : void
