traibertr/LTEWatch/1_Document/2_Report/Include/Figure/software/class/motorDriving.pdf

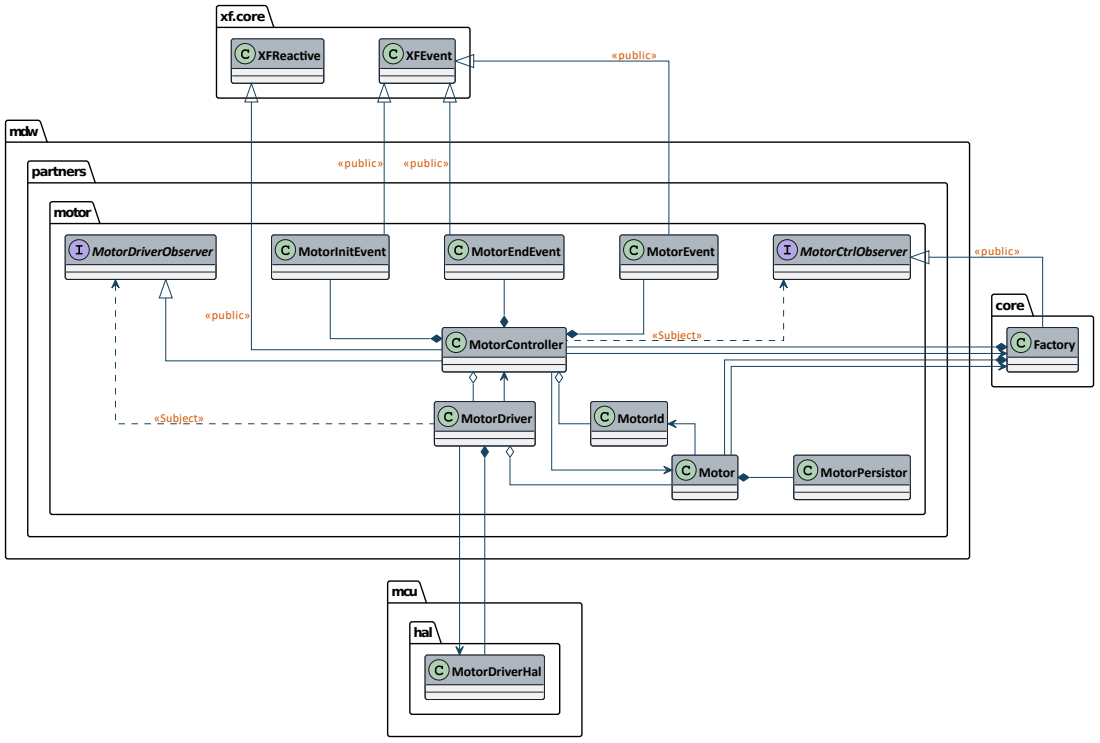
[picture p314: page 1]
core; mcu; hal; mdw; partners; motor; xf.core; Factory; MotorDriverHal; Motor; MotorId; MotorPersistor; MotorController; MotorDriver; MotorDriverObserver; MotorInitEvent; MotorEndEvent; MotorEvent; MotorCtrlObserver; XFReacve; XFEvent; «public»; «Subject»
