traibertr/LTEWatch/1_Document/2_Report/Include/Figure/software/class/picowatch.pdf

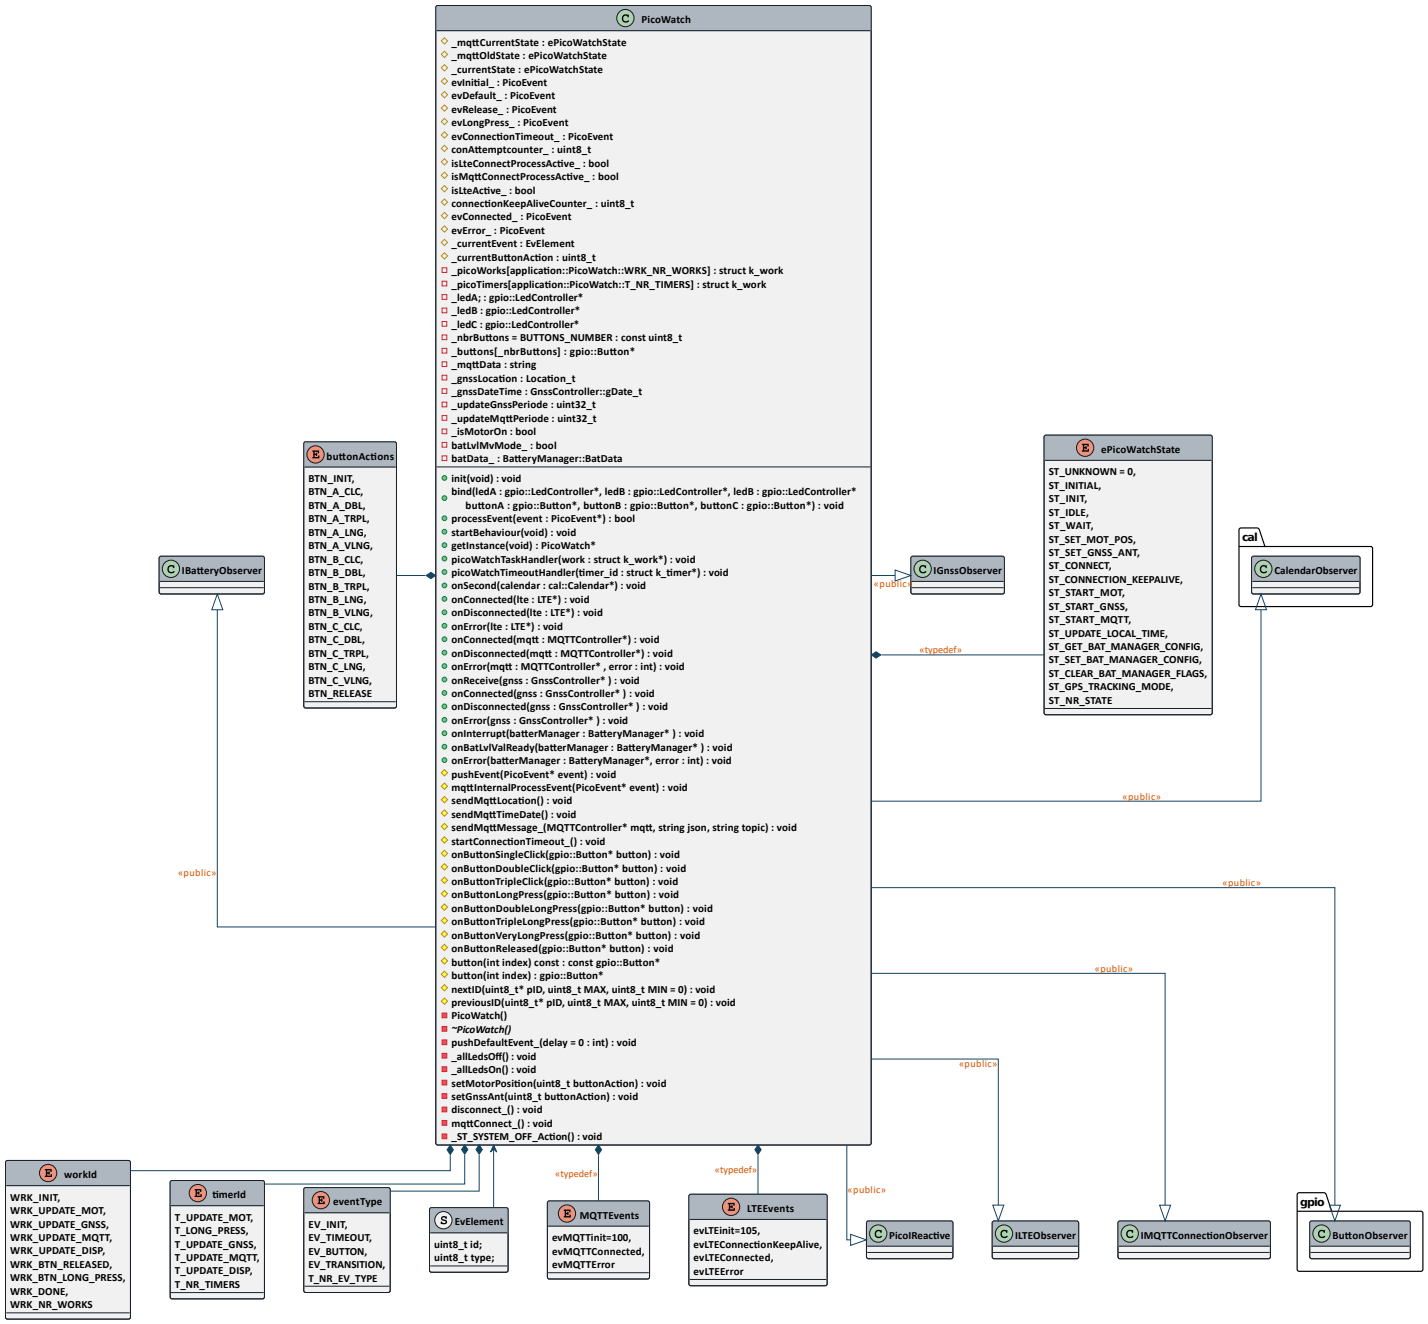
[picture p315: page 1]
gpio; cal; BuonObserver; CalendarObserver; PicoWatch; BTN_INIT, BTN_A_CLC, BTN_A_DBL, BTN_A_TRPL, BTN_A_LNG, BTN_A_VLNG, BTN_B_CLC, BTN_B_DBL, BTN_B_TRPL, BTN_B_LNG, BTN_B_VLNG, BTN_C_CLC, BTN_C_DBL, BTN_C_TRPL, BTN_C_LNG, BTN_C_VLNG, BTN_RELEASE; workId; WRK_INIT, WRK_UPDATE_MOT, WRK_UPDATE_GNSS, WRK_UPDATE_MQTT, WRK_UPDATE_DISP, WRK_BTN_RELEASED, WRK_BTN_LONG_PRESS, WRK_DONE, WRK_NR_WORKS; merId; T_UPDATE_MOT, T_LONG_PRESS, T_UPDATE_GNSS, T_UPDATE_MQTT, T_UPDATE_DISP, T_NR_TIMERS; eventType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

_mqCurrentState : ePicoWatchState
_mqOldState : ePicoWatchState
_currentState : ePicoWatchState
evInial_ : PicoEvent
evDefault_ : PicoEvent
evRelease_ : PicoEvent
evLongPress_ : PicoEvent
evConneconTimeout_ : PicoEvent
conAemptcounter_ : uint8_t
isLteConnectProcessAcve_ : bool
isMqConnectProcessAcve_ : bool
isLteAcve_ : bool
conneconKeepAliveCounter_ : uint8_t
evConnected_ : PicoEvent
evError_ : PicoEvent
_currentEvent : EvElement
_currentBuonAcon : uint8_t
_picoWorks[applicaon::PicoWatch::WRK_NR_WORKS] : struct k_work
_picoTimers[applicaon::PicoWatch::T_NR_TIMERS] : struct k_work
_ledA; : gpio::LedController*
_ledB : gpio::LedController*
_ledC : gpio::LedController*
_nbrBuons = BUTTONS_NUMBER : const uint8_t
_buons[_nbrBuons] : gpio::Buon*
_mqData : string
_gnssLocaon : Locaon_t
_gnssDateTime : GnssController::gDate_t
_updateGnssPeriode : uint32_t
_updateMqPeriode : uint32_t
_isMotorOn : bool
batLvlMvMode_ : bool
batData_ : BaeryManager::BatData
init(void) : void
bind(ledA : gpio::LedController*, ledB : gpio::LedController*, ledB : gpio::LedController*
buonA : gpio::Buon*, buonB : gpio::Buon*, buonC : gpio::Buon*) : void
processEvent(event : PicoEvent*) : bool
startBehaviour(void) : void
getInstance(void) : PicoWatch*
picoWatchTaskHandler(work : struct k_work*) : void
picoWatchTimeoutHandler(mer_id : struct k_mer*) : void
onSecond(calendar : cal::Calendar*) : void
onConnected(lte : LTE*) : void
onDisconnected(lte : LTE*) : void
onError(lte : LTE*) : void
onConnected(mq : MQTTController*) : void
onDisconnected(mq : MQTTController*) : void
onError(mq : MQTTController* , error : int) : void
onReceive(gnss : GnssController* ) : void
onConnected(gnss : GnssController* ) : void
onDisconnected(gnss : GnssController* ) : void
onError(gnss : GnssController* ) : void
onInterrupt(baerManager : BaeryManager* ) : void
onBatLvlValReady(baerManager : BaeryManager* ) : void
onError(baerManager : BaeryManager*, error : int) : void
pushEvent(PicoEvent* event) : void
mqInternalProcessEvent(PicoEvent* event) : void
sendMqLocaon() : void
sendMqTimeDate() : void
sendMqMessage_(MQTTController* mq, string json, string topic) : void
startConneconTimeout_() : void
onBuonSingleClick(gpio::Buon* buon) : void
onBuonDoubleClick(gpio::Buon* buon) : void
onBuonTripleClick(gpio::Buon* buon) : void
onBuonLongPress(gpio::Buon* buon) : void
onBuonDoubleLongPress(gpio::Buon* buon) : void
onBuonTripleLongPress(gpio::Buon* buon) : void
onBuonVeryLongPress(gpio::Buon* buon) : void
onBuonReleased(gpio::Buon* buon) : void
buon(int index) const : const gpio::Buon*
buon(int index) : gpio::Buon*
nextID(uint8_t* pID, uint8_t MAX, uint8_t MIN = 0) : void
previousID(uint8_t* pID, uint8_t MAX, uint8_t MIN = 0) : void
PicoWatch()
~PicoWatch()
pushDefaultEvent_(delay = 0 : int) : void
_allLedsOff() : void
_allLedsOn() : void
setMotorPosion(uint8_t buonAcon) : void
setGnssAnt(uint8_t buonAcon) : void
disconnect_() : void
mqConnect_() : void
_ST_SYSTEM_OFF_Acon() : void

buonAcons
