traibertr/LTEWatch/1_Document/2_Report/Include/Figure/software/class/picoWatchCommon.pdf

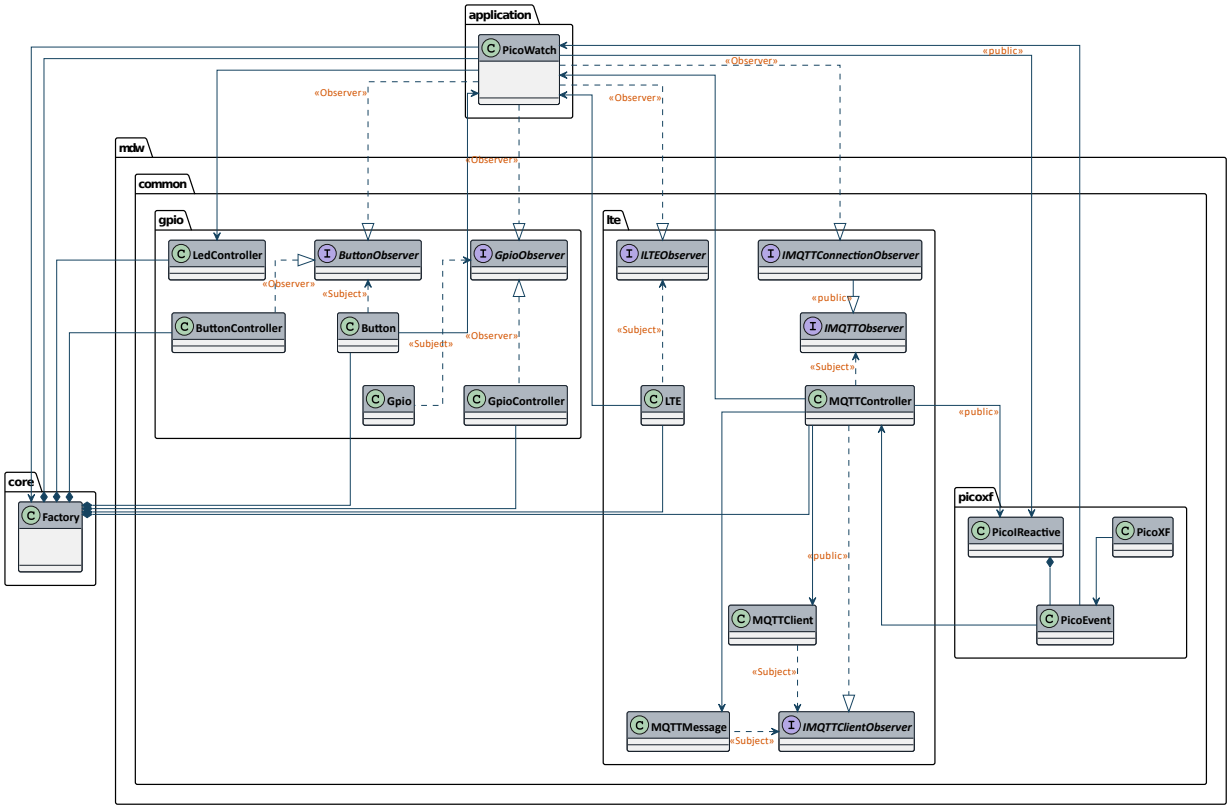
[picture p317: page 1]
application; core; mdw; common; gpio; picoxf; lte; PicoWatch; Factory; BuonController; BuonObserver; GpioObserver; Gpio; GpioController; LedController; PicoIReacve; PicoXF; PicoEvent; LTE; ILTEObserver; MQTTController; IMQTTObserver; IMQTTConneconObserver; MQTTClient; MQTTMessage; IMQTTClientObserver; «public»; «Observer»; «Subject»
