traibertr/LTEWatch/1_Document/2_Report/Include/Figure/software/class/picoWatchPartner.pdf

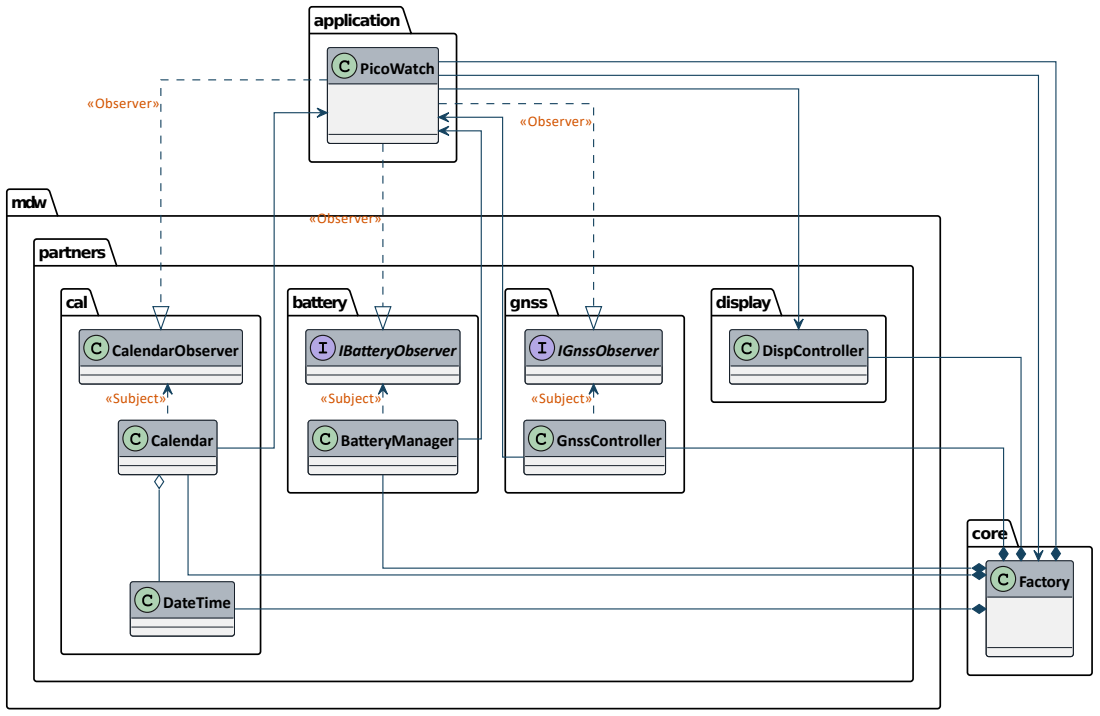
[picture p318: page 1]
application; core; mdw; partners; cal; battery; gnss; display; PicoWatch; Factory; BaeryManager; IBaeryObserver; IGnssObserver; DispController; Calendar; GnssController; CalendarObserver; DateTime; «Observer»; «Subject»
