traibertr/LTEWatch/1_Document/2_Report/Include/Figure/software/state/batteryManager.pdf

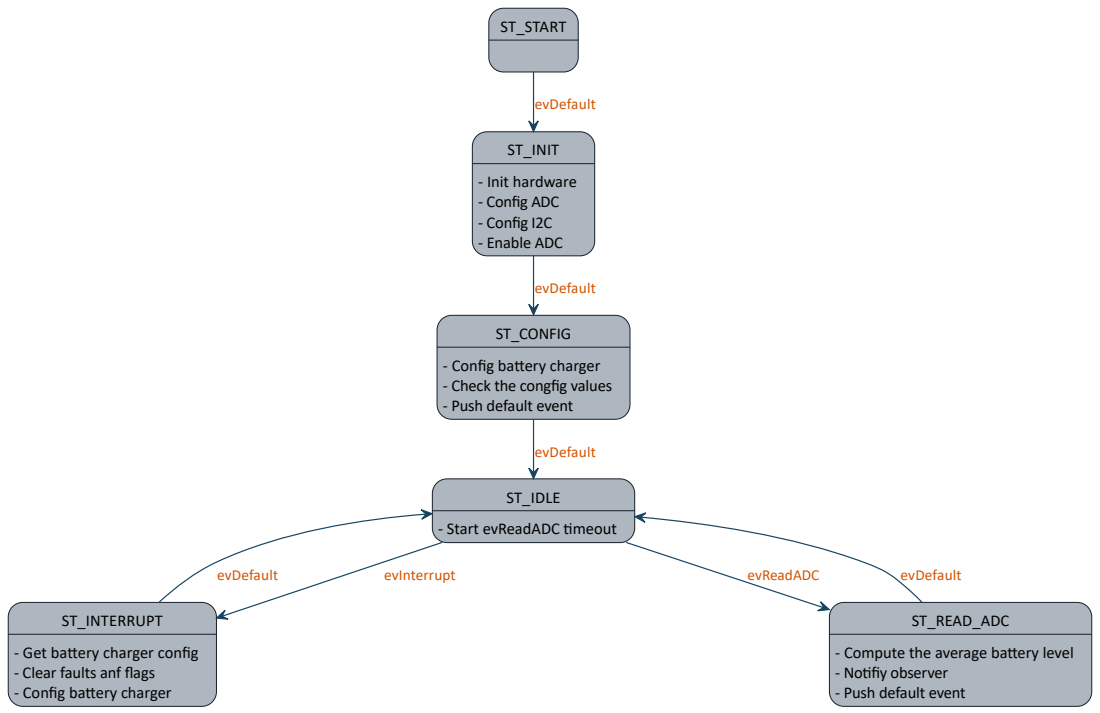
[picture p319: page 1]
ST_INIT; - Init hardware - Config ADC - Config I2C - Enable ADC; ST_START; ST_IDLE; ST_CONFIG; ST_INTERRUPT; ST_READ_ADC; evDefault; evInterrupt; evReadADC

- Config baery charger
- Check the congfig values
- Push default event

- Start evReadADC meout

- Get baery charger config
- Clear faults anf flags

- Compute the average baery level
- Nofiy observer
