traibertr/LTEWatch/1_Document/2_Report/Include/Figure/software/state/picoWatch.pdf

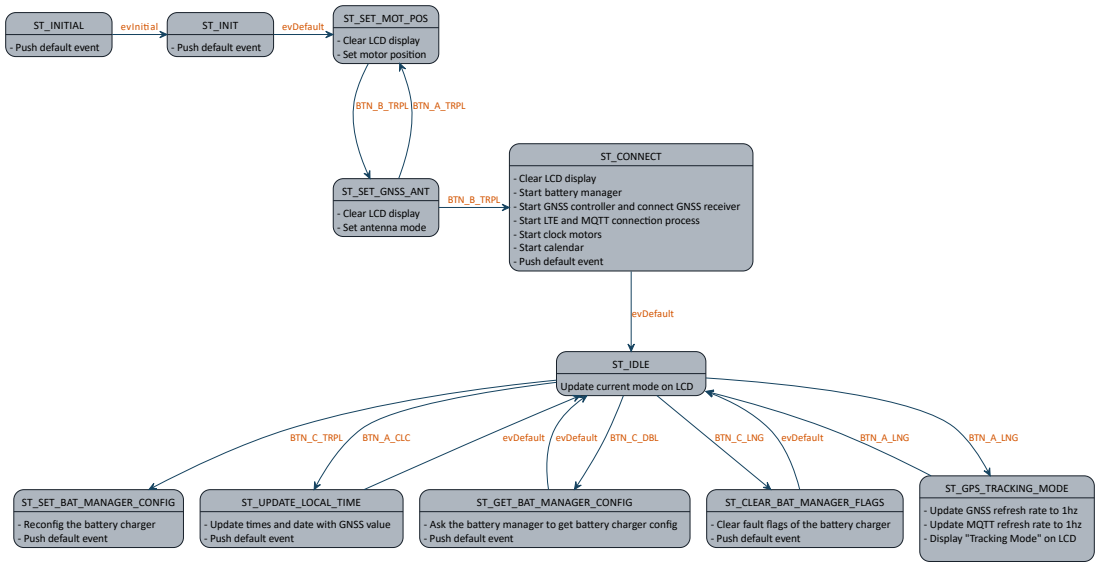
[picture p320: page 1]
ST_INITIAL; ST_INIT; ST_IDLE; ST_SET_MOT_POS; ST_SET_GNSS_ANT; ST_CONNECT; ST_UPDATE_LOCAL_TIME; ST_GET_BAT_MANAGER_CONFIG; ST_SET_BAT_MANAGER_CONFIG; ST_CLEAR_BAT_MANAGER_FLAGS; ST_GPS_TRACKING_MODE; evInial; evDefault; BTN_C_TRPL; BTN_A_CLC; evDefault evDefault BTN_C_DBL; BTN_C_LNG; BTN_A_LNG; BTN_B_TRPL BTN_A_TRPL; BTN_B_TRPL

- Clear LCD display
- Set motor posion

- Push default event

- Start baery manager
- Start GNSS controller and connect GNSS receiver
- Start LTE and MQTT connecon process
- Start clock motors
- Start calendar

- Set antenna mode

Update current mode on LCD

- Update GNSS refresh rate to 1hz
- Update MQTT refresh rate to 1hz
- Display "Tracking Mode" on LCD

- Reconfig the baery charger

- Update mes and date with GNSS value

- Ask the baery manager to get baery charger config

- Clear fault flags of the baery charger
