traibertr/LTEWatch/1_Document/3_Presentation/figure/rf_ltem.pdf

# On-Board GNSS Antenna

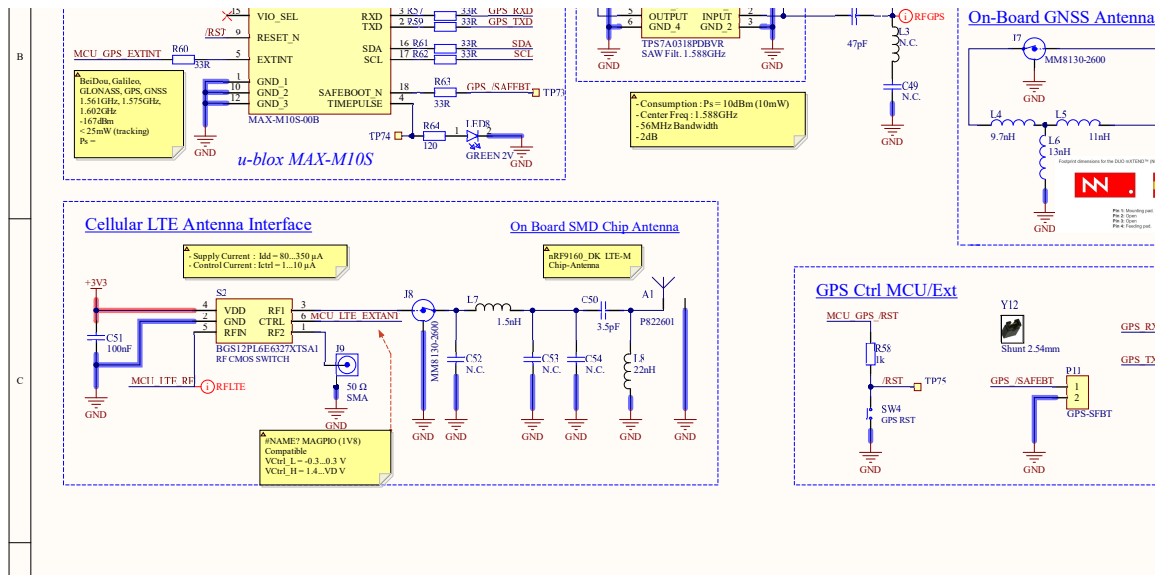
[picture p321: page 1]

- Supply Current : Idd = 80...350 µA
- Control Current : Ictrl = 1...10 µA

GPS Ctrl MCU/Ext
