traibertr/LTEWatch/1_Document/2_Report/Include/Figure/software/class/batterymanager.pdf

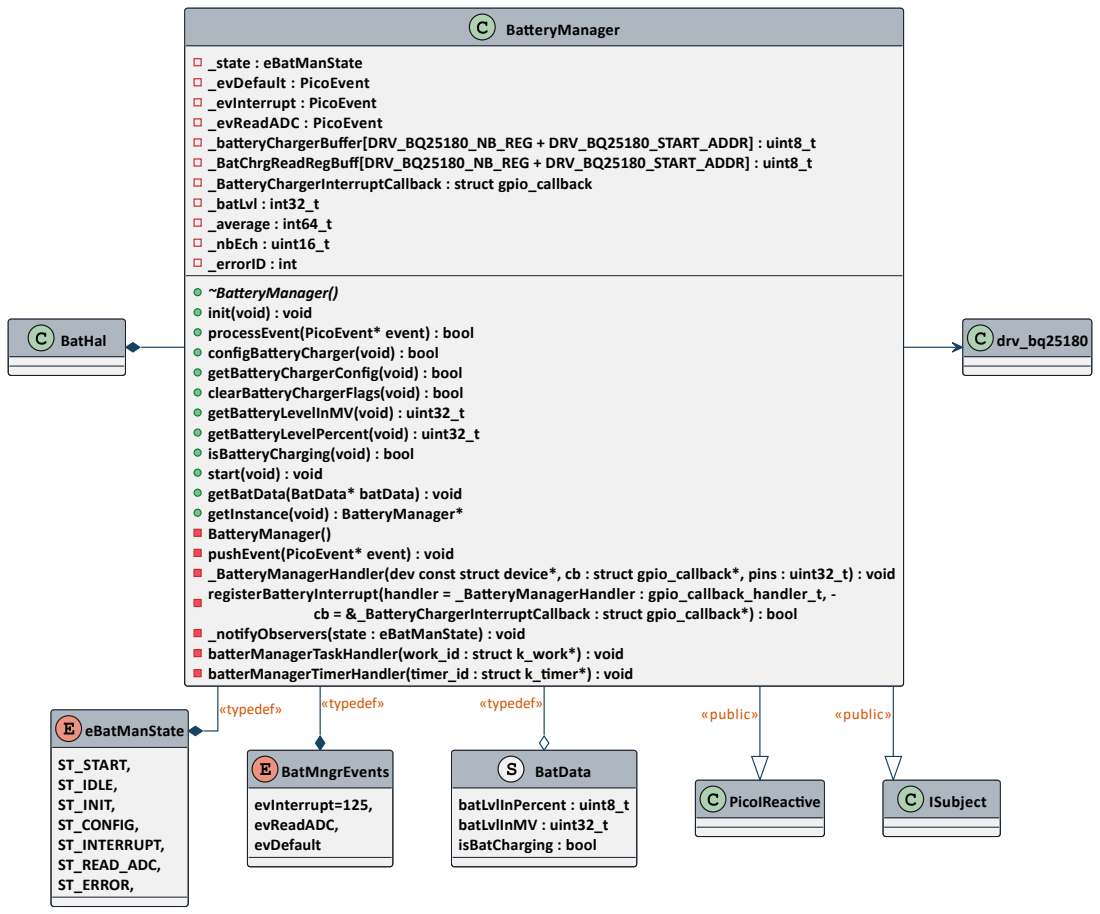
[picture p322: page 1]
BaeryManager; eBatManState; ST_START, ST_IDLE, ST_INIT, ST_CONFIG, ST_INTERRUPT, ST_READ_ADC, ST_ERROR,; BatMngrEvents; evInterrupt=125, evReadADC, evDefault; BatData; batLvlInPercent : uint8_t batLvlInMV : uint32_t isBatCharging : bool; PicoIReacve; ISubject; BatHal; drv_bq25180; «public»; «public» «typedef»; «typedef»

_state : eBatManState
_evDefault : PicoEvent
_evInterrupt : PicoEvent
_evReadADC : PicoEvent
_baeryChargerBuffer[DRV_BQ25180_NB_REG + DRV_BQ25180_START_ADDR] : uint8_t
_BatChrgReadRegBuff[DRV_BQ25180_NB_REG + DRV_BQ25180_START_ADDR] : uint8_t
_BaeryChargerInterruptCallback : struct gpio_callback
_batLvl : int32_t
_average : int64_t
_nbEch : uint16_t
_errorID : int
~BaeryManager()
init(void) : void
processEvent(PicoEvent* event) : bool
configBaeryCharger(void) : bool
getBaeryChargerConfig(void) : bool
clearBaeryChargerFlags(void) : bool
getBaeryLevelInMV(void) : uint32_t
getBaeryLevelPercent(void) : uint32_t
isBaeryCharging(void) : bool
start(void) : void
getBatData(BatData* batData) : void
getInstance(void) : BaeryManager*
BaeryManager()
pushEvent(PicoEvent* event) : void
_BaeryManagerHandler(dev const struct device*, cb : struct gpio_callback*, pins : uint32_t) : void
registerBaeryInterrupt(handler = _BaeryManagerHandler : gpio_callback_handler_t, -

cb = &_BaeryChargerInterruptCallback : struct gpio_callback*) : bool

_nofyObservers(state : eBatManState) : void
baerManagerTaskHandler(work_id : struct k_work*) : void
baerManagerTimerHandler(mer_id : struct k_mer*) : void
