traibertr/LTEWatch/1_Document/2_Report/Include/Figure/software/class/dispcontroller.pdf

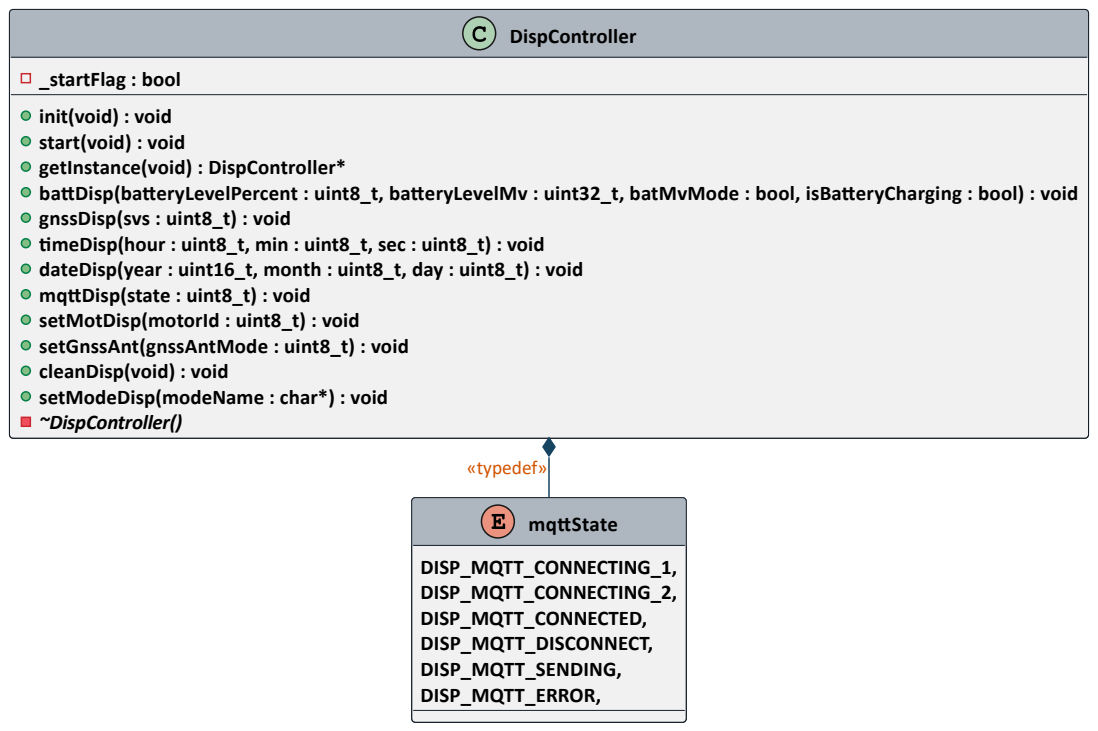
[picture p323: page 1]
DispController; mqState; DISP_MQTT_CONNECTING_1, DISP_MQTT_CONNECTING_2, DISP_MQTT_CONNECTED, DISP_MQTT_DISCONNECT, DISP_MQTT_SENDING, DISP_MQTT_ERROR,; «typedef»

_startFlag : bool
init(void) : void
start(void) : void
getInstance(void) : DispController*
baDisp(baeryLevelPercent : uint8_t, baeryLevelMv : uint32_t, batMvMode : bool, isBaeryCharging : bool) : void
gnssDisp(svs : uint8_t) : void
meDisp(hour : uint8_t, min : uint8_t, sec : uint8_t) : void
dateDisp(year : uint16_t, month : uint8_t, day : uint8_t) : void
mqDisp(state : uint8_t) : void
setMotDisp(motorId : uint8_t) : void
setGnssAnt(gnssAntMode : uint8_t) : void
cleanDisp(void) : void
setModeDisp(modeName : char*) : void
~DispController()
