traibertr/LTEWatch/1_Document/2_Report/Include/Figure/software/class/picoevent.pdf

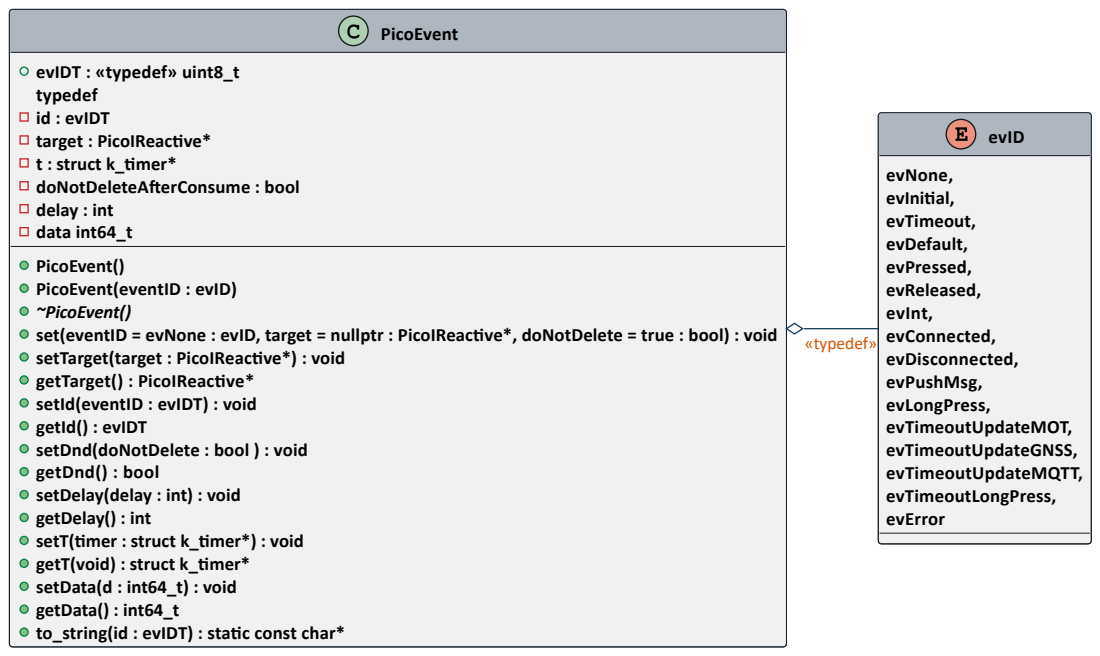
[picture p324: page 1]
PicoEvent; evID; evNone, evInial, evTimeout, evDefault, evPressed, evReleased, evInt, evConnected, evDisconnected, evPushMsg, evLongPress, evTimeoutUpdateMOT, evTimeoutUpdateGNSS, evTimeoutUpdateMQTT, evTimeoutLongPress, evError; «typedef»

evIDT : «typedef» uint8_t
typedef
id : evIDT
target : PicoIReacve*
t : struct k_mer*
doNotDeleteAerConsume : bool
delay : int
data int64_t
PicoEvent()
PicoEvent(eventID : evID)
~PicoEvent()
set(eventID = evNone : evID, target = nullptr : PicoIReacve*, doNotDelete = true : bool) : void
setTarget(target : PicoIReacve*) : void
getTarget() : PicoIReacve*
setId(eventID : evIDT) : void
getId() : evIDT
setDnd(doNotDelete : bool ) : void
getDnd() : bool
setDelay(delay : int) : void
getDelay() : int
setT(mer : struct k_mer*) : void
getT(void) : struct k_mer*
setData(d : int64_t) : void
getData() : int64_t
to_string(id : evIDT) : stac const char*
