traibertr/LTEWatch/1_Document/2_Report/Include/Figure/software/class/PicoIReactive.pdf

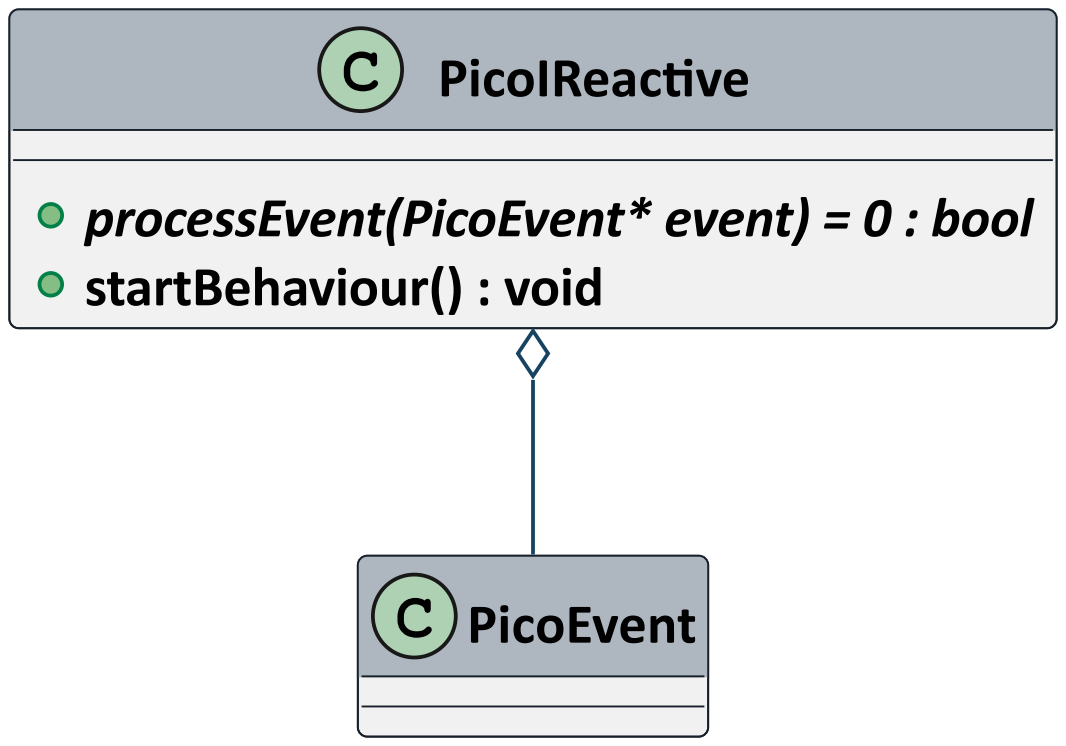
[picture p325: page 1]
PicoIReacve; PicoEvent

processEvent(PicoEvent* event) = 0 : bool
startBehaviour() : void
