traibertr/LTEWatch/1_Document/2_Report/Include/Figure/software/state/gnssController.pdf

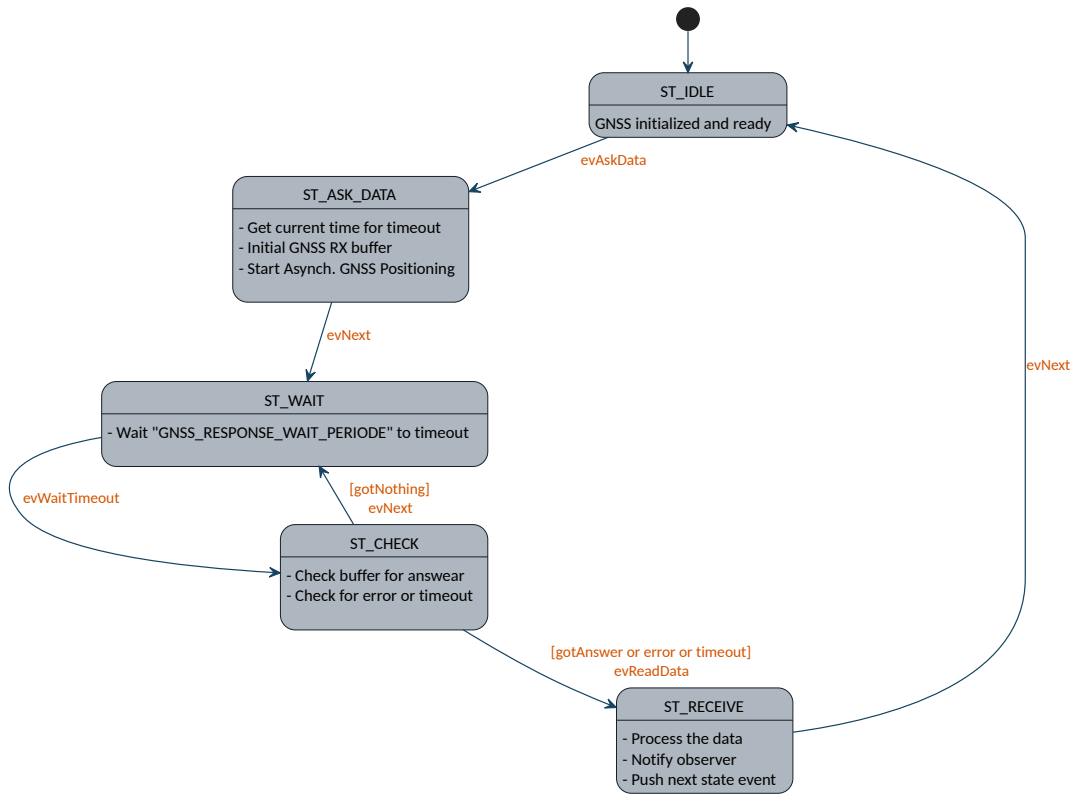
[picture p326: page 1]
ST_IDLE; ST_ASK_DATA; ST_WAIT; ST_CHECK; ST_RECEIVE; evAskData; evNext; evWaitTimeout; [gotNothing]; evReadData

GNSS initialized and ready

- Get current time for timeout
- Initial GNSS RX buffer
- Start Asynch. GNSS Positioning

- Wait "GNSS_RESPONSE_WAIT_PERIODE" to timeout

- Check buffer for answear
- Check for error or timeout

[gotAnswer or error or timeout]

- Process the data
- Notify observer
- Push next state event
