traibertr/LTEWatch/2_Hardware/3_Prototye/Simulation/BatPolarityProtection/BatPolarityProtection.asc

C1: cap; 1µ; V=25
C2: cap; 15n
D1: zener; TFZ9_1B
M1: pmos; Si9424DY
R1: res; 12k; tol=1 pwr=0.1
R2: res; 50
V1: voltage; 5
Named nets: 0, VBAT, Vg, Vs, Vout
.dc V1 -10 10 0.01
