traibertr/LTEWatch/3_Software/ubxlib/port/platform/common/automation/cellular_auto_pwr_on_schematic.asc

C1: cap; 10µf
C2: cap; 10nf
C3: cap; 1µf
C4: cap; 10µf
Q1: npn
Q2: npn
Q3: npn
R1: res; 1k
R2: res; 82k
R3: res; 47k
R4: res; 10k
R5: res; 10k
R6: res; 10k
R7: res; 1k
U1: NE555
VCC: voltage; 3.8V
Named nets: 0, VCC, VPwrOn, VTrig, VCollector, VThreshold, VBase, VOut
.tran 0 4s 0 10ms startup
Auto-on circuit for PWR_ON pin of a u-blox cellular module, used, for instance, to power-on LARA-R6 when there is no GPIO output available to toggle PWR_ON.
 
Connect VCC to the 3.8V VCC supply of the module (usually J103 pins 7 to 10 on an EVK, ground usually being the same pins on J104) and VPwrOn to PWR_ON (usually J104 pin 30 on an EVK).
Delay from VCC-on is set with R3/C4; use 47k/10uF for a 0.5 second delay.
Duration of PWR_ON pulse is set with R2/C1; by experiment use 82k for ~300 ms (SARA-R4/LARA-R6), 270k for ~2 seconds (SARA-R5), both with 10uF.
 
Any old bipolar NPN transistor will do but the 555 timer must be a version that will operate from 3V (e.g. TI's TLC555IP).
Operation in words:
 
The 555 timer is wired as a monostable.  When VCC is appled, Q1 turns on, VTrig goes low and hence the 555 is triggered; VOut goes high for the duration governed by R3/C4:
this is the "delay" part.  Very quickly, as C3 charges, Q1 turns off and so C1, and hence VTrig, is pulled up to VCC.  This doesn't affect anything, the monostable continues to run,
VOut is still high.  Eventually (after about 500 ms with the values above) the monostable ends, VOut goes low, our PWR_ON pulse has begun.
 
C1 is still slowly charging up, VTrig is dropping; this is the "duration" part. Eventually VTrig gets down to its trigger threshold, causing VOut to go high once more but, since the
555 is wired as a monostable, VOut just stays there forever; our PWR_ON pulse has ended.
 
Q2/Q3 take VOut and present a non-inverted open[ish]-collector drive at VPwrOn.
 
Note that since R2/C1 is just an R/C circuit charging up from VCC, dropping VTrig down to its fixed threshold value, and not a comparator-based timer like R3/C4 in combination
with the 555 chip, the R2/C1 values would need to be different to achieve the same "duration" if something higher than the module VCC of 3.8V were used as input [in which case
leave out R6] or a different version of the 555 timer chip, with different Vtrig, were employed; it is worth double-checking the values of R2/C1 by experiment before committing.
 
To see all of the above, run the simulation and examine the voltages at the labels.
This is here
just so that
the simulation
works; it is
not a real
component.
