traibertr/LTEWatch/(list of files, drawings)

Other design files:
2_Hardware/1_Altium/LTEWatch/LTEW_nRF9160.SchDoc
2_Hardware/1_Altium/LTEWatch/LTEW_Power_Supply.SchDoc
2_Hardware/1_Altium/LTEWatch/LTEW_Radio_Freq.SchDoc
2_Hardware/1_Altium/LTEWatch/LTEW_User_Interface.SchDoc
2_Hardware/1_Altium/LTEWatch/LTEW_WPC_RCVR.SchDoc
2_Hardware/1_Altium/LTEWatch/LTEWatch.PrjPcb
2_Hardware/1_Altium/LTEWatch/LTEWatch.SchDoc
2_Hardware/1_Altium/LTEWatch/pca100901/pca10090.SCHLIB
2_Hardware/1_Altium/LTEWatch/template/GregTrack_BIG_LTE_v1_0.SchDoc
2_Hardware/1_Altium/LTEWatch/template/GregTrack_BIG_POW_v1_0.SchDoc
2_Hardware/1_Altium/LTEWatch/template/GregTrack_BIG_SENS_v1_0.SchDoc
2_Hardware/1_Altium/LTEWatch/template/LegacyLocalTemplates/A0.PCBDOC
2_Hardware/1_Altium/LTEWatch/template/LegacyLocalTemplates/A1.PCBDOC
2_Hardware/1_Altium/LTEWatch/template/LegacyLocalTemplates/A2.PCBDOC
2_Hardware/1_Altium/LTEWatch/template/LegacyLocalTemplates/A3.PCBDOC
2_Hardware/1_Altium/LTEWatch/template/LegacyLocalTemplates/A4.PCBDOC
2_Hardware/1_Altium/LTEWatch/template/LegacyLocalTemplates/A.PCBDOC
2_Hardware/1_Altium/LTEWatch/template/LegacyLocalTemplates/B.PCBDOC
2_Hardware/1_Altium/LTEWatch/template/LegacyLocalTemplates/C.PCBDOC
2_Hardware/1_Altium/LTEWatch/template/LegacyLocalTemplates/D.PCBDOC
2_Hardware/1_Altium/LTEWatch/template/LegacyLocalTemplates/E.PCBDOC
2_Hardware/1_Altium/LTEWatch/template/LegacyLocalTemplates/Legal.PCBDOC
2_Hardware/1_Altium/LTEWatch/template/LegacyLocalTemplates/Letter.PCBDOC
2_Hardware/1_Altium/LTEWatch/template/LegacyLocalTemplates/Schematic Title Blocks.SchLib
2_Hardware/1_Altium/LTEWatch/template/LegacyLocalTemplates/Tabloid.PCBDOC
2_Hardware/1_Altium/LTEWatch/template/LegacyLocalTemplates/Title Block.PCBDOC
