traibertr/LTEWatch/3_Software/ubxlib/common/short_range/api/u_short_range.h

/*
 * Copyright 2019-2022 u-blox
 *
 * Licensed under the Apache License, Version 2.0 (the "License");
 * you may not use this file except in compliance with the License.
 * You may obtain a copy of the License at
 *
 * http://www.apache.org/licenses/LICENSE-2.0
 *
 * Unless required by applicable law or agreed to in writing, software
 * distributed under the License is distributed on an "AS IS" BASIS,
 * WITHOUT WARRANTIES OR CONDITIONS OF ANY KIND, either express or implied.
 * See the License for the specific language governing permissions and
 * limitations under the License.
 */

#ifndef _U_SHORT_RANGE_H_
#define _U_SHORT_RANGE_H_

/* Only header files representing a direct and unavoidable
 * dependency between the API of this module and the API
 * of another module should be included here; otherwise
 * please keep #includes to your .c files. */

#include "u_device.h"
#include "u_at_client.h"
#include "u_short_range_module_type.h"

/** \addtogroup _short-range __Short Range
 *  @{
 */

/** @file
 * @brief This header file defines the ShortRange APIs. These APIs are not
 * intended to be called directly, they are called only via the ble/wifi
 * APIs. The ShortRange APIs are NOT generally thread-safe: the ble/wifi
 * APIs add thread safety by calling uShortRangeLock()/uShortRangeUnlock()
 * where appropriate.
 */

#ifdef __cplusplus
extern "C" {
#endif

/* ----------------------------------------------------------------
 * COMPILE-TIME MACROS
 * -------------------------------------------------------------- */

#ifndef U_SHORT_RANGE_AT_BUFFER_LENGTH_BYTES
/** The buffer length required in the AT client by the ShortRange driver.
 */
# define U_SHORT_RANGE_AT_BUFFER_LENGTH_BYTES 4000
#endif

#ifndef U_SHORT_RANGE_UART_BUFFER_LENGTH_BYTES
/** UART buffer length. UART characters are placed in this buffer
 * on arrival. EDM parser then consumes from this buffer.
 */
# define U_SHORT_RANGE_UART_BUFFER_LENGTH_BYTES 1024
#endif

#ifndef U_SHORT_RANGE_UART_BAUD_RATE
/** The default baud rate to communicate with short range module.
 */
# define U_SHORT_RANGE_UART_BAUD_RATE 115200
#endif


/** Bluetooth address length.
 */
#define U_SHORT_RANGE_BT_ADDRESS_LENGTH   6

/** IPv4 address length.
 */
#define U_SHORT_RANGE_IPv4_ADDRESS_LENGTH 4

/** IPv6 address length.
 */
#define U_SHORT_RANGE_IPv6_ADDRESS_LENGTH 16

/** Module/Device serial number length.
 */
#define U_SHORT_RANGE_SERIAL_NUMBER_LENGTH 20

/* ----------------------------------------------------------------
 * TYPES
 * -------------------------------------------------------------- */

/** Error codes specific to short range.
 */
typedef enum {
    U_SHORT_RANGE_ERROR_FORCE_32_BIT = 0x7FFFFFFF,  /**< Force this enum to be 32 bit as it can be
                                                  used as a size also. */
    U_SHORT_RANGE_ERROR_AT = U_ERROR_SHORT_RANGE_MAX,      /**< -4096 if #U_ERROR_BASE is 0. */
    U_SHORT_RANGE_ERROR_NOT_CONFIGURED = U_ERROR_SHORT_RANGE_MAX - 1, /**< -4097 if #U_ERROR_BASE is 0. */
    U_SHORT_RANGE_ERROR_VALUE_OUT_OF_RANGE = U_ERROR_SHORT_RANGE_MAX - 2, /**< -4098 if #U_ERROR_BASE is 0. */
    U_SHORT_RANGE_ERROR_INVALID_MODE = U_ERROR_SHORT_RANGE_MAX - 3, /**< -4099 if# U_ERROR_BASE is 0. */
    U_SHORT_RANGE_ERROR_NOT_DETECTED = U_ERROR_SHORT_RANGE_MAX - 4, /**< -4100 if #U_ERROR_BASE is 0. */
    U_SHORT_RANGE_ERROR_WRONG_TYPE = U_ERROR_SHORT_RANGE_MAX - 5, /**< -4101 if #U_ERROR_BASE is 0. */
    U_SHORT_RANGE_ERROR_INIT_UART = U_ERROR_SHORT_RANGE_MAX - 6, /**< -4102 if #U_ERROR_BASE is 0. */
    U_SHORT_RANGE_ERROR_INIT_EDM = U_ERROR_SHORT_RANGE_MAX - 7, /**< -4103 if #U_ERROR_BASE is 0. */
    U_SHORT_RANGE_ERROR_INIT_ATCLIENT = U_ERROR_SHORT_RANGE_MAX - 8, /**< -4104 if #U_ERROR_BASE is 0. */
    U_SHORT_RANGE_ERROR_INIT_INTERNAL = U_ERROR_SHORT_RANGE_MAX - 9, /**< -4105 if #U_ERROR_BASE is 0. */
} uShortRangeErrorCode_t;

typedef enum {
    U_SHORT_RANGE_SERVER_DISABLED = 0, /**< Disabled status. */
    U_SHORT_RANGE_SERVER_SPS = 6 /**< SPS server. */
} uShortRangeServerType_t;

typedef enum {
    U_SHORT_RANGE_EVENT_CONNECTED,
    U_SHORT_RANGE_EVENT_DISCONNECTED
} uShortRangeConnectionEventType_t;

typedef enum {
    U_SHORT_RANGE_CONNECTION_TYPE_INVALID = -1,
    U_SHORT_RANGE_CONNECTION_TYPE_BT = 0,
    U_SHORT_RANGE_CONNECTION_TYPE_IP,
    U_SHORT_RANGE_CONNECTION_TYPE_MQTT
} uShortRangeConnectionType_t;

typedef enum {
    U_SHORT_RANGE_IP_PROTOCOL_TCP,
    U_SHORT_RANGE_IP_PROTOCOL_UDP,
    U_SHORT_RANGE_IP_PROTOCOL_MQTT
} uShortRangeIpProtocol_t;

typedef enum {
    U_SHORT_RANGE_BT_PROFILE_SPP,
    U_SHORT_RANGE_BT_PROFILE_DUN,
    U_SHORT_RANGE_BT_PROFILE_SPS
} uShortRangeBtProfile_t;

typedef struct {
    uShortRangeIpProtocol_t protocol;
    uint8_t remoteAddress[U_SHORT_RANGE_IPv4_ADDRESS_LENGTH];
    uint16_t remotePort;
    uint8_t localAddress[U_SHORT_RANGE_IPv4_ADDRESS_LENGTH];
    uint16_t localPort;
} uShortRangeConnectionIpv4_t;

typedef struct {
    uShortRangeIpProtocol_t protocol;
    uint8_t remoteAddress[U_SHORT_RANGE_IPv6_ADDRESS_LENGTH];
    uint16_t remotePort;
    uint8_t localAddress[U_SHORT_RANGE_IPv6_ADDRESS_LENGTH];
    uint16_t localPort;
} uShortRangeConnectionIpv6_t;

typedef enum {
    U_SHORT_RANGE_CONNECTION_IPv4,
    U_SHORT_RANGE_CONNECTION_IPv6
} uShortRangeIpVersion_t;

// Enable anonymous unions inclusion for ARM compiler
#ifdef __arm__
// Stop GCC complaining
#pragma GCC diagnostic push
#pragma GCC diagnostic ignored "-Wunknown-pragmas"
//#pragma anon_unions
#pragma GCC diagnostic pop
#endif

typedef struct {
    uShortRangeIpVersion_t type;
    union {
        uShortRangeConnectionIpv4_t ipv4;
        uShortRangeConnectionIpv6_t ipv6;
    };
} uShortRangeConnectDataIp_t;

typedef struct {
    uShortRangeBtProfile_t profile;
    uint8_t address[U_SHORT_RANGE_BT_ADDRESS_LENGTH];
    uint16_t framesize;
} uShortRangeConnectDataBt_t;

typedef void (*uShortRangeBtConnectionStatusCallback_t)(uDeviceHandle_t devHandle,
                                                        int32_t connHandle,
                                                        uShortRangeConnectionEventType_t eventType,
                                                        uShortRangeConnectDataBt_t *pConnectData,
                                                        void *pCallbackParameter);

typedef void (*uShortRangeIpConnectionStatusCallback_t)(uDeviceHandle_t devHandle,
                                                        int32_t connHandle,
                                                        uShortRangeConnectionEventType_t eventType,
                                                        uShortRangeConnectDataIp_t *pConnectData,
                                                        void *pCallbackParameter);

//lint -esym(754, uShortRangeModuleInfo_t::supportsBtClassic) Suppress not referenced
typedef struct {
    int32_t moduleType;
    const char *pName;
    bool supportsBle;
    bool supportsBtClassic;
    bool supportsWifi;
} uShortRangeModuleInfo_t;

typedef struct {
    int32_t uartPort;
    int32_t baudRate;
    int32_t pinTx;
    int32_t pinRx;
    int32_t pinCts;
    int32_t pinRts;
} uShortRangeUartConfig_t;

/* ----------------------------------------------------------------
 * FUNCTIONS
 * -------------------------------------------------------------- */

/** Initialise the short range driver.  If the driver is already
 * initialised then this function returns immediately.
 *
 * @return zero on success or negative error code on failure.
 */
int32_t uShortRangeInit();

/** Shut-down the short range driver.  All short range instances
 * will be removed internally with calls to uShortRangeRemove().
 */
void uShortRangeDeinit();

/** Locks the short range mutex.
 * MUST be called before any of the below functions are!
 * Will wait for the mutex if already locked.
 *
 * @return zero on success or negative error code on failure.
 */
int32_t uShortRangeLock();

/** Unlocks the short range mutex.
 *
 * @return zero on success or negative error code on failure.
 */
int32_t uShortRangeUnlock();

/** Open UART for a short range module, reboots the module and configures it for EDM stream handling.
 *
 * @param moduleType       the short range module type.
 * @param[in] pUartConfig  the UART configuration to be used.
 *                         if a short range instance has already been added
 *                         for this pUartConfig an error will be returned.
 * @param restart          if true - module is restarted.
 * @param[out] pDevHandle  a pointer to the output handle. Will only be set on success.
 * @return                 zero on success or negative error code on failure.
 */
int32_t uShortRangeOpenUart(uShortRangeModuleType_t moduleType,
                            const uShortRangeUartConfig_t *pUartConfig,
                            bool restart, uDeviceHandle_t *pDevHandle);

/** Closes and disconnects all associated handles, such as UART and EDM, for the short range instance
 *
 * @param devHandle         the short range device handle to close.
 */
void uShortRangeClose(uDeviceHandle_t devHandle);

/** Detect the module connected to the handle. Will attempt to change the mode on
 * the module to communicate with it. No change to UART configuration is done,
 * so even if this fails, as last attempt to recover, it could work to  re-init
 * the UART on a different baud rate. This sould recover that module if another
 * rate than the default one has been used.
 *
 * @param devHandle          the short range device handle.
 * @return                   Module on success, #U_SHORT_RANGE_MODULE_TYPE_INVALID
 *                           on failure.
 */
uShortRangeModuleType_t uShortRangeDetectModule(uDeviceHandle_t devHandle);

/** Sends "AT" to the short range module on which it should repond with "OK"
 * but takes no action. This checks that the module is ready to respond to commands.
 *
 * @param devHandle         the short range device handle.
 * @return                  zero on success or negative error code
 *                          on failure.
 */
int32_t uShortRangeAttention(uDeviceHandle_t devHandle);

/** Set a callback for Bluetooth connection status.
*
 * @param devHandle              the short range device handle.
 * @param[in] pCallback          callback function.
 * @param[in] pCallbackParameter parameter included with the callback.
 * @return                       zero on success or negative error code
 *                               on failure.
 */
int32_t uShortRangeSetBtConnectionStatusCallback(uDeviceHandle_t devHandle,
                                                 uShortRangeBtConnectionStatusCallback_t pCallback,
                                                 void *pCallbackParameter);

/** Set a callback for IP connection status.
 *
 * @param devHandle              the short range device handle.
 * @param[in] pCallback          callback function.
 * @param[in] pCallbackParameter parameter included with the callback.
 * @return                       zero on success or negative error code
 *                               on failure.
 */
int32_t uShortRangeSetIpConnectionStatusCallback(uDeviceHandle_t devHandle,
                                                 uShortRangeIpConnectionStatusCallback_t pCallback,
                                                 void *pCallbackParameter);

/** Set a callback for MQTT connection status.
 *
 * @param devHandle              the short range device handle.
 * @param[in] pCallback          callback function.
 * @param[in] pCallbackParameter parameter included with the callback.
 * @return                       zero on success or negative error code
 *                               on failure.
 */
int32_t uShortRangeSetMqttConnectionStatusCallback(uDeviceHandle_t devHandle,
                                                   uShortRangeIpConnectionStatusCallback_t pCallback,
                                                   void *pCallbackParameter);

/** Get the handle of the AT client used by the given
 * short range instance.
 *
 * @param devHandle              the short range device handle.
 * @param[out] pAtHandle         a place to put the AT client handle.
 * @return                       zero on success else negative error code.
 */
int32_t uShortRangeAtClientHandleGet(uDeviceHandle_t devHandle,
                                     uAtClientHandle_t *pAtHandle);


const uShortRangeModuleInfo_t *uShortRangeGetModuleInfo(int32_t moduleId);

/** Check if a module type supports BLE
 *
 * @param moduleType       the short range module type.
 * @return                 true if moduleType supports BLE, false otherwise.
 */
bool uShortRangeSupportsBle(uShortRangeModuleType_t moduleType);

/** Check if a module type supports WiFi
 *
 * @param moduleType       the short range module type.
 * @return                 true if moduleType supports WiFi, false otherwise.
 */
bool uShortRangeSupportsWifi(uShortRangeModuleType_t moduleType);

/** Get the serial number of the module.
 *
 * @param devHandle          the short range device handle.
 * @param[out] pSerialNumber a pointer to storage of atleast
 *                           #U_SHORT_RANGE_SERIAL_NUMBER_LENGTH bytes
 *                           in which the product serial number will be stored;
 *                           cannot be NULL.
 * @return                   the length of the string copied into
 *                           pSerialNumber (as strlen() would
 *                           return) or negative error code.
 */
int32_t uShortRangeGetSerialNumber(uDeviceHandle_t devHandle, char *pSerialNumber);

/** Get the edm stream handle corresponding to short range handle.
 *
 * @param devHandle         the short range device handle.
 * @return                  an edm stream handle on success
 *                          else negative error code.
 */
int32_t uShortRangeGetEdmStreamHandle(uDeviceHandle_t devHandle);

/** Get the UART handle corresponding to short range handle.
 *
 * @param devHandle         the short range device handle.
 * @return                  an UART handle on success
 *                          else negative error code.
 */
int32_t uShortRangeGetUartHandle(uDeviceHandle_t devHandle);

/** Sets new UART baudrate for a short range module.
 *
 * VERY IMPORTANT: this function internally calls uShortRangeClose()
 * and then uShortRangeOpenUart(), which will result in any callbacks
 * that have been configured with uShortRangeSetIpConnectionStatusCallback(),
 * uShortRangeSetIpConnectionStatusCallback() or
 * uShortRangeSetMqttConnectionStatusCallback() being forgotten and
 * any handles returned by uShortRangeAtClientHandleGet() and
 * uShortRangeGetUartHandle() becoming invalid.
 * Since uShortRangeClose()/uShortRangeOpenUart() also open and close
 * the EDM stream, any settings there, including the EDM stream handle,
 * will also be re-created.
 *
 * @param[in,out] pDevHandle  a pointer to a short range device handle that has been
 *                            opened with uShortRangeOpenUart(). If the reconfiguration
 *                            of the UART settings succeeds a new device handle will
 *                            be allocated and returned via this parameter.
 * @param[in] pUartConfig     the new UART configuration to be used.
 * @return                    0 on success or negative error code on failure.
 */
int32_t uShortRangeSetBaudrate(uDeviceHandle_t *pDevHandle,
                               const uShortRangeUartConfig_t *pUartConfig);

/** Configure a GPIO of a shortrange module.
 *
 * @param devHandle         the handle of the shortrange device handle.
 * @param gpioId            the GPIO ID to configure (often the same as pin number).
 * @param isOutput          the direction, set to true for an output, false for
 *                          an input.
 * @param level             the initial level to set, only used if isOutput
 *                          is true; 0 for low or non-zero for high.
 * @return                  zero on success else negative error code.
 */
int32_t uShortRangeGpioConfig(uDeviceHandle_t devHandle, int32_t gpioId, bool isOutput,
                              int32_t level);

/** Set the state of a GPIO of a shortrange module.
 *
 * @param devHandle         the handle of the shortrange device handle.
 * @param gpioId            the GPIO ID to set (often the same as pin number).
 * @param level             the level to set, 0 for low or non-zero for high.
 * @return                  zero on success else negative error code.
 */
int32_t uShortRangeGpioSet(uDeviceHandle_t devHandle, int32_t gpioId, int32_t level);

/** Resets the module settings to default values of a shortrange module.
 *
 * @param pinResetToDefaults the pin of this MCU that MUST BE CONNECTED TO
 *                           the DSR pin of the module.
 * @return                   zero on success else negative error code.
 */
int32_t uShortRangeResetToDefaultSettings(int32_t pinResetToDefaults);

#ifdef __cplusplus
}
#endif

/** @}*/

#endif // _U_SHORT_RANGE_H_

// End of file
