traibertr/LTEWatch/(commit log)

2023-02-21 Add Altium Project PCB and Schematic
    [A.PCBDOC, A0.PCBDOC, A1.PCBDOC, A2.PCBDOC, A3.PCBDOC, A4.PCBDOC, B.PCBDOC, BOM Template Dual Supplier.xlsx]
2023-02-21 Prototype
    Project files relative to prototype design process
    [part_selection.xlsx]
