traibertr/LTEWatch/(notices)

Notices in the files:
3_Software/LTEWatch_App/src/app/picowatch.h:
Copyright (C) Hes-so, MSE Lausanne, Colaboration with Hes-so VALAIS/WALLIS, HEI Sion, Infotronics. 2023
All rights reserved.
